NicolaiFransen/SemesterProjectPED2/Report/Pictures/SystemTest/Setup/TestSetup_v1.jpeg

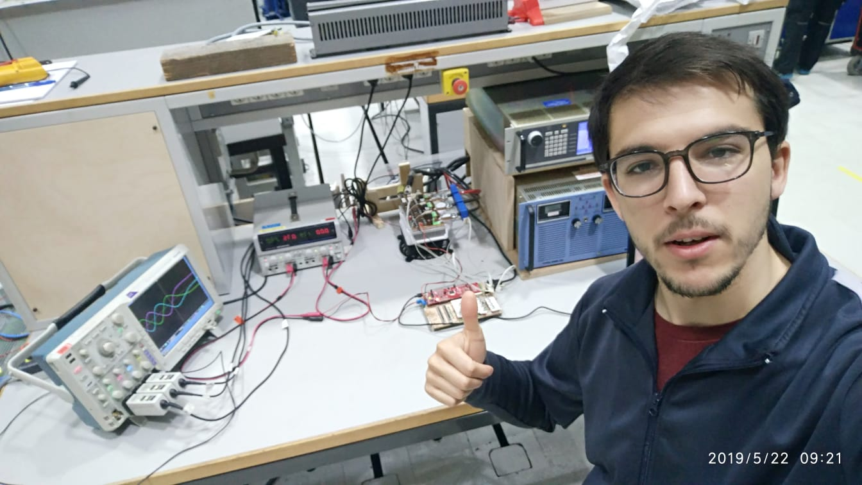
Report/Pictures/SystemTest/Setup/TestSetup_v1.jpeg
