NicolaiFransen/SemesterProjectPED2/Report/Pictures/Discussion/MOSFET damage/MOSFET_damage_currents_v2.png

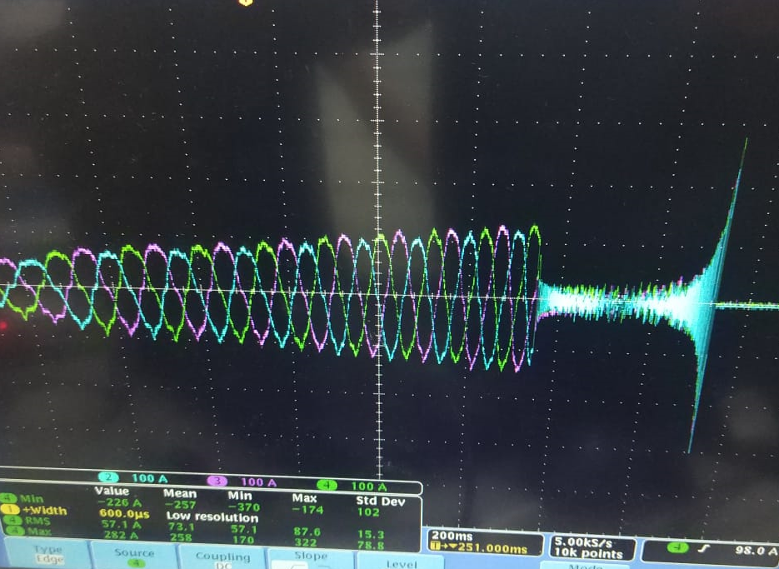
Report/Pictures/Discussion/MOSFET damage/MOSFET_damage_currents_v2.png
