NicolaiFransen/SemesterProjectPED2/Report/2019_02_09_TableOfContentsDraft.docx

Nomenclature

List of figures

List of tables

1. Introduction
2. Problem analysis
  2.1 Electric drive system (Add relevant parameters)
    2.1.1 Induction machine
    2.1.2 Inverter
    2.1.3 Batteries (Regenerative braking)
  2.2 Problem statement
  2.3 Objectives
  2.4 System requirements
3. Model of the induction machine
  3.1 Selection of reference frame
  3.2 Induction machine equations
    3.2.1 Motor equations
    3.2.2 Generator equations (for implementation of regenerative braking)
    3.2.3 Torque equation
  3.3 Validation of machine parameters
    3.3.1 Simulink model
    3.3.2 Simulation results
4. Control of the induction machine
  4.1 Control strategies
    4.1.1 Scalar control
    4.1.2 FOC
    4.1.3 …
  4.2 Selection of control strategy (advantages /disadvantages)
  4.3 Implementation of control strategy X (To include subsections later)
  4.4 Verification of controller
    4.4.1 Simulink model
    4.4.2 Simulation results
5. Software implementation (Need Nico feedback!!)
  5.1 Requirements
  5.2 DSP/microcontroller
  5.3 High level design
  5.4 Implementation
    5.4.1 Module 1
    5.4.2 Module 2
    5.4.3 …
  5.5 Validation
6. Test results
  6.1 Test results of existing inverter
    6.1.1 Test with signal generator
    6.1.2 Test with DSP
  6.2 Test results of the batteries’ capacity
  6.3 Test results of the complete system in test bench
  6.4 Integration test in go-kart platform (demo)
7. Regenerative mode (optional)
  7.1 Model of the batteries
  7.2 Current control?
  7.3 Simulation and experimental results
8. Discussion
  8.1 Verification of experimental results
  8.2 Problems and limitations
  8.3 Future work
9. Conclusion

Bibliography

Appendix
