NicolaiFransen/SemesterProjectPED2/Exam/Presentation/Questions_Faheem.pptx

## Parallel MOSFET

VB

1

VA

4

3

5

DC Link

VC

2

6

Drain

Rgate

Driver

Rgate

Source

Slide

of 59

P_(motor) =7300W
Using the motor power factor and efficiency we can calculate total apparent power
S_(motor) = (P_(mtor))/(PF_(motor) ∗ η_(motor))=10915 VA
For a balanced 3-phase system
S_(motor) = √3∗V_(line) ∗I_(line)
For a star connected load
S_(motor) = √3∗V_(line) ∗I_(phase)

Faheem

## Parallel MOSFET

By comparing multiple available MOSFETs from different manufactures of rating 60V and 80V for 300A.

Based on the obtained SPICE model simulation IPT007N06N and IPT012N08N5 are the most suitable MOSFETS. But, due to IPT012N08N5 higher drain-source voltage of 80V, it can ensure a better safety margin that occurs in turn off transition of the MOSFETs.

Slide

of 59

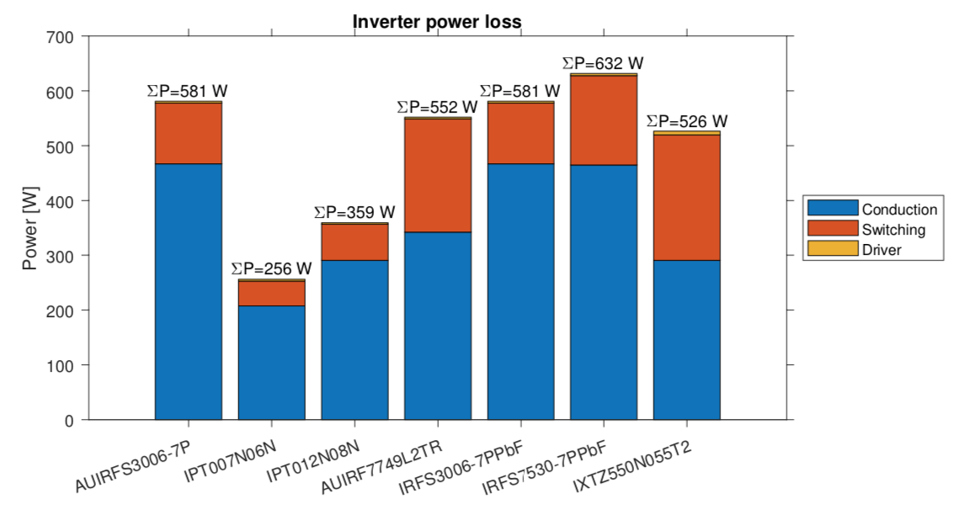
[picture p3: figure]

Faheem

## MOSFET loss calculation

Operating Condition
| Values | Unit
DC link voltage (VDC) | 36 | V
Power Rating | 7.3 | kW
RMS current (IRMS) | 263 | A
Peak current (Ipk) | 371 | A
Switching Frequency (fsw) | 20 | kHz

MOSFET Parameter (IPT012N08N5)
| Values | Unit
DS voltage (VDS) | 80 | V
RDS(on),max | 1.2 | mΩ
Drain current (ID) | 300 | A
Output Capacitance (Qoss) | 208 | nC
Gate Capacitance (QG) | 178 | nC

Slide

of 59

MOSFET loss can be modelled in parts
P_(MOSFET) =P_(con) +P_(sw) +P_(gate) =30.3W
Conduction losses
P_(con) =((I_(rms))/(n_(parallel)))^2 RDS_(on) =24.2W
Switching losses
E_(on) =(V_(DC) ∗(I_(pk))/(n_(parallel))∗t_(on) +Q_(rr) ∗V_(DC) )+(1/4Q_(rr) ∗V_(DC) )
E_(off) =V_(DC) ∗(I_(pk))/(n_(parallel))∗t_(off)
P_(sw) = (E_(on) +E_(off) )∗f_(sw) =5.9W
Gate loss
P_(Qg) = Q_g ∗(V_(dr.on) −V_(dr.off) )
P_(Rg) = P_(Qg)

Faheem
