NicolaiFransen/SemesterProjectPED2/Report/Pictures/LoadMachineGraph.pdf

0 | 50 | 100 | 150 | 200 | 250 | 300 | 350 | 400
Speed (RPM)

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
Torque (Nm)

Vexc

= 50 V

Vexc

= 100 V

Vexc

= 150 V
