NicolaiFransen/SemesterProjectPED2/Software/Design/ClassDiagram.pdf

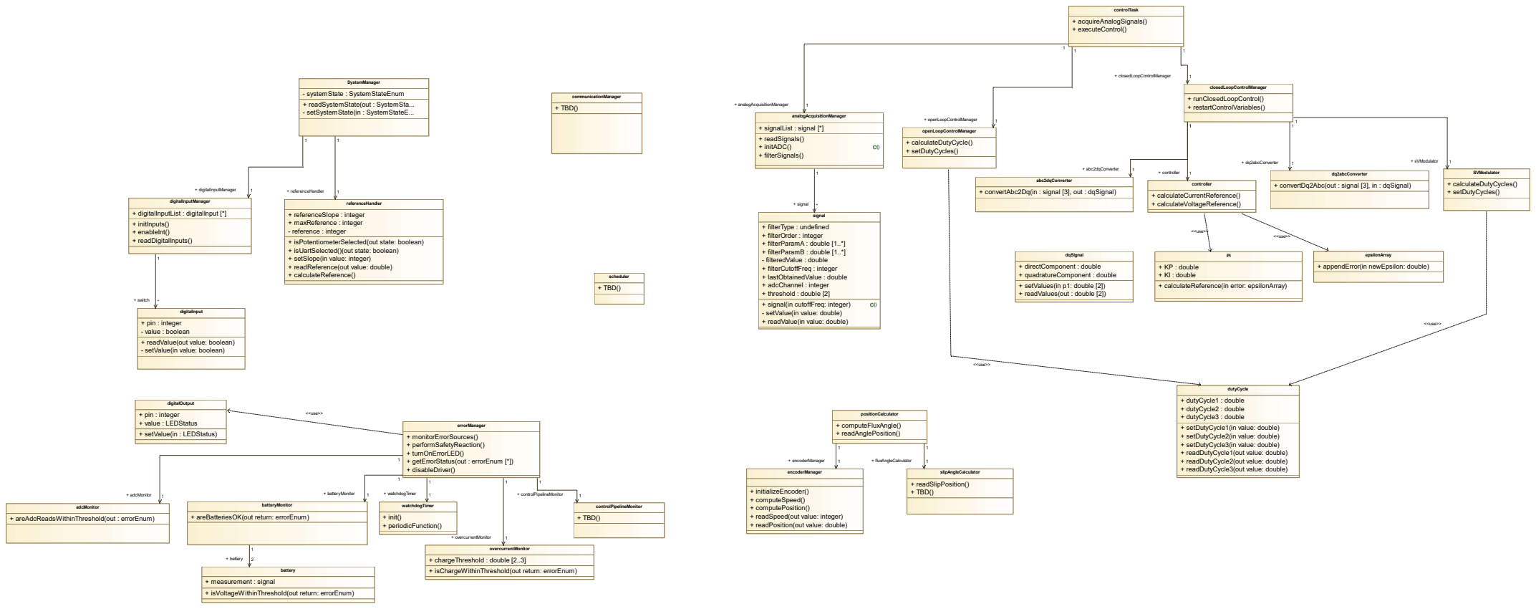
[picture p101: figure]
signal + filterType : undefined + filterOrder : integer + filterParamA : double [1..*] + filterParamB : double [1..*] - filteredValue : double + filterCutoffFreq : integer + lastObtainedValue : double + adcChannel : integer + threshold : double [2] + signal( in cutoffFreq: integer) - setValue( in value: double) + readValue( in value: double); analogAcquisitionManager + signalList : signal [*] + readSignals() + initADC() + filterSignals(); digitalInputManager + digitalInputList : digitalInput [*] + initInputs() + enableInt() + readDigitalInputs()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

+ convertAbc2Dq( in : signal [3], out : dqSignal)

+ convertDq2Abc( out : signal [3], in : dqSignal)
