NicolaiFransen/SemesterProjectPED2/Simulations/2018_Semester Project/Appendix/Thermal_design/Fets.xlsx

Note: |  | Mosfet name: | AUIRFS3006-7P | IPT007N06N | IPT012N08N | AUIRF7749L2TR | IRFS3006-7PPbF | IRFS7530-7PPbF | IXTZ550N055T2
Correct by graph and use max | mOhm | R_DS_ON (100°C) | 2.25 | 1 | 1.4 | 1.65 | 2.25 | 2.24 | 1.4
 | ns | tr | 61 | 18 | 31 | 149 | 61 | 102 | 40
 | ns | tf | 69 | 22 | 30 | 88 | 69 | 79 | 230
 | ns | trr | 48 | 174 | 212 | 42 | 48 | 50 | 100
 | nC | Qg | 300 | 287 | 223 | 275 | 300 | 354 | 595
 | nC | Qrr | 62 | 144 | 636 | 54 | 62 | 83 | 250
 | °C/W | R_thJC | 0.4 | 0.4 | 0.4 | 0.44 | 0.4 | 0.4 | 0.25
 | V | V_plateau | 3.8 | 4.2 | 4.5 | 5 | 3.8 | 5 | 4.5
 | Ohm | R_G | 2.1 | 2.7 | 2.4 | 1.5 | 2.1 | 2.2 | 1.36
 | pF | Crss_RI | 3000 | 4000 | 3000 | 3000 | 3000 | 3000 | 2200
 | pF | Crss_VDC | 700 | 220 | 90 | 600 | 700 | 600 | 1000
 |  | Price | 19.06 | 37.81 | 47.57 | 46.6 | 31.95 | 28.36 | 163.47
 |  | Supplier | Farnell | Farnell | Farnell | Farnell | Mouser | Farnell | Mouser
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
