NicolaiFransen/SemesterProjectPED2/Others/2019_02_08_Picure_aitor_kart.docx

# Electric Go-kart

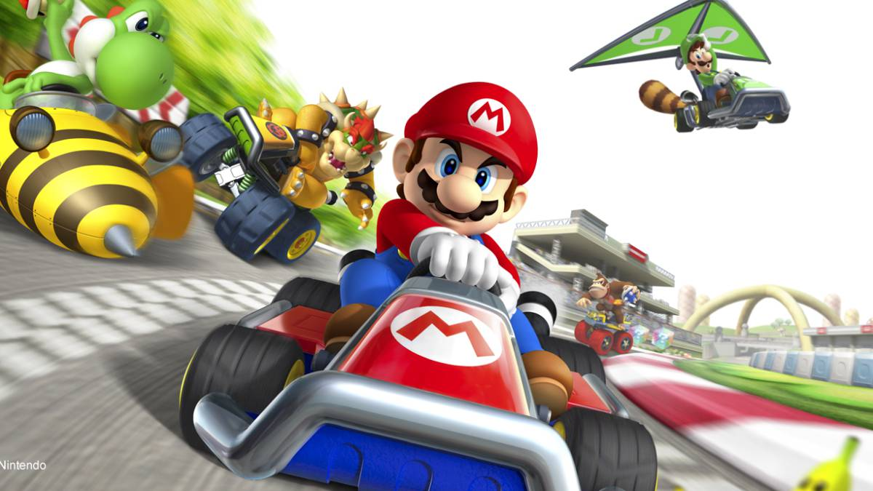
[picture p105: figure]
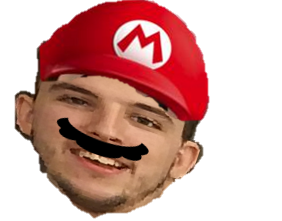
[picture p106: figure]

PED-841

Mihai Rusu

mrusu18@student.aau.dk

Estefanía Ruiz

eruiza18@student.aau.dk

Faheem Ahmad

fahmad18@student.aau.dk

Nicolai Haugaard Fransen

nfrans18@student.aau.dk

Aitor Teran

ateran18@student.aau.dk

Nicolás Murguizur

nmurgu18@student.aau.dk
