NicolaiFransen/SemesterProjectPED2/Software/Design/ADC_overview.pdf

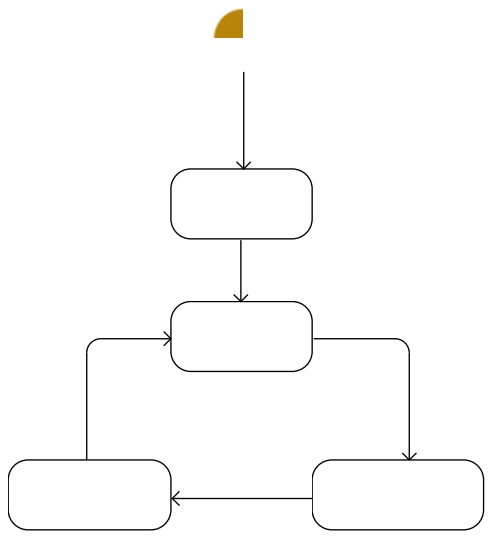
[picture p107: figure]
