NicolaiFransen/SemesterProjectPED2/DeliveryFolder/Simulink/Batteries/good figures/charge_b.jpg

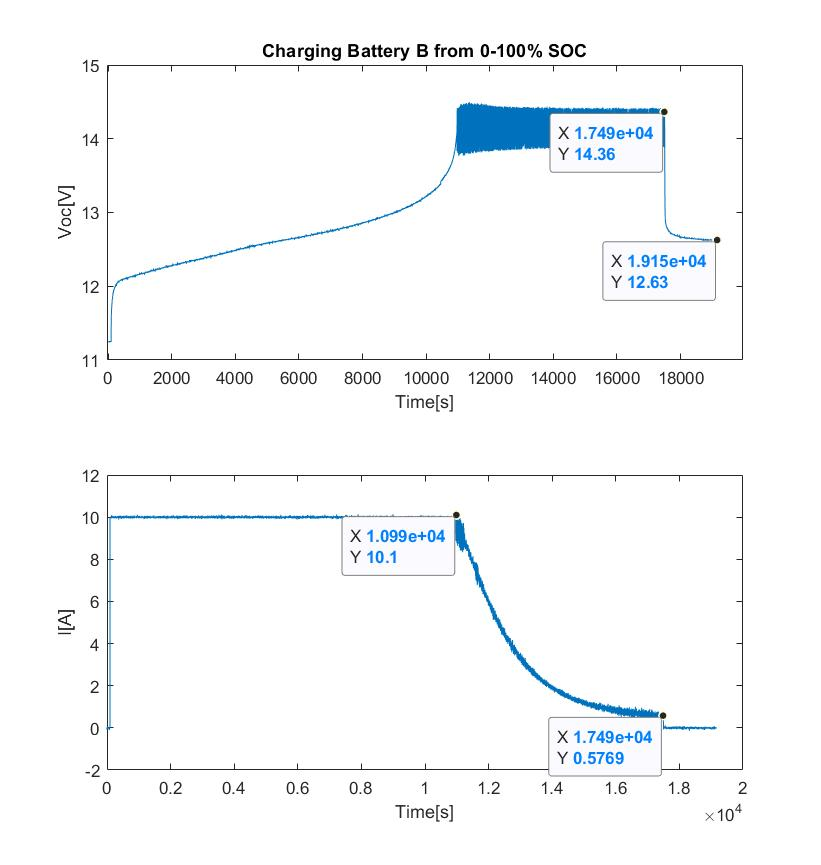
DeliveryFolder/Simulink/Batteries/good figures/charge_b.jpg
