NicolaiFransen/SemesterProjectPED2/DeliveryFolder/Simulink/Batteries/good figures/pulse_d_50.jpg

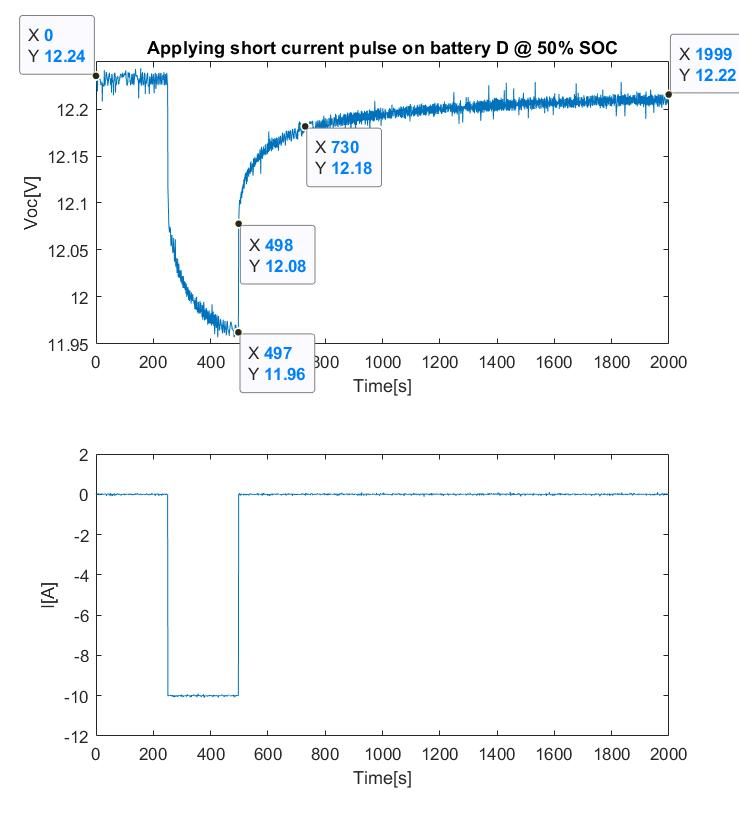
DeliveryFolder/Simulink/Batteries/good figures/pulse_d_50.jpg
