NicolaiFransen/SemesterProjectPED2/DeliveryFolder/Simulink/Batteries/good figures/voc_soc2.jpg

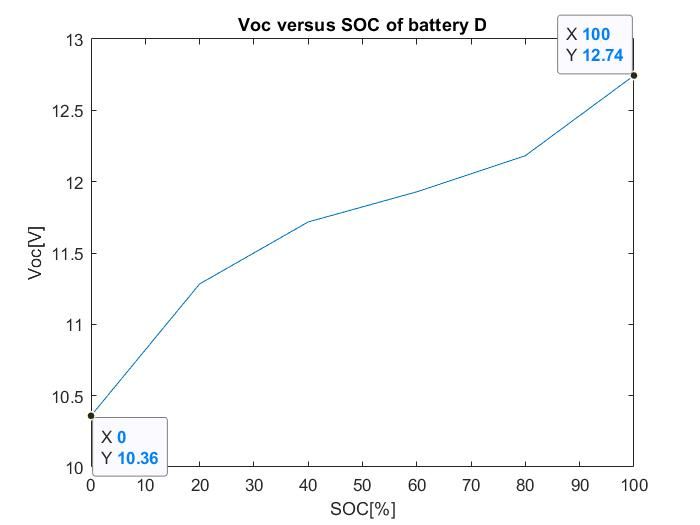
DeliveryFolder/Simulink/Batteries/good figures/voc_soc2.jpg
