NicolaiFransen/SemesterProjectPED2/Documents/Datasheets/Nameplates/Load nameplate1.jpg

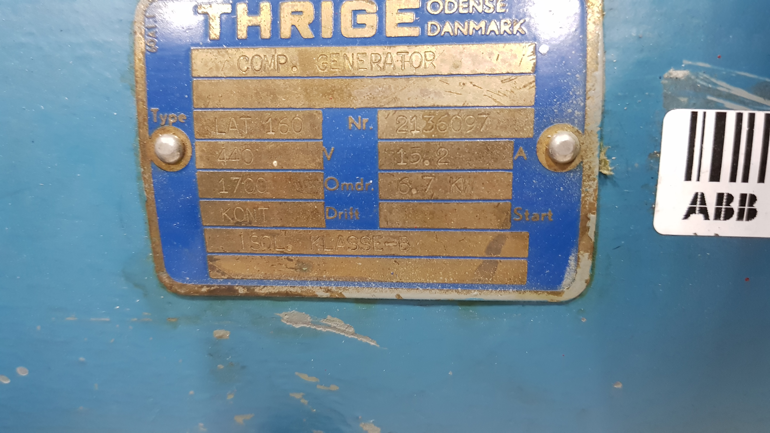
Documents/Datasheets/Nameplates/Load nameplate1.jpg
