NicolaiFransen/SemesterProjectPED2/Exam/Presentation/Pictures/2019-05-24 08.07.56.jpg

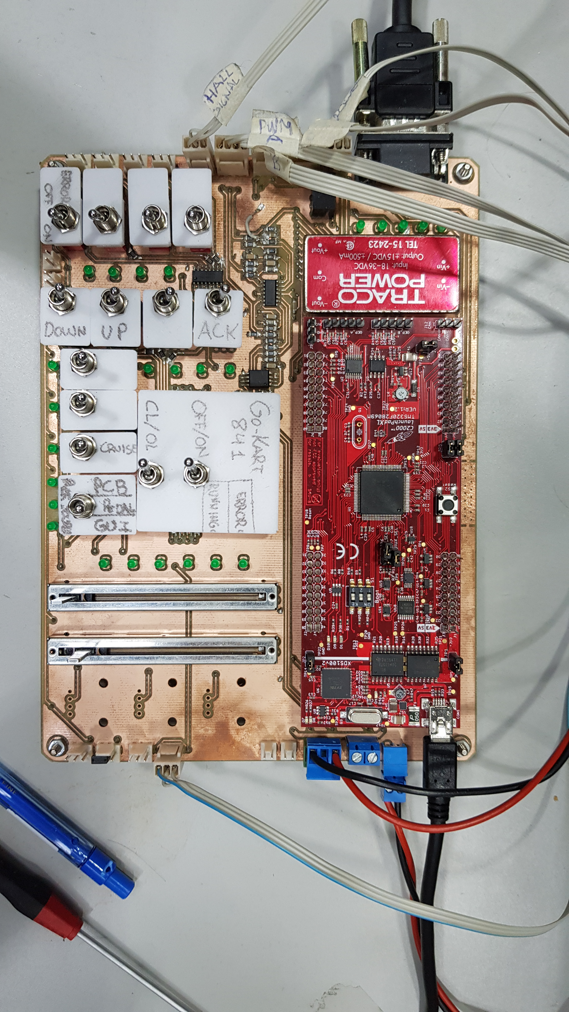
Exam/Presentation/Pictures/2019-05-24 08.07.56.jpg
