NicolaiFransen/SemesterProjectPED2/Exam/Presentation/Pictures/2019-05-24 08.09.47.jpg

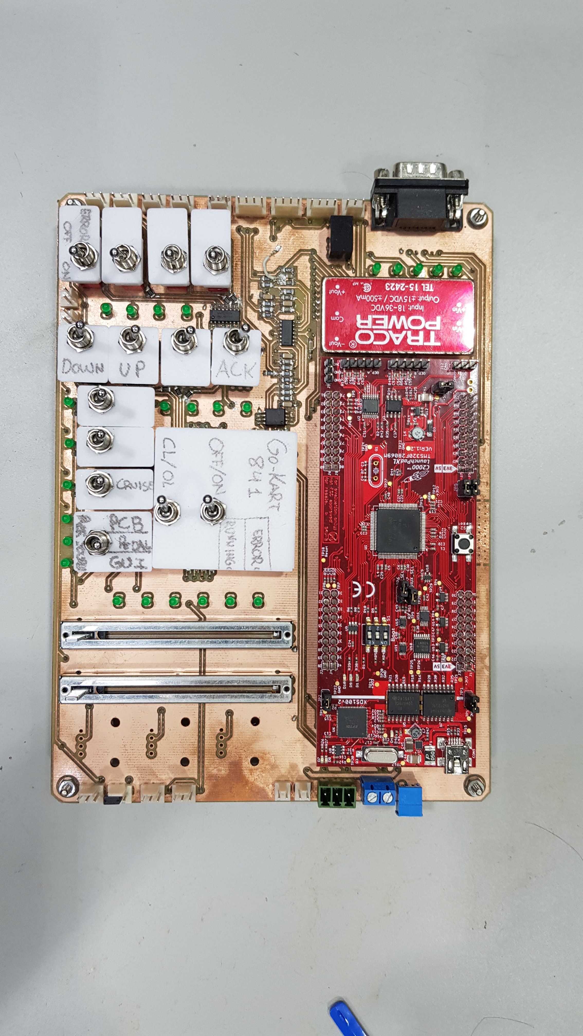
Exam/Presentation/Pictures/2019-05-24 08.09.47.jpg
