NicolaiFransen/SemesterProjectPED2/Exam/Presentation/Pictures/NameTag.jpg

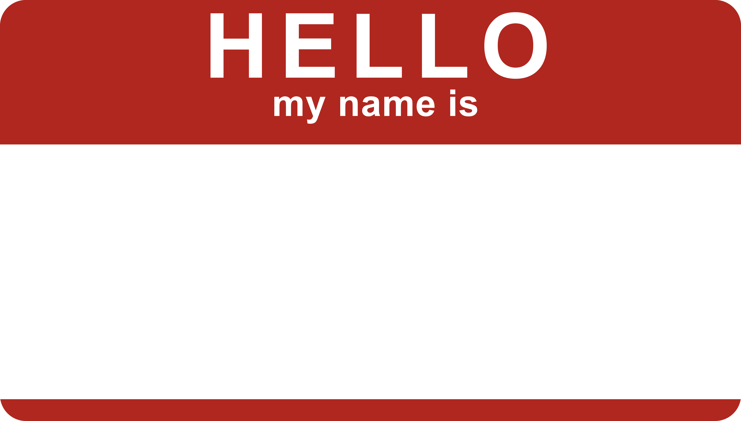
Exam/Presentation/Pictures/NameTag.jpg
