NicolaiFransen/SemesterProjectPED2/Exam/Presentation/Pictures/PowMOS_thrml.png

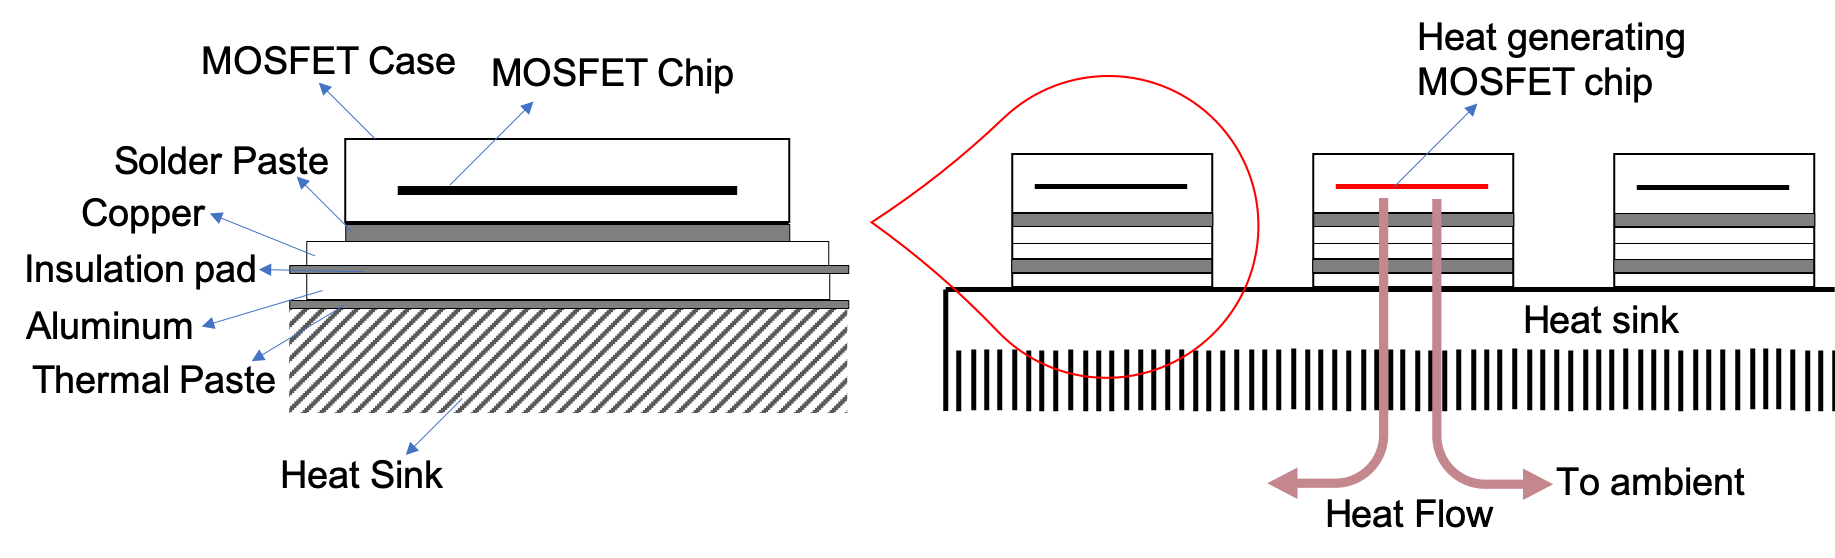
Exam/Presentation/Pictures/PowMOS_thrml.png
