NicolaiFransen/SemesterProjectPED2/Exam/Presentation/Pictures/SpeedLoadChangeTorqueSpeed.PNG

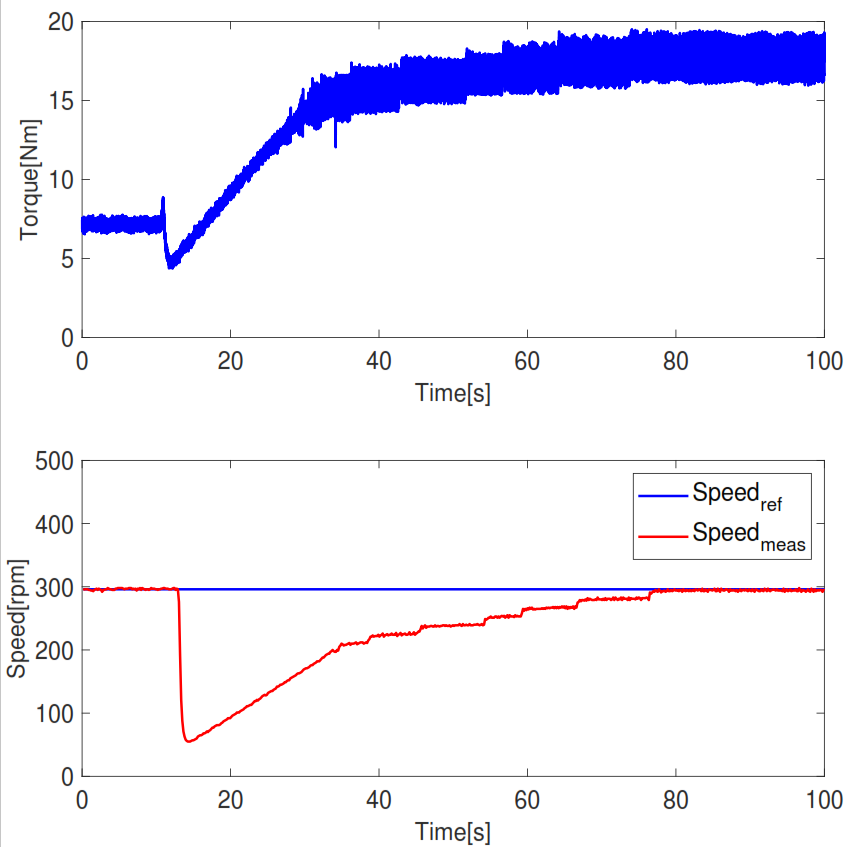
Exam/Presentation/Pictures/SpeedLoadChangeTorqueSpeed.PNG
