NicolaiFransen/SemesterProjectPED2/Exam/Presentation/Pictures/ThermalLossesCircuit.png

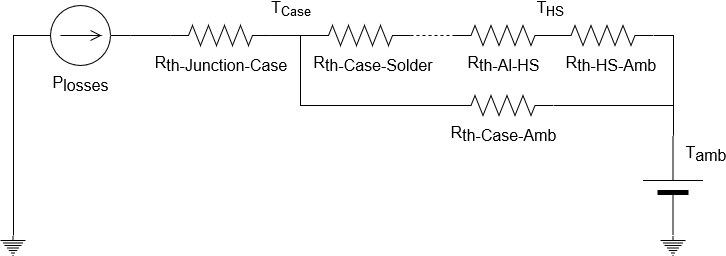
Exam/Presentation/Pictures/ThermalLossesCircuit.png
