NicolaiFransen/SemesterProjectPED2/Exam/Presentation/Pictures/TorqueLoadChangeIabc.PNG

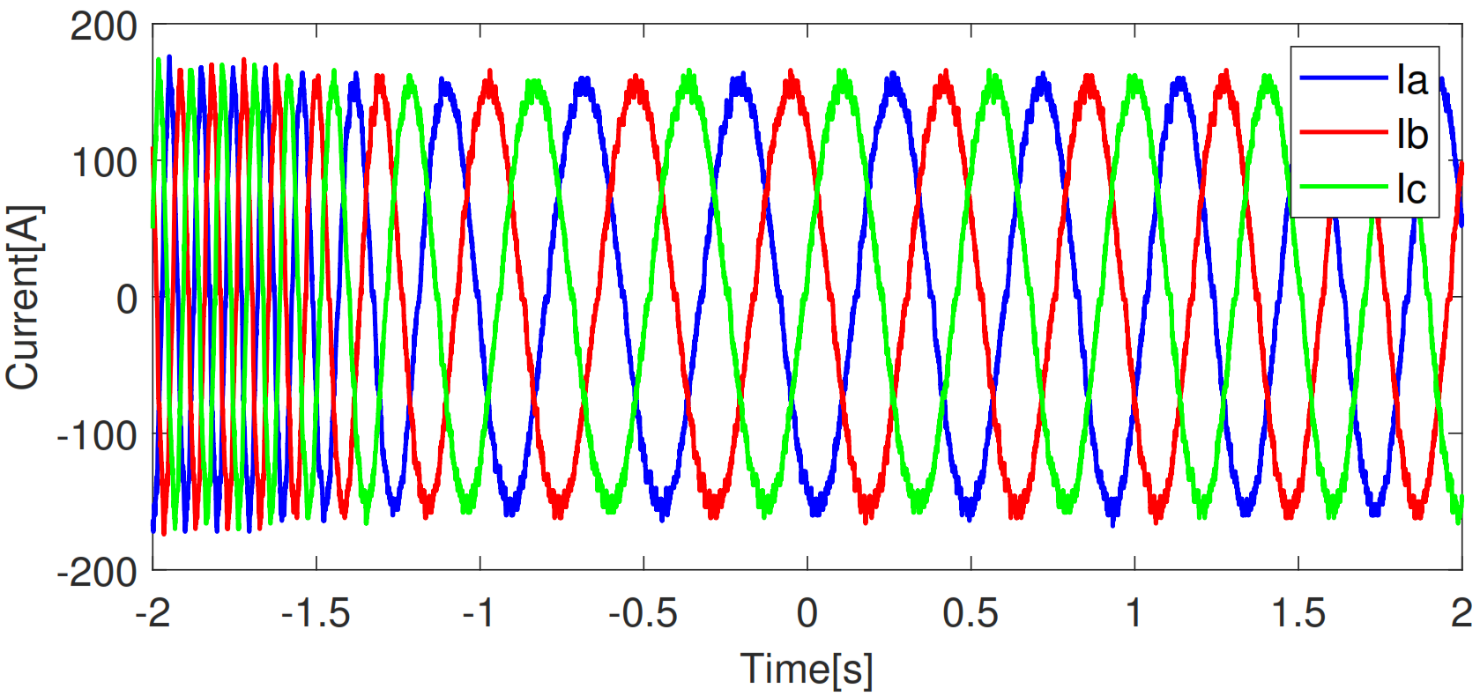
Exam/Presentation/Pictures/TorqueLoadChangeIabc.PNG
