NicolaiFransen/SemesterProjectPED2/Exam/Presentation/Pictures/TorqueStartupIabc.PNG

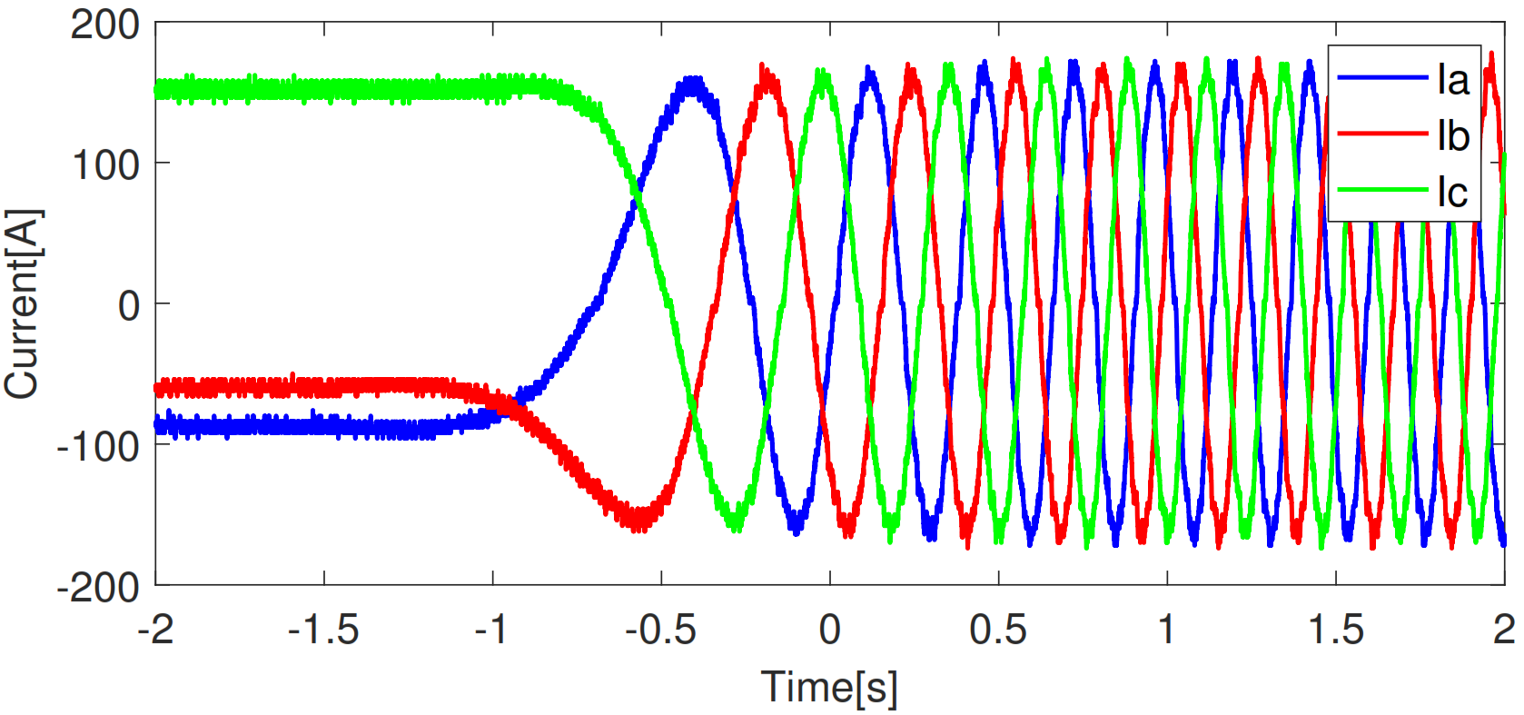
Exam/Presentation/Pictures/TorqueStartupIabc.PNG
