NicolaiFransen/SemesterProjectPED2/Exam/Presentation/Pictures/TorqueStartupIdIq.PNG

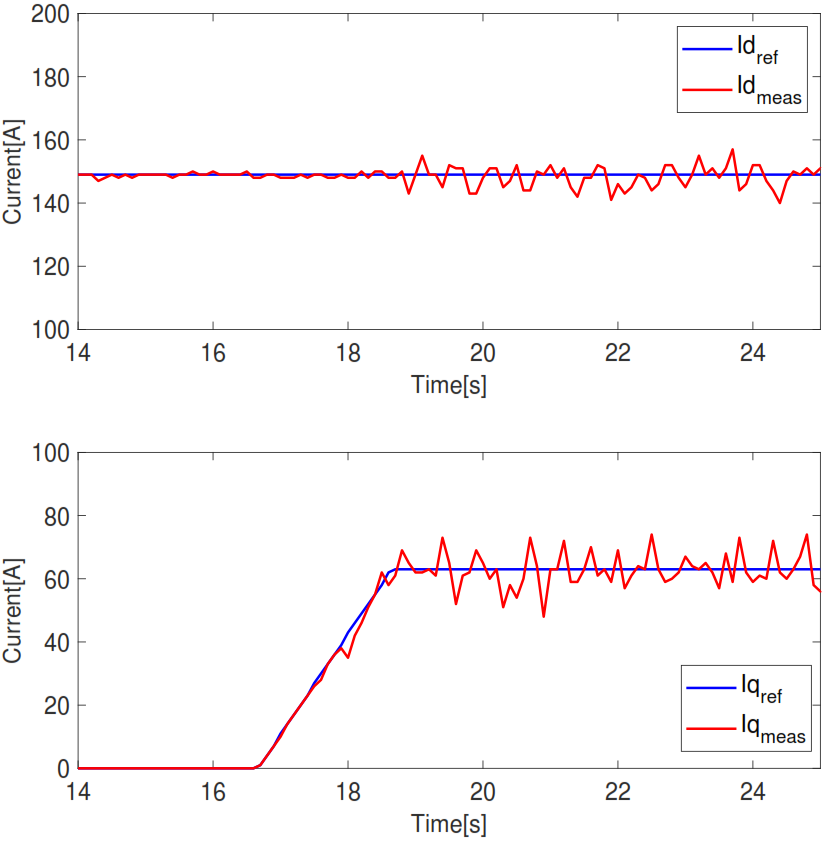
Exam/Presentation/Pictures/TorqueStartupIdIq.PNG
