NicolaiFransen/SemesterProjectPED2/Exam/Presentation/Pictures/TorqueStartupSimulationIabc.PNG

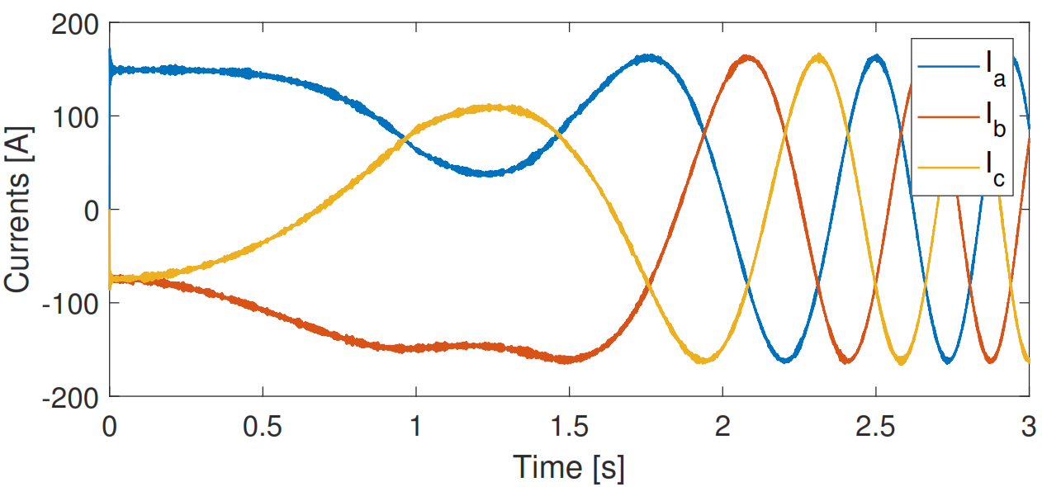
Exam/Presentation/Pictures/TorqueStartupSimulationIabc.PNG
