NicolaiFransen/SemesterProjectPED2/Exam/Presentation/Pictures/TorqueToCruiseIabc.PNG

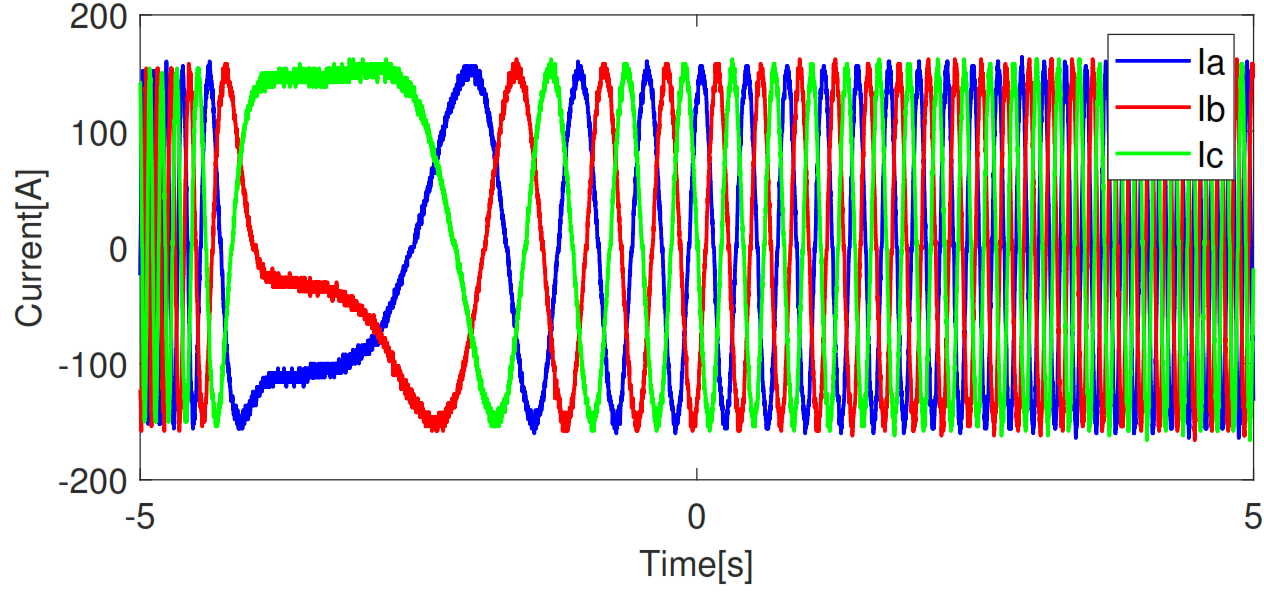
Exam/Presentation/Pictures/TorqueToCruiseIabc.PNG
