NicolaiFransen/SemesterProjectPED2/Exam/Presentation/Pictures/TorqueToCruiseSimulationPNG.PNG

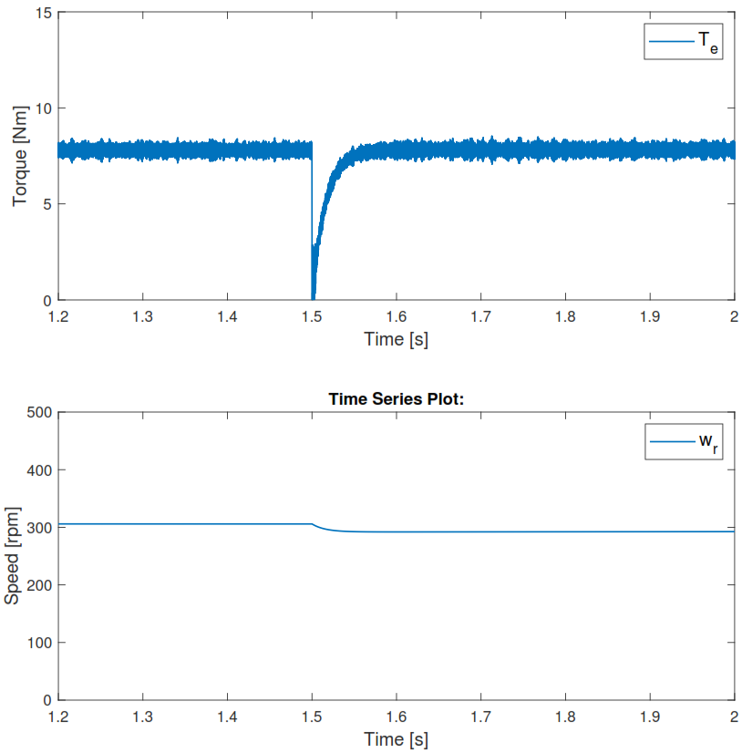
Exam/Presentation/Pictures/TorqueToCruiseSimulationPNG.PNG
