NicolaiFransen/SemesterProjectPED2/Interface board/2019_02_17 Blok diagram.jpg

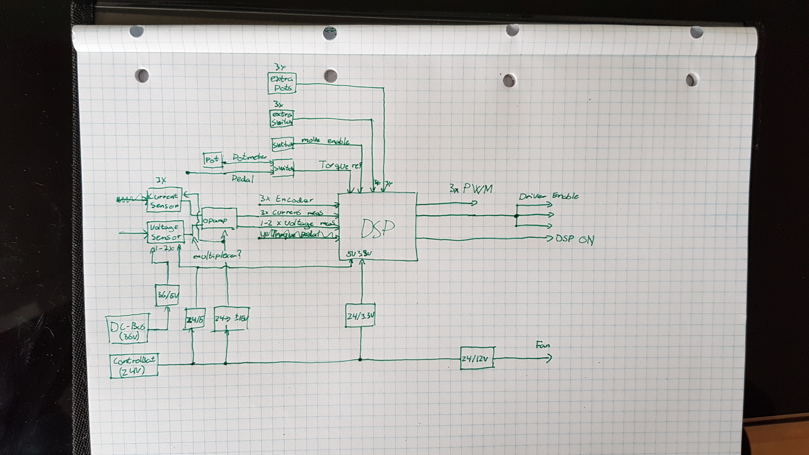
Interface board/2019_02_17 Blok diagram.jpg
