NicolaiFransen/SemesterProjectPED2/Lectures/Optimisation/Optimi exams Martin/Exam 2017/34319168_10155453299611651_4545932126414962688_n.jpg

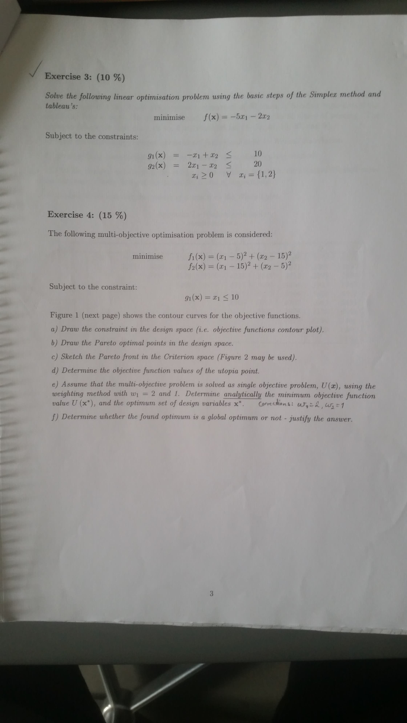
Lectures/Optimisation/Optimi exams Martin/Exam 2017/34319168_10155453299611651_4545932126414962688_n.jpg
