NicolaiFransen/SemesterProjectPED2/Lectures/Optimisation/Optimi exams Martin/Exam 2017/34472471_10155453298431651_939413526361931776_n.jpg

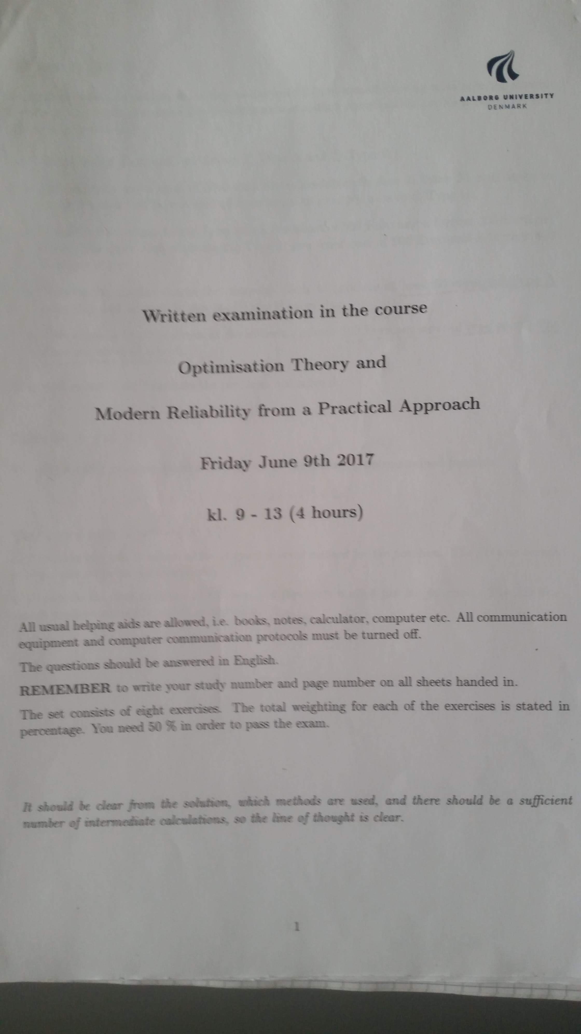
Lectures/Optimisation/Optimi exams Martin/Exam 2017/34472471_10155453298431651_939413526361931776_n.jpg
