NicolaiFransen/SemesterProjectPED2/Lectures/Optimisation/Optimi exams Martin/Lecture pictures/Pictures5/2019-03-11 14.44.27.jpg

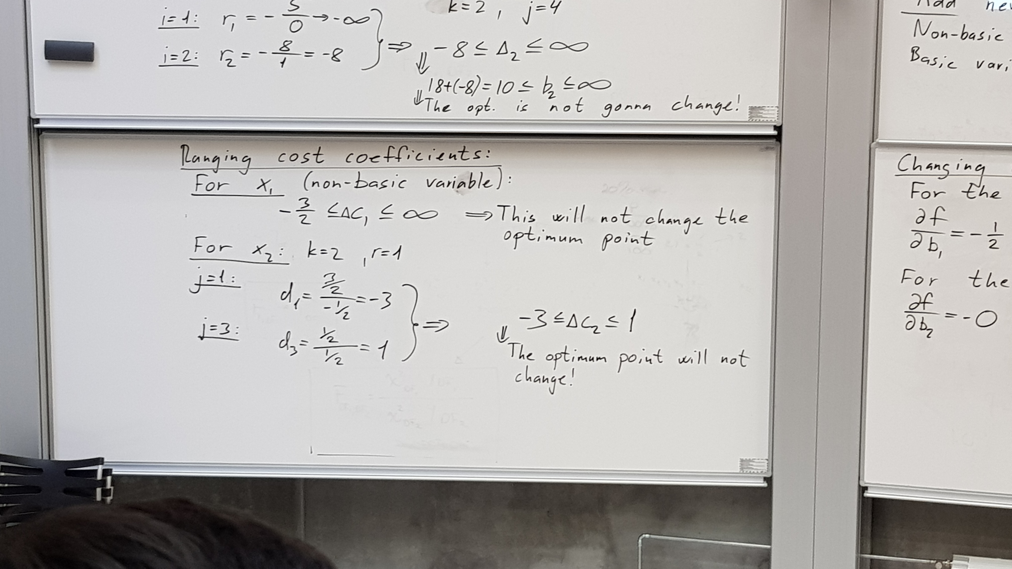
Lectures/Optimisation/Optimi exams Martin/Lecture pictures/Pictures5/2019-03-11 14.44.27.jpg
