NicolaiFransen/SemesterProjectPED2/Lectures/Optimisation/Optimi exams Martin/Lecture pictures/Pictures6/2019-03-18 12.59.12.jpg

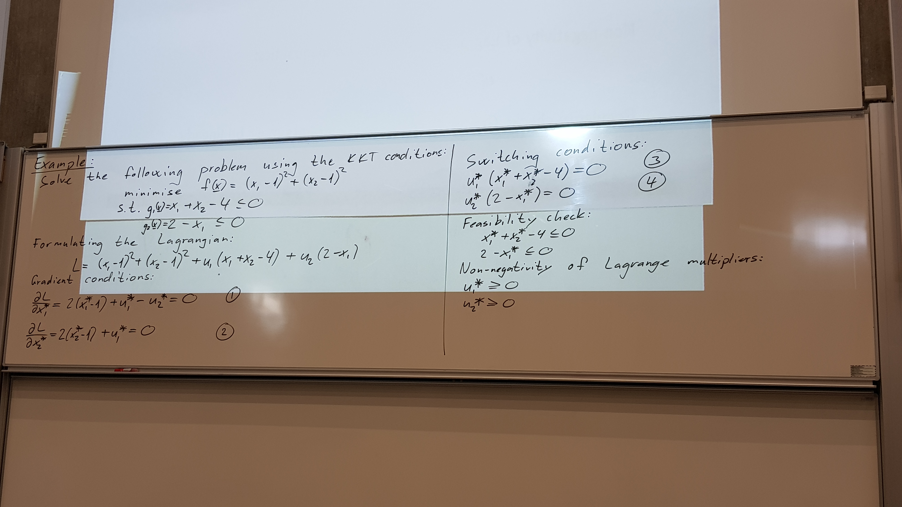
Lectures/Optimisation/Optimi exams Martin/Lecture pictures/Pictures6/2019-03-18 12.59.12.jpg
