NicolaiFransen/SemesterProjectPED2/Lectures/Optimisation/Optimi exams Martin/Lecture pictures/Pictures6/2019-03-18 14.41.18.jpg

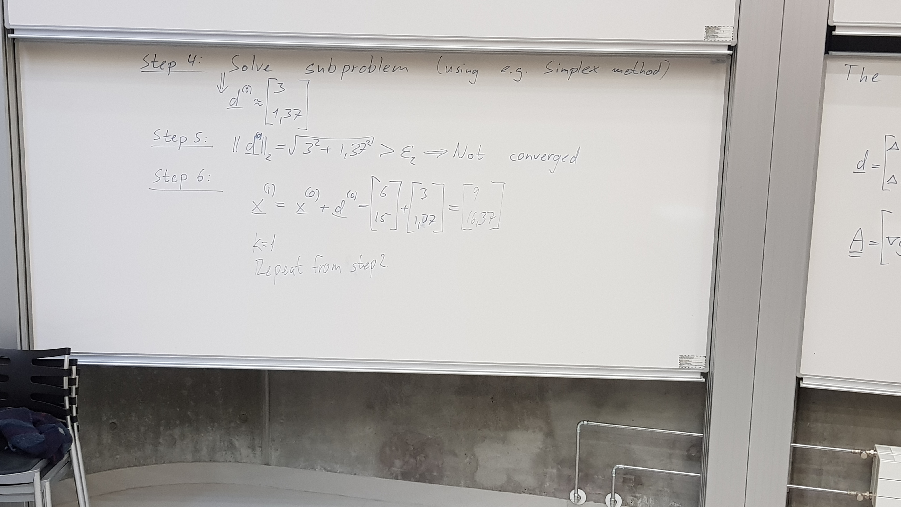
Lectures/Optimisation/Optimi exams Martin/Lecture pictures/Pictures6/2019-03-18 14.41.18.jpg
