NicolaiFransen/SemesterProjectPED2/Lectures/Optimisation/Optimi exams Martin/Lecture pictures/Pictures7/2019-03-25 13.23.08.jpg

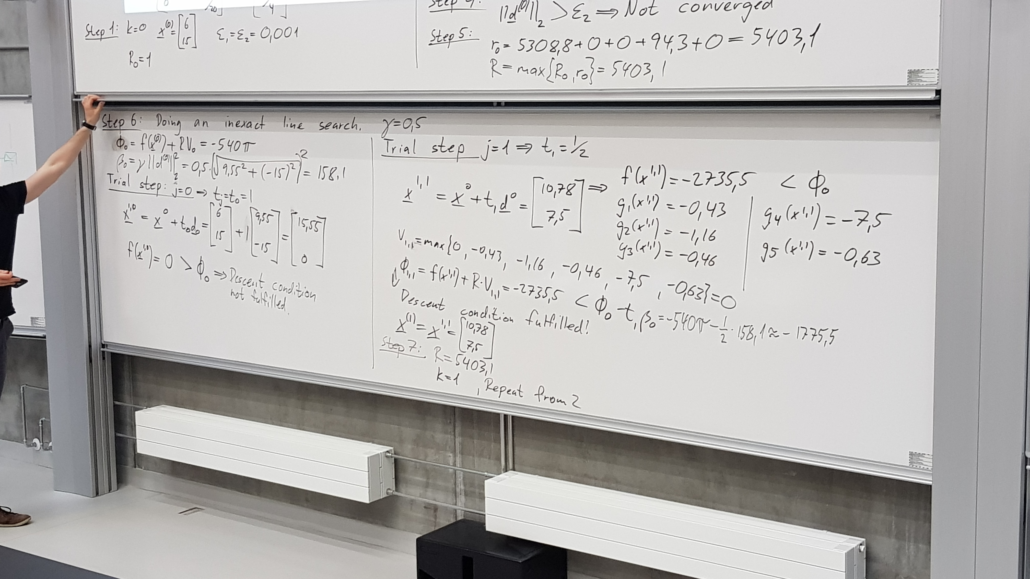
Lectures/Optimisation/Optimi exams Martin/Lecture pictures/Pictures7/2019-03-25 13.23.08.jpg
