NicolaiFransen/SemesterProjectPED2/Lectures/Optimisation/Optimization exams/Exams Marianne/61338909_369452797015577_9039132972241911808_n.jpg

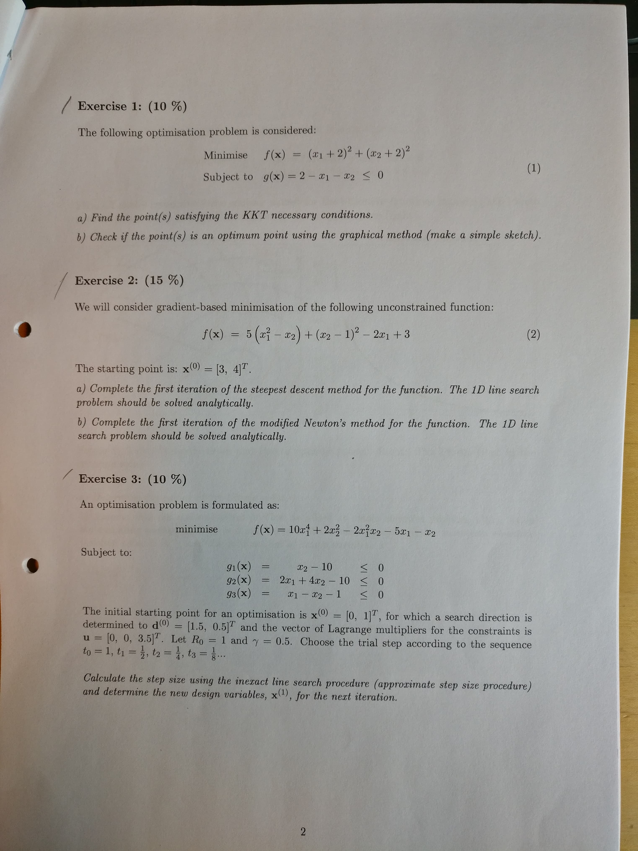
Lectures/Optimisation/Optimization exams/Exams Marianne/61338909_369452797015577_9039132972241911808_n.jpg
