NicolaiFransen/SemesterProjectPED2/Lectures/Optimisation/Optimization exams/Exams Marianne/61511914_449199935837853_9220734673531961344_n.jpg

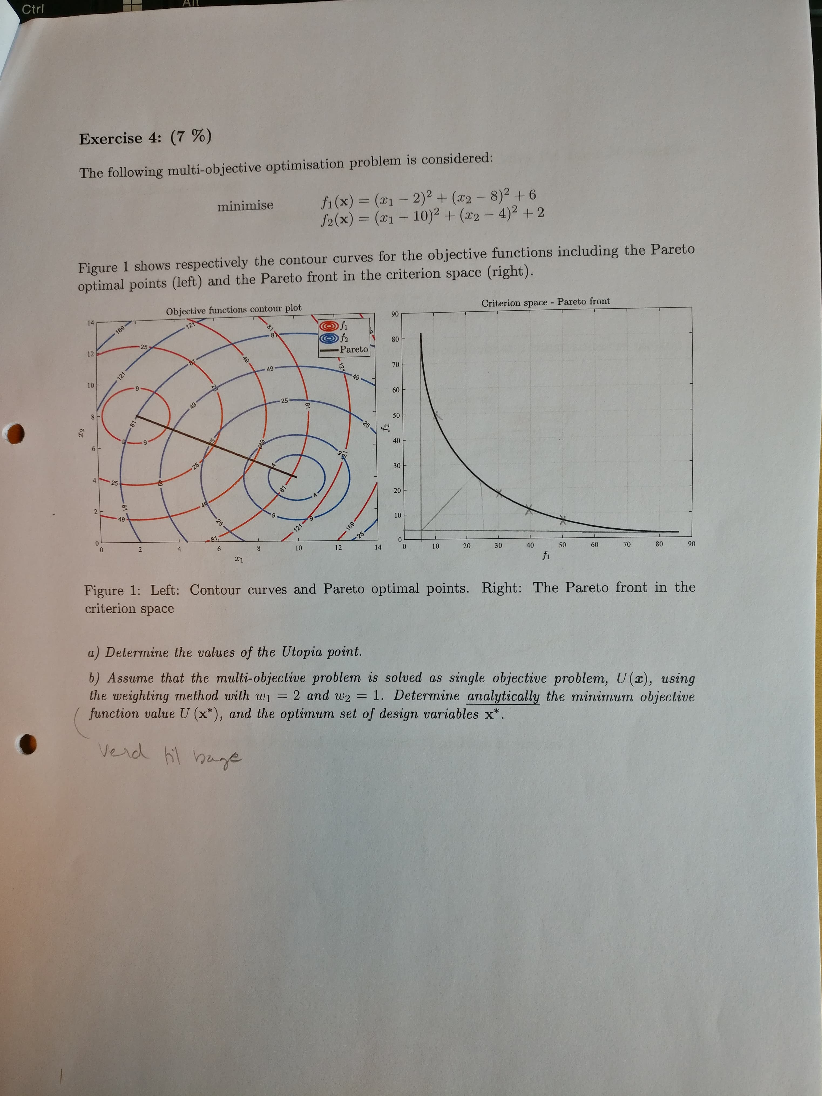
Lectures/Optimisation/Optimization exams/Exams Marianne/61511914_449199935837853_9220734673531961344_n.jpg
