NicolaiFransen/SemesterProjectPED2/Report/Pictures/CompoundMachineDiag.png

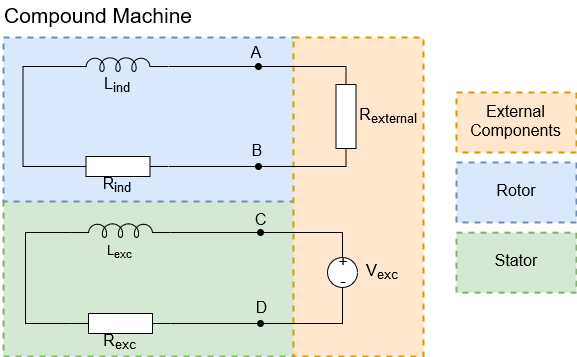
Report/Pictures/CompoundMachineDiag.png
