NicolaiFransen/SemesterProjectPED2/Report/Pictures/Discussion/DriverSpike1.png

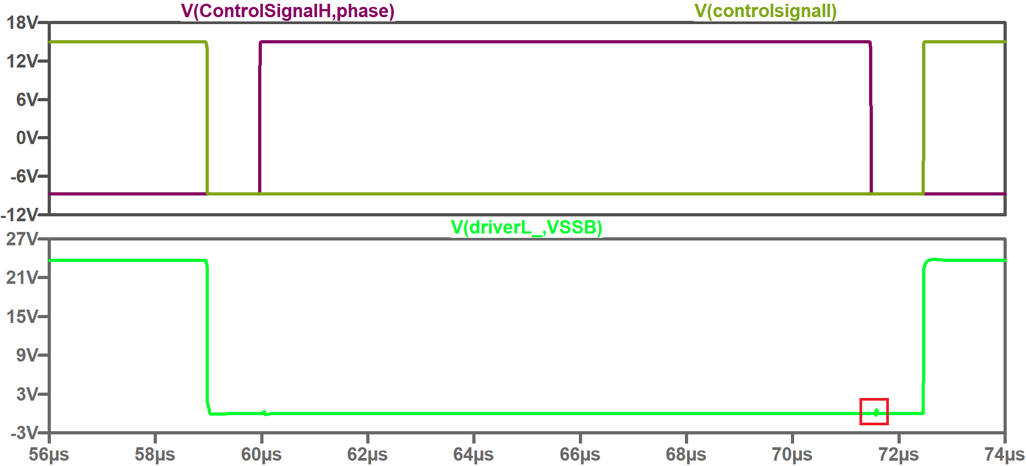
Report/Pictures/Discussion/DriverSpike1.png
