NicolaiFransen/SemesterProjectPED2/Report/Pictures/Discussion/DriverSpike2.png

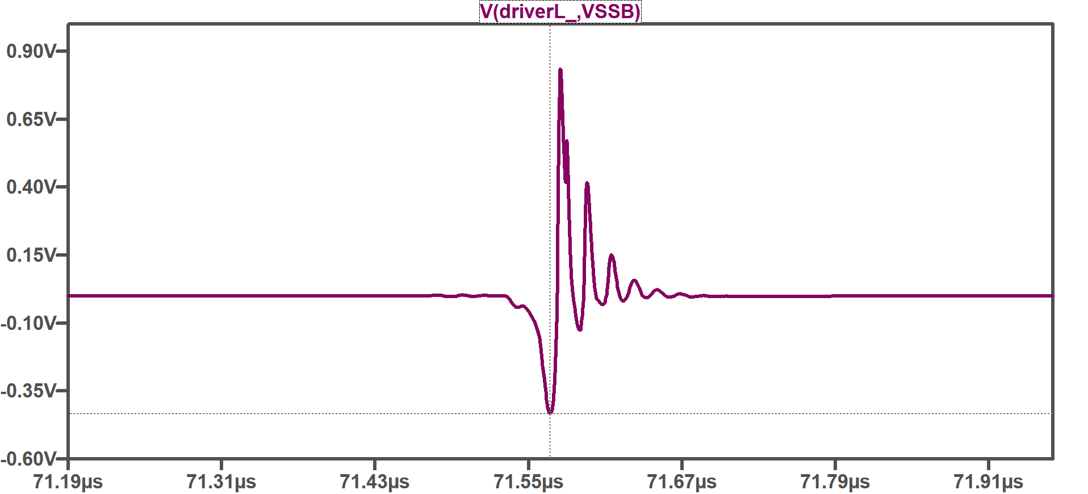
Report/Pictures/Discussion/DriverSpike2.png
