NicolaiFransen/SemesterProjectPED2/Report/Pictures/Discussion/DriverSpike3.png

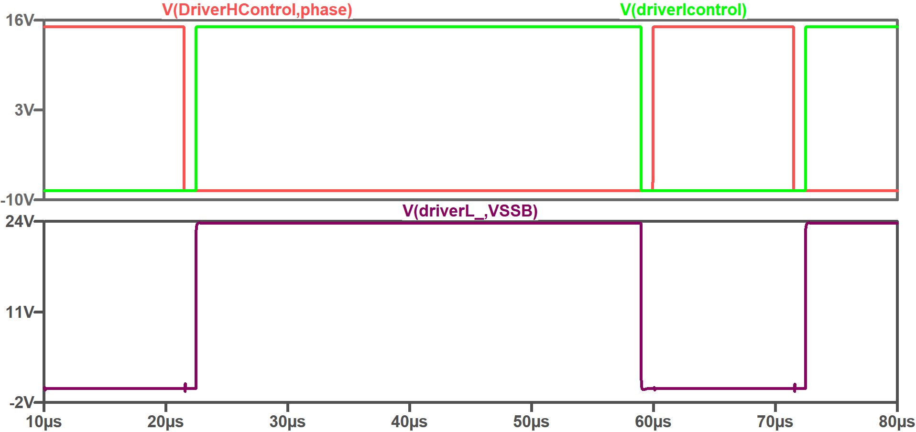
Report/Pictures/Discussion/DriverSpike3.png
