NicolaiFransen/SemesterProjectPED2/Report/Pictures/Discussion/MOSFET damage/MOSFET_damage_current.jpeg

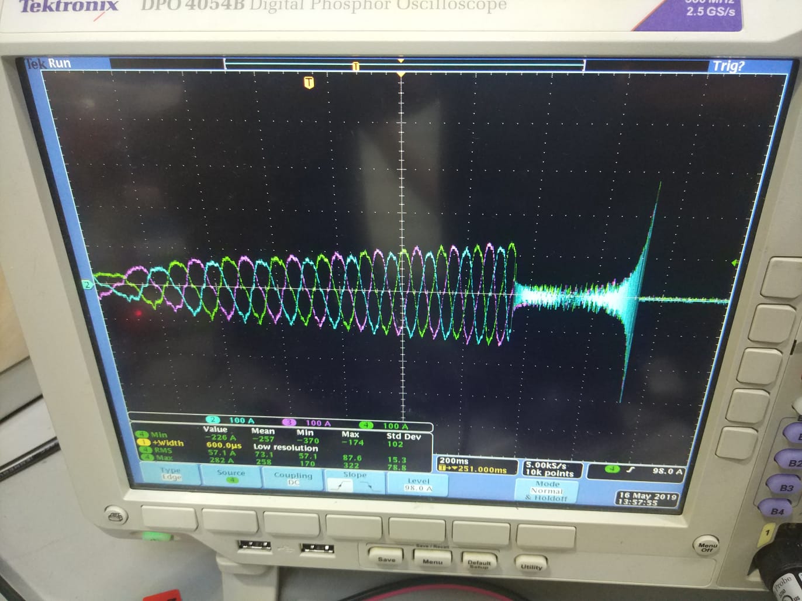
Report/Pictures/Discussion/MOSFET damage/MOSFET_damage_current.jpeg
