NicolaiFransen/SemesterProjectPED2/Report/Pictures/go_kart_forces.PNG

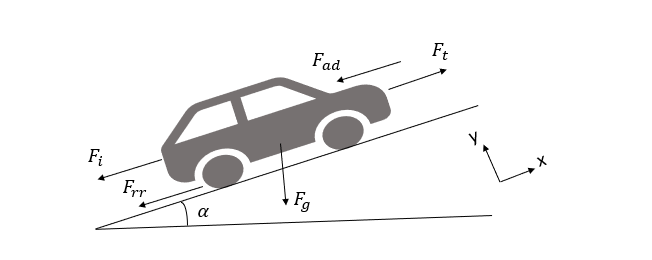
Report/Pictures/go_kart_forces.PNG
