NicolaiFransen/SemesterProjectPED2/Report/Pictures/Induction machine overleaf/abc2ab.PNG

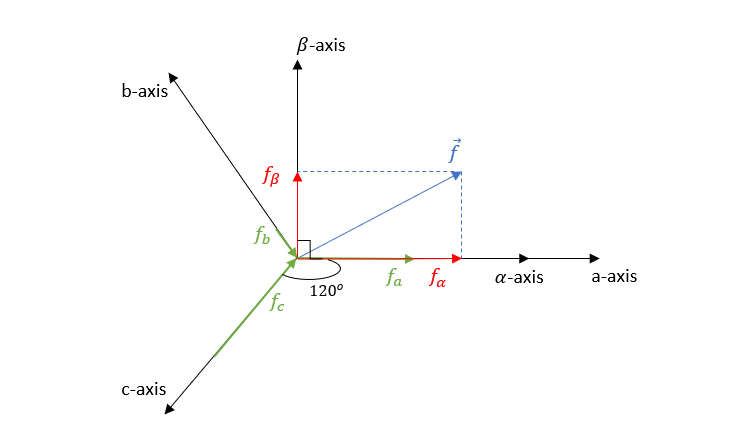
Report/Pictures/Induction machine overleaf/abc2ab.PNG
