NicolaiFransen/SemesterProjectPED2/Report/Pictures/Induction machine overleaf/cage_rotor.PNG

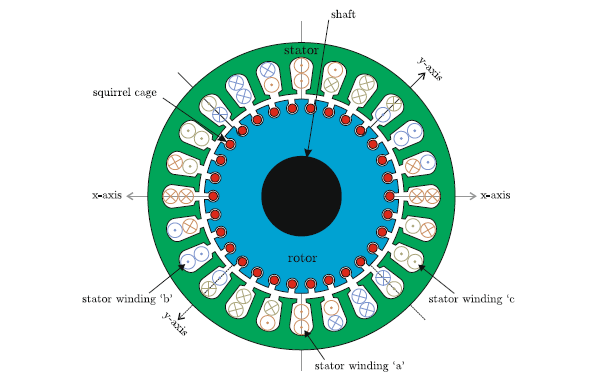
Report/Pictures/Induction machine overleaf/cage_rotor.PNG
