NicolaiFransen/SemesterProjectPED2/Report/Pictures/Induction machine overleaf/currents_IM.png

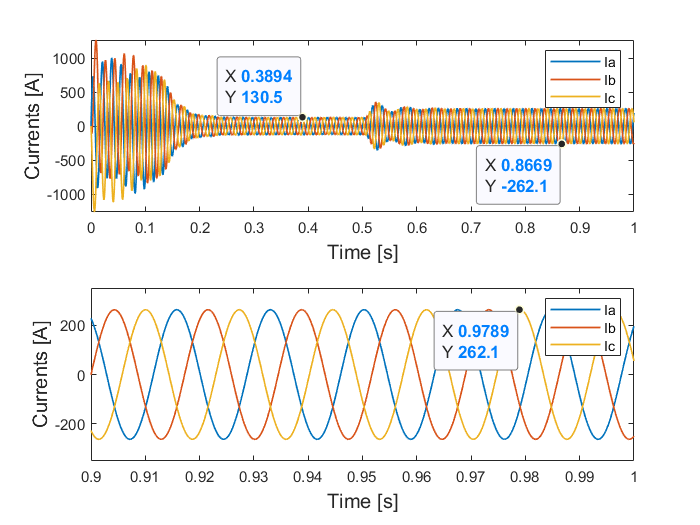
Report/Pictures/Induction machine overleaf/currents_IM.png
