NicolaiFransen/SemesterProjectPED2/Report/Pictures/Induction machine overleaf/electromagnetic_torque.PNG

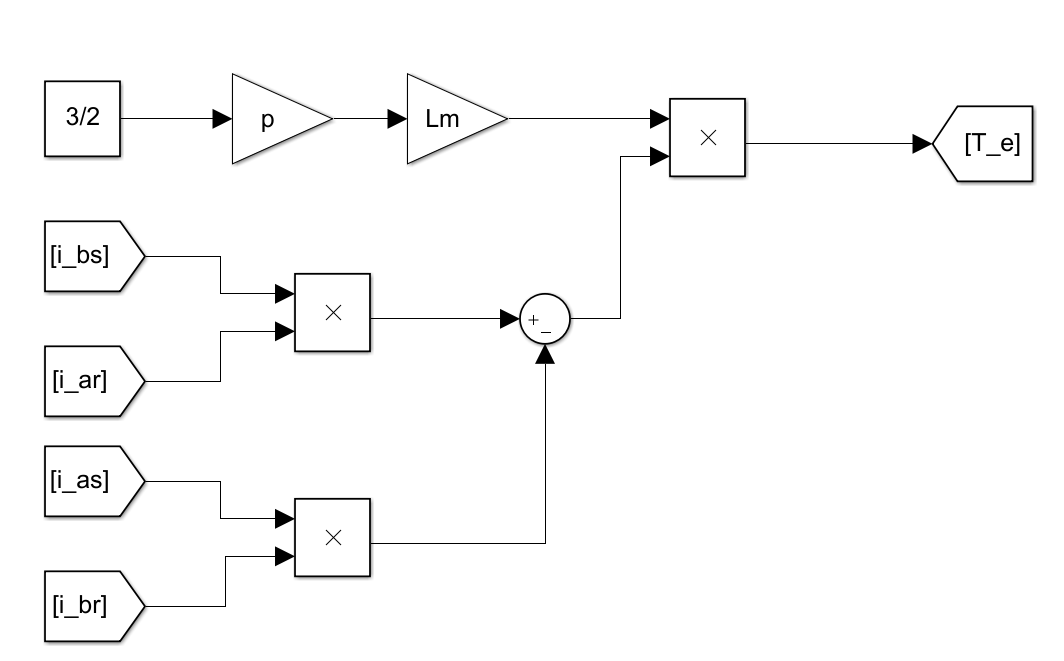
Report/Pictures/Induction machine overleaf/electromagnetic_torque.PNG
