NicolaiFransen/SemesterProjectPED2/Report/Pictures/Induction machine overleaf/mechanical_IM.PNG

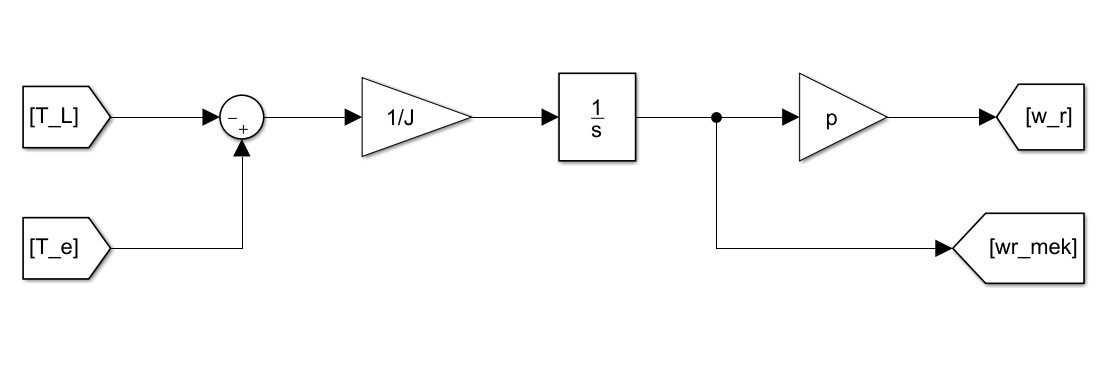
Report/Pictures/Induction machine overleaf/mechanical_IM.PNG
