NicolaiFransen/SemesterProjectPED2/Report/Pictures/Induction machine overleaf/motor_generator.PNG

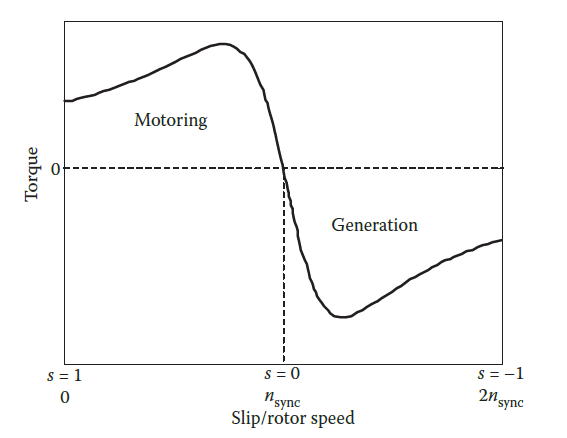
Report/Pictures/Induction machine overleaf/motor_generator.PNG
