NicolaiFransen/SemesterProjectPED2/Report/Pictures/Induction machine overleaf/power_factor_IM.png

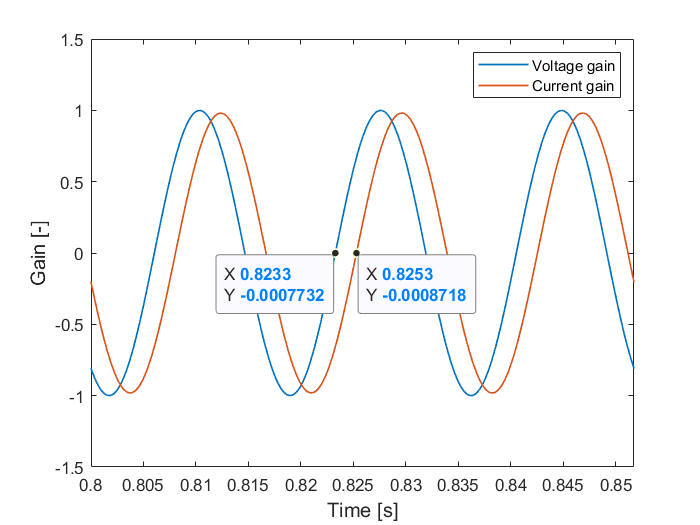
Report/Pictures/Induction machine overleaf/power_factor_IM.png
