NicolaiFransen/SemesterProjectPED2/Report/Pictures/Induction machine overleaf/rotor_V_alpha.PNG

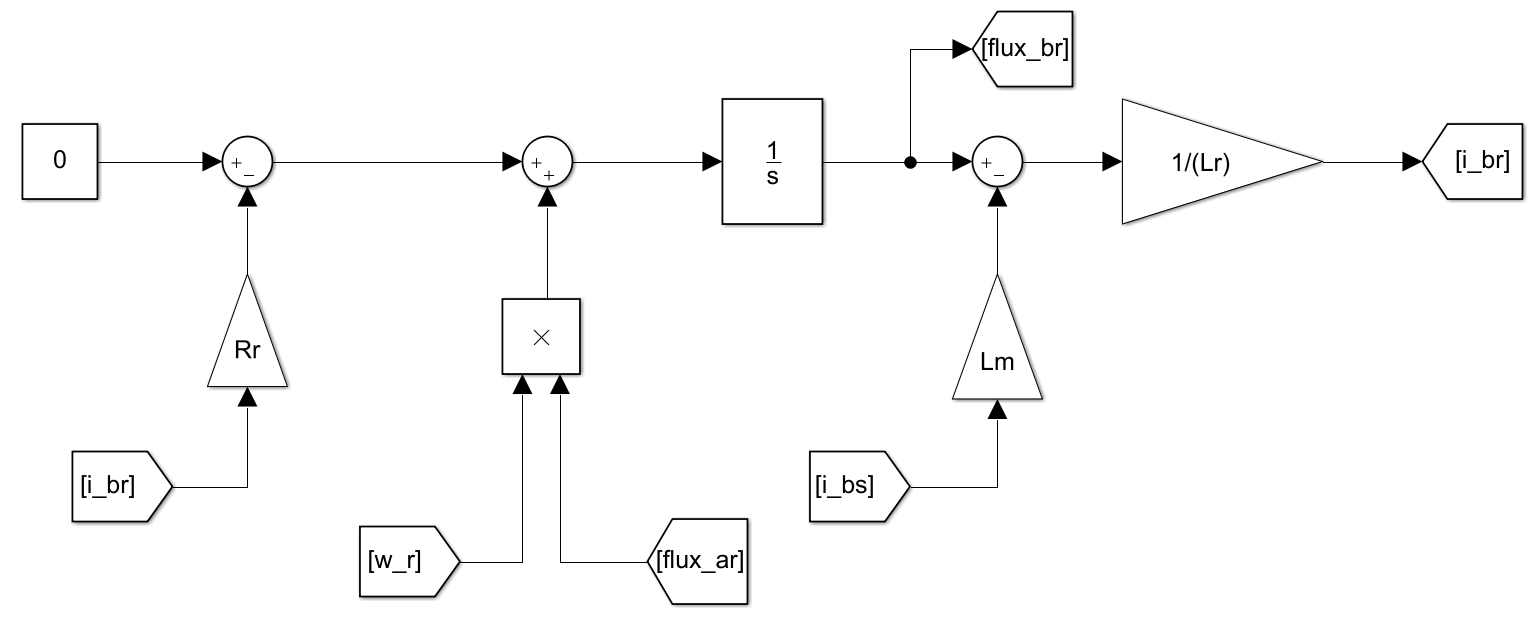
Report/Pictures/Induction machine overleaf/rotor_V_alpha.PNG
