NicolaiFransen/SemesterProjectPED2/Report/Pictures/Induction machine overleaf/slip_IM.png

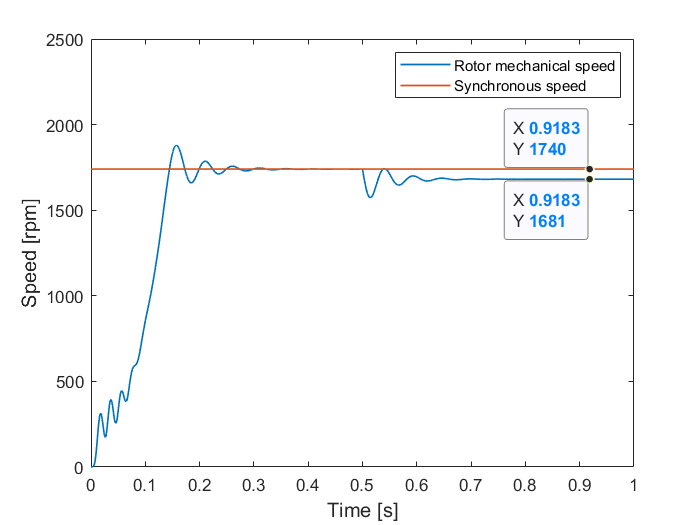
Report/Pictures/Induction machine overleaf/slip_IM.png
