NicolaiFransen/SemesterProjectPED2/Report/Pictures/Induction machine overleaf/stator_V_aloha.PNG

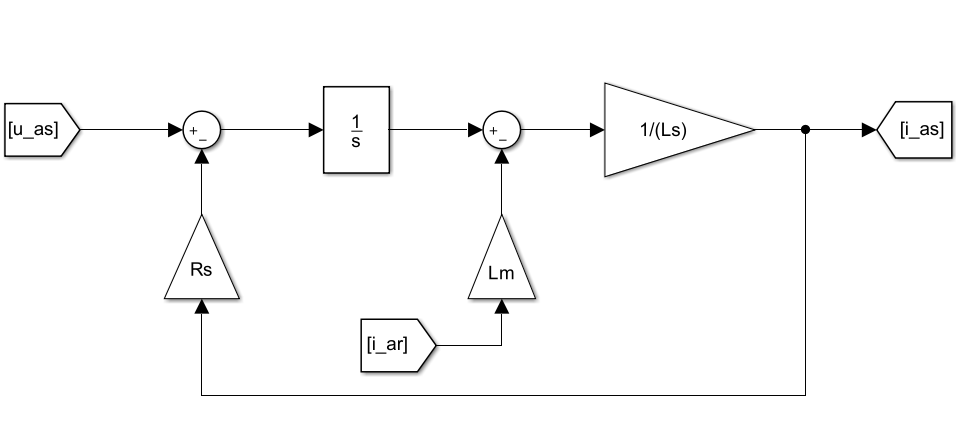
Report/Pictures/Induction machine overleaf/stator_V_aloha.PNG
