NicolaiFransen/SemesterProjectPED2/Report/Pictures/Induction machine overleaf/stator_V_beta.PNG

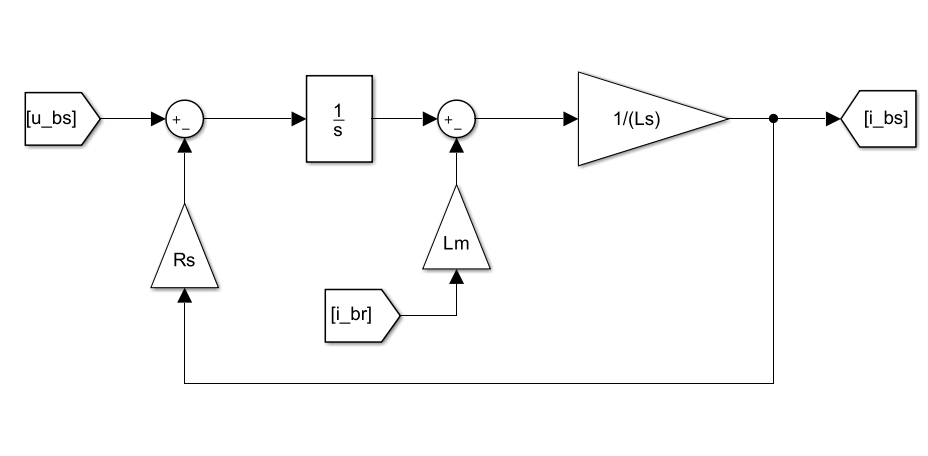
Report/Pictures/Induction machine overleaf/stator_V_beta.PNG
