NicolaiFransen/SemesterProjectPED2/Report/Pictures/Induction machine overleaf/stator_voltage_eq.PNG

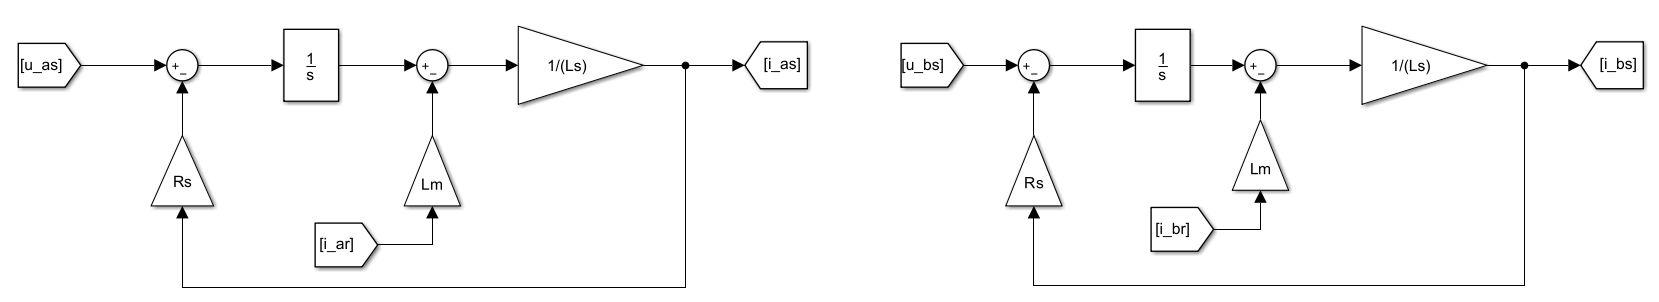
Report/Pictures/Induction machine overleaf/stator_voltage_eq.PNG
