NicolaiFransen/SemesterProjectPED2/Report/Pictures/Induction machine overleaf/torque_speed1.PNG

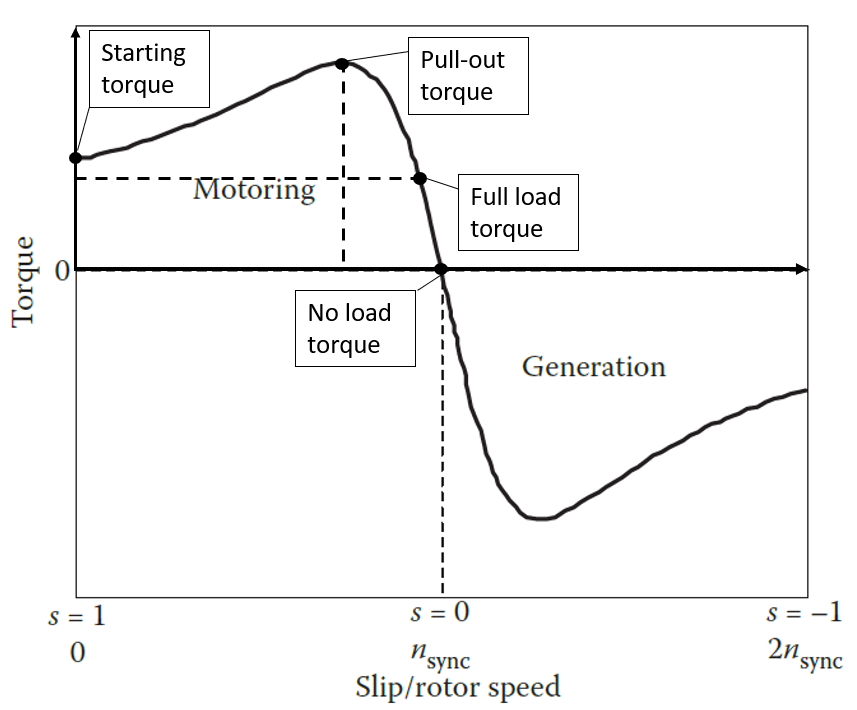
Report/Pictures/Induction machine overleaf/torque_speed1.PNG
