NicolaiFransen/SemesterProjectPED2/Report/Pictures/Induction machine overleaf/torque_speed.PNG

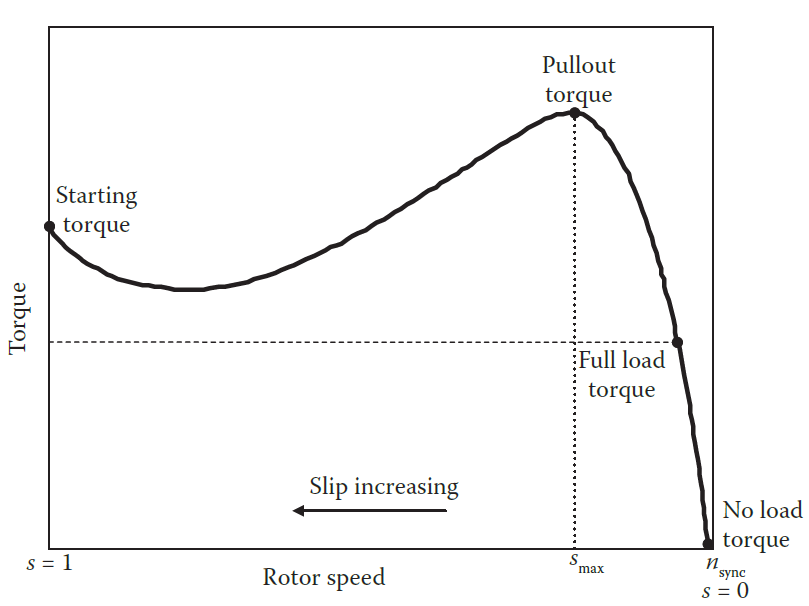
Report/Pictures/Induction machine overleaf/torque_speed.PNG
