NicolaiFransen/SemesterProjectPED2/Report/Pictures/Induction machine overleaf/torques_IM.png

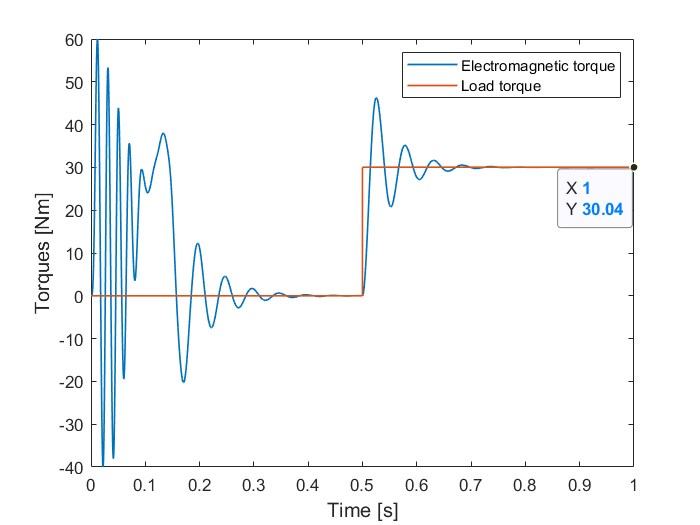
Report/Pictures/Induction machine overleaf/torques_IM.png
