NicolaiFransen/SemesterProjectPED2/Report/Pictures/InterfacePCB/InterfacePCB.jpg

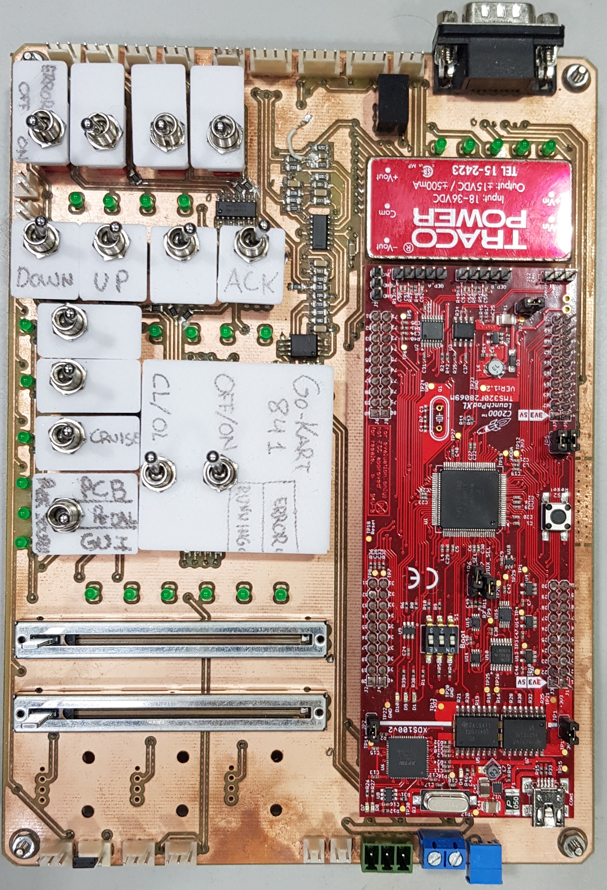
Report/Pictures/InterfacePCB/InterfacePCB.jpg
