NicolaiFransen/SemesterProjectPED2/Report/Pictures/LoadMachineGraph.PNG

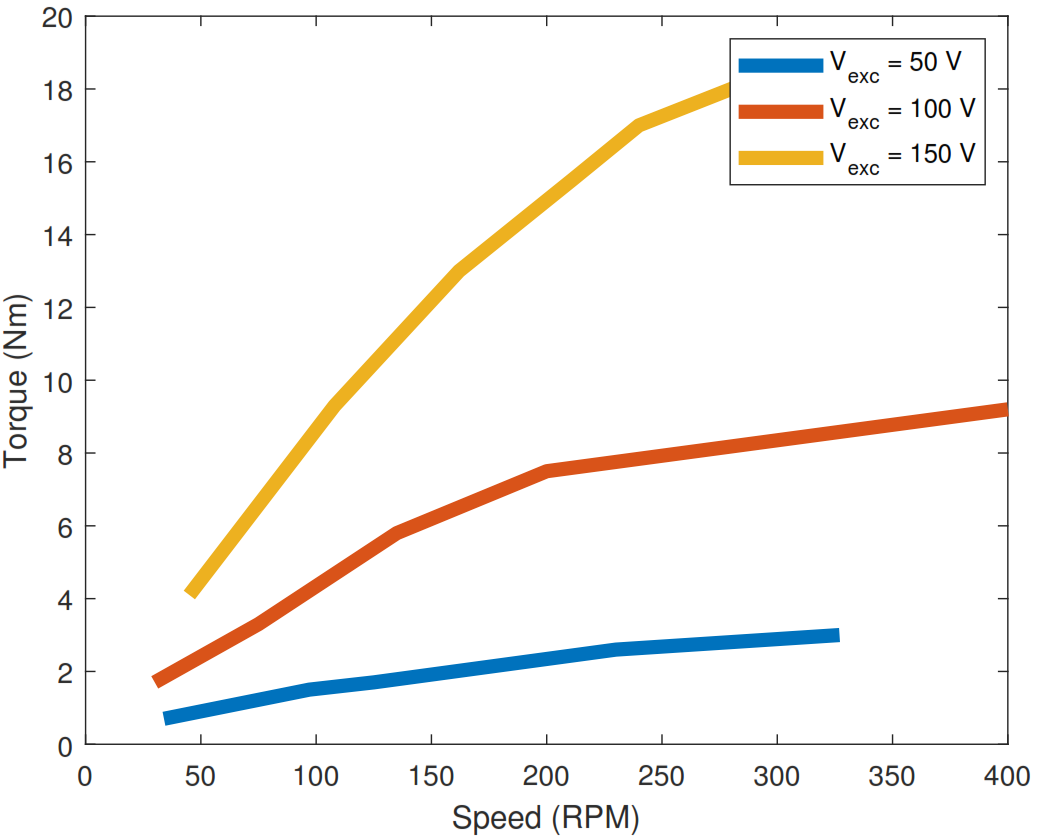
Report/Pictures/LoadMachineGraph.PNG
