NicolaiFransen/SemesterProjectPED2/Report/Pictures/ModelMachine/Simulations/Slip.png

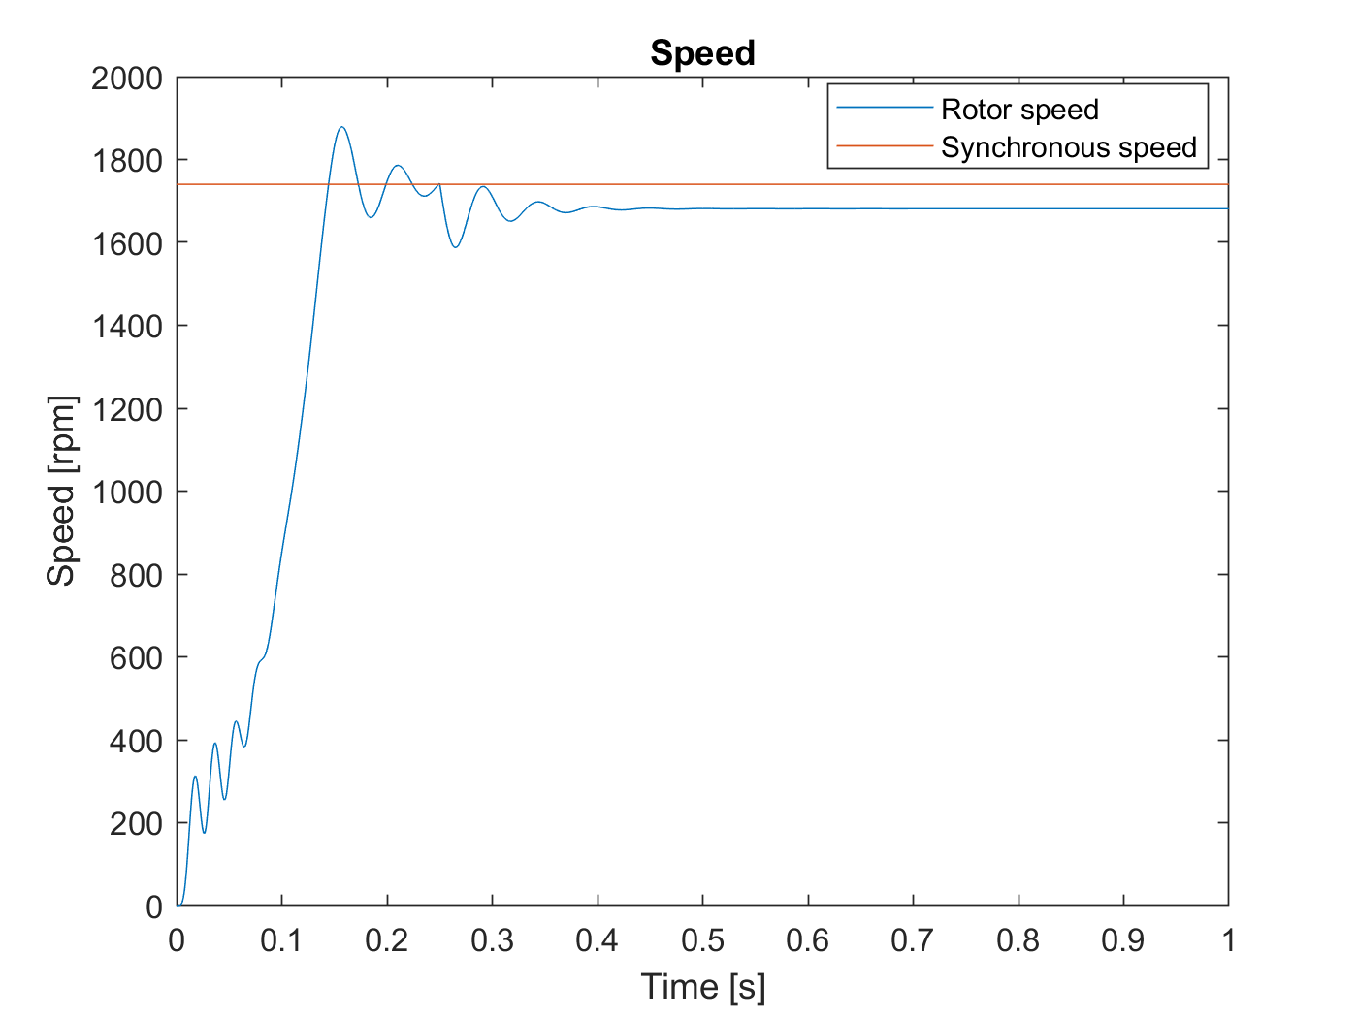
Report/Pictures/ModelMachine/Simulations/Slip.png
