NicolaiFransen/SemesterProjectPED2/Report/Pictures/ProjectManagment/Gantt_v1.PNG

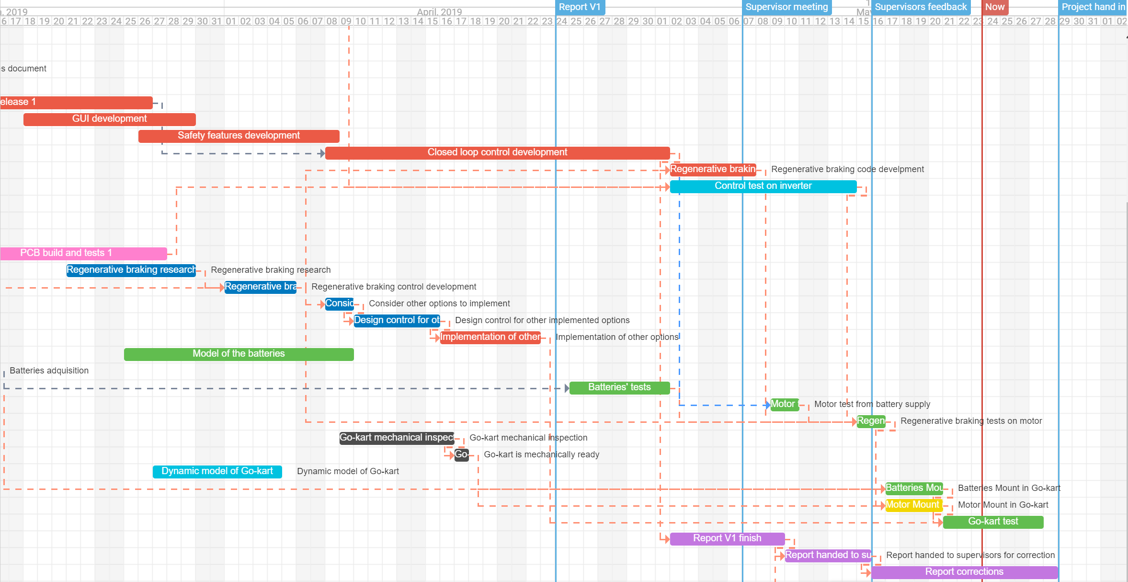
Report/Pictures/ProjectManagment/Gantt_v1.PNG
