NicolaiFransen/SemesterProjectPED2/Report/Pictures/ProjectManagment/Gantt_v2.PNG

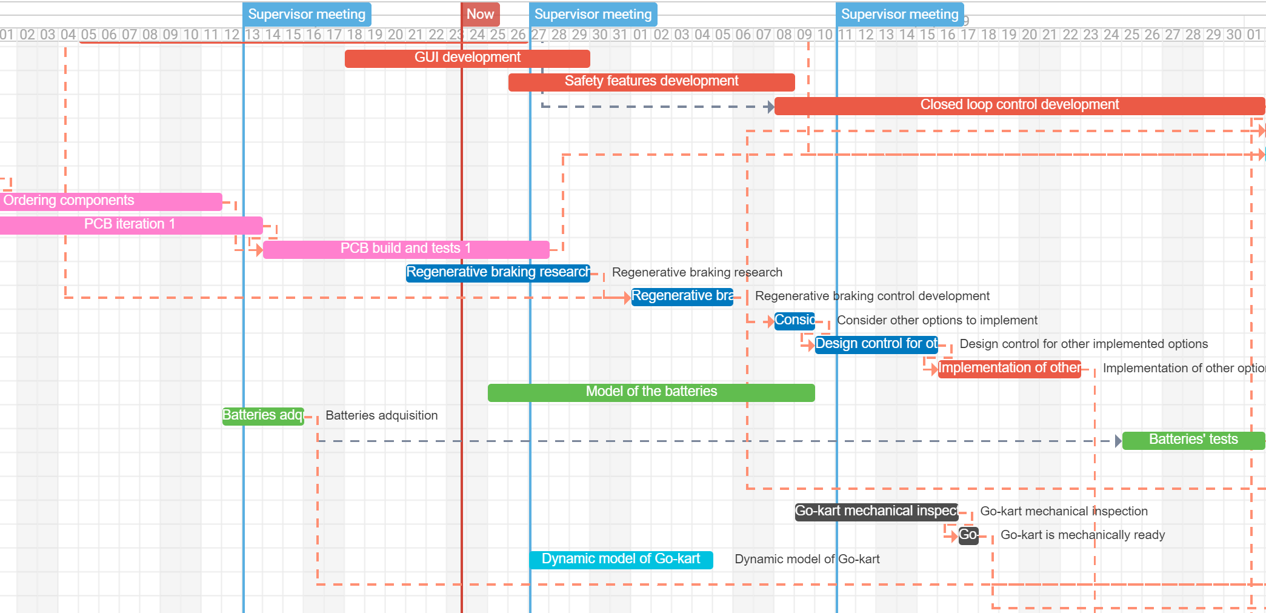
Report/Pictures/ProjectManagment/Gantt_v2.PNG
