NicolaiFransen/SemesterProjectPED2/Report/Pictures/PythonGraphPlotCrop.png

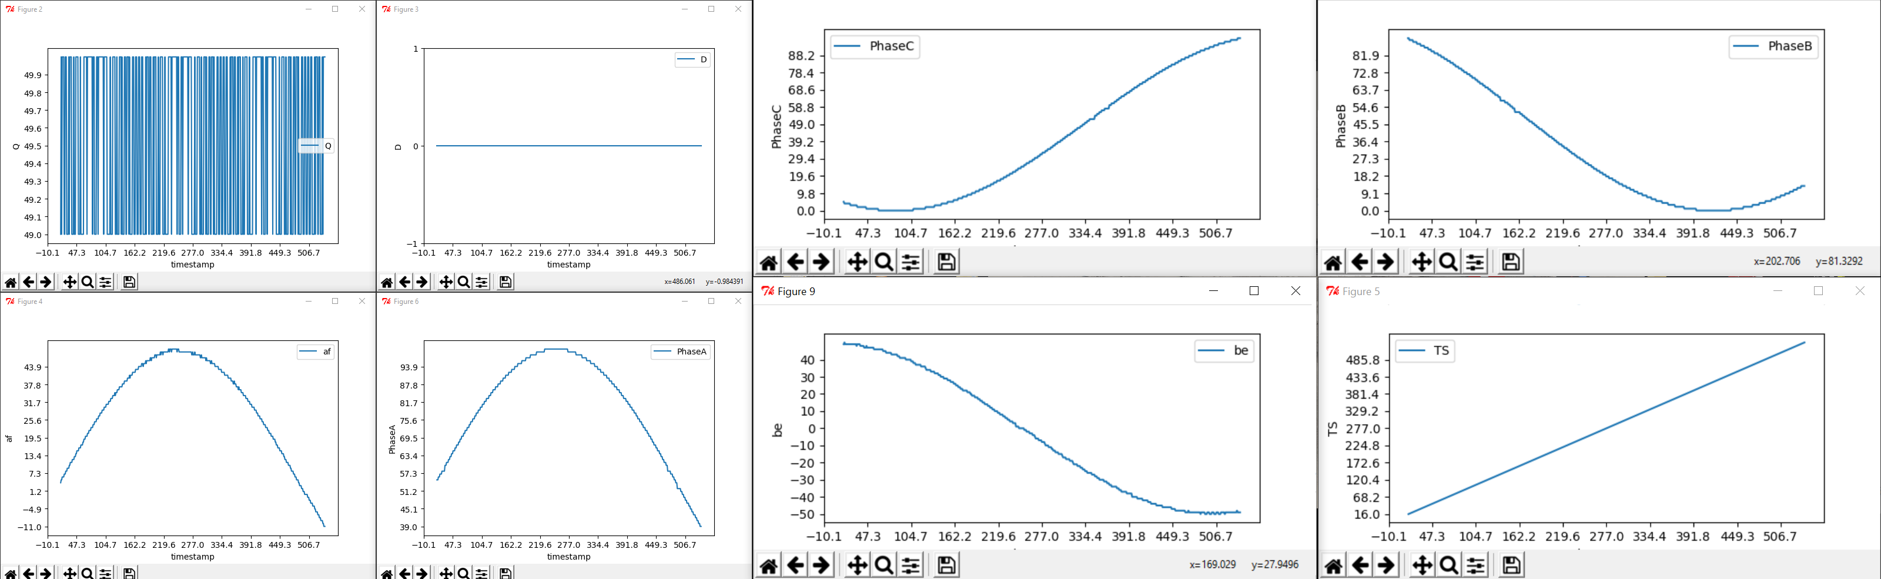
Report/Pictures/PythonGraphPlotCrop.png
