NicolaiFransen/SemesterProjectPED2/Report/Pictures/rotor_V_alpha.PNG

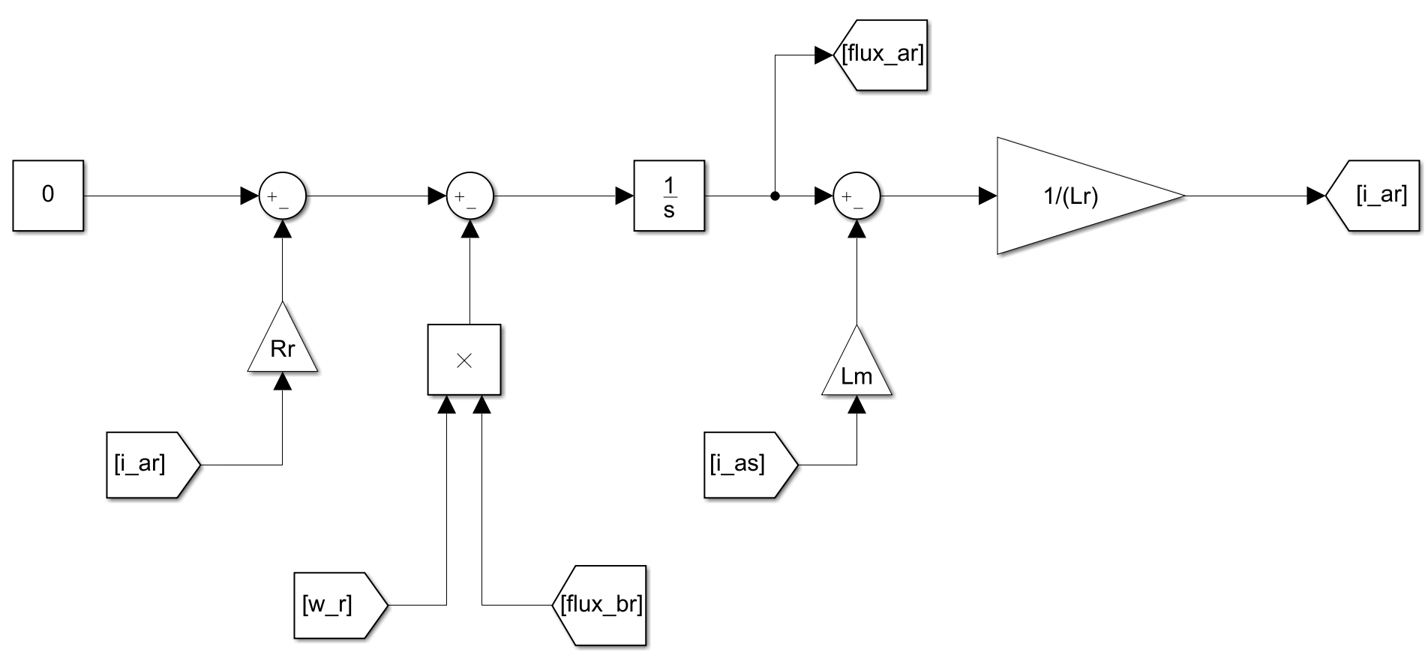
Report/Pictures/rotor_V_alpha.PNG
