NicolaiFransen/SemesterProjectPED2/Simulations/2018_Semester Project/Appendix/KiCad/Inverter/Ny mappe/End_ISO.png

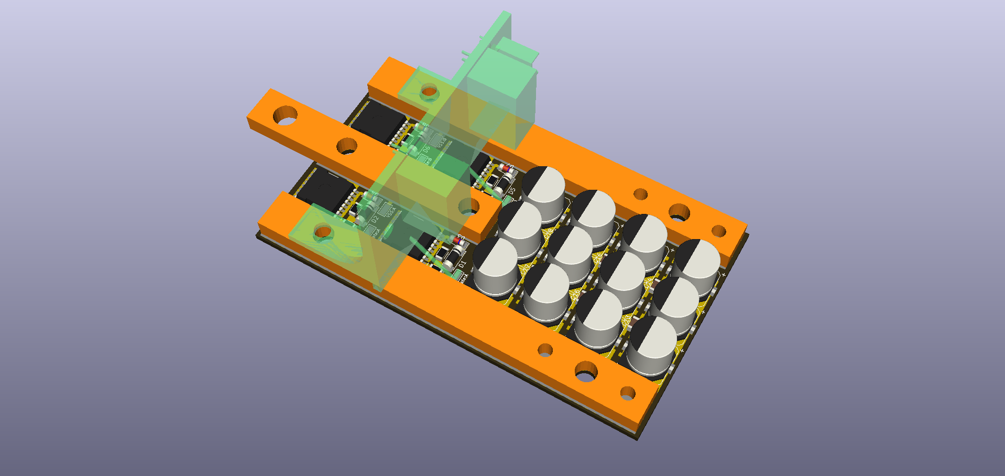
Simulations/2018_Semester Project/Appendix/KiCad/Inverter/Ny mappe/End_ISO.png
