NicolaiFransen/SemesterProjectPED2/Simulations/2018_Semester Project/Appendix/KiCad/Inverter/Ny mappe/Final/11.png

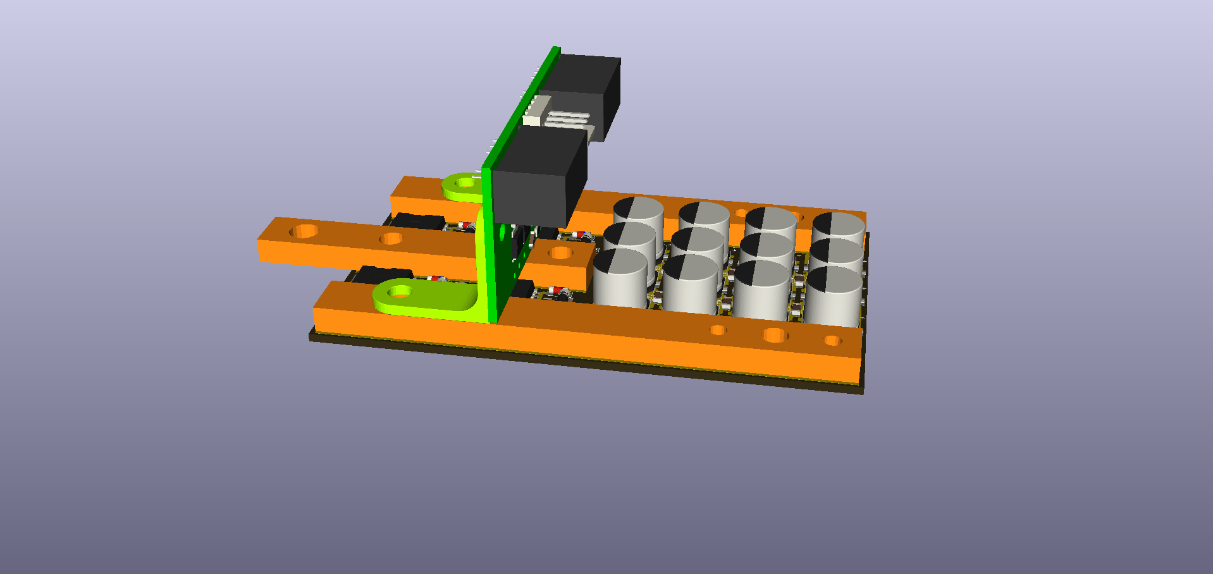
Simulations/2018_Semester Project/Appendix/KiCad/Inverter/Ny mappe/Final/11.png
