NicolaiFransen/SemesterProjectPED2/Simulations/2019_03_15_Im_model/4_out PI 2-10 No load.tif

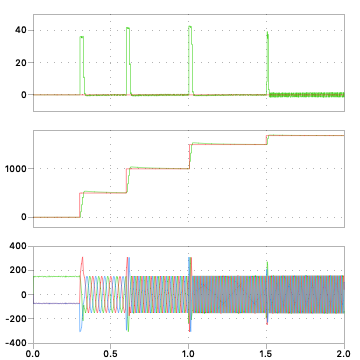
Simulations/2019_03_15_Im_model/4_out PI 2-10 No load.tif
