NicolaiFransen/SemesterProjectPED2/Simulations/2019_03_15_Im_model/5_in PI 2-10 full load.tif

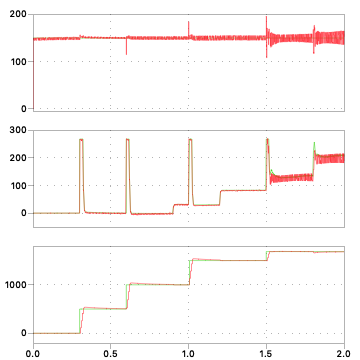
Simulations/2019_03_15_Im_model/5_in PI 2-10 full load.tif
