NicolaiFransen/SemesterProjectPED2/Simulations/2019_03_15_Im_model/9_out-Current PI SatB Return.tif

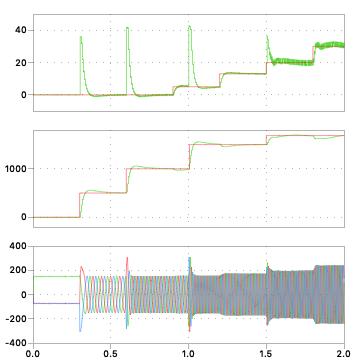
Simulations/2019_03_15_Im_model/9_out-Current PI SatB Return.tif
