NicolaiFransen/SemesterProjectPED2/Simulations/2019_03_19_Im_model_Discrete/3_out-Trapez-fs_Iabc-ZOH-Ts.tif

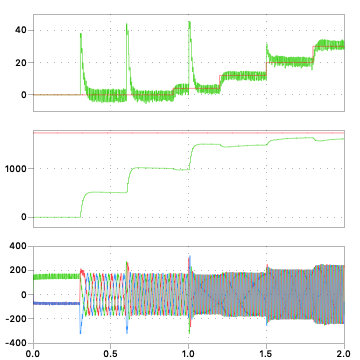
Simulations/2019_03_19_Im_model_Discrete/3_out-Trapez-fs_Iabc-ZOH-Ts.tif
