NicolaiFransen/SemesterProjectPED2/Simulations/2019_03_28_fDscrt_Tor-Spd Cntrl/1-out_Discrete_WO Delay.tif

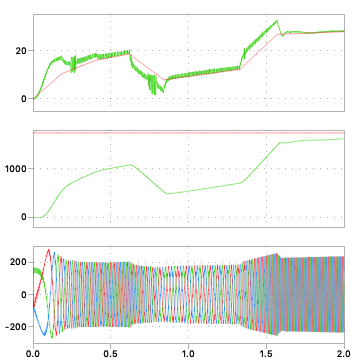
Simulations/2019_03_28_fDscrt_Tor-Spd Cntrl/1-out_Discrete_WO Delay.tif
