NicolaiFransen/SemesterProjectPED2/Simulations/2019_03_28_fDscrt_Tor-Spd Cntrl/3-in_W PWM Delay.tif

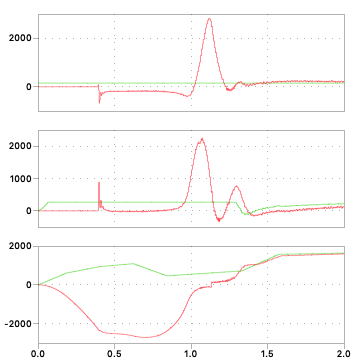
Simulations/2019_03_28_fDscrt_Tor-Spd Cntrl/3-in_W PWM Delay.tif
