NicolaiFransen/SemesterProjectPED2/Simulations/2019_03_28_fDscrt_Tor-Spd Cntrl/5-out_Var_anti on Iq loop.tif

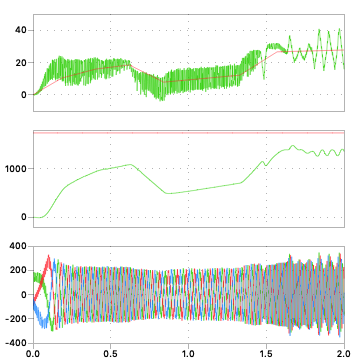
Simulations/2019_03_28_fDscrt_Tor-Spd Cntrl/5-out_Var_anti on Iq loop.tif
