NicolaiFransen/SemesterProjectPED2/Simulations/2019_03_29_mechanicalmodel/in_Tor→spd→Tor_cntrl.tif

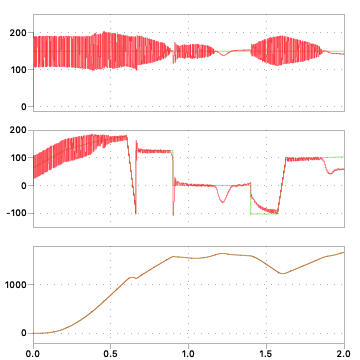
Simulations/2019_03_29_mechanicalmodel/in_Tor→spd→Tor_cntrl.tif
