NicolaiFransen/SemesterProjectPED2/Simulations/2019_05_11 FOC/FOC_overleaf/Bode_speedcontroller.png

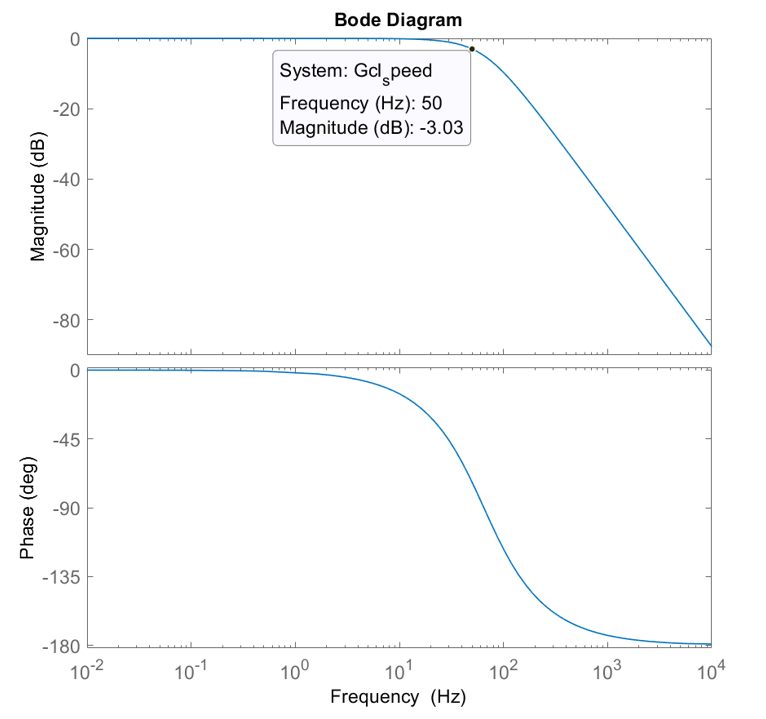
Simulations/2019_05_11 FOC/FOC_overleaf/Bode_speedcontroller.png
