NicolaiFransen/SemesterProjectPED2/Simulations/2019_05_11 FOC/FOC_overleaf/PI_current_control1.png

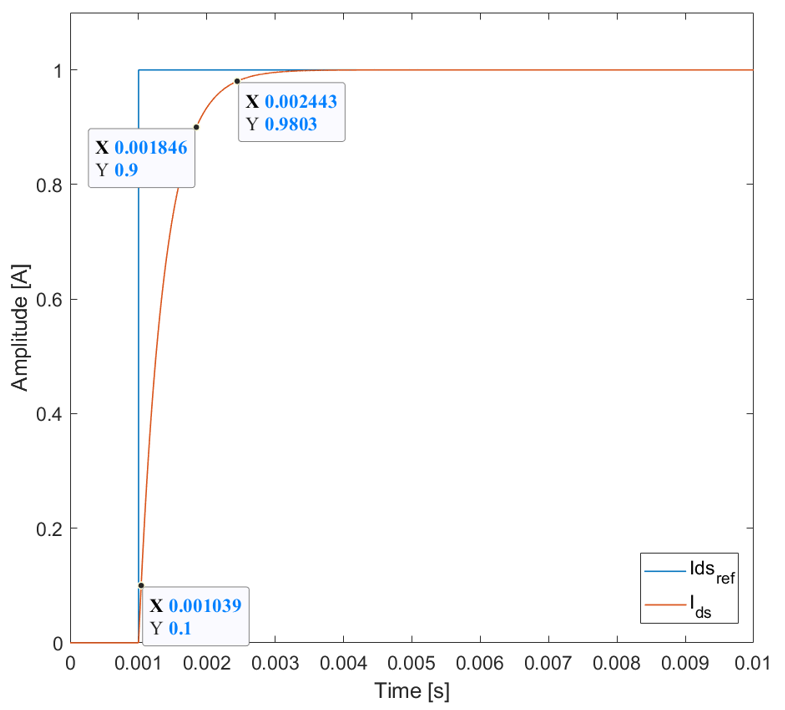
Simulations/2019_05_11 FOC/FOC_overleaf/PI_current_control1.png
