NicolaiFransen/SemesterProjectPED2/Simulations/2019_05_11 FOC/FOC_overleaf/Rotor_flux_orientation.PNG

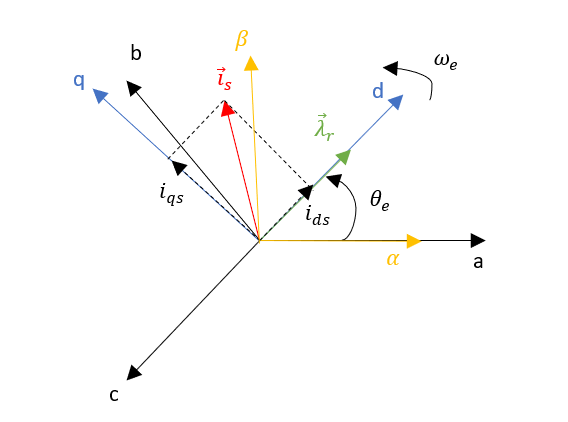
Simulations/2019_05_11 FOC/FOC_overleaf/Rotor_flux_orientation.PNG
