NicolaiFransen/SemesterProjectPED2/Simulations/2019_05_11 FOC/modulation_overleaf/state_time_ON.PNG

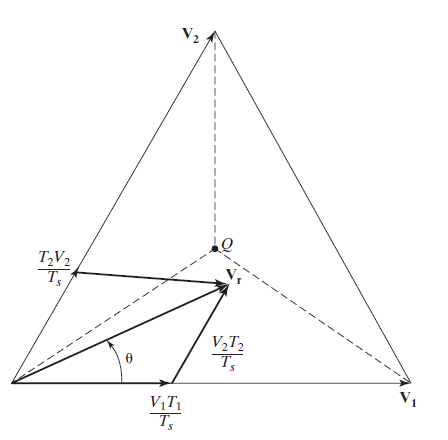
Simulations/2019_05_11 FOC/modulation_overleaf/state_time_ON.PNG
