NicolaiFransen/SemesterProjectPED2/Simulations/2019_05_11 FOC/modulation_overleaf/switching_seq_SVM_final.PNG

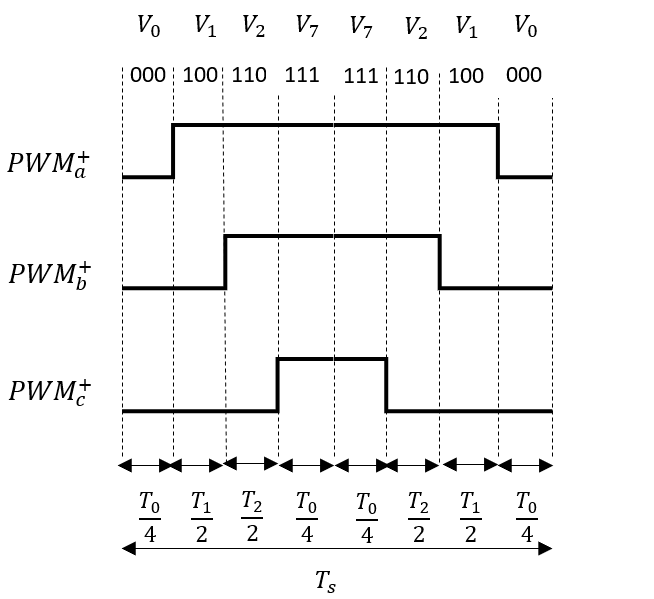
Simulations/2019_05_11 FOC/modulation_overleaf/switching_seq_SVM_final.PNG
