NicolaiFransen/SemesterProjectPED2/Simulations/Regenerative Braking/SpeedC_zoom.png

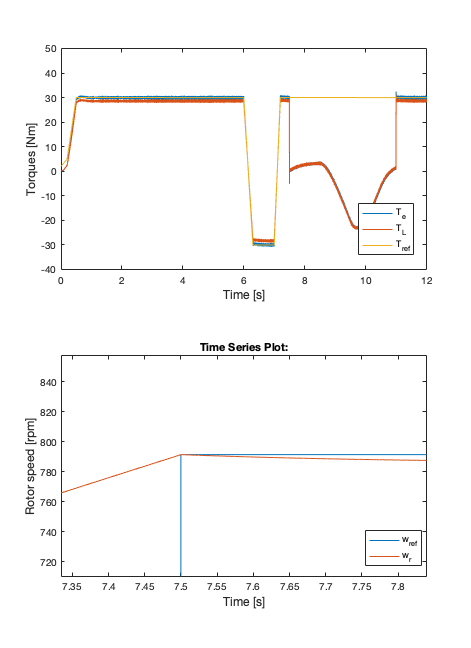
Simulations/Regenerative Braking/SpeedC_zoom.png
