NicolaiFransen/SemesterProjectPED2/Software/Design/System Manager SWC/State Machine1 State Machine diagram.png

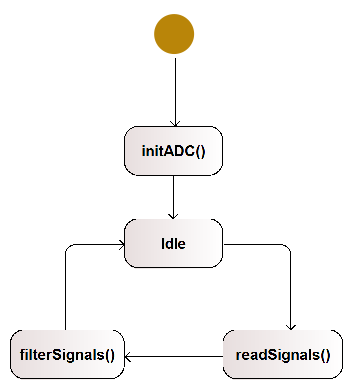
Software/Design/System Manager SWC/State Machine1 State Machine diagram.png
