NicolaiFransen/SemesterProjectPED2/Tests/120219_PreparatION for No load (Picture)/Gate Driver Schematics.png

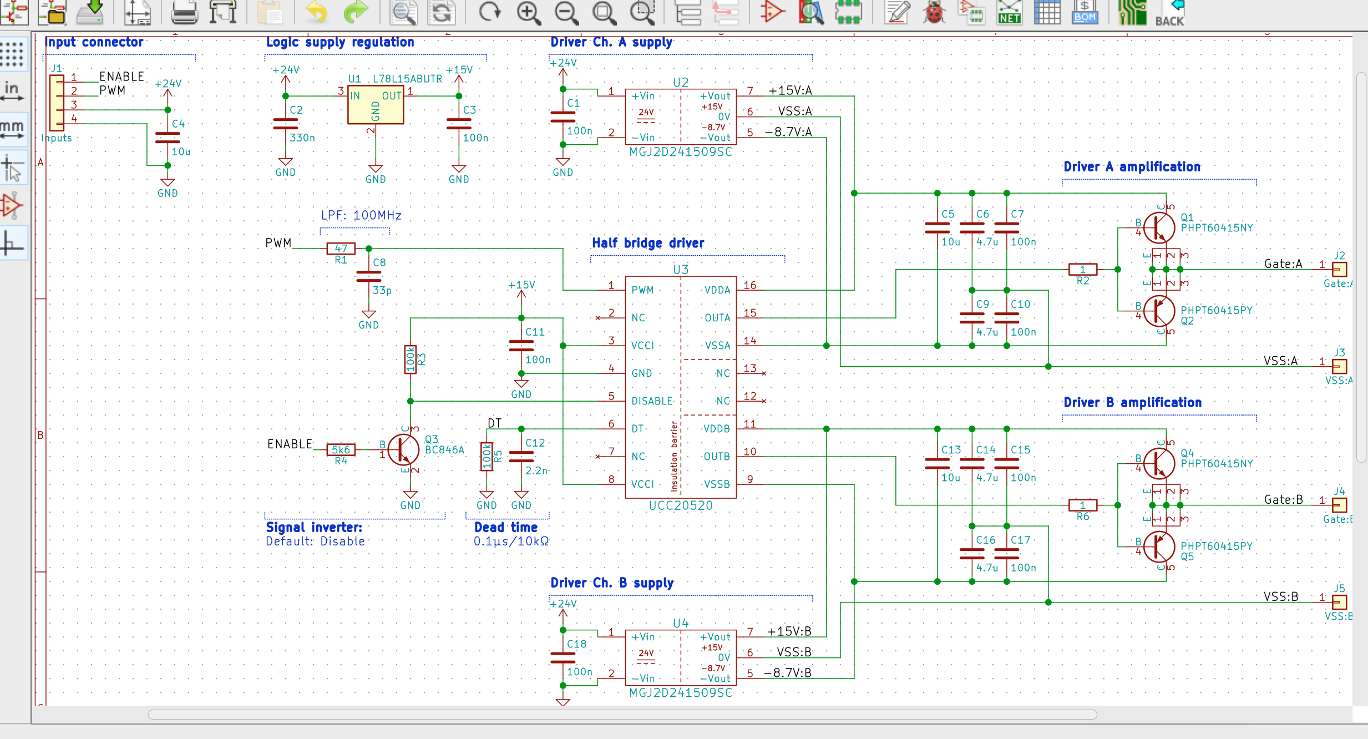
Tests/120219_PreparatION for No load (Picture)/Gate Driver Schematics.png
