NicolaiFransen/SemesterProjectPED2/Simulations/2018_Semester Project/Appendix/Datasheets/Controllers/DockingStation_ HSEC_120or180pin/R4_1/controlCARDDockingStationR4_1_BOM.xlsx

controlCARD Docking Station Bill of Materials
R4.1 | 2012-07-24
ITEM | REF-DES | QTY | VALUE | MANF PART NUMBER | DIGIKEY PART NUMBER | MOUSER PART NUMBER | DESCRIPTION | RoHS | REACH | ALTERNATE
1 | C1 | 1 | 10u |  |  |  | CAP CER 6V3 10% X5R 0805 | Specified by CM | Specified by CM
2 | C2 C4 | 2 | 100n |  |  |  | CAP CER 6V3 10% X5R 0805 | Specified by CM | Specified by CM
3 | C3 | 1 | 4u7 |  |  |  | CAP CER 6V3 10% X5R 0805 | Specified by CM | Specified by CM
4 | C5-6 | 2 | 470n |  |  |  | CAP CER 6V3 10% X5R 0805 | Specified by CM | Specified by CM
5 | D1 | 1 | GREEN |  |  |  | LED GREEN 0805 SMD, Diffused, 567nm | Specified by CM | Specified by CM
6 | J1 | 1 |  | PJ-002BH | CP-002BH-ND |  | CONN PWR JACK 2.5X5.5MM HIGH CUR | Yes | Yes; Oct-2010
7 | J2 | 1 |  |  |  |  | Header, Male, 7x2-pin, 100mil spacing, remove pin 6 | Specified by CM | Specified by CM
8 | J3 | 1 | HSEC8 180pin | HSEC8-130-01-L-DV-A & HSEC8-160-01-L-DV-A-BL |  |  | 180 pin (120 + 60) HSEC8 socket, samtec | Yes | Yes; Dec-2011
9 | J4 | 1 |  |  |  |  | Header, Male, 1x17-pin, 100mil spacing | Specified by CM | Specified by CM
10 | J5 | 1 |  |  |  |  | Header, Male, 1x15-pin, 100mil spacing | Specified by CM | Specified by CM
11 | J6-7 | 2 |  |  |  |  | Header, Male, 1x32-pin, 100mil spacing | Specified by CM | Specified by CM
12 | J8 | 1 |  |  |  |  | Header, Male, 1x27-pin, 100mil spacing | Specified by CM | Specified by CM
13 | J9 | 1 |  |  |  |  | Header, Male, 1x26-pin, 100mil spacing | Specified by CM | Specified by CM
14 | J10-11 J14-15 J18 J20 J22 J24 | 8 |  |  |  |  | Header, Male, 1x4-pin, 100mil spacing | Specified by CM | Specified by CM
15 | J12-13 J16 J19 J21 J23 J25 | 7 |  |  |  |  | Header, Male, 1x2-pin, 100mil spacing | Specified by CM | Specified by CM
16 | J17 | 1 |  | UX60-MB-5ST | H2959CT-ND |  | CONN RECEPT MINI USB2.0 5POS | Yes | Yes; Sep-2011
17 | R1 | 1 | 470R |  |  |  | RES 1/8W 5% 0805 SMD | Specified by CM | Specified by CM
18 | S1 | 1 |  | 200AWMSP1T1A1M2QE | 200AWMSP1T1A1M2QE-ND |  | Toggle Switches SPDT ON-ON PC MOUNT | Yes | Yes; Oct-2011 | Mouser: 108-2AS1T1203-EVX
19 | U1 | 1 |  | TPS79533DCQ | 296-13810-1-ND |  | IC LDO REG 3.3V 500MA SOT223-6 | Yes | Yes; Jul-2011
