NicolaiFransen/SemesterProjectPED2/Simulations/2018_Semester Project/Appendix/Datasheets/Controllers/TMDSCNCD28075/R1_1/F2807x_120controlCARD_R1_1_BOM_05Aug2014.xlsx

F2807x controlCARD Bill of Materials
R1.1 | V1 - 8/05/2014
ITEM | REF-DES | QTY | VALUE | PART NUMBER | DIGIKEY PART NUMBER | DESCRIPTION
1 | A:C1 A:C6-12 A:C14 A:C16 A:C20-28 C1-3 C9-14 C38-39 C42-43 C47 C49-68 C70 C74-78 C86-95 C101 | 70 | 100n |  |  | CAP CER 16V 10% X7R 0402
2 | A:C4 | 1 | 10n |  |  | CAP CER 16V 10% X7R 0402
3 | C4-5 | 2 | 1n |  |  | CAP CER 16V 10% X7R 0402
4 | C44-46 | 3 | 1u |  |  | CAP CER 16V 10% X7R 0402
5 | C6 C71 | 2 | DNP |  |  | CAP CER 16V 10% X7R 0402
6 | C7-8 | 2 | 15p |  |  | CAP CER 50V NP0 0402
7 | A:C18-19 | 2 | 27p |  |  | CAP CER 50V NP0 0402
8 | C72 | 1 | 33p |  |  | CAP CER 50V NP0 0402
9 | A:C2 C80-81 C83 | 4 | 10u |  |  | CAP CER 6.3V 20% X5R 0603
10 | C40-41 C85 C97 | 4 | 2u2 |  |  | CAP CER 10V 20% X5R 0603
11 | A:C5 A:C13 A:C15 | 3 | 4u7 |  |  | CAP CER 6.3V 10% X5R 0603
12 | C18-37 | 20 | DNP |  |  | CAP CER 16V 10% X7R 0603
13 | C79 C82 C100 | 3 | 10u |  |  | CAP CER 10V 20% X5R 0805
14 | C48 C69 C73 | 3 | 22u |  |  | CAP CER 6.3V 20% X5R 0805
15 | C15-17 C84 C96 | 5 | 2u2 |  |  | CAP CER 10V 20% X5R 0805
16 | C98 | 1 | DNP |  |  | CAP TANT 20% 1206
17 | J1 | 1 | HEADER_HSEC8-120_EDGE |  |  | 120 pin HSEC8 fingers; samtec
18 | A:D3-4 | 2 | BLUE |  |  | LED BLUE 0805 SMD, Clear, 470nm
19 | A:D2 LD1 | 2 | GREEN |  |  | LED GREEN 0805 SMD, Diffused, 567nm
20 | LD2-3 | 2 | RED |  |  | LED RED 0805 SMD, Diffused, 647nm
21 | R58 | 1 | 200K |  |  | RES 1/16W 0.1% 0402 SMD
22 | R57 | 1 | 205K |  |  | RES 1/16W 1% 0402 SMD
23 | R50 | 1 | 22K |  |  | RES 1/16W 1% 0402 SMD
24 | R53 | 1 | 2K |  |  | RES 1/16W 1% 0402 SMD
25 | R51 | 1 | 340K |  |  | RES 1/16W 1% 0402 SMD
26 | R1-2 | 2 | 4K7 |  |  | RES 1/16W 1% 0402 SMD
27 | R55 | 1 | 75K |  |  | RES 1/16W 0.1% 0402 SMD
28 | A:R7 A:R10 R13 R48-49 R61-62 | 7 | 0 |  |  | RES 1/16W 5% 0402 SMD
29 | R64 R71 | 2 | 100K |  |  | RES 1/16W 5% 0402 SMD
30 | A:R6 A:R8 A:R15 A:R17 R54 R63 R65-66 | 8 | 10K |  |  | RES 1/16W 5% 0402 SMD
31 | R70 | 1 | 150K |  |  | RES 1/16W 5% 0402 SMD
32 | A:R5 A:R9 A:R11-12 | 4 | 1K |  |  | RES 1/16W 5% 0402 SMD
33 | A:R16 R8 R21-22 | 4 | 2K2 |  |  | RES 1/16W 5% 0402 SMD
34 | R3-7 R11 | 6 | 39 |  |  | RES 1/16W 5% 0402 SMD
35 | R19 | 1 | 510K |  |  | RES 1/16W 5% 0402 SMD
36 | R15-16 | 2 | 56K |  |  | RES 1/16W 5% 0402 SMD
37 | A:R1 R9-10 R52 | 4 | 680 |  |  | RES 1/16W 5% 0402 SMD
38 | A:R13-14 R12 R23 | 4 | DNP |  |  | RES 1/16W 5% 0402 SMD
39 | R18 | 1 | 120K |  |  | RES 1/10W 1% 0603 SMD
40 | R20 | 1 | 560K |  |  | RES 1/10W 1% 0603 SMD
41 | R14 | 1 | 649K |  |  | RES 1/10W 1% 0603 SMD
42 | R17 | 1 | 750K |  |  | RES 1/10W 1% 0603 SMD
43 | R24-46 R59-60 | 25 | 0 |  |  | RES 1/10W 5% 0603 SMD
44 | R67-69 | 3 | 100K |  |  | RES 1/10W 5% 0603 SMD
45 | R56 | 1 | DNP |  |  | RES 1/10W 5% 0603 SMD
46 | R47 | 1 | 0 |  |  | RES 1/8W 5% 0805 SMD
47 | A:TP1-2 TP1-7 | 9 |  |  |  | Via, 20 ID, 40 OD (mil)
48 | A:C31 | 1 | 10n | 1812SC103KAT1A | 478-4735-1-ND | CAP CER 1.5KV 10% X7R 1812
49 | J2 | 1 |  | 1981584-1 | A97799CT-ND | USB micro AB Female USB2.0
50 | A:SW1 SW1 | 2 | 218-2LPST | 218-2LPST | CT2182LPST-ND | 2xSPST DIP switch SMT, half-pitch
51 | X1 | 1 | 20MHz, 20ppm | 7B-20.000MEEQ-T | 887-1303-1-ND | 20MHz Crystal, 20ppm
52 | A:U5 | 1 |  | 93LC56C-I/SN | 93LC56C-I/SN-ND | IC EEPROM 2KBIT 3MHZ 8SOIC
53 | L5-6 | 2 | 60Ohm | BKP2125HS600-T | 587-1932-1-ND | FERRITE 3A 60OHM@100MHz 0805 SMD
54 | L3-4 | 2 | 220Ohm | BLM21PG221SN1D | 490-1054-1-ND | FERRITE 2A 220OHM@100MHz 0805 SMD
55 | SW2-3 | 2 | CAS-D20TA | CAS-D20TA | CASD20JCT-ND | Switch SPDT, 2 position
56 | A:X1 | 1 | 12 MHz | ECS-120-20-30B-TR | XC1118CT-ND | CRYSTAL 12.000 MHZ 20PF SMD
57 | A:U4 | 1 |  | FT2232HL | 768-1024-1-ND | IC USB HS DUAL UART/FIFO 64-QFN
58 | A:L1-2 | 2 |  | HZ0805E601R-10 | 240-2399-1-ND | FERRITE 500MA 600 OHM 0805 SMD
59 | A:U6-8 A:U10 | 4 |  | ISO7220CD | 296-21953-1-ND | IC DGTL ISOLATOR 25MBPS 2CH 8SOIC
60 | A:D1 D1-2 | 3 |  | MBRM110ET1G | MBRM110ET1GOSCT-ND | DIODE SCHOTTKY 10V 1A POWERMITE
61 | U16 | 1 | NTA7002NT1G | NTA7002NT1G | NTA7002NT1GOSCT-ND | N-channel MOSFET 30V 0.154A
62 | U6-10 | 5 | NUP4201MR6T1G | NUP4201MR6T1G | NUP4201MR6T1GOSCT-ND | TVS 4-ch Diode Array, 5V breakdown
63 | U12 | 1 |  | OPA4376AIPW | 296-22565-1-ND | IC OPAMP GP R-R 5.5MHZ QUAD 14TSSOP
64 | U14 | 1 |  | REF3030AIDBZR | 296-26323-1-ND | IC, Voltage Reference, 3.0V, 0.2%, 14uVpp noise
65 | U13 | 1 |  | REF3033AIDBZR | 296-26324-1-ND | IC, Voltage Reference, 3.3V, 0.2%, 14uVpp noise
66 | A:U9 | 1 | 3-State Buffer | SN74ALVC244PWR | 296-5136-1-ND | 3-State Buffer, 2 elements x 4 bits
67 | U2 | 1 | SN74LVC2G07DBVR | SN74LVC2G07DBVR | 296-13494-1-ND | Buffer Line Driver, non-inverting, 32mA
68 | A:C3 | 1 | 47u | TCTP0J476M8R | 511-1682-1-ND | CAP TANT 20% 0805 6.3V
69 | C99 | 1 | 68u | TLJA686M010R1500 | 478-4925-1-ND | CAP TANT 10V 20% 1206
70 | U1 | 1 |  | TMS320F28075PTPT |  | C2000 MCU F28075 177pin PTP
71 | A:U2 | 1 |  | TPD2E001DRLR | 296-21883-1-ND | IC ESD-PROT ARRAY 2CH SOT-5
72 | D3 | 1 | TPD4S012DRYR | TPD4S012DRYR | 296-24244-1-ND | 4-channel USB ESD Diode for USB-HS/USB OTG; 6SON
73 | U15 | 1 | TPS2051BDBVR | TPS2051BDBVR | 296-21265-1-ND | High-Side Power Distribution Switch
74 | U11 | 1 | TPS27082LDDCR | TPS27082LDDCR | 296-35595-1-ND | High-side load switch
75 | U3 | 1 |  | TPS3895ADRY | 296-29806-1-ND | IC SVS Adjustable SON-6/DRY; PushPull; ActiveLow
76 | U4 | 1 |  | TPS3897ADRY | 296-29810-1-ND | IC SVS Adjustable SON-6/DRY; OpenCollector
77 | U17 | 1 |  | TPS62420DRC | 296-25650-1-ND | IC Dual Step Down Converter, 2.25MHz, 600mA/1A
78 | A:U1 | 1 |  | TPS73033DBV | 296-17580-1-ND | IC LDO REG HI-PSRR 3.3V SOT23-5
79 | A:J1 | 1 |  | UX60-MB-5ST | H2959CT-ND | CONN RECEPT MINI USB2.0 5POS
80 | L1 | 1 | 2u2 | VLF3010AT-2R2M1R0 | 445-3215-1-ND | Inductor Power 2.2uH 1.0A SMD 20%
81 | L2 | 1 | 3u3 | VLF3010AT-3R3MR87 | 445-3216-1-ND | Inductor Power 3.3uH 0.87A SMD 20%
