NicolaiFransen/SemesterProjectPED2/Simulations/2018_Semester Project/Appendix/Datasheets/Mosfet_IGBT/Transistor.ods

Type | Component name | Manufacturer | VDS | Id | On-resistance/voltage | Rise time | Fall time | Input capacitance | Output Capacitance | Total Max. Gate Charge | Housing | Price | Datasheet | Comment
MOSFET/SMD | AUIRF7749L2TR | Infineon | 60V | 243 A/Tc = 100' | 1.5 mΩ | 149 ns | 88ns | 10655 pF | 1627 pF | 275 nC | DirectFET® | 4,59 € | https://www.mouser.com/ds/2/196/auirf7749l2-1225782.pdf
Mosfet/SMD | IRFS3006-7PPbF | Infineo | 60V | 207 A/Tc = 100' | 2.1mΩ | 61ns | 69ns | 8860 pF | 1007 pF | 300 nC | TO-252-3 | 3,00 € | https://www.mouser.com/ds/2/196/irfs3006-7ppbf-1228497.pdf
Mosfet/SMD | IRFS7530-7PPbF | Infineon | 60V | 239 A/Tc = 100' | 1.4mΩ | 102ns | 79ns | 12960 pF | 1270 pF | 354 nC | TO-263-7 | 3,60 € | https://www.mouser.com/ds/2/196/irfs7530-7ppbf-1228415.pdf
Mosfet/SMD | IXTZ550N055T2 | IXYS | 55V | 400 A/Tc= 100 | 1mΩ | 40ns | 230ns | 40 nF | 4970 pF | 594 nC | DE-475-6 | 21,95 € | https://www.mouser.com/ds/2/205/DS100243(IXTZ550N055T2)-1110227.pdf
GIGAMosfet/SMD | IXFZ520N075T2 | IXYS | 75V | 300A/Tc= 100 | 1.6 mΩ | 36ns | 35ns | 41 nF | 4150 pF | 545 nC | DE-475-6 | 25,95 € | https://www.mouser.com/ds/2/205/DS100250A(IXFZ520N075T2)-1110166.pdf
Mosfet/SMD | AUIRFS3006-7P | Infineon | 60V | 175A/Tc = 100 | 2.1mΩ | 61ns | 69ns | 8850 pF | 1007 pF | 300 nC | TO-252-3 | 3,99 € | https://www.infineon.com/dgdl/auirfs3006-7p.pdf?fileId=5546d462533600a4015355b6571e14b0
Mosfet | IRFP4368PbF | Infineon | 75V | 250 A | 1.85mΩ | 220 ns | 260 ns | 19230 pF | 1670 pF | 570 nC | Through Hole | 5,22 € | https://www.mouser.com/ds/2/196/irfp4368pbf-1227384.pdf
 |  | https://www.mouser.com/ds/2/196/auirf7749l2-1225782.pdf
