NicolaiFransen/SemesterProjectPED2/Driver/PCB/Gate_drive.csv

Ref | Qnty | Value
C2, | 1 | 330n
C8, | 1 | 33p
C1, C3, C7, C10, C11, C15, C17, C18 | 8 | 100n
C12, | 1 | 2.2n
C4, C5, C13 | 3 | 10u
C6, C9, C14, C16 | 4 | 4.7u
J1, | 1 | Inputs
J2, | 1 | Gate:A
J3, | 1 | VSS:A
J4, | 1 | Gate:B
J5, | 1 | VSS:B
Q3, | 1 | BC846A
Q4, Q1, | 2 | PHPT60415NY
Q5, Q2, | 2 | PHPT60415PY
R1, | 1 | 47
R4, | 1 | 5k6
R3, R5, | 2 | 100k
R2, R6, | 2 | 1
U1, | 1 | L78L15ABUTR
U2, U4, | 2 | MGJ2D241509SC
U3, | 1 | UCC20520
