NicolaiFransen/SemesterProjectPED2/Interface board/ComponentArrangment.PNG

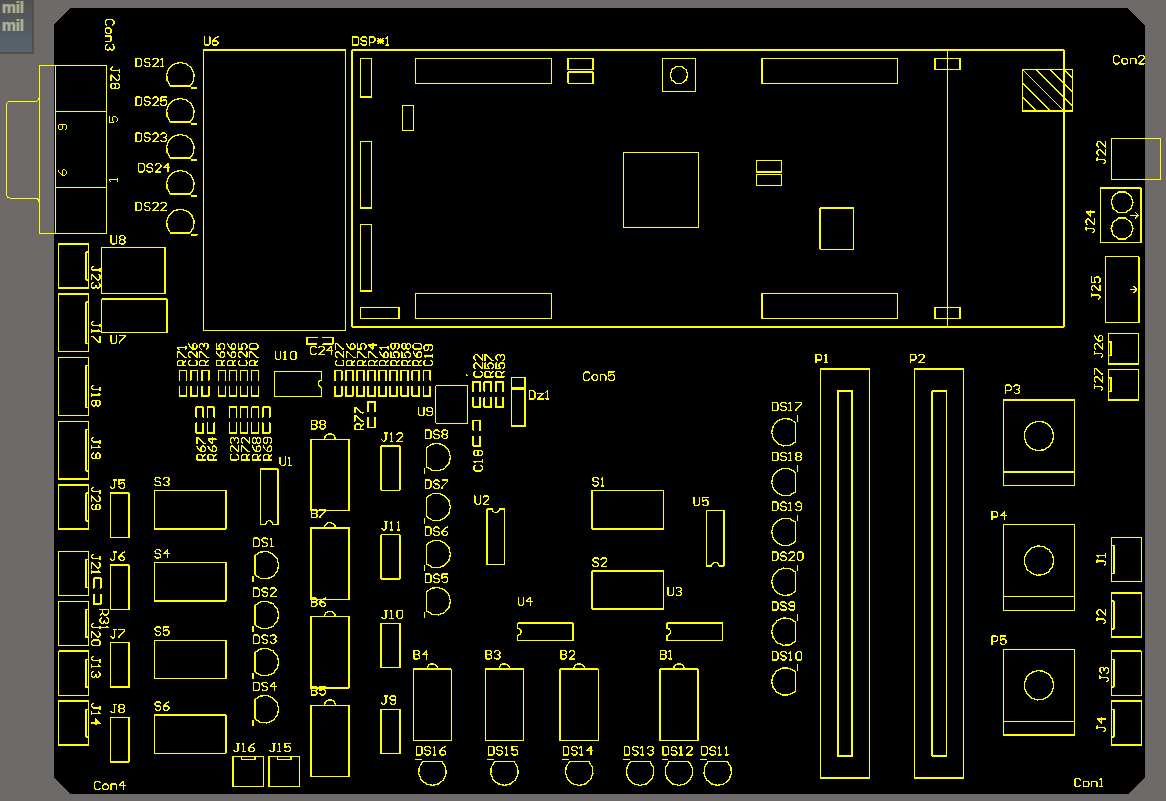
Interface board/ComponentArrangment.PNG
