NicolaiFransen/SemesterProjectPED2/Interface board/Lab components/Capacitors.jpg

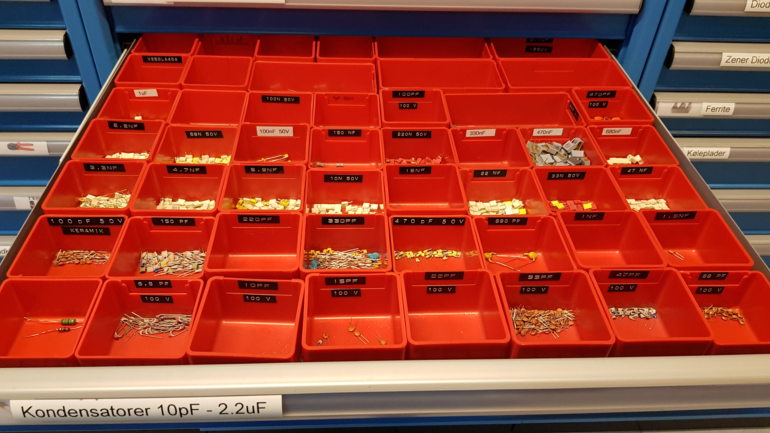
Interface board/Lab components/Capacitors.jpg
