NicolaiFransen/SemesterProjectPED2/Interface board/Lab components/Encoder connections/2019-02-27 14.58.31.jpg

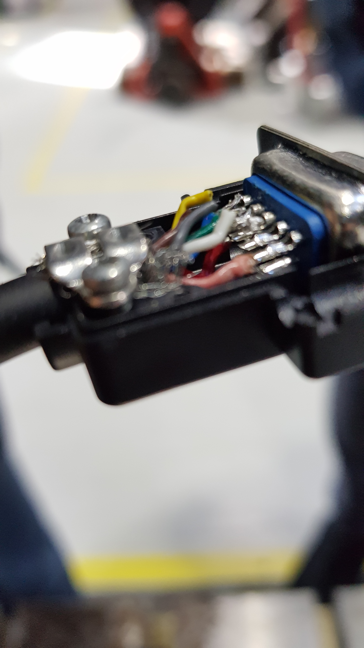
Interface board/Lab components/Encoder connections/2019-02-27 14.58.31.jpg
