NicolaiFransen/SemesterProjectPED2/Interface board/Lab components/Encoder connections/2019-02-27 14.59.47.jpg

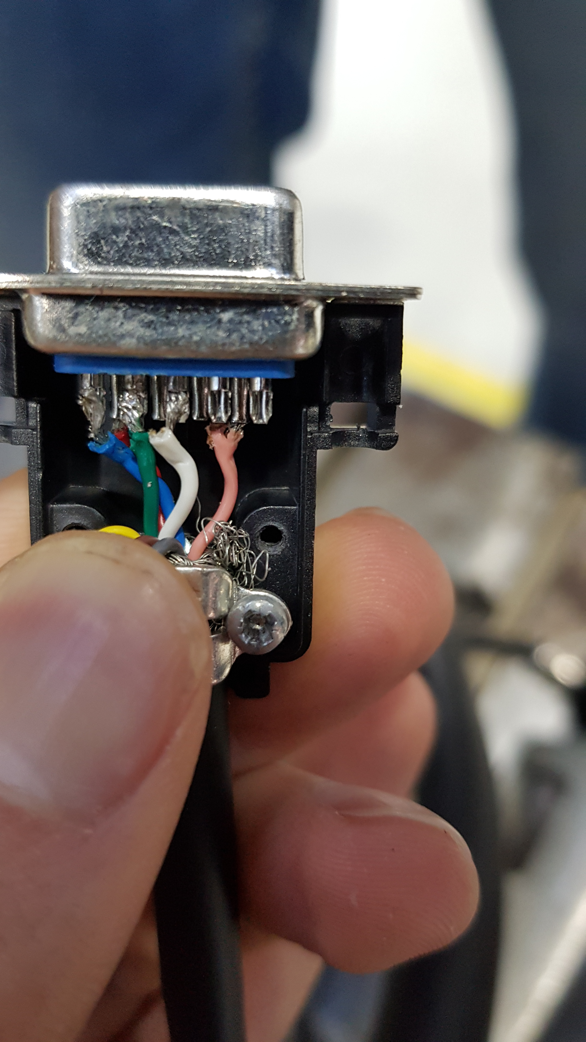
Interface board/Lab components/Encoder connections/2019-02-27 14.59.47.jpg
