NicolaiFransen/SemesterProjectPED2/Interface board/Lab components/Encoder connections/2019-02-27 15.01.39.jpg

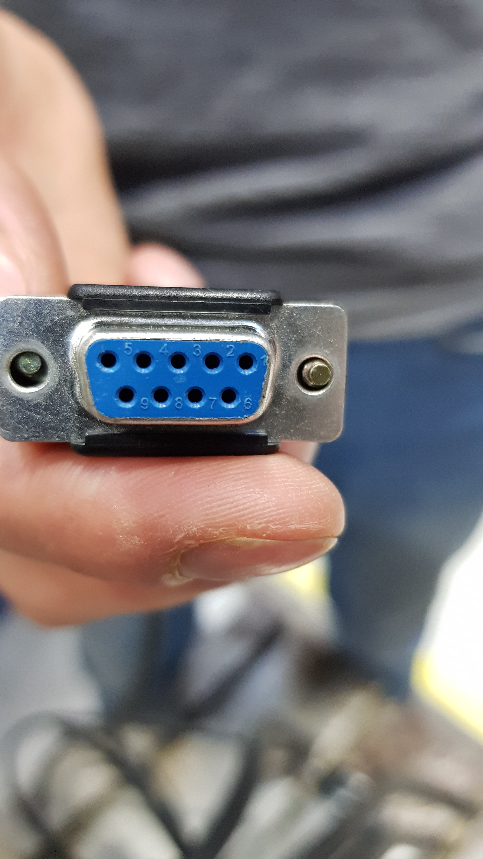
Interface board/Lab components/Encoder connections/2019-02-27 15.01.39.jpg
