NicolaiFransen/SemesterProjectPED2/Interface board/Lab components/Encoder connections/Encoder connections.jpg

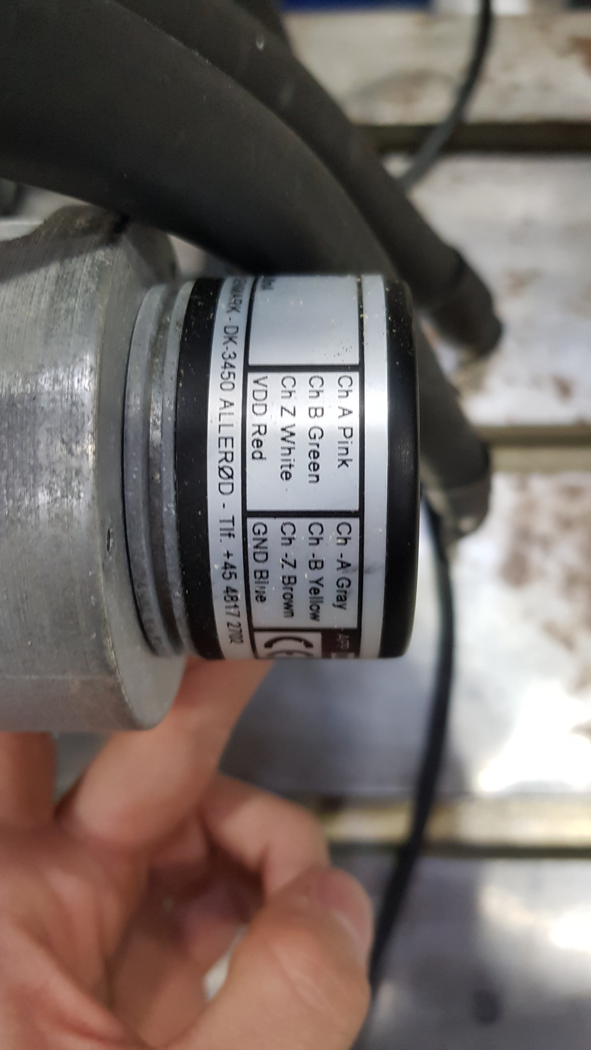
Interface board/Lab components/Encoder connections/Encoder connections.jpg
