NicolaiFransen/SemesterProjectPED2/Interface board/Lab components/Encoder connections/Encoder data.jpg

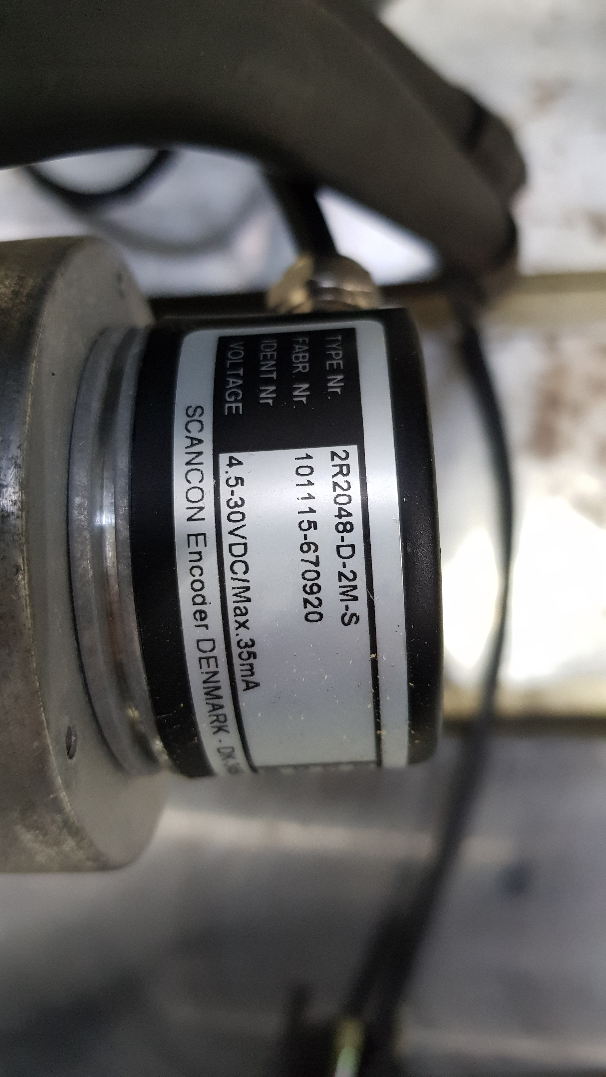
Interface board/Lab components/Encoder connections/Encoder data.jpg
