NicolaiFransen/SemesterProjectPED2/Interface board/Lab components/Resistors.jpg

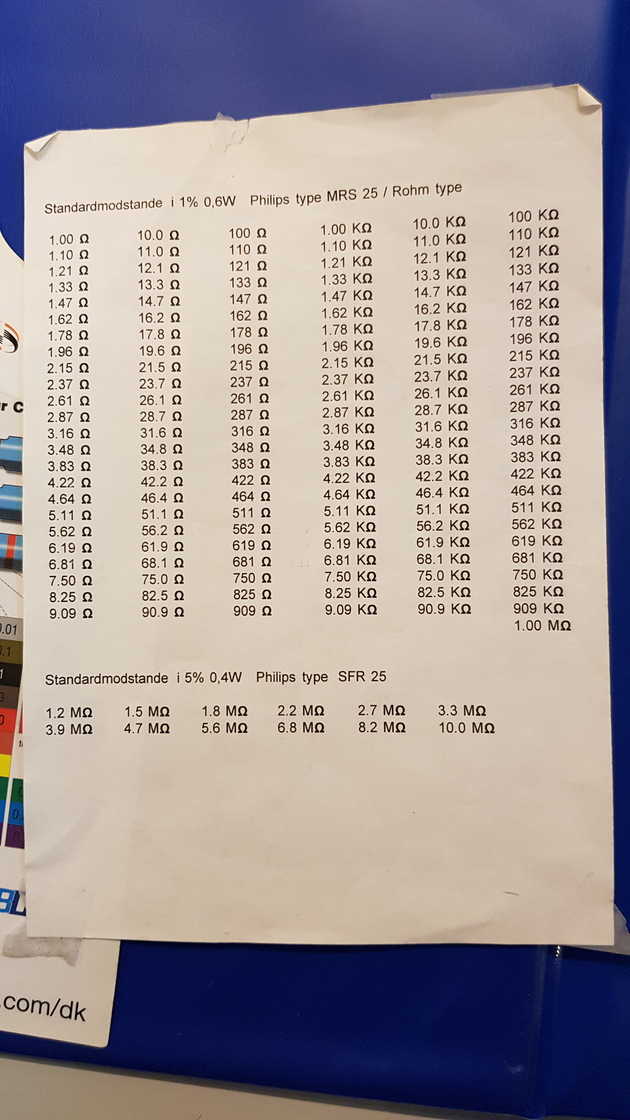
Interface board/Lab components/Resistors.jpg
