NicolaiFransen/SemesterProjectPED2/Driver/PCB/Gate_drive.FCStd

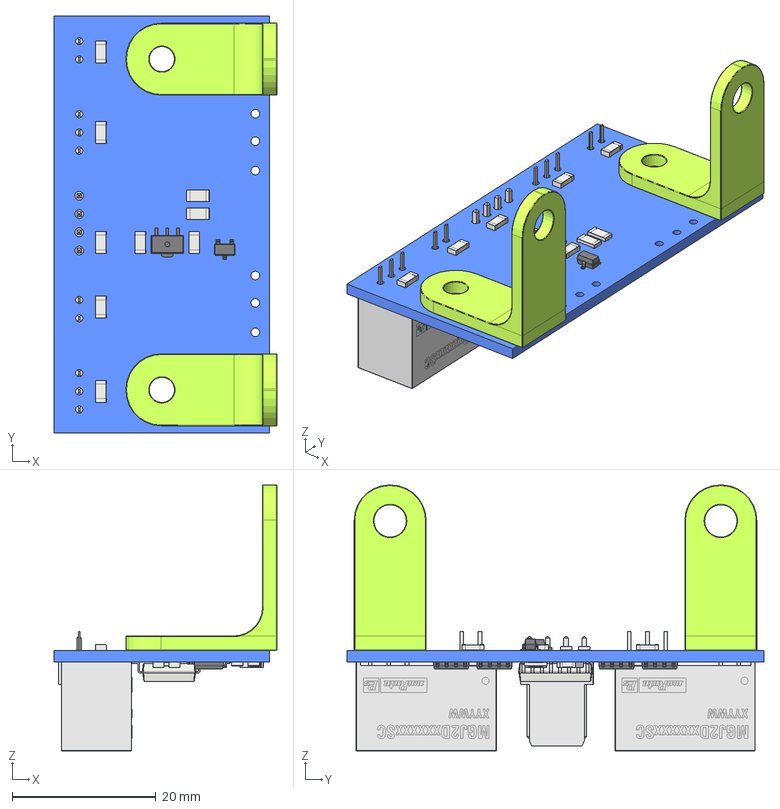
[picture p205: CAD file, 2019-02-12]
Driver/PCB/Gate_drive.FCStd
31.0 x 58.0 x 37.0 mm
Pcb
R_1206_
R_1206_001
SOT_23_
C_1206_001
C_1206_002
C_1206_003
C_1206_004
C_1206_005
C_1206_012
C_1206_017
SOT_89_3_
Molex_KK-6410-04_04x2.54mm_Straight_
C_1206_
C_1206_006
C_1206_007
C_1206_008
C_1206_009
C_1206_010
C_1206_011
C_1206_013
C_1206_014
C_1206_015
C_1206_016
SOT_669_LFPAK_
SOT_669_LFPAK_001
SOT_669_LFPAK_002
SOT_669_LFPAK_003
R_1206_002
R_1206_003
R_1206_004
R_1206_005
SOIC-16W_7.5x10.3mm_Pitch1.27mm_
mps_dcdc_mgj2d_sc_a_
mps_dcdc_mgj2d_sc_a_001
