NicolaiFransen/SemesterProjectPED2/Inverter/2019_03_23_Inverter3DCase/ButtonLeft4.stl

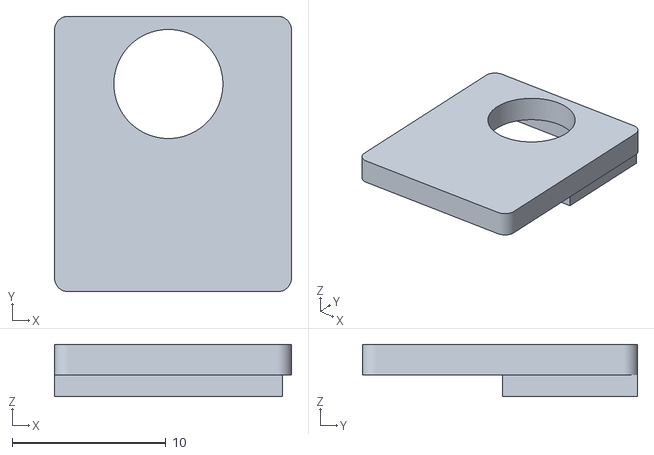
[picture p206: CAD file, 2019-04-25]
Inverter/2019_03_23_Inverter3DCase/ButtonLeft4.stl
15.4 x 17.9 x 3.40
