NicolaiFransen/SemesterProjectPED2/Simulations/2018_Semester Project/Appendix/Datasheets/Heatsink/Heatsink_mouting.FCStd

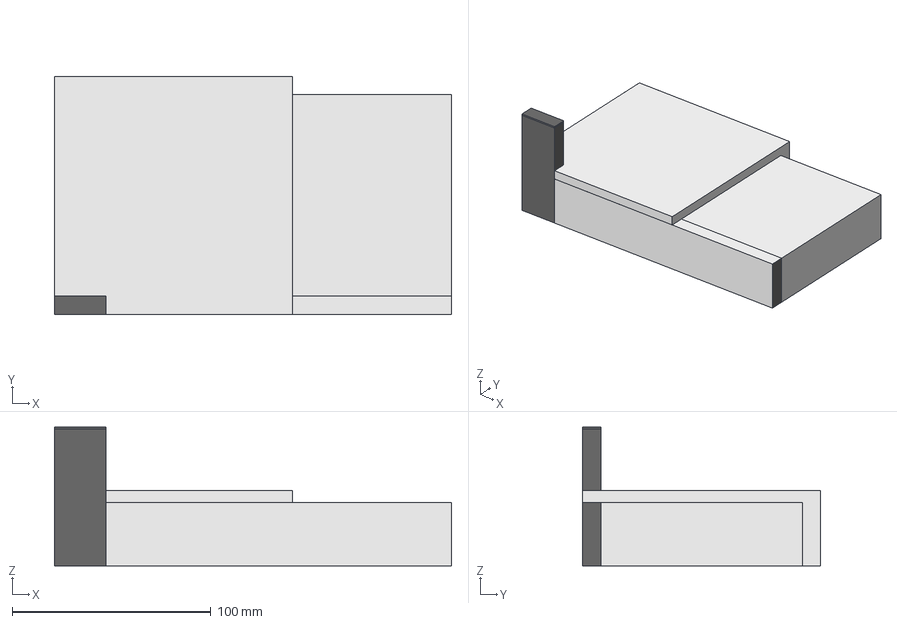
[picture p207: CAD file, 2019-02-12]
Simulations/2018_Semester Project/Appendix/Datasheets/Heatsink/Heatsink_mouting.FCStd
200.0 x 120.0 x 70.0 mm
