NicolaiFransen/SemesterProjectPED2/Simulations/2018_Semester Project/Appendix/KiCad/Inverter/Inverter.FCStd

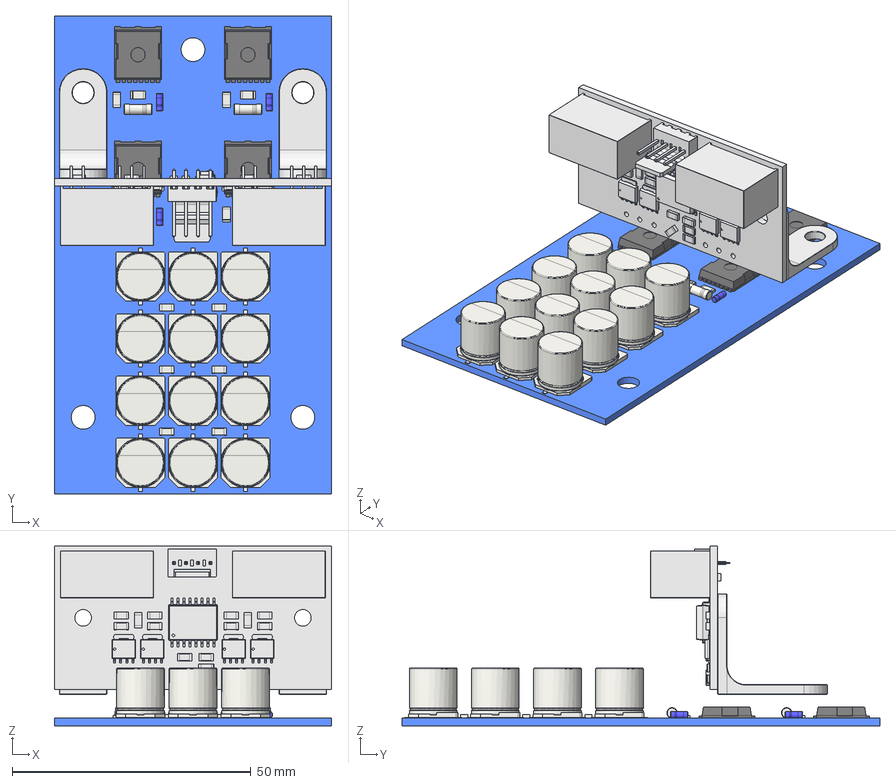
[picture p209: CAD file, 2019-02-12]
Simulations/2018_Semester Project/Appendix/KiCad/Inverter/Inverter.FCStd
58.0 x 100.0 x 37.6 mm
Pcb
CP_Elec_10x10.5_
CP_Elec_10x10.5_001
CP_Elec_10x10.5_002
CP_Elec_10x10.5_003
CP_Elec_10x10.5_004
CP_Elec_10x10.5_005
CP_Elec_10x10.5_006
CP_Elec_10x10.5_007
CP_Elec_10x10.5_008
CP_Elec_10x10.5_009
CP_Elec_10x10.5_010
CP_Elec_10x10.5_011
D_MELF_Standard_
D_MELF_Standard_001
D_MiniMELF_Standard_
D_MiniMELF_Standard_001
D_MELF_Standard_002
D_MELF_Standard_003
D_MiniMELF_Standard_002
D_MiniMELF_Standard_003
R_1206_
R_1206_001
R_1206_002
R_1206_003
R_1206_004
R_1206_005
R_1206_006
R_1206_007
C_1206_
C_1206_001
C_1206_002
C_1206_003
C_1206_004
C_1206_005
Infineon_PG_HSOF_8_1_
Infineon_PG_HSOF_8_1_001
Infineon_PG_HSOF_8_1_002
Infineon_PG_HSOF_8_1_003
Gate_drive_cp_
