NicolaiFransen/SemesterProjectPED2/Inverter/2019_03_23_Inverter3DCase/SwitchRight1.stl

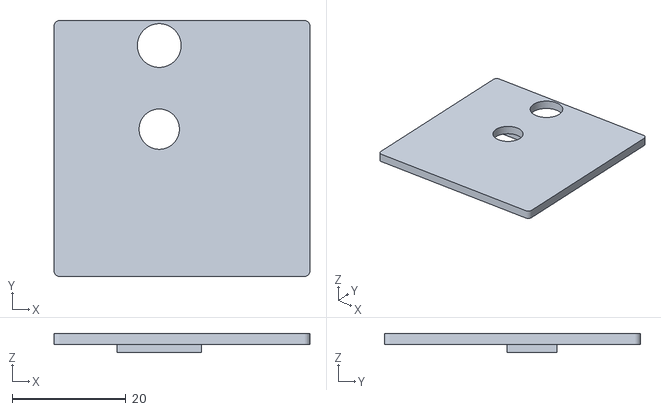
[picture p210: CAD file, 2019-04-25]
Inverter/2019_03_23_Inverter3DCase/SwitchRight1.stl
45.0 x 45.0 x 3.40
