NicolaiFransen/SemesterProjectPED2/Simulations/2018_Semester Project/Appendix/KiCad/current_meas/current_meas.FCStd

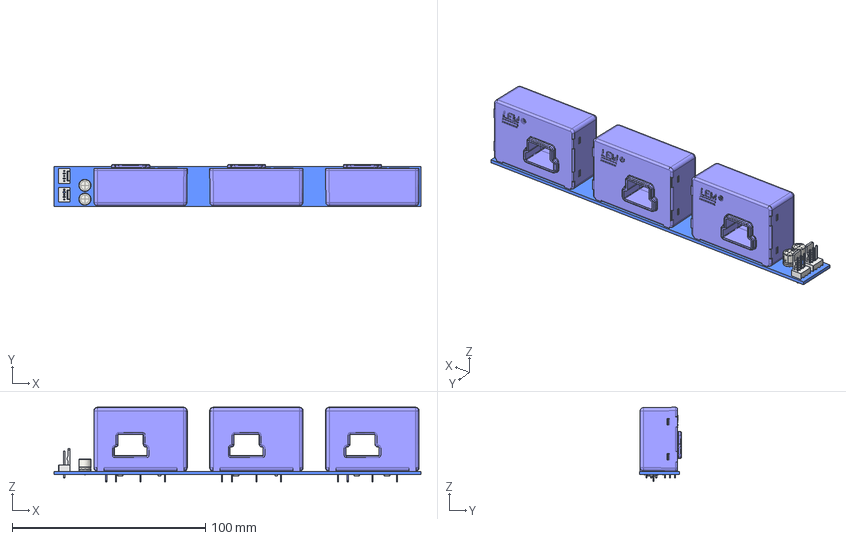
[picture p211: CAD file, 2019-02-12]
Simulations/2018_Semester Project/Appendix/KiCad/current_meas/current_meas.FCStd
190.0 x 21.7 x 38.6 mm
Pcb
CP_Radial_D63mm_P250mm_
Molex_KK-6410-03_03x2.54mm_Straight_
Molex_KK-6410-03_03x2.54mm_Straight_001
CP_Radial_D63mm_P250mm_001
boitier.1
boitier.002
boitier.003
C_1206_
C_1206_001
C_1206_002
C_1206_003
C_1206_004
C_1206_005
