NicolaiFransen/SemesterProjectPED2/Inverter/2019_03_23_Inverter3DCase/ButtonRight1.stl

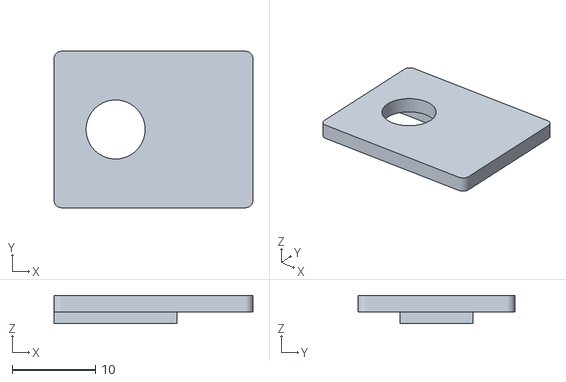
[picture p212: CAD file, 2019-04-25]
Inverter/2019_03_23_Inverter3DCase/ButtonRight1.stl
23.9 x 18.8 x 3.40
