NicolaiFransen/SemesterProjectPED2/Inverter/2019_03_23_Inverter3DCase/ButtonMiddle3.stl

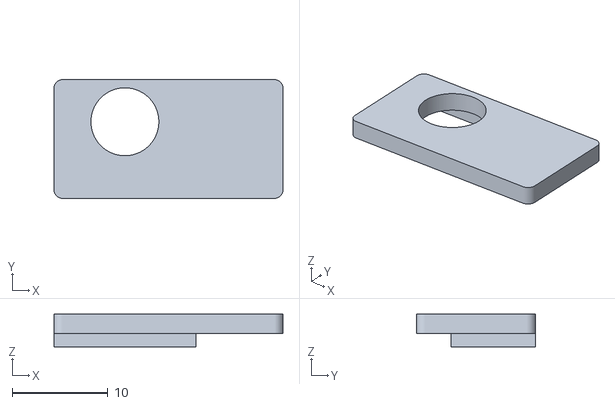
[picture p213: CAD file, 2019-04-25]
Inverter/2019_03_23_Inverter3DCase/ButtonMiddle3.stl
23.9 x 12.4 x 3.40
