NicolaiFransen/SemesterProjectPED2/Inverter/2019_03_23_Inverter3DCase/InverterCaseTop1.stl

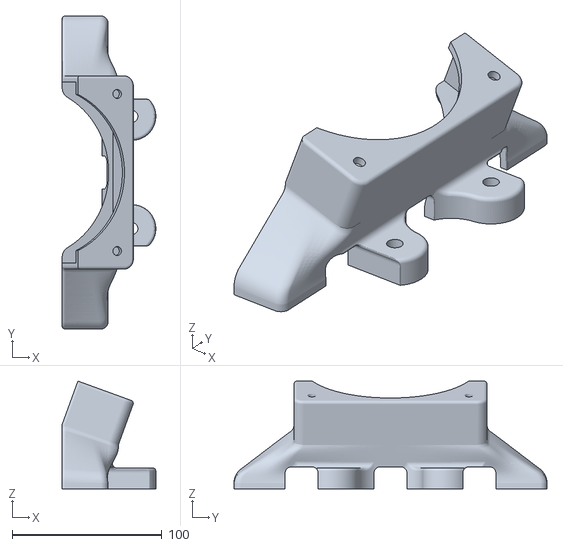
[picture p214: CAD file, 2019-03-29]
Inverter/2019_03_23_Inverter3DCase/InverterCaseTop1.stl
62.6 x 209.2 x 72.1
