NicolaiFransen/SemesterProjectPED2/Simulations/2018_Semester Project/Appendix/KiCad/Inverter/Gerber/OLD/Inverter-Edge.Cuts.dxf

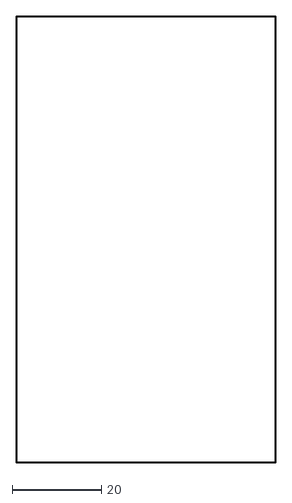
[picture p215: CAD file, 2019-02-12, an earlier design]
Simulations/2018_Semester Project/Appendix/KiCad/Inverter/Gerber/OLD/Inverter-Edge.Cuts.dxf
58.2 x 100.2
