NicolaiFransen/SemesterProjectPED2/Simulations/2018_Semester Project/Appendix/KiCad/Inverter/Gerber/OLD/Inverter-F.Cu.dxf

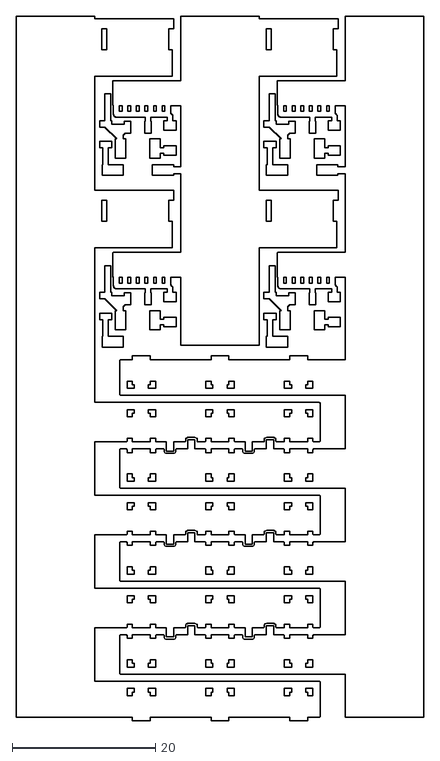
[picture p216: CAD file, 2019-02-12, an earlier design]
Simulations/2018_Semester Project/Appendix/KiCad/Inverter/Gerber/OLD/Inverter-F.Cu.dxf
57.0 x 98.5
