NicolaiFransen/SemesterProjectPED2/Simulations/2018_Semester Project/Appendix/KiCad/Inverter/Gerber/OLD/Inverter-F.Fab.dxf

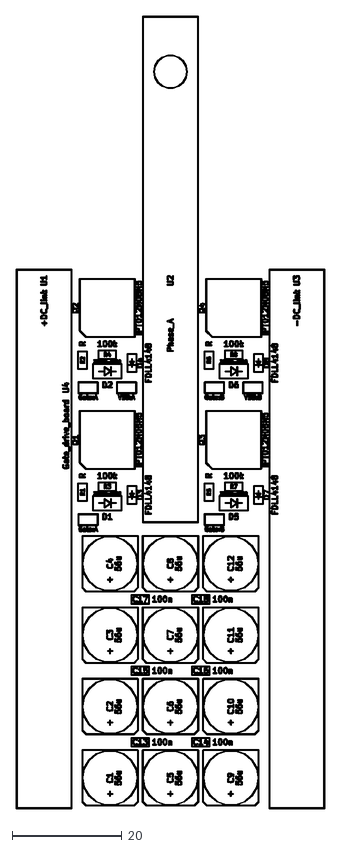
[picture p217: CAD file, 2019-02-12, an earlier design]
Simulations/2018_Semester Project/Appendix/KiCad/Inverter/Gerber/OLD/Inverter-F.Fab.dxf
56.2 x 144.2
