NicolaiFransen/SemesterProjectPED2/Simulations/2018_Semester Project/Appendix/KiCad/Inverter/Gerber/OLD/Inverter-drl_map.dxf

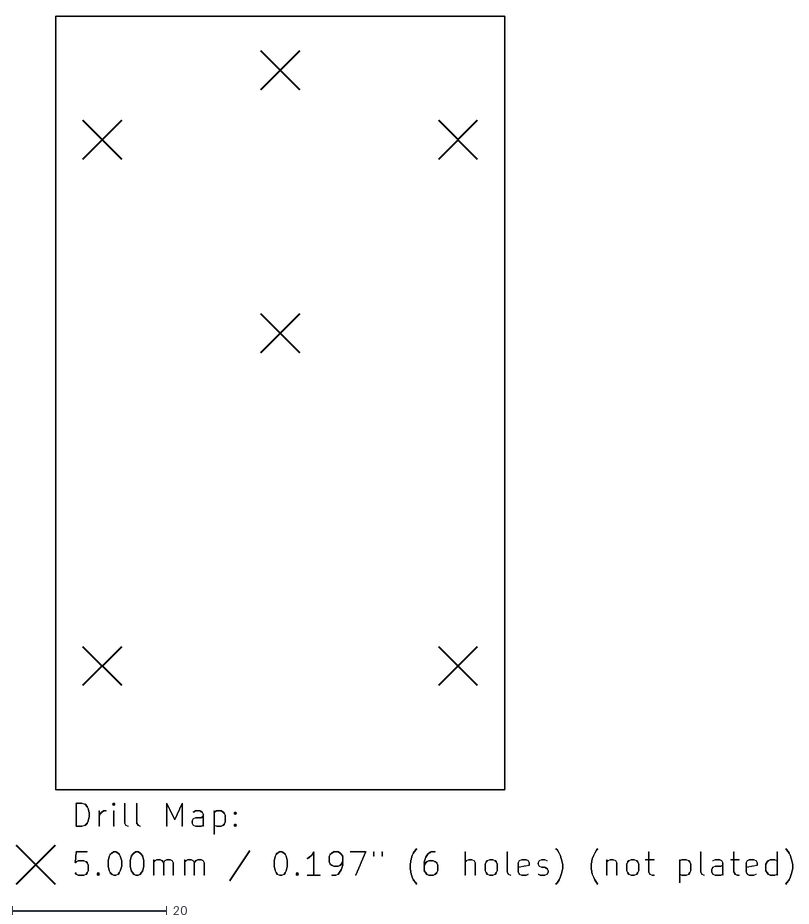
[picture p218: CAD file, 2019-02-12, an earlier design]
Simulations/2018_Semester Project/Appendix/KiCad/Inverter/Gerber/OLD/Inverter-drl_map.dxf
100.3 x 112.2
