NicolaiFransen/SemesterProjectPED2/(list of files, cad)

Other CAD files:
Inverter/2019_03_23_Inverter3DCase/SwitchLeft4.stl
Simulations/2018_Semester Project/Appendix/KiCad/Inverter/Gerber/OLD/Inverter-F.Paste.dxf
