NicolaiFransen/SemesterProjectPED2/Tests/Labsetup.pptx

## Go-kart motor

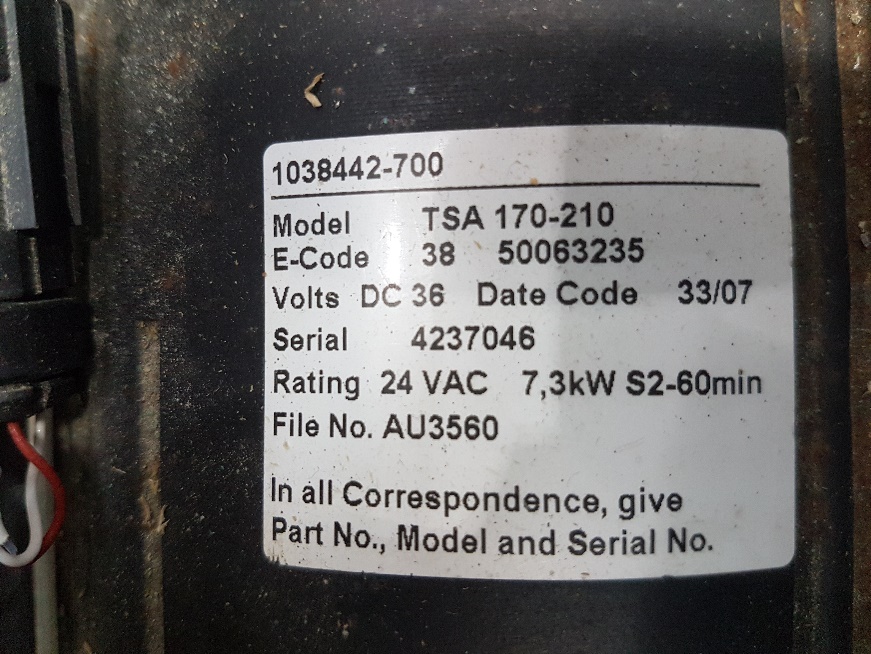
[picture p219: figure]
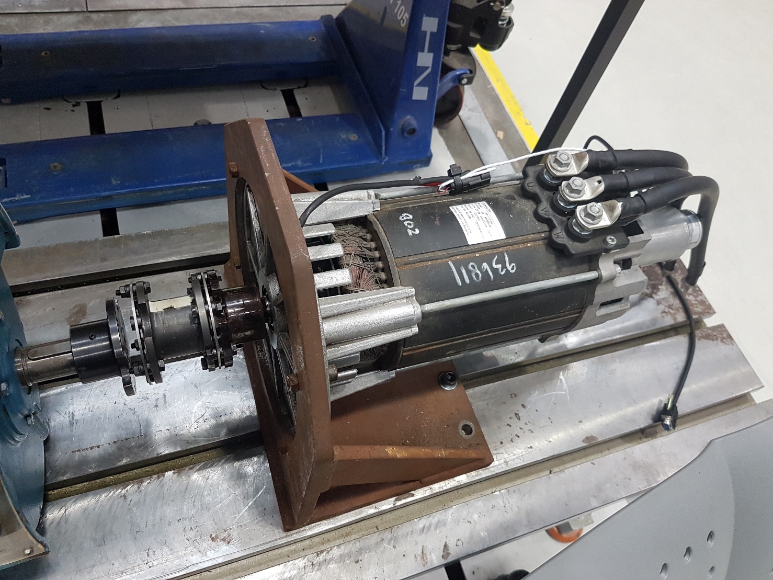
[picture p220: figure]
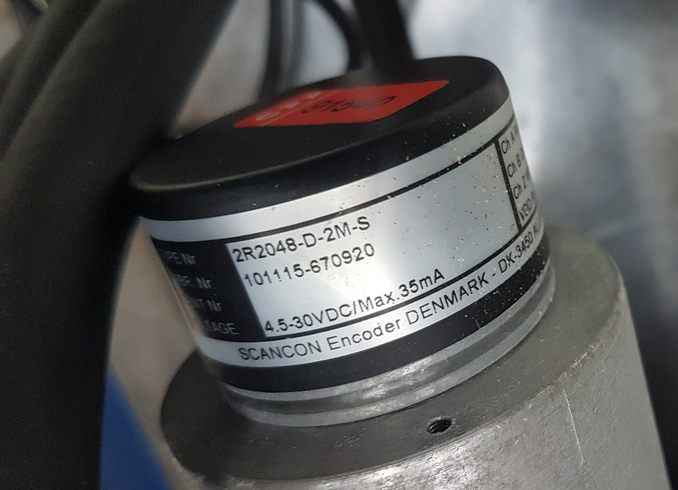
[picture p221: figure]

Encoder

## Load machine

- Thrige Odense LAT 160, compound - generator

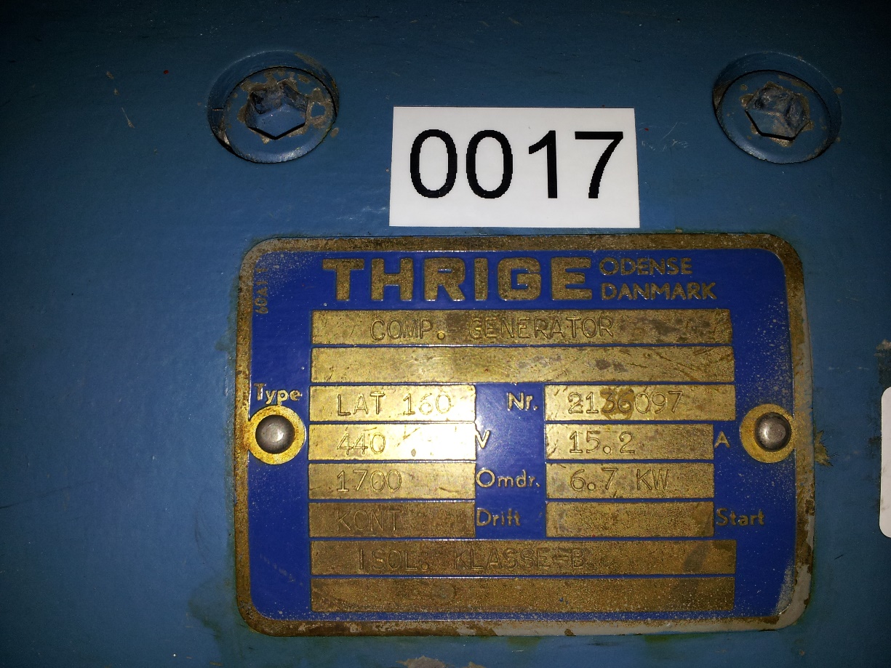
[picture p222: figure]
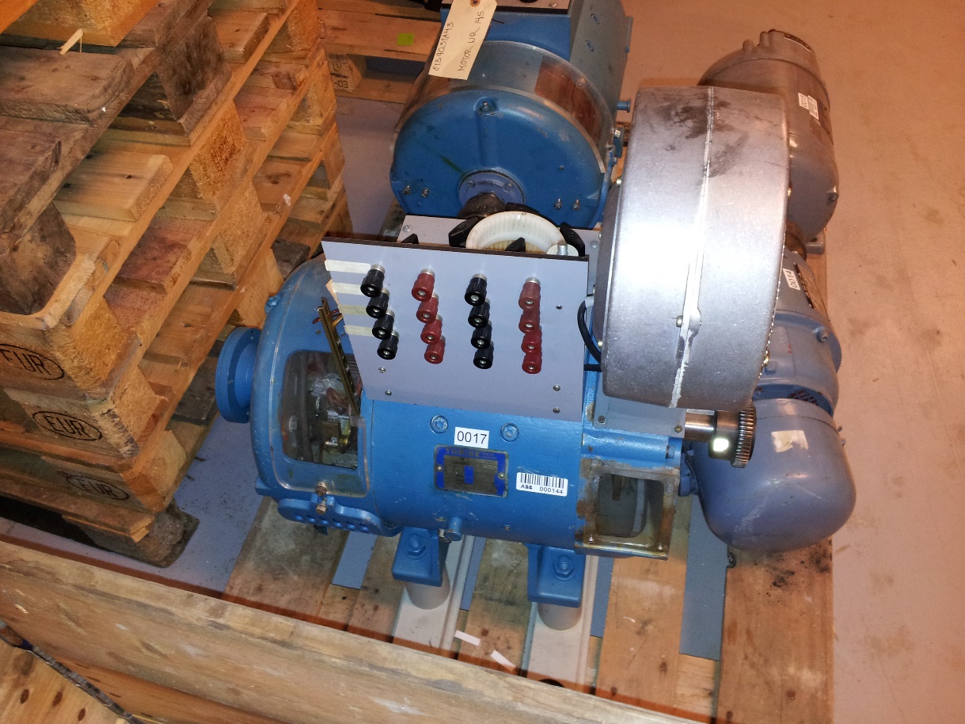
[picture p223: figure]

## Power supply

- Lambda EMI, ESS Power, 50 V-300 A

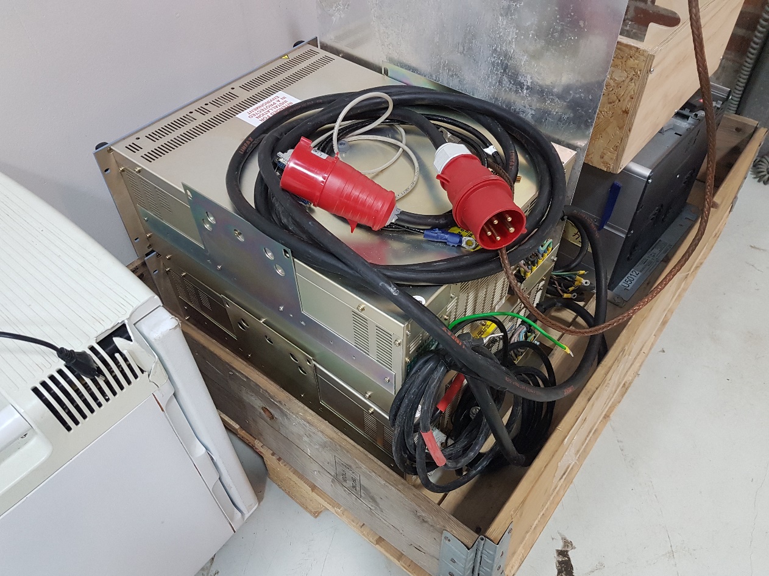
[picture p224: figure]
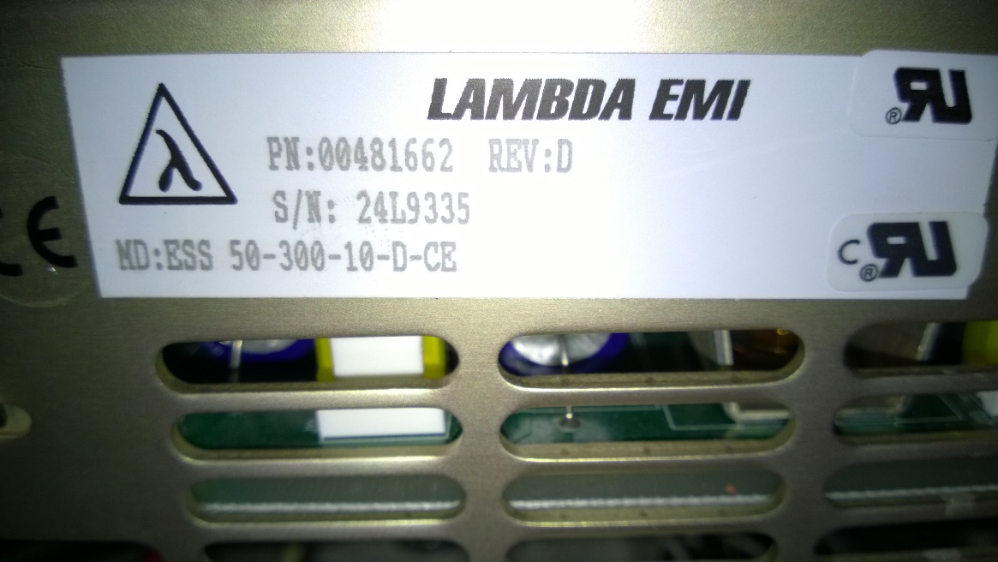
[picture p225: figure]

## Batteries

- Four 12 V – 55 Ah lead-acid

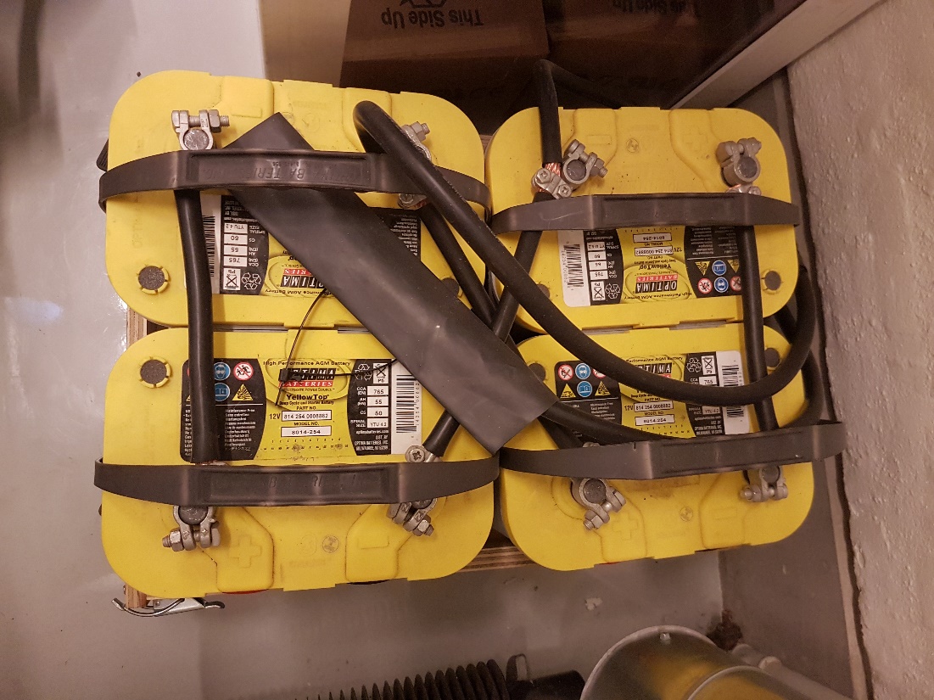
[picture p226: figure]

## Fans

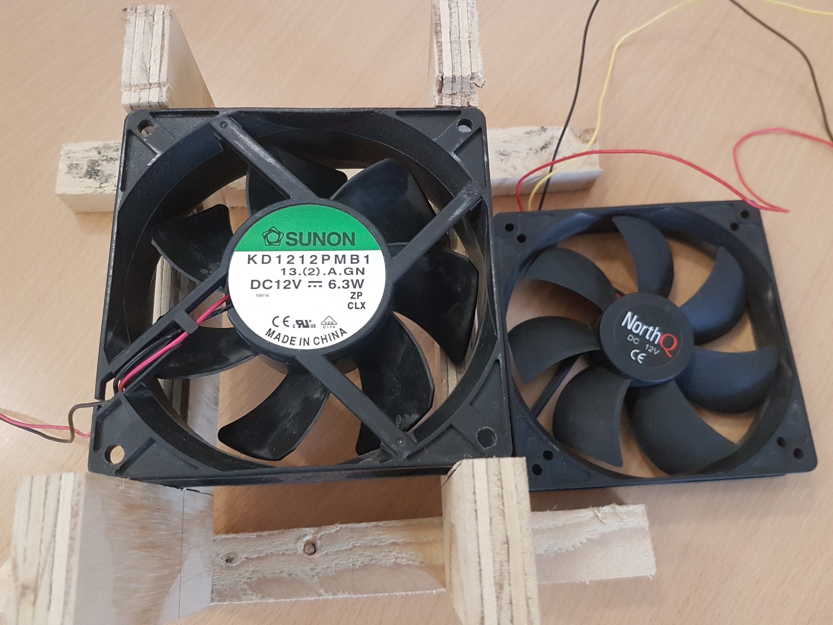
[picture p227: figure]
