NicolaiFransen/SemesterProjectPED2/Lectures/Electrical Drive Systems/Lecture 3 - Workshop PMSM/dSPACELab_instruction.pdf

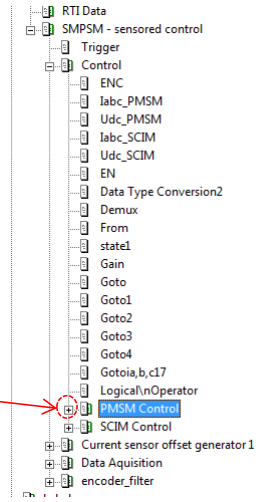
[picture p228: figure]
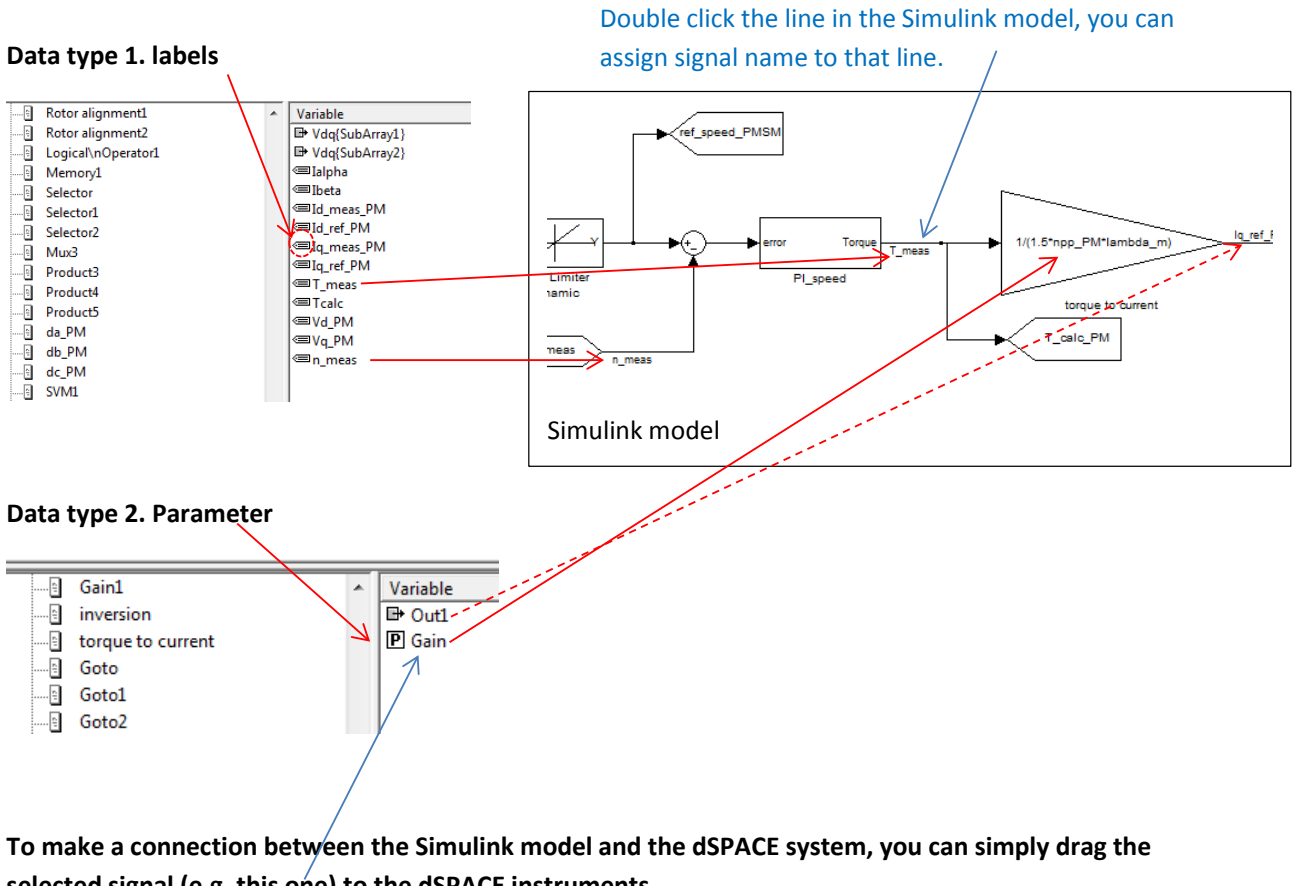
[picture p229: figure]
Data type 1. labels; Data type 2. Parameter; Simulink model; assign signal name to that line.

1

In the dSPACE interface, how to look for the signals you assigned in the Simulink model

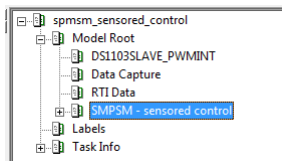
[picture p230: figure]

To make a connection between the Simulink model and the dSPACE system, you can simply drag the selected signal (e.g. this one) to the dSPACE instruments.

This symbol indicates it is a subsystem

Double click the line in the Simulink model, you can

2

Important notes

- It is very important to set the speed reference to be zero before clicking the start bottom!
- Load torque range : 0-14.6 Nm
- Speed range: -1400 – 1400 rpm.
- In Matlab, press ‘Ctrl + B’ you can build the Simulink model, to be used by dSPACE. Before doing this, be sure that you are in the same file folder which contains other dSPACE files.
- You may reload the complied new Simulink model in dSPACE here (‘reload variable description’, which refers to the SDF file – the same file name as the Simulink model but with .sdf as file extension).
You may right lick the ‘SDF’ file to check its properties – make sure the date and time information for this file is the correct one.

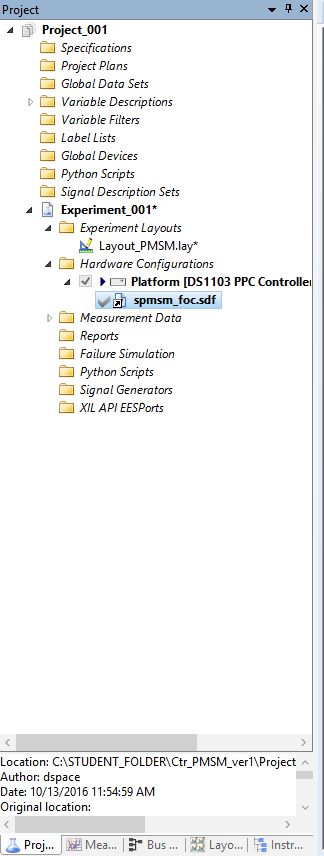
[picture p231: figure]
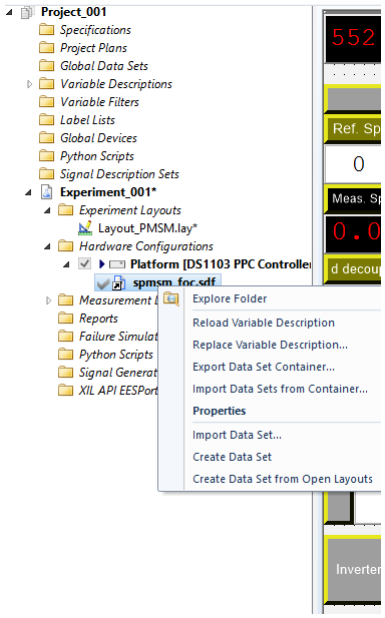
[picture p232: figure]
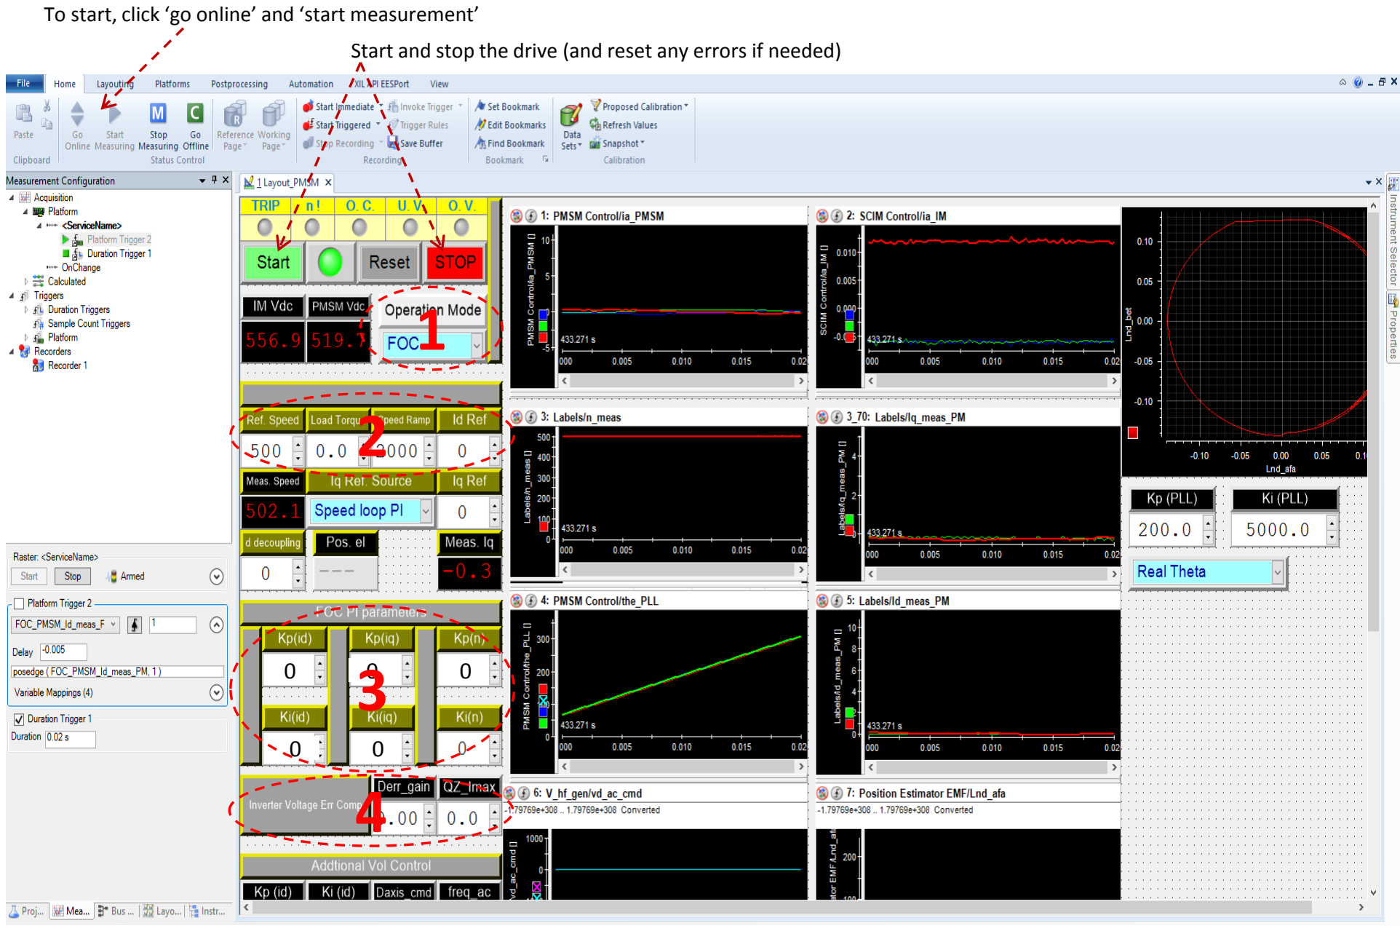
[picture p233: page 3]

To start, click ‘go online’ and ‘start measurement’ Start and stop the drive (and reset any errors if needed)

1
2
0 | 0 | 0
0 | 0

3

4

Select ‘Align Rotor’ or ‘FOC’ operation modes. You need to align the rotor and reset the encoder position the first time you load the model or after ‘reset’ any errors occurred.

1

2

Here you set the reference speed, load torque for normal FOC operation. For tuning the PI parameters of the d-axis current loop, you can toggle the id reference between 0 and e.g. 5 (A)

3

Here you set PI parameters for the id current loop, iq current loop and the speed loop (from left to right)

4

Here you can enable / disable inverter voltage error compensation (enable: Derr_gain = 1; disable: Derr_gain = 0). You can also set the minimum current value in ‘QZ_Imax’, below which the inverter voltage error compensation will be disabled.

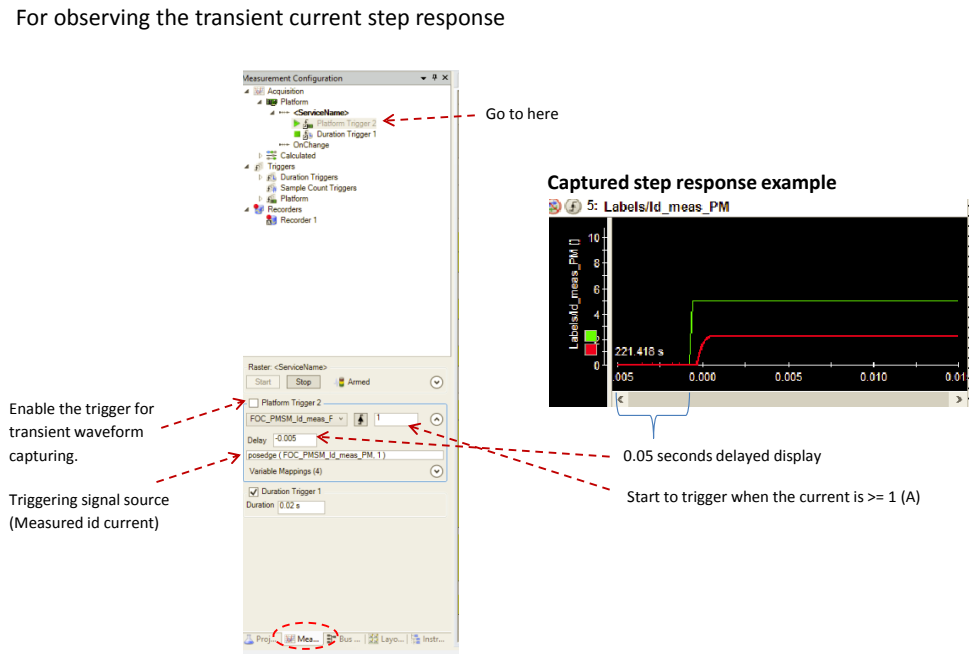
[picture p234: page 5]

For observing the transient current step response

Go to here

Captured step response example

Enable the trigger for
transient waveform
capturing.

0.05 seconds delayed display

Triggering signal source
(Measured id current)

Start to trigger when the current is >= 1 (A)

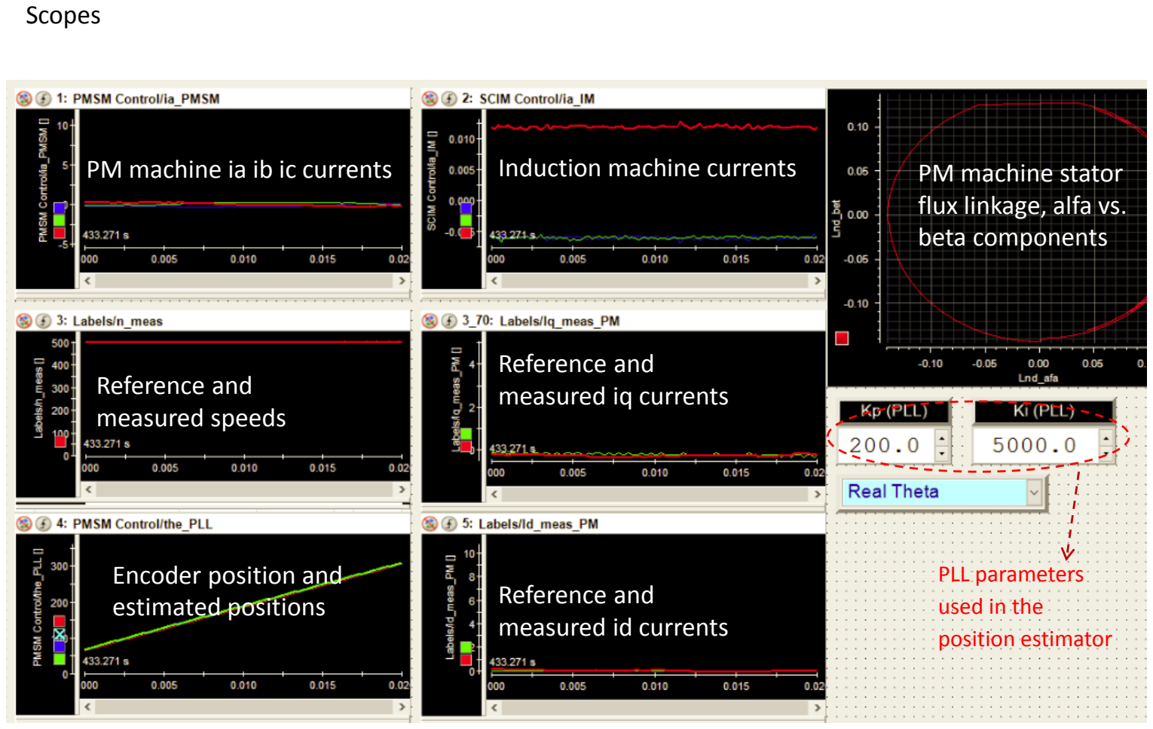
[picture p235: page 6]

PM machine ia ib ic currents | Induction machine currents | PM machine stator flux linkage, alfa vs. beta components

Reference and
measured speeds

Reference and
measured iq currents

Reference and
measured id currents

Encoder position and
estimated positions

PLL parameters
used in the
position estimator

Scopes
