NicolaiFransen/SemesterProjectPED2/Tests/20190524_Cruise_and_Torque_Tests/TorqueRefStep/ReferenceTorqueStep.txt

IQm,IDm,IDr,IQr;
31,149,149,31;40,146,149,31;32,149,149,31;31,133,149,31;28,150,149,31;40,146,149,31;29,148,149,31;31,149,149,31;28,151,149,31;40,149,149,31;30,148,149,31;29,153,149,31;29,149,149,31;29,149,149,31;29,152,149,31;30,148,149,31;40,150,149,31;31,150,149,31;36,147,149,31;31,149,149,31;29,146,149,31;39,153,149,31;37,147,149,31;30,149,149,31;31,149,149,31;35,156,149,31;37,149,149,31;31,147,149,31;21,155,149,31;32,149,149,31;34,148,149,31;30,149,149,31;30,146,149,31;36,150,149,31;27,149,149,31;28,148,149,31;31,149,149,31;35,143,149,31;30,150,149,31;39,146,149,31;35,150,149,31;29,150,149,31;26,136,149,31;33,150,149,31;29,149,149,31;37,150,149,31;32,149,149,31;33,148,149,31;30,147,149,31;29,164,149,31;33,152,149,31;33,148,149,31;30,149,149,31;31,149,149,31;35,162,149,31;30,151,149,31;28,145,149,31;24,147,149,31;34,149,149,31;31,148,149,31;36,148,149,31;30,148,149,31;39,144,149,31;31,149,149,31;33,147,149,31;29,149,149,31;29,145,149,31;19,151,149,31;31,148,149,31;27,150,149,31;30,150,149,31;25,141,149,31;32,151,149,31;29,148,149,31;33,150,149,31;30,149,149,31;30,149,149,31;29,151,149,31;31,144,149,31;31,151,149,31;31,148,149,31;33,148,149,31;31,148,149,31;27,166,149,31;34,160,149,31;35,149,149,34;34,149,149,38;41,149,149,41;44,153,149,44;49,148,149,47;47,147,149,50;60,147,149,54;64,142,149,57;66,145,149,60;62,150,149,63;68,150,149,66;62,147,149,69;70,147,149,73;83,145,149,76;78,149,149,79;83,148,149,82;85,148,149,85;95,148,149,89;93,149,149,92;92,144,149,95;99,145,149,95;94,152,149,95;92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
