NicolaiFransen/SemesterProjectPED2/Tests/20190524_Cruise_and_Torque_Tests/_UART/Torque/ReferenceTorqueStep.txt

qr 31
qm 31
dm 149
dr 149
qr 31
qm 40
dm 146
dr 149
qr 31
qm 32
dm 149
dr 149
qr 31
qm 31
dm 133
dr 149
qr 31
qm 28
dm 150
dr 149
qr 31
qm 40
dm 146
dr 149
qr 31
qm 29
dm 148
dr 149
qr 31
qm 31
dm 149
dr 149
qr 31
qm 28
dm 151
dr 149
qr 31
qm 40
dm 149
dr 149
qr 31
qm 30
dm 148
dr 149
qr 31
qm 29
dm 153
dr 149
qr 31
qm 29
dm 149
dr 149
qr 31
qm 29
dm 149
dr 149
qr 31
qm 29
dm 152
dr 149
qr 31
qm 30
dm 148
dr 149
qr 31
qm 40
dm 150
dr 149
qr 31
qm 31
dm 150
dr 149
qr 31
qm 36
dm 147
dr 149
qr 31
qm 31
dm 149
dr 149
qr 31
qm 29
dm 146
dr 149
qr 31
qm 39
dm 153
dr 149
qr 31
qm 37
dm 147
dr 149
qr 31
qm 30
dm 149
dr 149
qr 31
qm 31
dm 149
dr 149
qr 31
qm 35
dm 156
dr 149
qr 31
qm 37
dm 149
dr 149
qr 31
qm 31
dm 147
dr 149
qr 31
qm 21
dm 155
dr 149
qr 31
qm 32
dm 149
dr 149
qr 31
qm 34
dm 148
dr 149
qr 31
qm 30
dm 149
dr 149
qr 31
qm 30
dm 146
dr 149
qr 31
qm 36
dm 150
dr 149
qr 31
qm 27
dm 149
dr 149
qr 31
qm 28
dm 148
dr 149
qr 31
qm 31
dm 149
dr 149
qr 31
qm 35
dm 143
dr 149
qr 31
qm 30
dm 150
dr 149
qr 31
qm 39
dm 146
dr 149
qr 31
qm 35
dm 150
dr 149
qr 31
qm 29
dm 150
dr 149
qr 31
qm 26
dm 136
dr 149
qr 31
qm 33
dm 150
dr 149
qr 31
qm 29
dm 149
dr 149
qr 31
qm 37
dm 150
dr 149
qr 31
qm 32
dm 149
dr 149
qr 31
qm 33
dm 148
dr 149
qr 31
qm 30
dm 147
dr 149
qr 31
qm 29
dm 164
dr 149
qr 31
qm 33
dm 152
dr 149
qr 31
qm 33
dm 148
dr 149
qr 31
qm 30
dm 149
dr 149
qr 31
qm 31
dm 149
dr 149
qr 31
qm 35
dm 162
dr 149
qr 31
qm 30
dm 151
dr 149
qr 31
qm 28
dm 145
dr 149
qr 31
qm 24
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
qr 31
qm 31
dm 149
dr 149
qr 31
qm 37
dm 147
dr 149
qr 31
qm 31
dm 149
dr 149
qr 31
qm 34
dm 142
dr 149
qr 31
qm 33
dm 150
dr 149
qr 31
qm 38
dm 147
dr 149
qr 31
qm 30
dm 147
dr 149
qr 31
qm 24
dm 147
dr 149
qr 31
qm 32
dm 147
dr 149
qr 31
qm 30
dm 150
dr 149
qr 31
qm 33
dm 148
dr 149
qr 31
qm
