NicolaiFransen/SemesterProjectPED2/Tests/20190524_Cruise_and_Torque_Tests/CruiseLoadStep/cruise_control_load_step_v1.csv

#,Torque(N·m),Speed(1/min),Power(kW),
0,7.43,299,0.233 | 1,7.26,300,0.228 | 2,6.85,299,0.214 | 3,7.56,299,0.237 | 4,6.96,299,0.218 | 5,7.03,299,0.220 | 6,7.53,299,0.236 | 7,6.70,299,0.210 | 8,7.25,299,0.227 | 9,7.17,299,0.224 | 10,7.07,299,0.221 | 11,7.11,299,0.223 | 12,7.21,299,0.225 | 13,7.28,298,0.227 | 14,7.21,299,0.225 | 15,7.07,298,0.221 | 16,7.30,299,0.228 | 17,7.04,299,0.220 | 18,6.77,298,0.211 | 19,7.41,298,0.231 | 20,6.78,298,0.212 | 21,7.00,298,0.218 | 22,7.25,298,0.226 | 23,6.87,298,0.214 | 24,7.17,298,0.223 | 25,7.01,298,0.219 | 26,7.11,298,0.222 | 27,7.06,298,0.220 | 28,6.66,298,0.207 | 29,7.16,298,0.223 | 30,6.75,298,0.210 | 31,6.57,298,0.205 | 32,7.41,298,0.231 | 33,6.65,298,0.208 | 34,7.16,298,0.223 | 35,7.34,299,0.230 | 36,6.95,298,0.217 | 37,7.34,299,0.229 | 38,7.08,299,0.221 | 39,7.16,298,0.224 | 40,7.14,299,0.223 | 41,6.80,298,0.213 | 42,7.36,298,0.230 | 43,6.97,298,0.218 | 44,6.95,298,0.217 | 45,7.64,298,0.239 | 46,6.81,298,0.212 | 47,7.30,298,0.228 | 48,7.18,298,0.224 | 49,7.00,297,0.218 | 50,7.17,298,0.224 | 51,7.14,298,0.222 | 52,7.34,297,0.228 | 53,7.18,298,0.224 | 54,7.12,297,0.222 | 55,7.34,297,0.228 | 56,7.05,298,0.220 | 57,6.85,297,0.213 | 58,7.34,298,0.229 | 59,6.78,298,0.211
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
