NicolaiFransen/SemesterProjectPED2/Tests/20190524_Cruise_and_Torque_Tests/TorqueLoadStep/tek0007.csv

TIME | CH2 | CH3 | CH4;
-2.0000e+00 | -168 | 110 | 50;-1.9996e+00 | -164 | 106 | 62;-1.9992e+00 | -164 | 98 | 62;-1.9988e+00 | -168 | 98 | 70;-1.9984e+00 | -172 | 94 | 70;-1.9980e+00 | -172 | 90 | 74;-1.9976e+00 | -168 | 86 | 78;-1.9972e+00 | -164 | 82 | 78;-1.9968e+00 | -164 | 78 | 82;-1.9964e+00 | -160 | 74 | 82;-1.9960e+00 | -160 | 70 | 86;-1.9956e+00 | -152 | 66 | 86;-1.9952e+00 | -152 | 66 | 86;-1.9948e+00 | -156 | 62 | 90;-1.9944e+00 | -156 | 58 | 94;-1.9940e+00 | -156 | 58 | 94;-1.9936e+00 | -156 | 54 | 98;-1.9932e+00 | -152 | 50 | 102;-1.9928e+00 | -160 | 46 | 106;-1.9924e+00 | -152 | 42
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
