NicolaiFransen/SemesterProjectPED2/Tests/20190524_Cruise_and_Torque_Tests/TorqueLoadStep/Torque_load_step.csv

#,Torque(N·m),Speed(1/min),Power(kW),
0,3.19,178,0.059 | 1,4.71,179,0.088 | 2,4.52,178,0.084 | 3,4.30,178,0.080 | 4,4.88,178,0.091 | 5,4.51,178,0.084 | 6,4.60,178,0.086 | 7,5.06,178,0.094 | 8,4.71,178,0.088 | 9,4.42,178,0.082 | 10,5.03,178,0.094 | 11,4.42,178,0.082 | 12,5.00,178,0.093 | 13,5.08,178,0.095 | 14,4.25,178,0.079 | 15,4.96,178,0.092 | 16,4.45,178,0.083 | 17,4.72,178,0.088 | 18,5.02,178,0.093 | 19,4.50,178,0.084 | 20,4.56,178,0.085 | 21,4.74,177,0.088 | 22,4.47,178,0.083 | 23,4.96,177,0.092 | 24,4.84,178,0.090 | 25,4.29,178,0.080 | 26,4.90,178,0.091 | 27,4.45,178,0.083 | 28,4.78,178,0.089 | 29,5.05,178,0.094 | 30,4.45,178,0.083 | 31,4.74,178,0.088 | 32,4.62,178,0.086 | 33,4.61,178,0.086 | 34,4.93,178,0.092 | 35,4.65,178,0.086 | 36,4.26,178,0.079 | 37,4.69,178,0.087 | 38,4.30,178,0.080 | 39,4.72,178,0.088 | 40,4.90,178,0.091 | 41,4.18,178,0.078 | 42,4.78,178,0.089 | 43,4.43,178,0.082 | 44,4.67,178,0.087 | 45,5.17,178,0.096 | 46,4.65,178,0.087 | 47,4.64,178,0.087 | 48,4.88,178,0.091 | 49,4.52,178,0.084 | 50,4.99,178,0.093 | 51,5.02,178,0.094 | 52,4.17,178,0.078 | 53,5.04,178,0.094 | 54,4.29,178,0.080 | 55,4.81,178,0.090 | 56,5.16,178,0.096 | 57,4.42,178,0.083 | 58,4.79,178,0.090 | 59,4.73,178,0.088
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
