NicolaiFransen/SemesterProjectPED2/Tests/20190524_Cruise_and_Torque_Tests/TorqueRefStep/tek0003.csv

TIME | CH2 | CH3 | CH4;
-1.000e+00 | 160 | -70 | -86;-9.998e-01 | 160 | -70 | -86;-9.996e-01 | 160 | -66 | -86;-9.994e-01 | 160 | -66 | -86;-9.992e-01 | 156 | -66 | -90;-9.990e-01 | 160 | -66 | -90;-9.988e-01 | 160 | -66 | -86;-9.986e-01 | 160 | -62 | -86;-9.984e-01 | 160 | -62 | -90;-9.982e-01 | 156 | -66 | -90;-9.980e-01 | 156 | -62 | -86;-9.978e-01 | 152 | -66 | -90;-9.976e-01 | 160 | -62 | -90;-9.974e-01 | 156 | -62 | -90;-9.972e-01 | 156 | -62 | -90;-9.970e-01 | 152 | -62 | -86;-9.968e-01 | 156 | -66 | -90;-9.966e-01 | 156 | -66 | -86;-9.964e-01 | 152 | -58 | -90;-9.962e-01 | 156 | -58
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
