NicolaiFransen/SemesterProjectPED2/Tests/20190524_Cruise_and_Torque_Tests/TorqueRefStep/Torque_ref_step.csv

#,Torque(N·m),Speed(1/min),Power(kW),
0,5.26,55,0.030 | 1,5.19,55,0.030 | 2,5.07,55,0.029 | 3,5.06,55,0.029 | 4,5.07,56,0.029 | 5,5.09,56,0.030 | 6,5.18,56,0.030 | 7,5.10,56,0.030 | 8,4.60,56,0.027 | 9,4.61,56,0.027 | 10,4.65,55,0.027 | 11,4.77,55,0.027 | 12,5.21,55,0.030 | 13,5.18,55,0.030 | 14,5.14,55,0.029 | 15,5.14,55,0.030 | 16,5.17,55,0.030 | 17,5.20,55,0.030 | 18,5.17,55,0.030 | 19,5.21,55,0.030 | 20,5.18,55,0.030 | 21,5.23,55,0.030 | 22,5.25,55,0.030 | 23,5.25,55,0.030 | 24,4.87,56,0.028 | 25,4.72,56,0.027 | 26,4.80,56,0.028 | 27,4.74,55,0.027 | 28,5.14,55,0.030 | 29,5.24,55,0.030 | 30,5.13,55,0.030 | 31,5.19,55,0.030 | 32,5.19,55,0.030 | 33,5.18,55,0.030 | 34,5.19,55,0.030 | 35,5.19,55,0.030 | 36,5.13,56,0.030 | 37,5.15,56,0.030 | 38,5.12,56,0.030 | 39,5.15,56,0.030 | 40,4.78,56,0.028 | 41,4.55,56,0.027 | 42,4.72,56,0.027 | 43,4.65,55,0.027 | 44,5.04,55,0.029 | 45,5.23,55,0.030 | 46,5.06,55,0.029 | 47,5.17,55,0.030 | 48,5.24,55,0.030 | 49,5.32,55,0.031 | 50,5.31,55,0.031 | 51,5.21,56,0.030 | 52,5.17,56,0.030 | 53,5.11,56,0.030 | 54,5.07,56,0.030 | 55,5.10,56,0.030 | 56,4.69,56,0.028 | 57,4.45,56,0.026 | 58,4.59,56,0.027 | 59,4.60,55,0.027
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
