NicolaiFransen/SemesterProjectPED2/Documents/Workplace/batteries setup.png

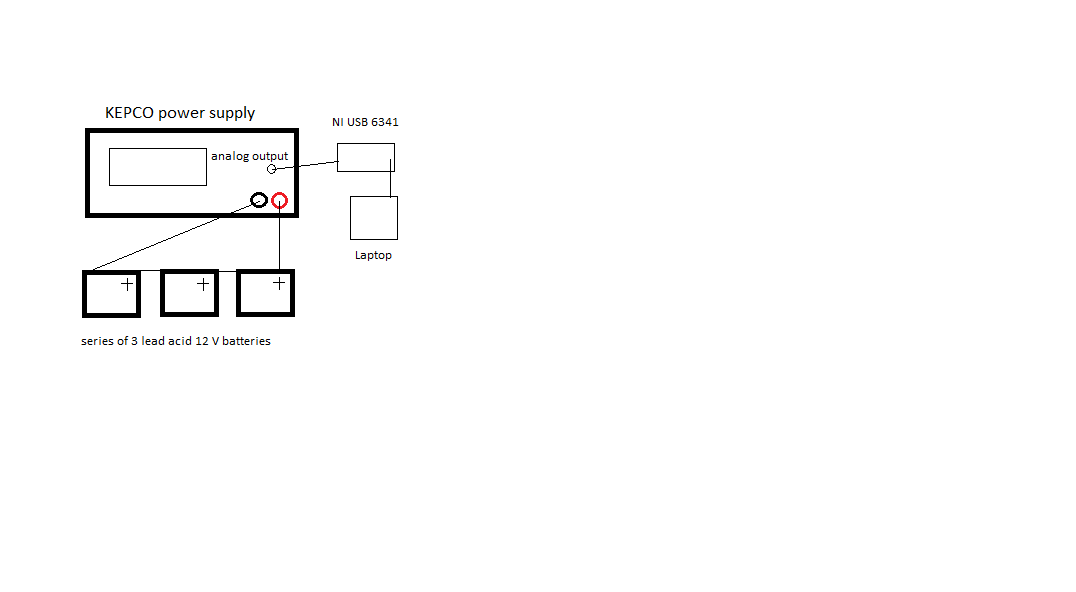
Documents/Workplace/batteries setup.png
