NicolaiFransen/SemesterProjectPED2/Documents/Workplace/schematic of setup.png

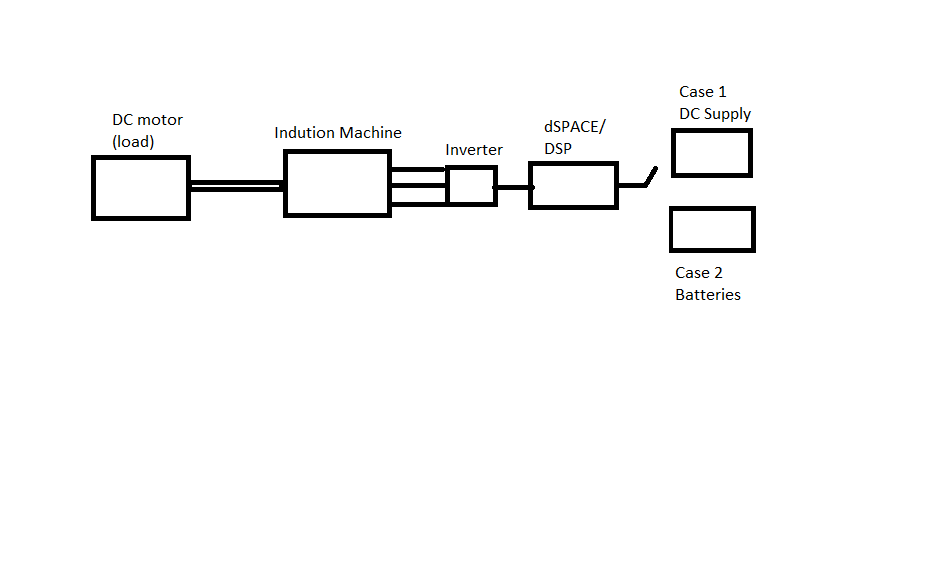
Documents/Workplace/schematic of setup.png
