NicolaiFransen/SemesterProjectPED2/Exam/Presentation/Pictures/TorqueLoadStepTorqueSpeed.PNG

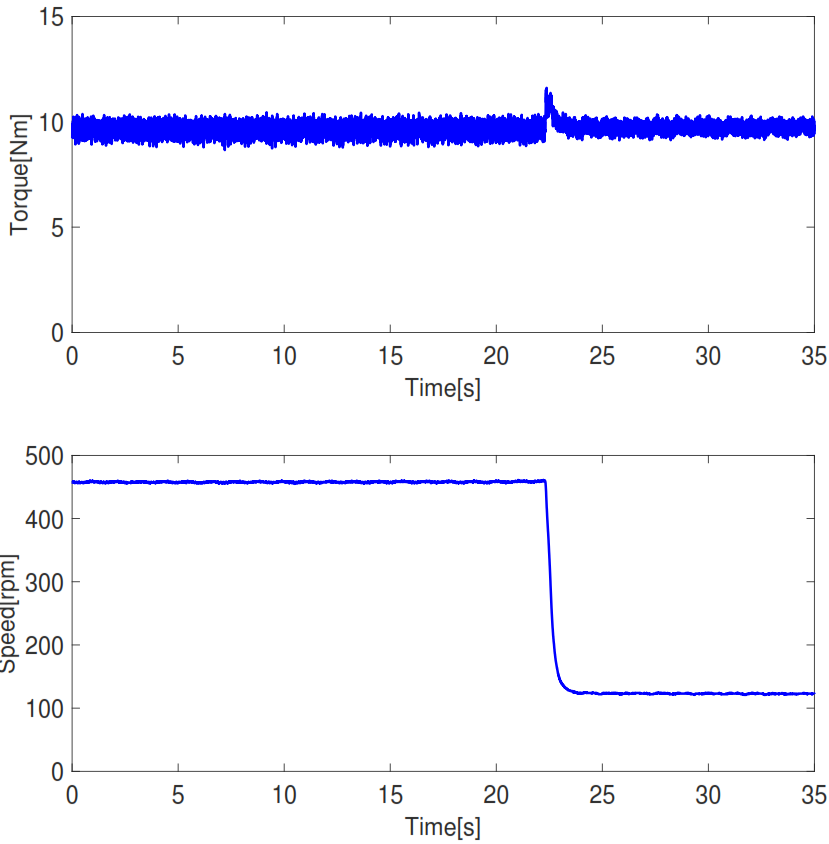
Exam/Presentation/Pictures/TorqueLoadStepTorqueSpeed.PNG
