NicolaiFransen/SemesterProjectPED2/Simulations/2019_03_28_fDscrt_Tor-Spd Cntrl/8-out_PWM delay on_Var anti Spd_Max Step.tif

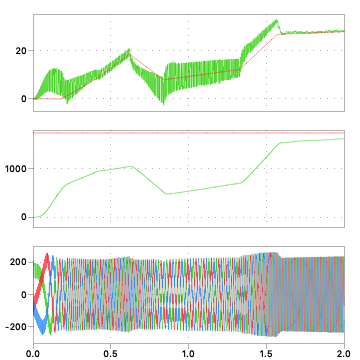
Simulations/2019_03_28_fDscrt_Tor-Spd Cntrl/8-out_PWM delay on_Var anti Spd_Max Step.tif
