NicolaiFransen/SemesterProjectPED2/Simulations/2019_05_11 FOC/simulation results/torque control/step Trated 2s/T_I_Trated.png

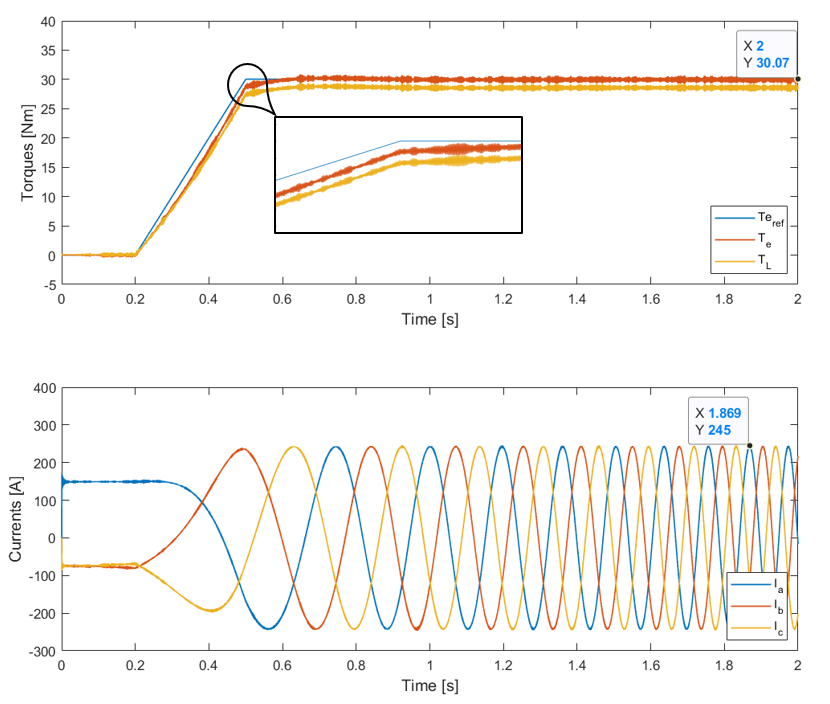
Simulations/2019_05_11 FOC/simulation results/torque control/step Trated 2s/T_I_Trated.png
