NicolaiFransen/SemesterProjectPED2/Tests/20190524_Cruise_and_Torque_Tests/_Torque_sensor/Torque_ref_step.bmp

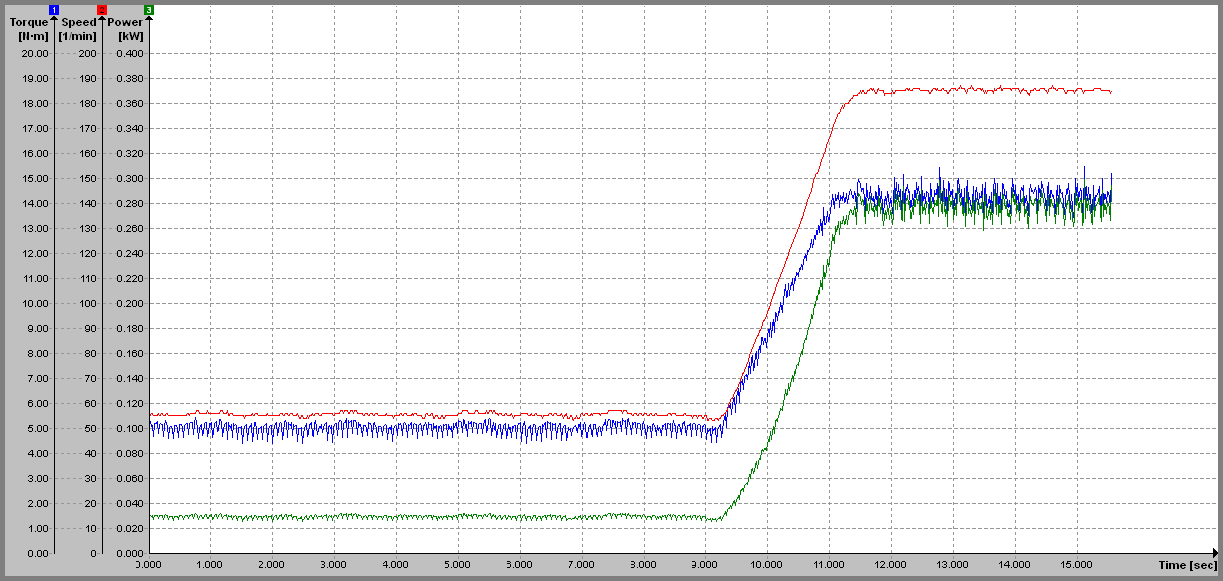
Tests/20190524_Cruise_and_Torque_Tests/_Torque_sensor/Torque_ref_step.bmp
