NicolaiFransen/SemesterProjectPED2/Tests/20190524_Cruise_and_Torque_Tests/CruiseLoadStep/cruise_control_load_change.bmp

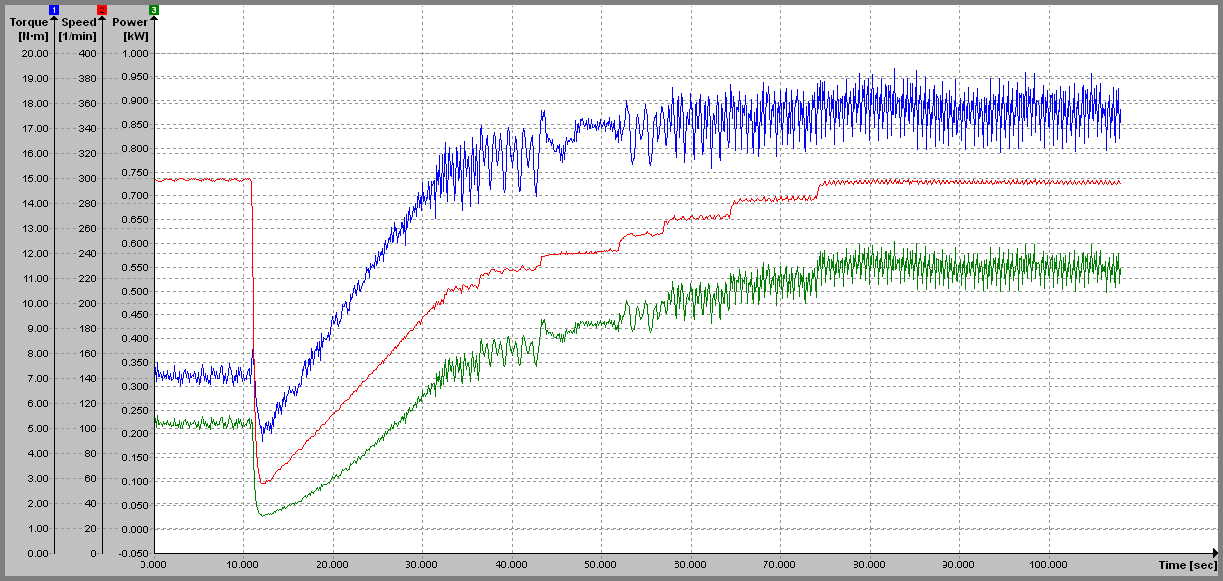
Tests/20190524_Cruise_and_Torque_Tests/CruiseLoadStep/cruise_control_load_change.bmp
