NicolaiFransen/SemesterProjectPED2/Tests/20190524_Cruise_and_Torque_Tests/TorqueLoadStep/tek0007.png

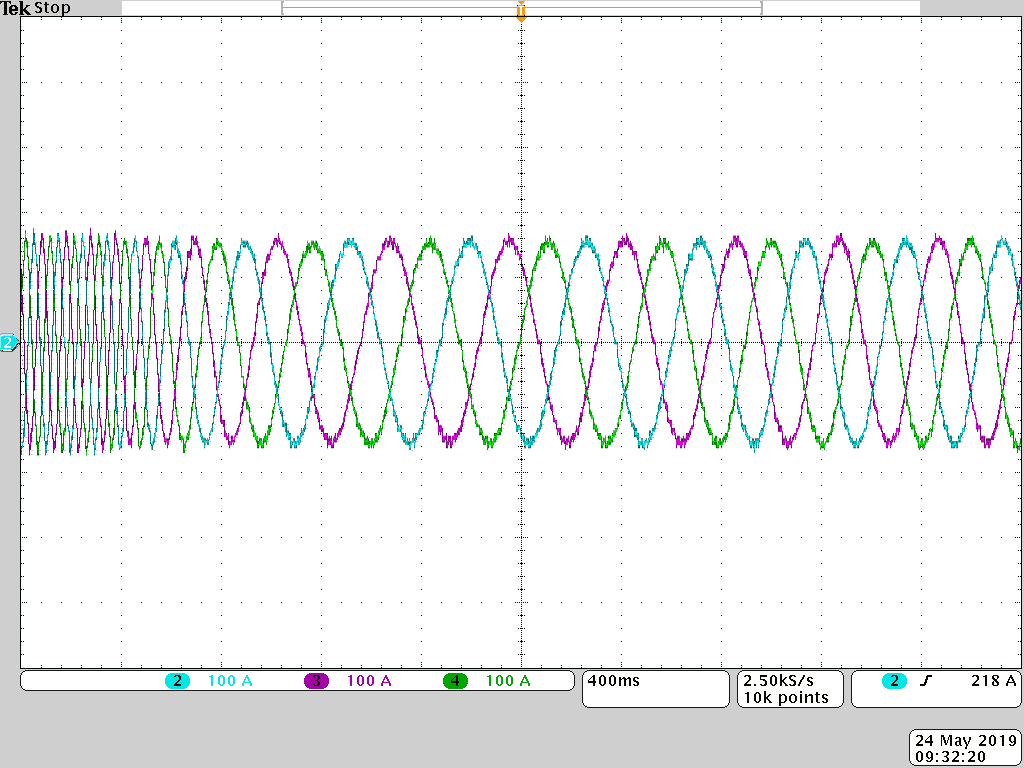
Tests/20190524_Cruise_and_Torque_Tests/TorqueLoadStep/tek0007.png
