NicolaiFransen/SemesterProjectPED2/Tests/130319_150A Inverter test/Information.rtf

Switching frequency 10kHz
Emissivity : 0.95
Distance setting : 0.25m

First set:
Tek00000, also Tek0000.csv - Vds 6V, Imean = 100A. Leg A, Temp 30deg
tek0001. Vds 10.2V vdc applied, surge 8.5V, I mean 150A, leg A, Temp 32.6

Second set
tek0002 Leg B, 6.4V surge, Vdc 6.4, Mean - 102A, temp 30.5deg
tek0003, leg B Vdc 8.4V, 8.4V surge, Imean 150A, temp 32.0deg

tek0004, Leg C, Imean 107A Vdc = 8.4V surge 6.4V temp 31deg
tek0005, Leg C, Vdc 10.4V surge 10.4V Imean 153A, temp 31.8deg
