NicolaiFransen/SemesterProjectPED2/Tests/140219_No Load Tests results/140219_No Load test.pptx

DRAIN SOURCE VOLTAGE Under No Current

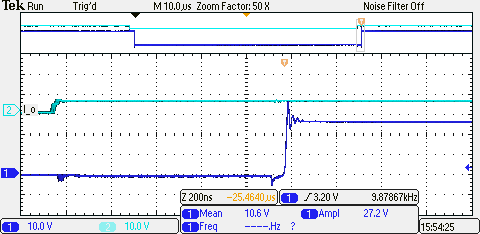
[picture p251: figure]

Driver Input Signal

Vds

## Slide 2

GATE – SOURCE VOLTAGE of High Side and Low Side MOSFET

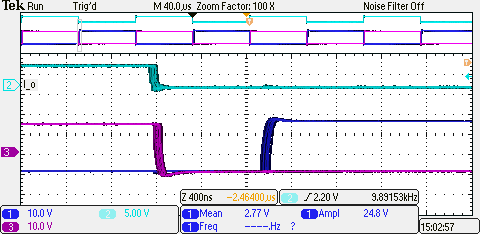
[picture p252: figure]

Vgs High Side

DeadTime

Vgs Low Side

1μs
