NicolaiFransen/SemesterProjectPED2/Tests/20190524_Cruise_and_Torque_Tests/TorqueStartup/TorqueStartup_IdIq.pdf

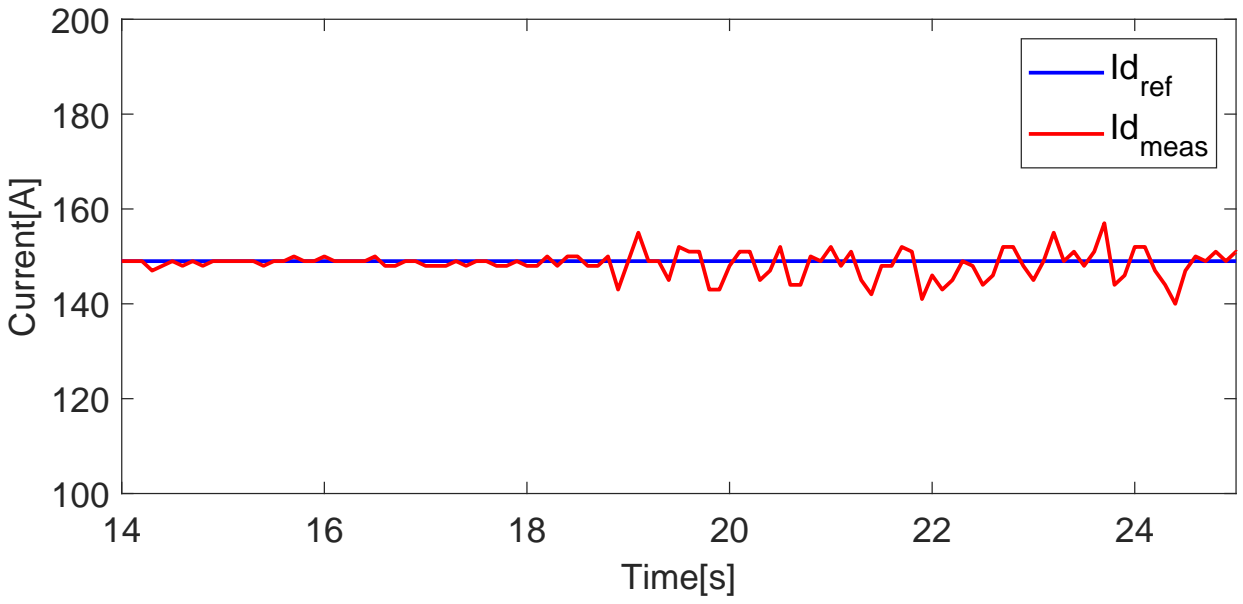
[picture p253: figure]
Time[s]; Current[A]; Idref Id; meas
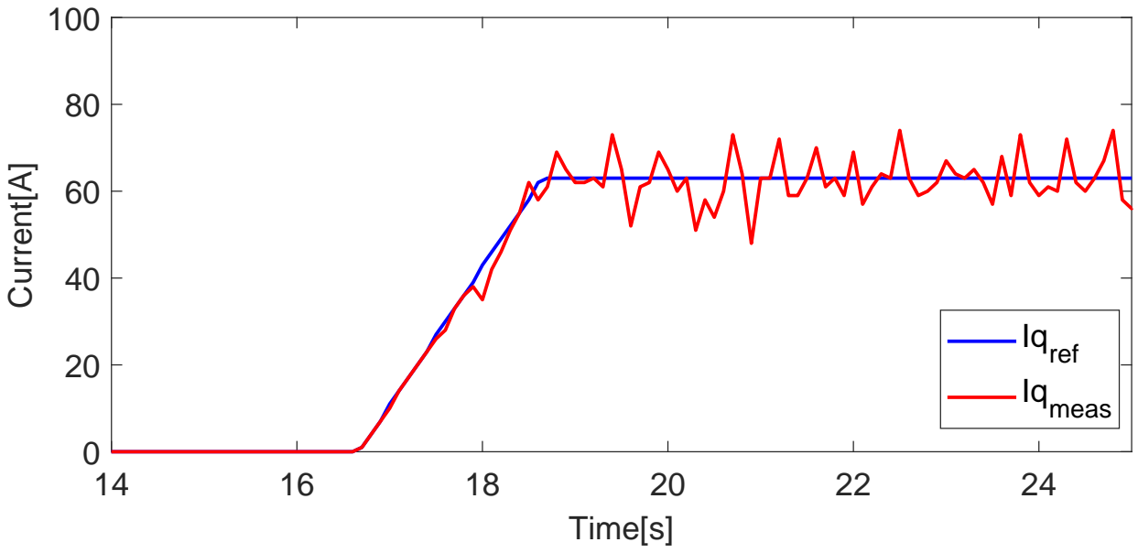
[picture p254: figure]
Time[s]; Current[A]; Iqref; Iqmeas
