NicolaiFransen/SemesterProjectPED2/Tests/160419_FunctionalTest/Current_Scope_DSP.xlsx

 | There's a constant offset
phase C
 | dsp | scope | voltsdsp | delta
 | 20.9 | 11.4 | 1.54 | 9.5
 | 12.77 | 3.5 | 1.577 | 9.27
 | 25.75 | 17.8 | 1.518 | 7.95
 | 30.36 | 22.1 | 1.497 | 8.26
 | 38.49 | 30.1 | 1.46 | 8.39
 |  |  |  | 0
 |  |  |  | 0
 |  |  |  | 0
 |  |  |  | 0
 |  |  |  | 0
 |  |  |  | 0
 |  |  |  | 0
phase B | A | A | voltsdsp
 | dsp | scope | voltsdsp | delta
 | 13.87 | 4.7 | 1.572 | 9.17
 | 18.93 | 9.63 | 1.549 | 9.3
phase A | A | A | voltsdsp
 | dsp | scope | voltsdsp | delta
 | 13.44 | 4.62 | 1.574 | 8.82
 | 26.41 | 17.5 | 1.515 | 8.91
