NicolaiFransen/SemesterProjectPED2/Interface board/PCB soldering and test/BoM and test procedure.xlsx

BoM |  |  |  |  | Procedure for testing the PCB
POWER SUPPLIES
 | Name | Number | Comments
Power supplies |  |  |  |  | TRACO U6 | DONE | PASS/FAIL | Comments
24V/+-15V | TRACO U6 | 1 | Current sensor and OPAM |  | 1. Solder R48,R49 | x
5V/5V | VS U7 | 1 | Voltage sensor input |  | 2. Solder C9 | x
24V/5V | DSP U8 | 1 | DSP supply |  | 3. Solder DS21, DS25 | x
 |  |  |  |  | 4. Solder J22 | x
 |  |  |  |  | 5. Solder U6 | x |  | TRACO inputs were reversed so we cutted the trace and connected it correctly.
Resistors |  |  |  |  | 6. Apply 24V from external power supply in pins 1 and 2 (+Vin/-Vin) -> J22 connector | x
1,3K Ω | R48,R49 | 2 | TRACO U6 |  | 7. Check the LED lights DS21 and DS25 | x
300 Ω | R46,R47 | 2 | VS U7 |  | 8. Measure with the multimeter the output voltage in pins 3 and 4 (+Vout/Com) for +15V | x |  | Vin=23.95V Vout=13.62V
130 Ω | R45 | 1 | DSP U8 |  | 9. Measure with the multimeter the output voltage in pins 5 and 4 (Com/-Vout) for -15V | x |  | Vout = -13.62
 |  |  |  |  |  |  | PASS
 |  |  |  |  | DSP U8
LEDs |  |  |  |  | 1. Solder R46 | x
Green | DS21-DS25 | 5 |  |  | 2. Solder C12-C17 | x
 |  |  |  |  | 3. Solder DS23 | x
Capacitors |  |  |  |  | 4. Solder J22 | X
100nF | C9 | 1 | TRACO U6 |  | 5. Solder U8 | x
100nF | C10,C11 | 2 | VS U7 |  | 6. Apply 24V from external power supply in pins 1 and 2 (+Vin/GND) | x
100nF | C12-C17 | 6 | DSP U8 |  | 7. Check the LED light DS23 | x
 |  |  |  |  | 8. Measure with the multimeter the output voltage in pins 3 and 2(+Vout/GND) for 5V | x
Connectors |  |  |  | legs |  |  | PASS
J22 | 24V | 1 | U6 and U8 | 2 | VS U7
J25 | 36V | 1 | DC link | 3 | 1. Solder R47 | x
J23 | (+-)15V | 1 | Current sensor | 3 | 2. Solder C10, C11 | x |  |  |  | º11111111111111111111111111111111111111111111111111111111111111111111111111111111111111111111111111111111111111111111111111111111111111111111111111111111111111111111111
J24 | 5V | 1 | DSP | 2 | 3. Solder DS24 | x
J26,J27 | 24V | 2 | Fan | 2 | 4. Solder U7 | x
 |  |  |  |  | 5. Check the LED DS24 |  |  | R47 no connected anywhere
 |  |  |  |  | 6. Measure input voltage in pins 2 and 1 (+Vin/-Vin) for 5V (*The input is the output of U8 so apply 24V) | x
 |  |  |  |  | 7. Measure with the multimeter the output voltage in pins 4 and 3 (+Vout/-Vout) for +5V | x
SWITCHES, BUTTONS AND DEBUGGING LEDS
 | Name | Number | Comments
BJTs
Switches | U1 | 1 |  |  | DEBUGGING
Buttons | U2 | 1 |  |  | 1. Solder resistors R33-R44 | x
Debugging | U3-U5 | 3 | 1/0 are sent from the DSP to debug the code |  | 2. Solder DS9-DS20 | x
 |  |  |  |  | 3. Solder U3-U5 | x
 |  |  |  |  | 4. Apply 3.3V to the base of the BJTs (G1-G4) | x
Resistors |  |  |  |  | 5. Check LED light | x
300 Ω | R11-R14 | 4 | LEDs switches |  | 6. When connecting the DSP send a digital output (1) to U3.1-U3.4 (repeat for U4 and U5)
100 Ω | R19-R22 | 4 | switches |  |  |  | PASS
300 Ω | R15-R18 | 4 | LEDs buttons
100 Ω | R23-R26 | 4 | buttons |  | Switches and buttons
10 kΩ | R27-R30 | 4 | debouncing resistors buttons |  | 1. Solder resistors R11-R26 | x
300 Ω | R33-R44 | 12 | debugging |  | 2. Solder C5-C8 | x
100 Ω | R31-R32 | 2 | Extras for connectors |  | 3. Solder DS1-DS8 | x
 |  |  |  |  | 4. Solder U1-U2 | x
LEDs |  |  |  |  | 5. Solder J5-J16 | x
Green | DS1-DS4 | 4 | switches |  | 6. Solder S3-S6 and B5-B8 | x
Green | DS5-DS8 | 4 | buttons |  | 7. Apply 3.3V to the base of the BJTs (G1-G4) | x |  | U1 ISNT WORKING
Green | DS9-DS20 | 12 | debugging |  | 5. Check LED light | x
 |  |  |  |  | 6. Check with multimeter switches and buttons | x
Capacitors
100nF | C5-C8 | 4 | debouncing capacitors buttons
Connectors |  |  |  | legs
J5-J8 | Switches and LEDs | 4 | jumper to select between switches and LEDs | 3
J13-J14 | Switches and LEDs | 2 | in case we want to have switches outside the PCB | 3
J9-J12 | Buttons and LEDs | 4 | jumper to select between buttons and LEDs | 3
J15-J16 | Buttons and LEDs | 2 | in case we want to connect a buttons outside | 3
J17-J19 | PWM | 3 | To inverter (Enable, 24V, GND and PWM) | 4
J20-J21 | Extra | 2 | Available as inputs and outputs | 3
Switches and buttons
S3-S6 | switches | 4
B5-B8 | buttons | 4
SWITCHES AND BUTTONS 2
 | Name | Number | Comments
Resistors |  |  |  |  | Test
100 Ω | R1-R5 and R10 | 6 |  |  | 1. Solder R1-R10 | x
10 kΩ | R6-R9 | 4 | debouncing resistors buttons |  | 2. Solder C1-C4 | x
 |  |  |  |  | 3. Solder J1-J4 | x
Capacitors |  |  |  |  | 4. Test continuity with the multimeter in S1-S2 and B1-B4 | x
100nF | C1-C4 | 4 | debouncing capacitors buttons |  | 5. Measure with the multimeter P1-P5 | x |  | Sliders P1 and P2--> 13,2-87,6K 14,5-91,6K
 |  |  |  |  | 6. Solder S1-S2, B1-B4 and P1-P5 | x
Connectors |  |  |  | legs |  |  |  | Missing P3-P5
J1-J4 |  |  | J1-J2 for termometers and J3-J4 for 3.3V | 3
Switches and buttons
S1 | switch | 1 | Move Enable
S2 | switch | 1 | Close loop/ Open loop
B1 | button | 1 | Torque reference
B2 | button | 1 | Regenerative braking
B3 | button | 1 | Cruise control
B4 | button | 1 | Wheel anti-slip
Potentiometers
P1-P2 | sliders | 2
P3-P5 | rotatory | 3
SENSORS
 | Name | Number | Comments
Resistors |  |  |  |  | *Matlab .m for the exact values expected --> "Interface_board_calculations"
1 kΩ (1.1kΩ) | R75, R50-R52, R63 | 5 |  |  | Voltage sensor
10 kΩ | R58-R59, R64-R65, R68-R69, R74-R75 | 8 |  |  | 1. Drill the holes in the PCB | x | 10V | 0,47V
21,5 kΩ (22 kΩ) | R53 | 1 |  |  | 2. Solder the zener | x | 15V | 0,709V
16,2 kΩ (16kΩ) | R60-R61 | 2 |  |  | 3. Solder R53, R57-R61 | x | 20V | 0,948 V
1,78 kΩ (1,8kΩ) | R54-R56 | 3 |  |  | 4. Solder C18,C19 and C22 | x | 25V | 1,174V
8,2 kΩ | R62 | 1 |  |  | 5. Solder U9 | x | 30V | 1,373V | 23ºC
9,09 Ω (9,1 Ω) | R67, R72, R77 | 3 |  |  | 6. Solder J25 | x | 36V | 1,58V | 30ºC
2,61 kΩ (2,7 kΩ) | R66, R70, R76 | 3 |  |  | 7. Apply 24V to J22 (for 5V VDD1,VDD2) and after apply 10V gradually up to 45V to J25 | x | 40V | 1,696 V | 31.3
61,9 kΩ (62kΩ) | R71 | 1 |  |  | 8. Check the temperature with the thermal camera | x | 44V | 1,79V | 33
12,1 kΩ (12kΩ) | R73 | 1 |  |  | 9. Measure the differential output (pin 7 and 6) but be careful! Do it in the resistors instead of the pins | x
 |  |  |  |  | 10. Check results with Matlab file | x |  | The pads for the pins were too short, consider having a longer one
Capacitors |  |  |  |  |  |  | PASS
100nF | C18-C19, C21, C23-C25, C27 | 7
10nF | C22, C26 | 2 |  |  | Operational amplifier
1uF | C20 | 1 |  |  | 1. Solder C24 | x
 |  |  |  |  | 2. Solder U10 | x
Zener diode |  |  |  |  | 3. Apply 24V to J22 and after apply 36V to J25 | x |  | The Opam wasn't reference so we grounded the TRACO U7
2,7 V | VZ1 |  | *DRILL THE HOLES THE FIRST THING!!! |  | 4. Measure output voltage pin 1 (AD_36) | x
 |  |  |  |  | 5. Check results with Matlab file | x
Connectors |  |  |  | legs |  |  | PASS
J28 | D connector 9 | 1 | Encoder | 11
J29 |  | 1 | Current measurement | 3 | 24V measurement
 |  |  |  |  | 1. Solder R62,R63 | x
ICs |  |  |  |  | 2. Apply 24V to J22 | x
Voltage sensor | U9 | 1 |  |  | 3. Measure voltage after voltage divider AD_24 | x |  | 2,84V
Operational amplifier | U10 | 1 | For current sensor |  | 4. Check results with Matlab file | x
 |  |  |  |  |  |  | PASS
 |  |  |  |  | Bias voltage for Opamp
 |  |  |  |  | 1. Solder R71,R73 | x
 |  |  |  |  | 2. Solder C26 | x
 |  |  |  |  | 3. Measure output after voltage divider OA_bias | x |  | 0,8V
 |  |  |  |  | 4. Check results with Matlab file | x
 |  |  |  |  |  |  | PASS
 |  |  |  |  | Current measurement and filters
 |  |  |  |  | 1. Solder resistors and capacitors | x
 |  |  |  |  | 2. Solder J29 | x
 |  |  |  |  | 3. Test it later when we connect the inverter
 |  |  |  |  | Encoder
 |  |  |  |  | 1. Solder R50-R52 and R54-R56 | x
 |  |  |  |  | 2. Solder C20-C21 | x
 |  |  |  |  | 3. Solder J28 | x
 |  |  |  |  | 4. Apply a square wave from signal generator with amplitude 5V in pin 2,3 or 9 with respect to pin 1 | x
 |  |  |  |  | 5. Measure EncA_sig, EncB_sig, EncC_sig and it should be a square wave witn amplitude around 3.3V | x
 |  |  |  |  |  |  | PASS
