NicolaiFransen/SemesterProjectPED2/Tests/2019_05_22_FOC_Tests/TorqueLoadChange/TreatedData45Vto90V/NumberTorqueSpeedPower.csv

# | Torque(N·m) | Speed(1/min) | Power(kW);
0 | 0.57 | 98 | 0.006;1 | 1.74 | 99 | 0.018;2 | 1.51 | 98 | 0.016;3 | 1.40 | 98 | 0.014;4 | 1.83 | 98 | 0.019;5 | 1.41 | 98 | 0.014;6 | 1.57 | 98 | 0.016;7 | 1.67 | 98 | 0.017;8 | 1.50 | 98 | 0.015;9 | 1.25 | 99 | 0.013;10 | 1.05 | 99 | 0.011;11 | 1.49 | 98 | 0.015;12 | 1.30 | 98 | 0.013;13 | 1.63 | 98 | 0.017;14 | 2.01 | 98 | 0.021;15 | 1.55 | 98 | 0.016;16 | 1.82 | 98 | 0.019;17 | 1.80 | 99 | 0.019;18 | 1.65 | 99 | 0.017;19 | 1.39 | 99
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
