NicolaiFransen/SemesterProjectPED2/Tests/2019_05_22_FOC_Tests/TorqueRefChange/TreatedData/NumberTorqueSpeedPowerUnknownFile.csv

# | Torque(N·m) | Speed(1/min) | Power(kW);
0 | 0.02 | 0 | 0.000;1 | 0.02 | 0 | 0.000;2 | 0.02 | 0 | 0.000;3 | 0.02 | 0 | 0.000;4 | 0.03 | 0 | 0.000;5 | 0.03 | 0 | 0.000;6 | 0.03 | 0 | 0.000;7 | 0.03 | 0 | 0.000;8 | 0.03 | 0 | 0.000;9 | 0.03 | 0 | 0.000;10 | 0.04 | 0 | 0.000;11 | 0.03 | 0 | 0.000;12 | 0.03 | 0 | 0.000;13 | 0.04 | 0 | 0.000;14 | 0.03 | 0 | 0.000;15 | 0.04 | 0 | 0.000;16 | 0.04 | 0 | 0.000;17 | 0.04 | 0 | 0.000;18 | 0.04 | 0 | 0.000;19 | 0.03 | 0
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
