NicolaiFransen/SemesterProjectPED2/Tests/2019_05_22_FOC_Tests/TorqueStartup/TreatedData/StartupNumberTorqueSpeedPower.csv

# | Torque(N·m) | Speed(1/min) | Power(kW);
0 | 0.06 | 0 | 0.000;1 | 0.06 | 0 | 0.000;2 | 0.06 | 0 | 0.000;3 | 0.07 | 0 | 0.000;4 | 0.07 | 0 | 0.000;5 | 0.08 | 0 | 0.000;6 | 0.08 | 0 | 0.000;7 | 0.08 | 0 | 0.000;8 | 0.08 | 0 | 0.000;9 | 0.07 | 0 | 0.000;10 | 0.07 | 0 | 0.000;11 | 0.07 | 0 | 0.000;12 | 0.06 | 0 | 0.000;13 | 0.07 | 0 | 0.000;14 | 0.06 | 0 | 0.000;15 | 0.06 | 0 | 0.000;16 | 0.07 | 0 | 0.000;17 | 0.06 | 0 | 0.000;18 | 0.06 | 0 | 0.000;19 | 0.06 | 0
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
