NicolaiFransen/SemesterProjectPED2/Tests/2019_05_22_FOC_Tests/TorqueSteadyState/TreatedData/NumberTorqueSpeedPower.csv

# | Torque(N·m) | Speed(1/min) | Power(kW);
0 | 0.00 | 0 | 0.000;1 | 0.00 | 0 | 0.000;2 | 0.00 | 0 | 0.000;3 | -0.01 | 0 | 0.000;4 | -0.01 | 0 | 0.000;5 | -0.01 | 0 | 0.000;6 | -0.01 | 0 | 0.000;7 | -0.01 | 0 | 0.000;8 | -0.01 | 0 | 0.000;9 | -0.01 | 0 | 0.000;10 | -0.01 | 0 | 0.000;11 | -0.01 | 0 | 0.000;12 | 0.00 | 0 | 0.000;13 | 0.00 | 0 | 0.000;14 | 0.00 | 0 | 0.000;15 | 0.00 | 0 | 0.000;16 | 0.00 | 0 | 0.000;17 | -0.01 | 0 | 0.000;18 | -0.01 | 0 | 0.000;19 | -0.01 | 0
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
