NicolaiFransen/SemesterProjectPED2/Simulations/2018_Semester Project/Appendix/Datasheets/Battery/Charge_Discharge_test.xlsx

 |  | Battery A | Battery B | Battery C | Battery D
Initial charge | V_end | 14.7 | 14.7 | 14.7 | 14.7 | V
 | I_hrs | 25594 | 31222 | 34567 | 38487 | mAh
Discharge | V_end | 9 | 9 | 9 | 9 | V
 | I_hrs | 38647 | 41440 | 32135 | 32736 | mAh
Charge | V_end | 14.7 | 14.7 | 14.7 | 14.7 | V
 | I_hrs | 37705 | 39844 | 30997 |  | mAh
