NicolaiFransen/SemesterProjectPED2/Tests/200219_Load Test inverter/Test schematic.pdf

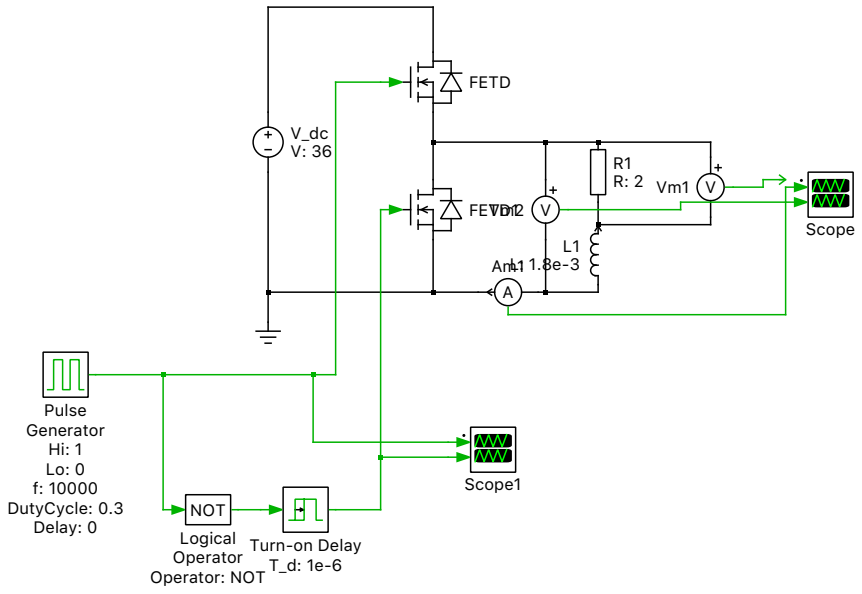
[picture p255: figure]
FETD; FETD1; Pulse Generator Hi: 1 Lo: 0 f: 10000 DutyCycle: 0.3 Delay: 0; NOT Logical Operator Operator: NOT; Turn-on Delay T_d: 1e-6; Scope; Scope1
