NicolaiFransen/SemesterProjectPED2/Tests/200219_Load Test inverter/Leg C/36V_50_duty_zoomed.pdf

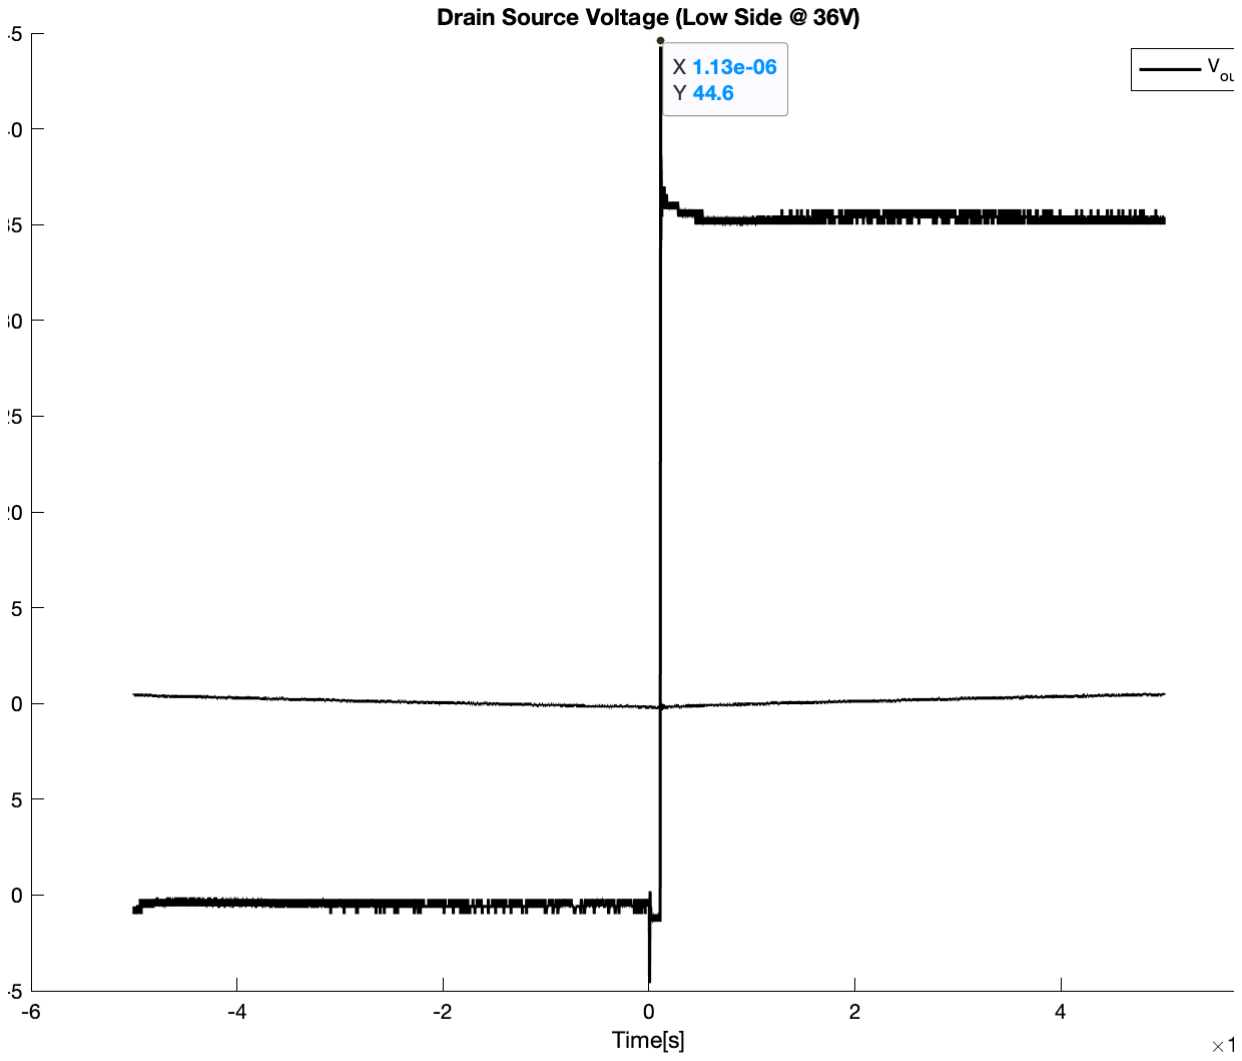
[picture p256: page 1]
