NicolaiFransen/SemesterProjectPED2/Tests/20190524_Cruise_and_Torque_Tests/CruiseSpeedChange/speed_change_PCB_v3.csv

#,Torque(N·m),Speed(1/min),Power(kW),
0,4.42,243,0.113 | 1,5.66,243,0.144 | 2,5.29,243,0.135 | 3,5.89,243,0.150 | 4,5.96,243,0.152 | 5,5.97,243,0.152 | 6,6.08,243,0.155 | 7,6.08,243,0.155 | 8,6.16,243,0.157 | 9,6.18,244,0.157 | 10,6.17,244,0.157 | 11,6.22,244,0.159 | 12,6.15,244,0.157 | 13,6.15,244,0.157 | 14,6.21,244,0.159 | 15,6.08,244,0.155 | 16,6.14,244,0.157 | 17,6.17,244,0.157 | 18,6.09,243,0.155 | 19,6.24,243,0.159 | 20,6.16,243,0.157 | 21,6.21,243,0.158 | 22,6.21,243,0.158 | 23,6.21,244,0.158 | 24,6.16,244,0.157 | 25,6.09,244,0.156 | 26,6.02,244,0.154 | 27,6.00,244,0.153 | 28,6.00,244,0.153 | 29,5.97,244,0.152 | 30,6.09,243,0.155 | 31,6.01,243,0.153 | 32,6.14,243,0.156 | 33,6.08,243,0.154 | 34,6.07,243,0.154 | 35,6.09,243,0.155 | 36,5.99,243,0.152 | 37,5.96,243,0.152 | 38,6.09,243,0.155 | 39,5.92,244,0.151 | 40,6.05,244,0.154 | 41,5.96,243,0.152 | 42,5.95,243,0.152 | 43,6.00,243,0.153 | 44,6.04,243,0.154 | 45,5.97,243,0.152 | 46,6.15,243,0.157 | 47,5.97,244,0.152 | 48,6.07,244,0.155 | 49,5.88,244,0.150 | 50,5.99,244,0.153 | 51,5.88,244,0.150 | 52,5.97,244,0.153 | 53,5.90,244,0.151 | 54,6.08,244,0.155 | 55,6.15,244,0.157 | 56,6.17,244,0.158 | 57,6.12,244,0.156 | 58,6.24,244,0.159 | 59,6.17,244,0.158
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
