NicolaiFransen/SemesterProjectPED2/Tests/20190524_Cruise_and_Torque_Tests/TorqueStartup/StartupTest.csv

#,Torque(N·m),Speed(1/min),Power(kW),
0,0.08,0,0.000 | 1,0.09,0,0.000 | 2,0.09,0,0.000 | 3,0.09,0,0.000 | 4,0.09,0,0.000 | 5,0.09,0,0.000 | 6,0.09,0,0.000 | 7,0.09,0,0.000 | 8,0.09,0,0.000 | 9,0.10,0,0.000 | 10,0.10,0,0.000 | 11,0.10,0,0.000 | 12,0.09,0,0.000 | 13,0.09,0,0.000 | 14,0.09,0,0.000 | 15,0.09,0,0.000 | 16,0.09,0,0.000 | 17,0.09,0,0.000 | 18,0.09,0,0.000 | 19,0.09,0,0.000 | 20,0.09,0,0.000 | 21,0.09,0,0.000 | 22,0.09,0,0.000 | 23,0.09,0,0.000 | 24,0.10,0,0.000 | 25,0.10,0,0.000 | 26,0.10,0,0.000 | 27,0.09,0,0.000 | 28,0.10,0,0.000 | 29,0.09,0,0.000 | 30,0.10,0,0.000 | 31,0.10,0,0.000 | 32,0.09,0,0.000 | 33,0.09,0,0.000 | 34,0.09,0,0.000 | 35,0.09,0,0.000 | 36,0.09,0,0.000 | 37,0.09,0,0.000 | 38,0.09,0,0.000 | 39,0.09,0,0.000 | 40,0.10,0,0.000 | 41,0.10,0,0.000 | 42,0.09,0,0.000 | 43,0.09,0,0.000 | 44,0.09,0,0.000 | 45,0.09,0,0.000 | 46,0.09,0,0.000 | 47,0.10,0,0.000 | 48,0.09,0,0.000 | 49,0.09,0,0.000 | 50,0.10,0,0.000 | 51,0.09,0,0.000 | 52,0.10,0,0.000 | 53,0.10,0,0.000 | 54,0.10,0,0.000 | 55,0.10,0,0.000 | 56,0.10,0,0.000 | 57,0.09,0,0.000 | 58,0.09,0,0.000 | 59,0.09,0,0.000
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
