NicolaiFransen/SemesterProjectPED2/Tests/20190524_Cruise_and_Torque_Tests/TorqueStartup/tek0001.csv

TIME | CH2 | CH3 | CH4;
-2.0000e+00 | -88 | -58 | 154;-1.9996e+00 | -88 | -62 | 154;-1.9992e+00 | -88 | -62 | 150;-1.9988e+00 | -88 | -62 | 150;-1.9984e+00 | -84 | -62 | 150;-1.9980e+00 | -88 | -58 | 150;-1.9976e+00 | -88 | -62 | 150;-1.9972e+00 | -88 | -58 | 154;-1.9968e+00 | -88 | -62 | 150;-1.9964e+00 | -84 | -58 | 150;-1.9960e+00 | -84 | -58 | 154;-1.9956e+00 | -88 | -58 | 150;-1.9952e+00 | -84 | -58 | 146;-1.9948e+00 | -88 | -58 | 150;-1.9944e+00 | -80 | -58 | 150;-1.9940e+00 | -84 | -58 | 150;-1.9936e+00 | -88 | -58 | 146;-1.9932e+00 | -88 | -62 | 154;-1.9928e+00 | -88 | -58 | 150;-1.9924e+00 | -92 | -58
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
