NicolaiFransen/SemesterProjectPED2/Tests/20190524_Cruise_and_Torque_Tests/TorqueSteadyState/tek0002.csv

 TIME,CH2,CH3,CH4;
 -2.0000e-01,172,-86,-78;-1.9996e-01,180,-90,-90;-1.9992e-01,172,-86,-82;-1.9988e-01,176,-90,-82;-1.9984e-01,176,-86,-86;-1.9980e-01,176,-90,-82;-1.9976e-01,180,-86,-98;-1.9972e-01,176,-86,-82;-1.9968e-01,180,-86,-90;-1.9964e-01,180,-86,-82;-1.9960e-01,168,-86,-78;-1.9956e-01,180,-86,-94;-1.9952e-01,172,-90,-86;-1.9948e-01,176,-78,-90;-1.9944e-01,176,-90,-86;-1.9940e-01,172,-82,-78;-1.9936e-01,176,-82,-94;-1.9932e-01,176,-86,-86;-1.9928e-01,176,-82,-94;-1.9924e-01,180,-86,-90;-1.9920e-01,172,-78,-82;-1.9916e-01,180,-82,-94;-1.9912e-01,172,-86,-86;-1.9908e-01,180,-82,-90;-1.9904e-01,176,-82,-90;-1.9900e-01,172,-82,-82;-1.9896e-01,180,-82,-90;-1.9892e-01,172,-78,-90;-1.9888e-01,176,-78,-90;-1.9884e-01,180,-78,-90;-1.9880e-01,172,-78,-82;-1.9876e-01,180,-82,-90;-1.9872e-01,172,-78,-90;-1.9868e-01,180,-78,-90;-1.9864e-01,176,-78,-86;-1.9860e-01,176,-86,-82;-1.9856e-01,180,-78,-98;-1.9852e-01,172,-82,-86;-1.9848e-01,180,-78,-98;-1.9844e-01,176,-78,-90;-1.9840e-01,168,-78,-86;-1.9836e-01,180,-78,-90;-1.9832e-01,176,-78,-82;-1.9828e-01,176,-74,-98;-1.9824e-01,176,-78,-94;-1.9820e-01,168,-82,-90;-1.9816e-01,176,-82,-94;-1.9812e-01,172,-78,-90;-1.9808e-01,180,-78,-102;-1.9804e-01,176,-78,-90;-1.9800e-01,168,-74,-86;-1.9796e-01,180,-78,-98;-1.9792e-01,172,-74,-90;-1.9788e-01,180,-74,-98;-1.9784e-01,176,-78,-94;-1.9780e-01,168,-78,-86;-1.9776e-01,176,-78,-98;-1.9772e-01,172,-78,-90;-1.9768e-01,184,-74,-102;-1.9764e-01,176,-74,-94;-1.9760e-01,168,-78,-90;-1.9756e-01,180,-70,-102;-1.975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
