NicolaiFransen/SemesterProjectPED2/Tests/20190524_Cruise_and_Torque_Tests/TorqueToCruise/cruiseControl_v2.csv

#,Torque(N·m),Speed(1/min),Power(kW),
0,6.58,311,0.214 | 1,6.54,311,0.213 | 2,7.44,311,0.243 | 3,6.94,312,0.226 | 4,7.37,312,0.241 | 5,7.55,312,0.247 | 6,7.08,312,0.231 | 7,7.41,313,0.242 | 8,7.42,313,0.243 | 9,7.27,313,0.238 | 10,7.30,313,0.239 | 11,7.34,313,0.240 | 12,7.22,313,0.236 | 13,7.26,313,0.238 | 14,7.36,313,0.241 | 15,7.53,312,0.246 | 16,7.39,312,0.241 | 17,7.51,312,0.246 | 18,7.62,312,0.249 | 19,7.48,313,0.245 | 20,7.44,313,0.244 | 21,7.64,313,0.250 | 22,7.30,313,0.239 | 23,7.29,312,0.238 | 24,7.61,312,0.249 | 25,7.40,312,0.242 | 26,7.21,312,0.235 | 27,7.76,313,0.254 | 28,7.15,313,0.234 | 29,7.06,313,0.231 | 30,7.66,313,0.251 | 31,6.98,313,0.228 | 32,7.11,312,0.233 | 33,7.68,313,0.251 | 34,7.03,312,0.230 | 35,7.37,312,0.241 | 36,7.66,312,0.250 | 37,7.12,311,0.232 | 38,7.43,311,0.242 | 39,7.57,312,0.247 | 40,7.14,311,0.233 | 41,7.48,312,0.244 | 42,7.34,312,0.240 | 43,7.18,312,0.234 | 44,7.50,312,0.245 | 45,7.26,312,0.237 | 46,7.53,312,0.246 | 47,7.29,313,0.239 | 48,7.13,313,0.233 | 49,7.43,313,0.243 | 50,7.13,313,0.233 | 51,7.18,313,0.235 | 52,7.67,313,0.251 | 53,7.19,313,0.235 | 54,7.44,313,0.243 | 55,7.73,313,0.253 | 56,7.36,313,0.241 | 57,7.39,313,0.242 | 58,7.69,313,0.252 | 59,7.20,313,0.236
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
