NicolaiFransen/SemesterProjectPED2/Tests/20190524_Cruise_and_Torque_Tests/TorqueToCruise/tek0005.csv

TIME | CH2 | CH3 | CH4;
-5.0000e+00 | -24 | -122 | 142;-4.9990e+00 | -8 | -122 | 142;-4.9980e+00 | -4 | -126 | 134;-4.9970e+00 | 4 | -130 | 130;-4.9960e+00 | 8 | -130 | 126;-4.9950e+00 | 12 | -130 | 118;-4.9940e+00 | 24 | -138 | 110;-4.9930e+00 | 44 | -142 | 98;-4.9920e+00 | 68 | -150 | 90;-4.9910e+00 | 72 | -154 | 82;-4.9900e+00 | 80 | -154 | 74;-4.9890e+00 | 92 | -158 | 62;-4.9880e+00 | 104 | -150 | 50;-4.9870e+00 | 104 | -150 | 38;-4.9860e+00 | 116 | -146 | 34;-4.9850e+00 | 124 | -142 | 26;-4.9840e+00 | 132 | -142 | 10;-4.9830e+00 | 132 | -134 | 2;-4.9820e+00 | 132 | -134 | 2;-4.9810e+00 | 132 | -130
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
