NicolaiFransen/SemesterProjectPED2/Tests/140219_No Load Tests results/LegA/T0000ALL_test1.CSV

Model | DPO2014
Firmware Version | 1.29
Point Format | Y
Horizontal Units | S
Horizontal Scale | 4e-05
Sample Interval | 4e-09
Filter Frequency | 1e+08
Record Length | 100000
Gating | 0.0% to 100.0% |  | 0.0% to 100.0%
Probe Attenuation | 10 |  | 10
Vertical Units | V |  | V
Vertical Offset | 0 |  | 0
Vertical Scale | 10 |  | 5
Label |  |  | I_o
TIME | CH1 | CH1 Peak Detect | CH2 | CH2 Peak Detect
-2.02464e-04 | 15 | 15 | -0.0999998 | -0.0999998
-2.02460e-04 | 15.4 | 15.4 | -0.0999998 | -0.0999998
-2.02456e-04 | 15.4 | 15.4 | -0.0999998 | -0.0999998
-2.02452e-04 | 15.4 | 15.4 | -0.0999998 | -0.0999998
-2.02448e-04 | 15.4 | 15 | -0.0999998 | -0.0999998
-2.02444e-04 | 15 | 15.4 | -0.0999998 | 0.1
-2.02440e-04 | 15 | 15 | -0.3 | -0.3
-2.02436e-04 | 15.4 | 15.4 | -0.0999998 | -0.0999998
-2.02432e-04 | 15 | 15 | -0.3 | -0.3
-2.02428e-04 | 15.4 | 15.4 | -0.0999998 | -0.0999998
-2.02424e-04 | 15.4 | 15 | -0.3 | -0.3
-2.02420e-04 | 15 | 15.4 | -0.0999998 | -0.0999998
-2.02416e-04 | 15 | 15 | -0.0999998 | -0.0999998
-2.02412e-04 | 15 | 15.4 | 0.1 | 0.1
-2.02408e-04 | 15 | 15 | -0.0999998 | -0.0999998
-2.02404e-04 | 15.4 | 15.4 | -0.0999998 | 0.1
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
