NicolaiFransen/SemesterProjectPED2/Tests/140219_No Load Tests results/LegA/T0000CH3_test2.CSV

Model | DPO2014
Firmware Version | 1.29
Point Format | Y
Horizontal Units | S
Horizontal Scale | 4e-05
Sample Interval | 4e-09
Filter Frequency | 1e+08
Record Length | 100000
Gating | 0.0% to 100.0%
Probe Attenuation | 10
Vertical Units | V
Vertical Offset | 0
Vertical Scale | 10
Label
TIME | CH3 | CH3 Peak Detect
-2.02464e-04 | -8.4 | -8.4
-2.02460e-04 | -8.4 | -8.4
-2.02456e-04 | -8.4 | -8.4
-2.02452e-04 | -8.4 | -8.4
-2.02448e-04 | -8.4 | -8.4
-2.02444e-04 | -8.4 | -8.4
-2.02440e-04 | -8.4 | -8.8
-2.02436e-04 | -8.4 | -8.4
-2.02432e-04 | -8.4 | -8.8
-2.02428e-04 | -8.4 | -8.4
-2.02424e-04 | -8.4 | -8.4
-2.02420e-04 | -8.4 | -8.4
-2.02416e-04 | -8.4 | -8.4
-2.02412e-04 | -8.4 | -8.4
-2.02408e-04 | -8.4 | -8.4
-2.02404e-04 | -8.4 | -8.4
-2.02400e-04 | -8.4 | -8.8
-2.02396e-04 | -8.4 | -8.4
-2.02392e-04 | -8.4 | -8.4
-2.02388e-04 | -8.4 | -8.4
-2.02384e-04 | -8.4 | -8.4
-2.02380e-04 | -8.4 | -8.4
-2.02376e-04 | -8.4 | -8.4
-2.02372e-04 | -8.4 | -8.4
-2.02368e-04 | -8.4 | -8.4
-2.02364e-04 | -8.4 | -8
-2.02360e-04 | -8.4 | -8.4
-2.02356e-04 | -8.4 | -8.4
-2.02352e-04 | -8.4 | -8.4
-2.02348e-04 | -8.4 | -8.4
-2.02344e-04 | -8.4 | -8.4
-2.02340e-04 | -8.4 | -8.4
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
