NicolaiFransen/SemesterProjectPED2/Tests/140219_No Load Tests results/LegB/T0000CH1_Vds.CSV

Model | DPO2014
Firmware Version | 1.29
Point Format | Y
Horizontal Units | S
Horizontal Scale | 1e-05
Sample Interval | 1e-09
Filter Frequency | 1e+08
Record Length | 100000
Gating | 0.0% to 100.0%
Probe Attenuation | 10
Vertical Units | V
Vertical Offset | 0
Vertical Scale | 10
Label
TIME | CH1
-7.54640e-05 | 26
-7.54630e-05 | 26
-7.54620e-05 | 26
-7.54610e-05 | 26
-7.54600e-05 | 26
-7.54590e-05 | 26
-7.54580e-05 | 26
-7.54570e-05 | 25.6
-7.54560e-05 | 26
-7.54550e-05 | 25.6
-7.54540e-05 | 26
-7.54530e-05 | 25.6
-7.54520e-05 | 26
-7.54510e-05 | 25.6
-7.54500e-05 | 25.6
-7.54490e-05 | 25.6
-7.54480e-05 | 26
-7.54470e-05 | 26
-7.54460e-05 | 26
-7.54450e-05 | 26
-7.54440e-05 | 26
-7.54430e-05 | 26
-7.54420e-05 | 26
-7.54410e-05 | 25.6
-7.54400e-05 | 26
-7.54390e-05 | 26
-7.54380e-05 | 26
-7.54370e-05 | 26
-7.54360e-05 | 26
-7.54350e-05 | 25.6
-7.54340e-05 | 25.6
-7.54330e-05 | 26
-7.54320e-05 | 25.6
-7.54310e-05 | 26
-7.54300e-05 | 25.6
-7.54290e-05 | 26
-7.54280e-05 | 26
-7.54270e-05 | 26
-7.54260e-05 | 26
-7.54250e-05 | 26
-7.54240e-05 | 26
-7.54230e-05 | 26
-7.54220e-05 | 26
-7.54210e-05 | 25.6
-7.54200e-05 | 26
-7.54190e-05 | 25.6
-7.54180e-05 | 26
-7.54170e-05 | 26
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
