NicolaiFransen/SemesterProjectPED2/Tests/200219_Load Test inverter/Leg A/26V_duty 30.CSV

Model | DPO2014
Firmware Version | 1.29
Point Format | Y
Horizontal Units | S
Horizontal Scale | 1e-05
Sample Interval | 1e-09
Filter Frequency | 1e+08
Record Length | 100000
Gating | 0.0% to 100.0% | 0.0% to 100.0% | 0.0% to 100.0%
Probe Attenuation | 10 | 10 | 10
Vertical Units | V | V | A
Vertical Offset | 0 | 0 | 0
Vertical Scale | 5 | 10 | 2
Label |  | I_o
TIME | CH1 | CH2 | CH3
-5.00000e-05 | -0.1 | -0.4 | 4.52
-4.99990e-05 | -0.1 | -0.4 | 4.44
-4.99980e-05 | -0.1 | -0.4 | 4.52
-4.99970e-05 | -0.3 | -0.4 | 4.44
-4.99960e-05 | -0.3 | -0.4 | 4.44
-4.99950e-05 | -0.3 | -0.4 | 4.44
-4.99940e-05 | -0.3 | -0.4 | 4.52
-4.99930e-05 | -0.3 | -0.4 | 4.44
-4.99920e-05 | -0.3 | -0.4 | 4.52
-4.99910e-05 | -0.3 | -0.4 | 4.44
-4.99900e-05 | -0.1 | -0.4 | 4.52
-4.99890e-05 | -0.1 | -0.4 | 4.44
-4.99880e-05 | -0.1 | -0.4 | 4.52
-4.99870e-05 | -0.3 | -0.4 | 4.44
-4.99860e-05 | -0.1 | -0.4 | 4.52
-4.99850e-05 | -0.3 | -0.4 | 4.44
-4.99840e-05 | -0.3 | -0.4 | 4.52
-4.99830e-05 | -0.3 | -0.4 | 4.52
-4.99820e-05 | -0.1 | -0.4 | 4.52
-4.99810e-05 | -0.3 | -0.4 | 4.44
-4.99800e-05 | -0.3 | -0.4 | 4.52
-4.99790e-05 | -0.3 | -0.4 | 4.52
-4.99780e-05 | -0.3 | -0.4 | 4.52
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
