NicolaiFransen/SemesterProjectPED2/Tests/2019_05_22_FOC_Tests/TorqueLoadChange/TreatedData45Vto90V/TIMECH2CH3CH4.csv

TIME | CH2 | CH3 | CH4;
-1.000e+00 | -52 | -90 | 150;-9.998e-01 | -52 | -90 | 146;-9.996e-01 | -52 | -86 | 150;-9.994e-01 | -52 | -94 | 146;-9.992e-01 | -44 | -94 | 154;-9.990e-01 | -48 | -98 | 150;-9.988e-01 | -48 | -98 | 154;-9.986e-01 | -44 | -110 | 158;-9.984e-01 | -44 | -102 | 154;-9.982e-01 | -48 | -102 | 150;-9.980e-01 | -44 | -106 | 154;-9.978e-01 | -48 | -102 | 154;-9.976e-01 | -36 | -106 | 154;-9.974e-01 | -36 | -110 | 154;-9.972e-01 | -40 | -114 | 154;-9.970e-01 | -44 | -110 | 154;-9.968e-01 | -36 | -114 | 154;-9.966e-01 | -40 | -106 | 154;-9.964e-01 | -36 | -114 | 154;-9.962e-01 | -36 | -110
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
