NicolaiFransen/SemesterProjectPED2/Tests/2019_05_22_FOC_Tests/TorqueRefChange/TreatedData/TIMECH2CH3CH4.csv

TIME | CH2 | CH3 | CH4;
-1.000e+00 | 76 | 70 | -146;-9.998e-01 | 76 | 66 | -142;-9.996e-01 | 72 | 66 | -150;-9.994e-01 | 76 | 70 | -150;-9.992e-01 | 76 | 70 | -150;-9.990e-01 | 76 | 74 | -150;-9.988e-01 | 80 | 70 | -146;-9.986e-01 | 80 | 70 | -150;-9.984e-01 | 76 | 70 | -150;-9.982e-01 | 76 | 70 | -150;-9.980e-01 | 76 | 66 | -146;-9.978e-01 | 80 | 74 | -146;-9.976e-01 | 76 | 74 | -146;-9.974e-01 | 76 | 70 | -150;-9.972e-01 | 72 | 74 | -146;-9.970e-01 | 76 | 70 | -146;-9.968e-01 | 76 | 70 | -150;-9.966e-01 | 76 | 66 | -146;-9.964e-01 | 76 | 70 | -150;-9.962e-01 | 76 | 70
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
