NicolaiFransen/SemesterProjectPED2/Tests/2019_05_22_FOC_Tests/TorqueStartup/TreatedData/StartupTimeCh2Ch3Ch4.csv

TIME | CH2 | CH3 | CH4;
-5.0000e+00 | 36 | 110 | -146;-4.9990e+00 | 40 | 110 | -146;-4.9980e+00 | 40 | 106 | -154;-4.9970e+00 | 32 | 114 | -146;-4.9960e+00 | 36 | 110 | -146;-4.9950e+00 | 36 | 106 | -146;-4.9940e+00 | 36 | 106 | -146;-4.9930e+00 | 40 | 110 | -146;-4.9920e+00 | 36 | 106 | -150;-4.9910e+00 | 32 | 106 | -146;-4.9900e+00 | 36 | 106 | -142;-4.9890e+00 | 40 | 110 | -142;-4.9880e+00 | 36 | 106 | -146;-4.9870e+00 | 40 | 110 | -150;-4.9860e+00 | 36 | 110 | -154;-4.9850e+00 | 36 | 110 | -146;-4.9840e+00 | 36 | 110 | -142;-4.9830e+00 | 40 | 110 | -146;-4.9820e+00 | 36 | 110 | -146;-4.9810e+00 | 36 | 110
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
