NicolaiFransen/SemesterProjectPED2/Tests/2019_05_22_FOC_Tests/TorqueSteadyState/TreatedData/TimeCh2Ch3Ch4.csv

TIME | CH2 | CH3 | CH4;
-1.000e-01 | -40 | 154 | -106;-9.998e-02 | -44 | 150 | -102;-9.996e-02 | -36 | 150 | -106;-9.994e-02 | -36 | 150 | -106;-9.992e-02 | -36 | 142 | -106;-9.990e-02 | -44 | 150 | -106;-9.988e-02 | -40 | 154 | -106;-9.986e-02 | -40 | 154 | -106;-9.984e-02 | -36 | 150 | -106;-9.982e-02 | -36 | 150 | -106;-9.980e-02 | -40 | 154 | -110;-9.978e-02 | -44 | 154 | -106;-9.976e-02 | -40 | 150 | -106;-9.974e-02 | -40 | 146 | -110;-9.972e-02 | -36 | 146 | -106;-9.970e-02 | -44 | 150 | -102;-9.968e-02 | -48 | 150 | -106;-9.966e-02 | -44 | 150 | -102;-9.964e-02 | -36 | 146 | -102;-9.962e-02 | -36 | 146
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
