NicolaiFransen/SemesterProjectPED2/Tests/2019_05_22_FOC_Tests/TorqueStartup/Scope/tek0001.csv

Model | DPO4054B
Firmware Version | 2.90
Waveform Type | ANALOG
Point Format | Y
Horizontal Units | s
Horizontal Scale | 0.4
Horizontal Delay | 0
Sample Interval | 0.0004
Record Length | 10000
Gating | 0.0% to 100.0%
Probe Attenuation | 50
Vertical Units | A
Vertical Offset | 0
Vertical Scale | 100
Vertical Position | 0
Label
TIME | CH2 | CH3 | CH4
-2.0000e+00 | 144 | -98 | -42
-1.9996e+00 | 144 | -98 | -42
-1.9992e+00 | 148 | -102 | -42
-1.9988e+00 | 148 | -102 | -42
-1.9984e+00 | 148 | -98 | -50
-1.9980e+00 | 144 | -98 | -42
-1.9976e+00 | 144 | -102 | -42
-1.9972e+00 | 148 | -98 | -38
-1.9968e+00 | 148 | -98 | -38
-1.9964e+00 | 148 | -94 | -42
-1.9960e+00 | 148 | -102 | -42
-1.9956e+00 | 144 | -106 | -42
-1.9952e+00 | 144 | -94 | -42
-1.9948e+00 | 144 | -98 | -42
-1.9944e+00 | 144 | -98 | -46
-1.9940e+00 | 148 | -94 | -42
-1.9936e+00 | 148 | -102 | -46
-1.9932e+00 | 152 | -98 | -46
-1.9928e+00 | 148 | -102 | -46
-1.9924e+00 | 152 | -102 | -46
-1.9920e+00 | 148 | -102 | -42
-1.9916e+00 | 152 | -102 | -42
-1.9912e+00 | 152 | -102 | -46
-1.9908e+00 | 148 | -102 | -46
-1.9904e+00 | 152 | -102 | -46
-1.9900e+00 | 152 | -102 | -50
-1.9896e+00 | 148 | -106 | -50
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
