NicolaiFransen/SemesterProjectPED2/Tests/130319_150A Inverter test/tek0000.csv

Model | DPO4054B
Firmware Version | 2.90
Waveform Type | ANALOG
Point Format | Y
Horizontal Units | s
Horizontal Scale | 4e-05
Horizontal Delay | 0
Sample Interval | 4e-08
Record Length | 10000
Gating | 0.0% to 100.0%
Probe Attenuation | 500
Vertical Units | V
Vertical Offset | 0
Vertical Scale | 5
Vertical Position | 1.46
Label | Vds_low
TIME | CH1 | CH2 | CH3
-2.0000e-04 | 5.5 | 4.4 | 99
-1.9996e-04 | 5.5 | 4.4 | 100
-1.9992e-04 | 5.3 | 4.4 | 100
-1.9988e-04 | 5.7 | 4.4 | 101
-1.9984e-04 | 5.5 | 4.4 | 100
-1.9980e-04 | 5.5 | 4.4 | 100
-1.9976e-04 | 5.5 | 4.4 | 100
-1.9972e-04 | 5.7 | 4.4 | 101
-1.9968e-04 | 5.7 | 4.4 | 100
-1.9964e-04 | 5.9 | 4.4 | 100
-1.9960e-04 | 6.1 | 4.6 | 100
-1.9956e-04 | 5.7 | 4.4 | 99
-1.9952e-04 | 5.1 | 4.4 | 99
-1.9948e-04 | 5.9 | 4.4 | 100
-1.9944e-04 | 5.5 | 4.6 | 100
-1.9940e-04 | 5.5 | 4.6 | 100
-1.9936e-04 | 5.5 | 4.2 | 100
-1.9932e-04 | 5.7 | 4.4 | 100
-1.9928e-04 | 5.3 | 4.2 | 100
-1.9924e-04 | 5.5 | 4.4 | 101
-1.9920e-04 | 5.5 | 4.2 | 101
-1.9916e-04 | 5.7 | 4.4 | 100
-1.9912e-04 | 5.5 | 4.4 | 100
-1.9908e-04 | 5.9 | 4.4 | 100
-1.9904e-04 | 5.5 | 4.4 | 100
-1.9900e-04 | 5.3 | 4.2 | 100
-1.9896e-04 | 5.5 | 4.4 | 100
-1.9892e-04 | 5.5 | 4.4 | 99
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
