NicolaiFransen/SemesterProjectPED2/DeliveryFolder/Simulink/Batteries/good figures/validation.jpg

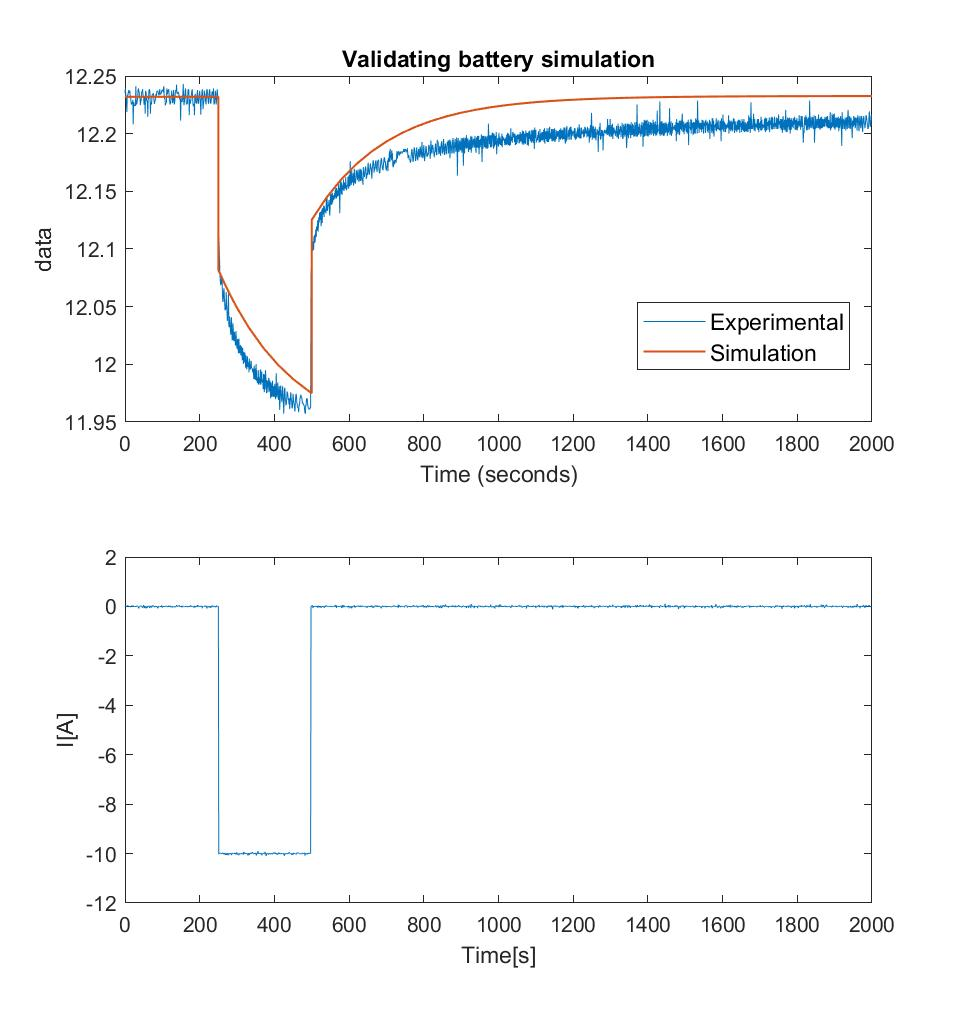
DeliveryFolder/Simulink/Batteries/good figures/validation.jpg
