NicolaiFransen/SemesterProjectPED2/Inverter/2019_03_23_Inverter3DCase/Measurements.jpeg

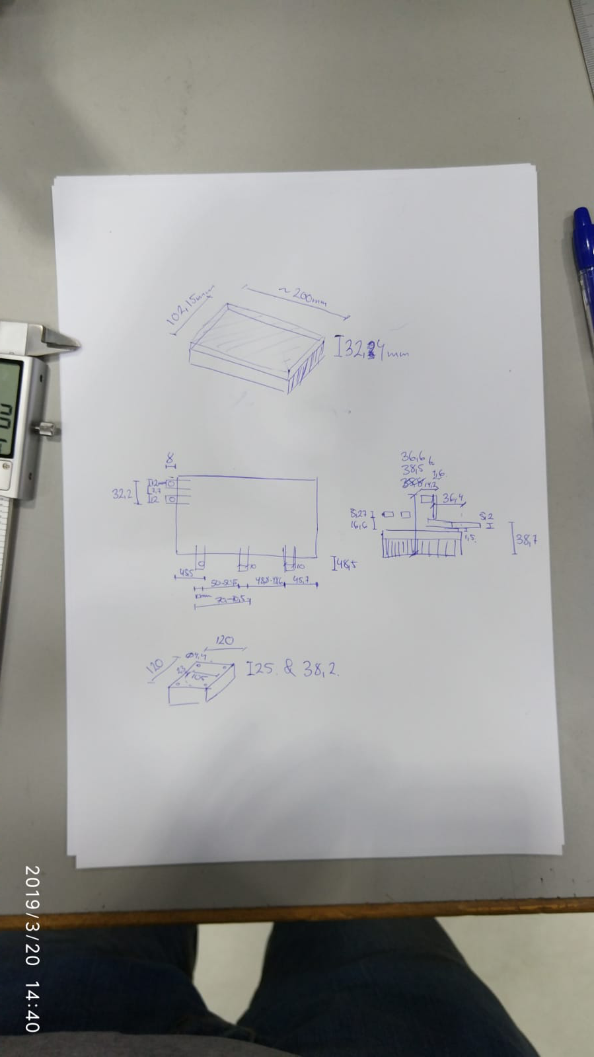
Inverter/2019_03_23_Inverter3DCase/Measurements.jpeg
