NicolaiFransen/SemesterProjectPED2/Report/Pictures/ModelMachine/Simulations/PF_validation.png

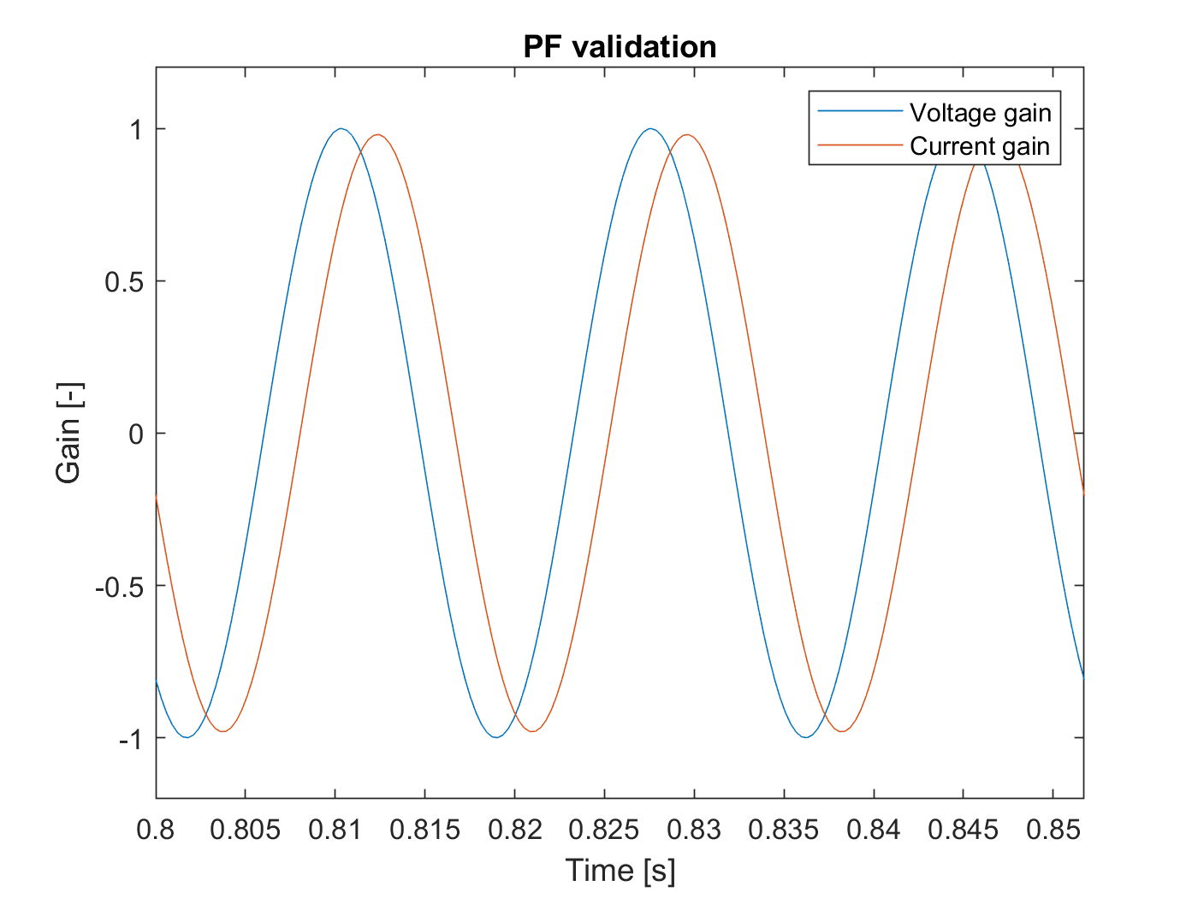
Report/Pictures/ModelMachine/Simulations/PF_validation.png
