NicolaiFransen/SemesterProjectPED2/Report/Pictures/SystemTest/Setup/TestSetup_v2.jpeg

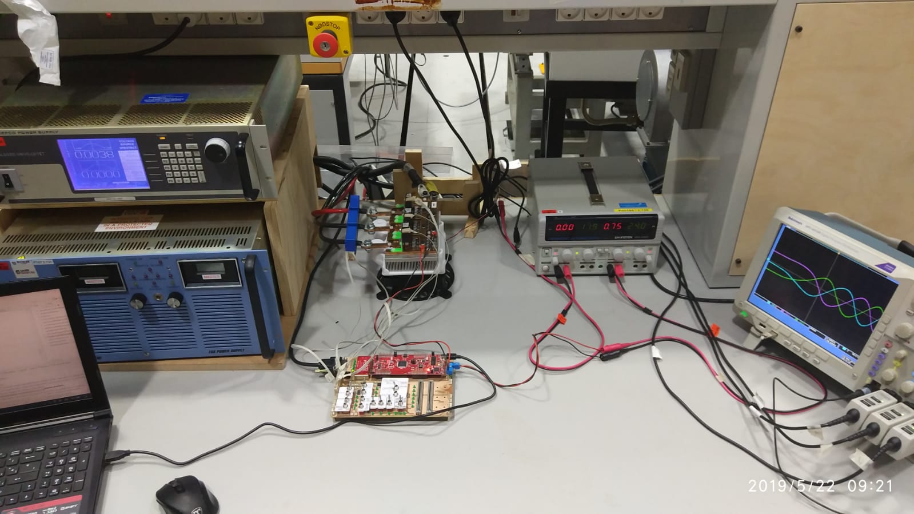
Report/Pictures/SystemTest/Setup/TestSetup_v2.jpeg
