NicolaiFransen/SemesterProjectPED2/Report/Pictures/SystemTest/Setup/TestSetup_v3.jpeg

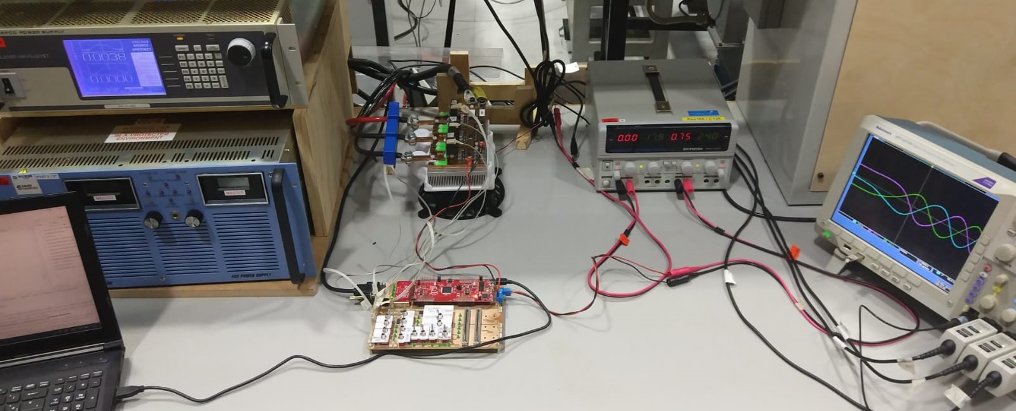
Report/Pictures/SystemTest/Setup/TestSetup_v3.jpeg
