NicolaiFransen/SemesterProjectPED2/Simulations/2019_02_14_Im_model/Results v2/n_1600 Tload 20_overmodulation.PNG

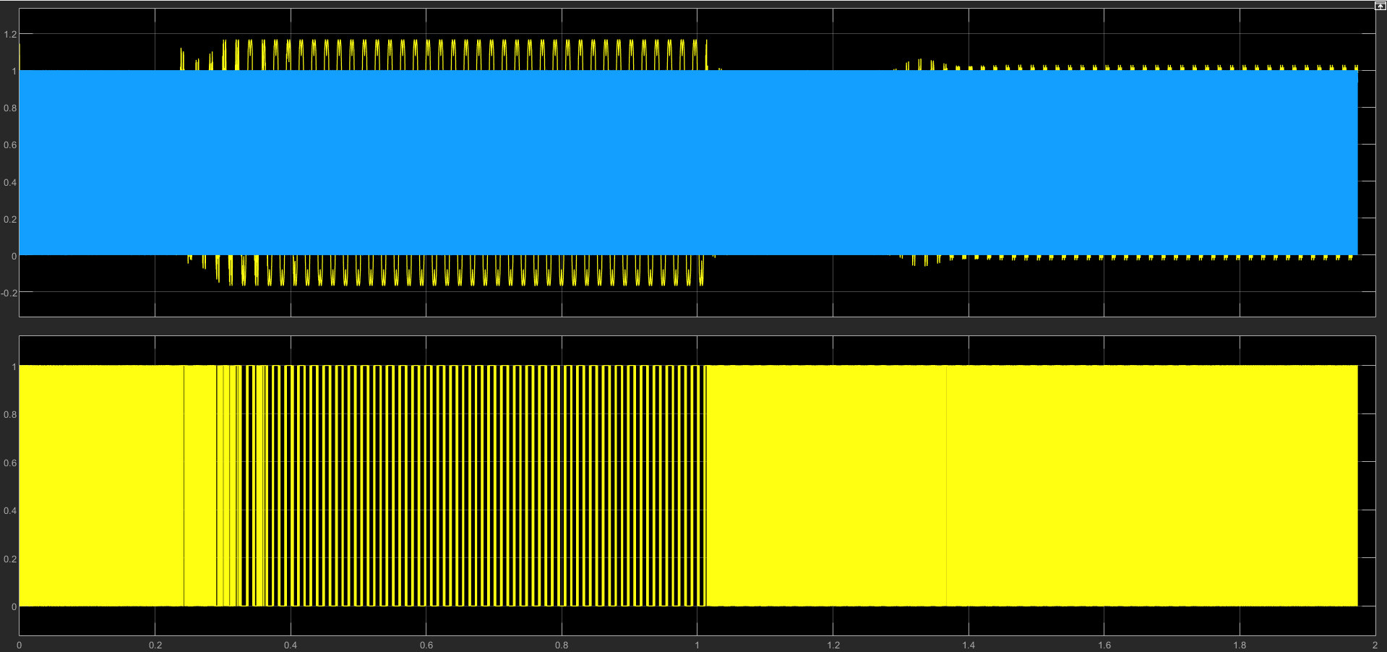
Simulations/2019_02_14_Im_model/Results v2/n_1600 Tload 20_overmodulation.PNG
