NicolaiFransen/SemesterProjectPED2/Simulations/2019_02_14_Im_model/Results v2/n_sync and varying load torque.PNG

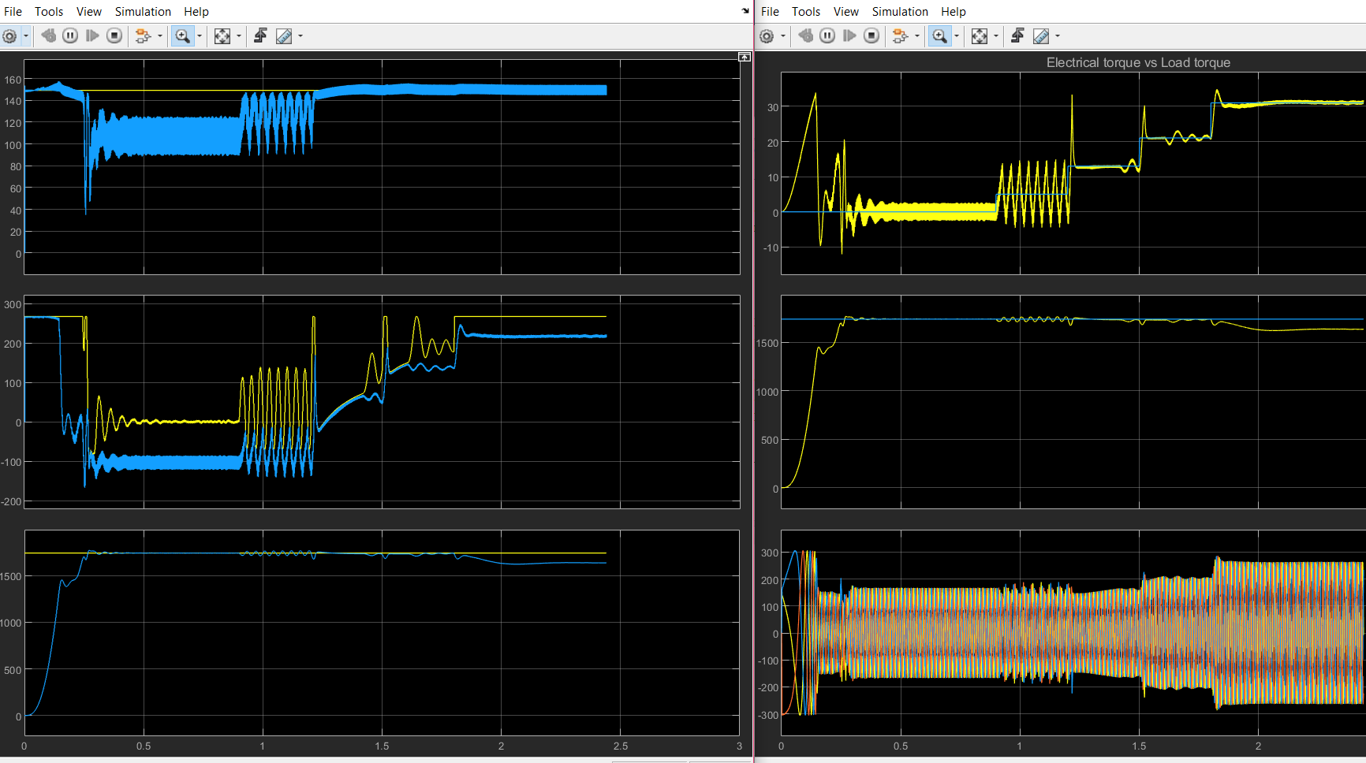
Simulations/2019_02_14_Im_model/Results v2/n_sync and varying load torque.PNG
