NicolaiFransen/SemesterProjectPED2/Simulations/2019_02_14_Im_model/Results v2/scope1.PNG

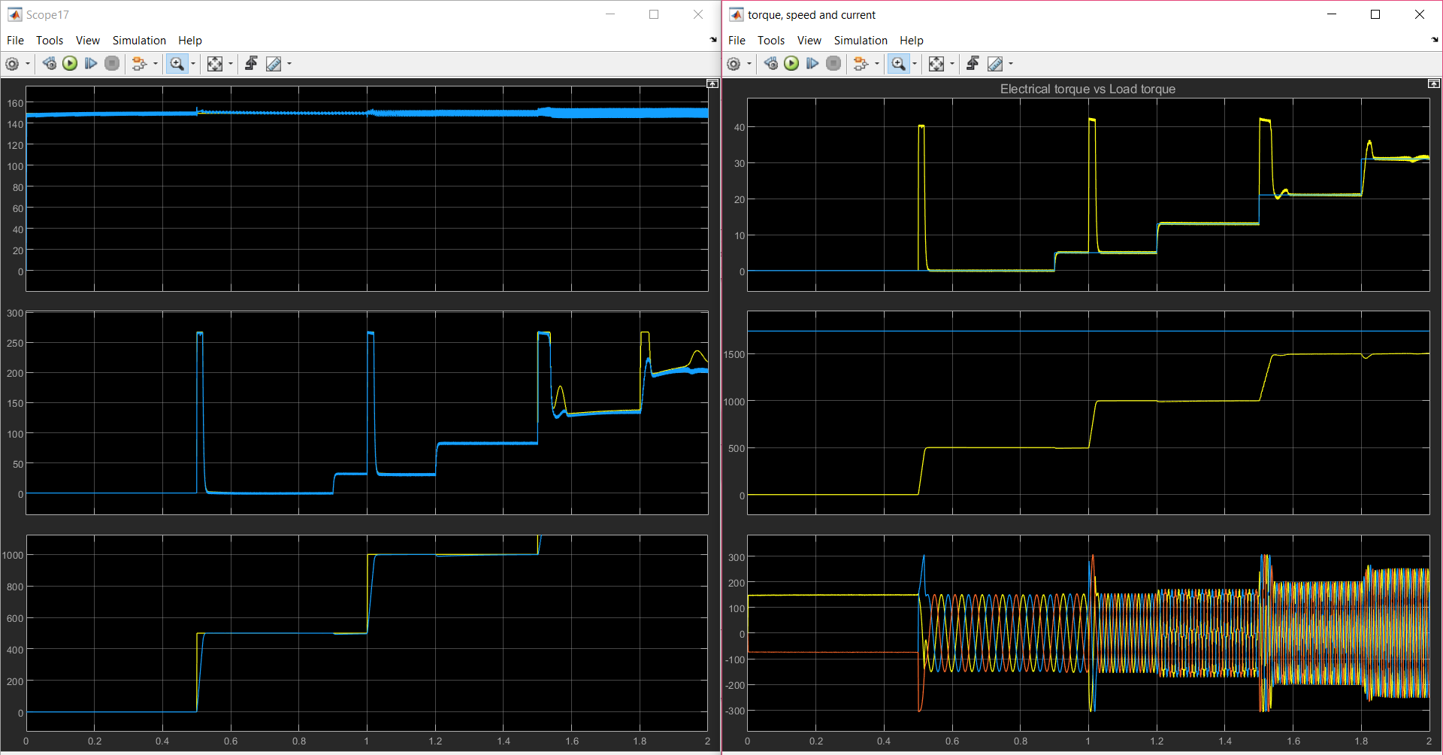
Simulations/2019_02_14_Im_model/Results v2/scope1.PNG
