NicolaiFransen/SemesterProjectPED2/Simulations/2019_02_14_Im_model/Results v2/speed-torque characteristic curve.jpg

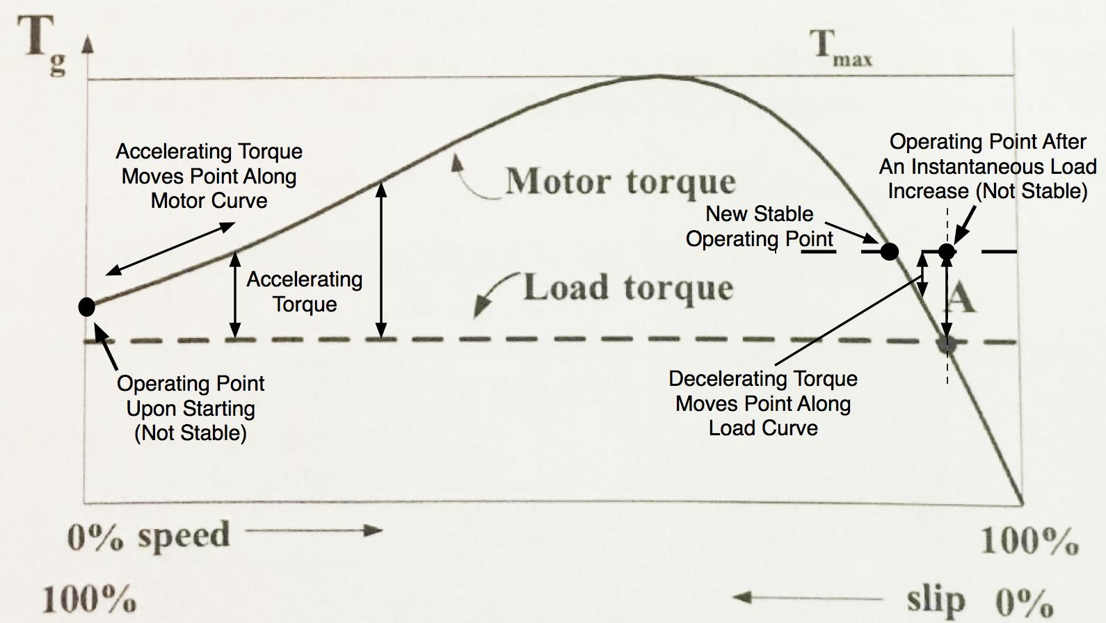
Simulations/2019_02_14_Im_model/Results v2/speed-torque characteristic curve.jpg
