NicolaiFransen/SemesterProjectPED2/Simulations/2019_02_14_Im_model/Results v2/T_rated and varying speed.PNG

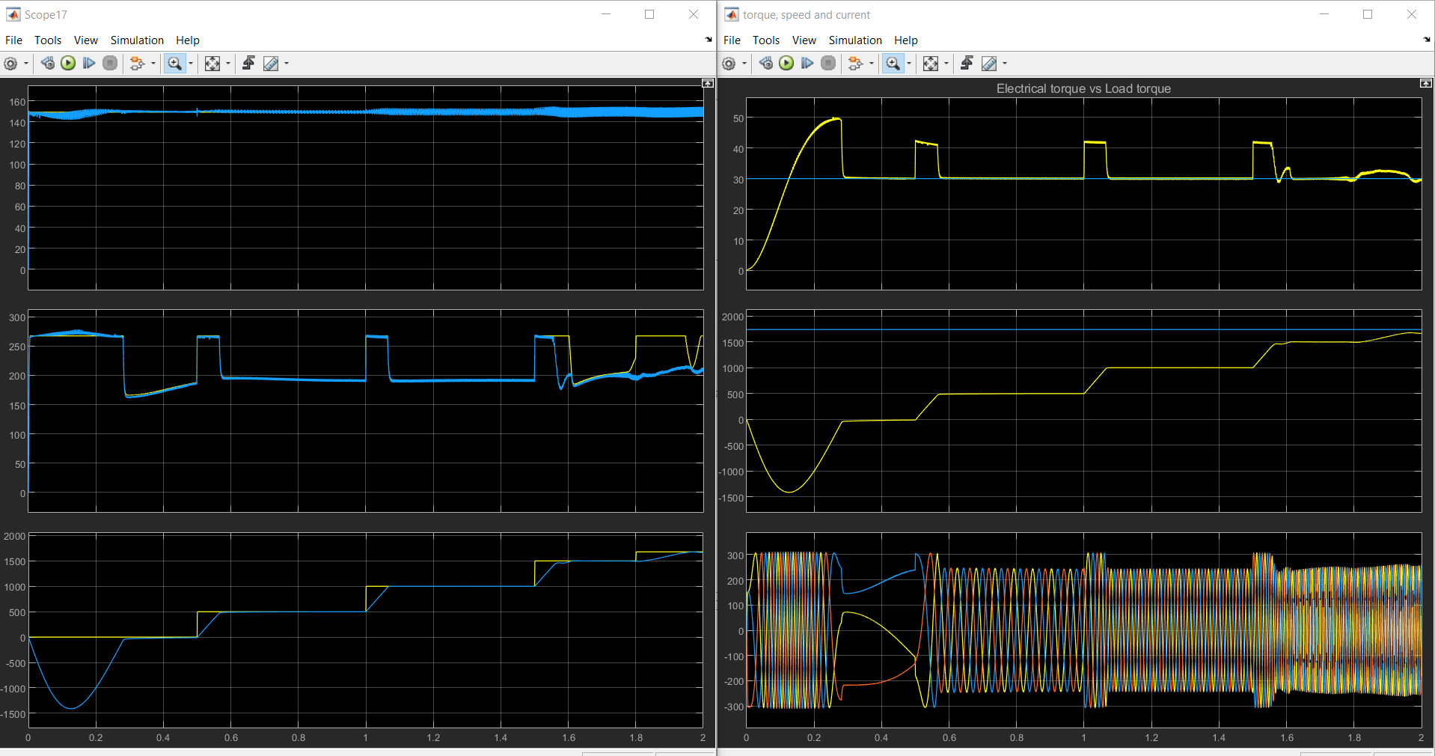
Simulations/2019_02_14_Im_model/Results v2/T_rated and varying speed.PNG
