NicolaiFransen/SemesterProjectPED2/Simulations/2019_05_11 FOC/simulation results/cruise control/speed up to 300rpm and back to 0 10s/T_w_I_n300.png

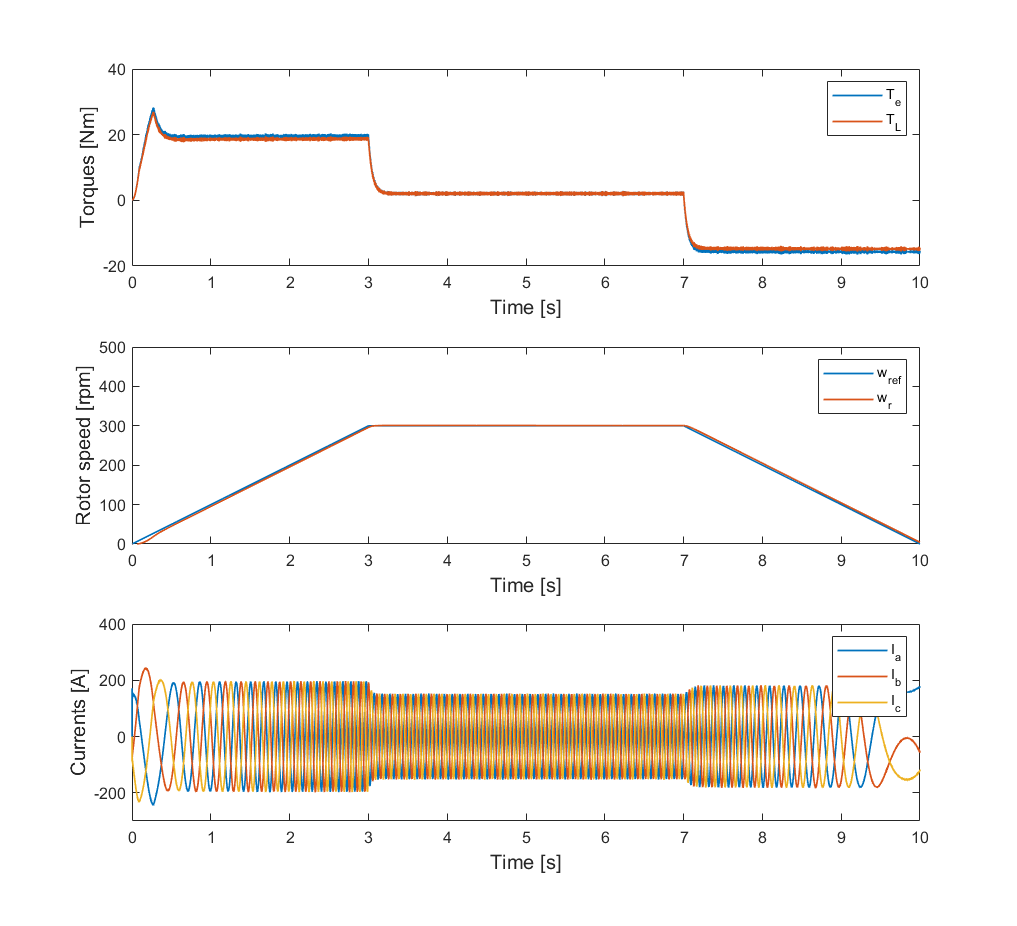
Simulations/2019_05_11 FOC/simulation results/cruise control/speed up to 300rpm and back to 0 10s/T_w_I_n300.png
