NicolaiFransen/SemesterProjectPED2/Simulations/2019_05_11 FOC/simulation results/cruise control/speed varying 0-1500rpm 15s/id_iq_nvarying.png

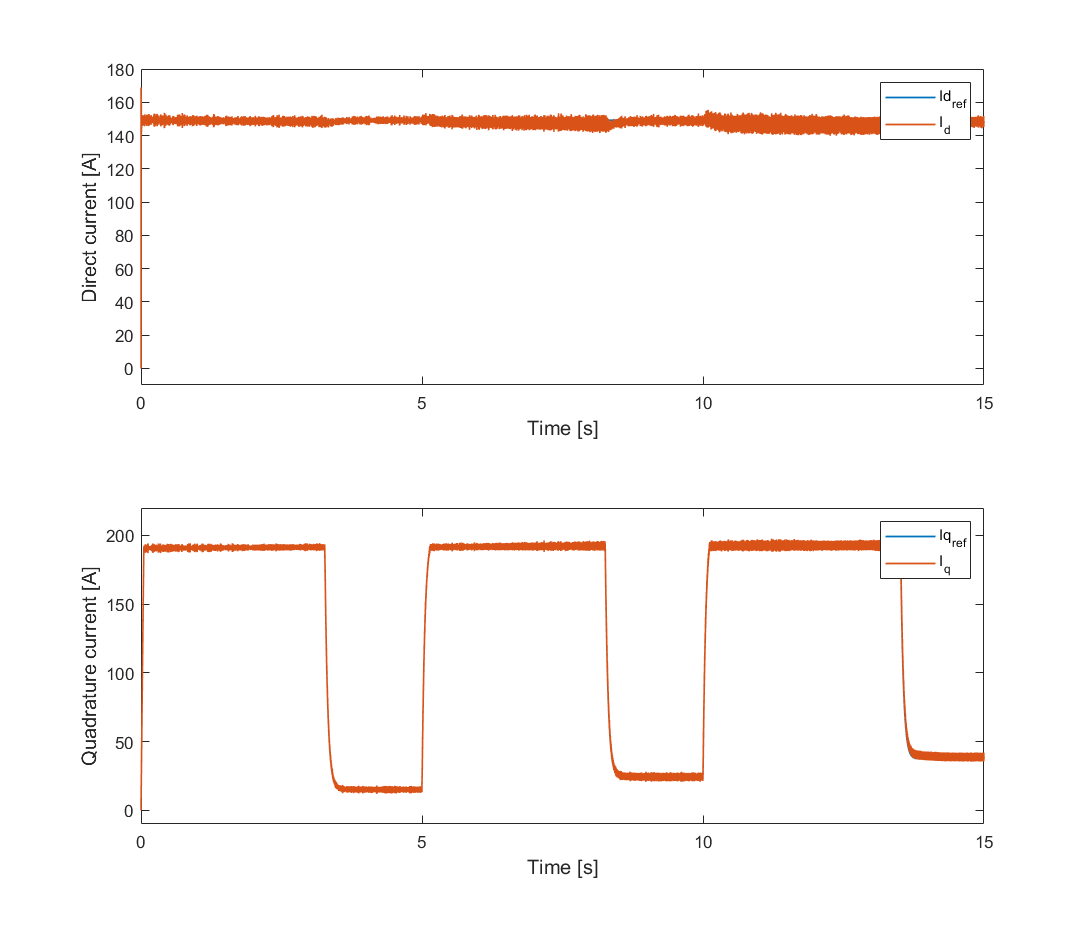
Simulations/2019_05_11 FOC/simulation results/cruise control/speed varying 0-1500rpm 15s/id_iq_nvarying.png
