NicolaiFransen/SemesterProjectPED2/Simulations/2019_05_11 FOC/simulation results/cruise control/untitled.png

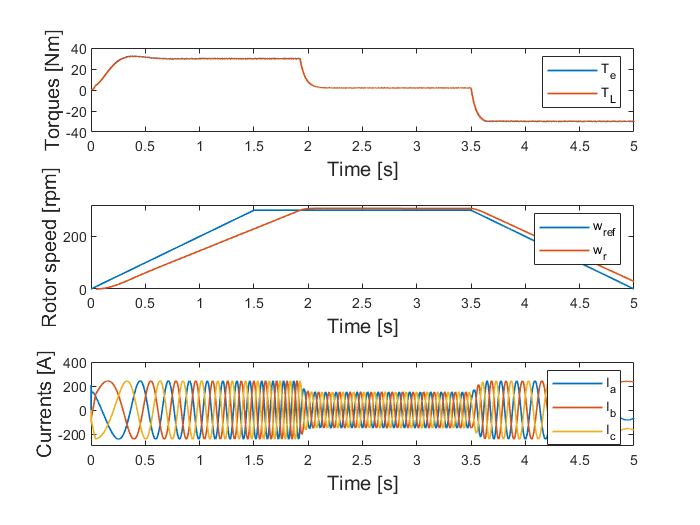
Simulations/2019_05_11 FOC/simulation results/cruise control/untitled.png
