NicolaiFransen/SemesterProjectPED2/Simulations/2019_05_11 FOC/simulation results/torque control/5s simulation/Matlab/torques_Trated_Matlab.png

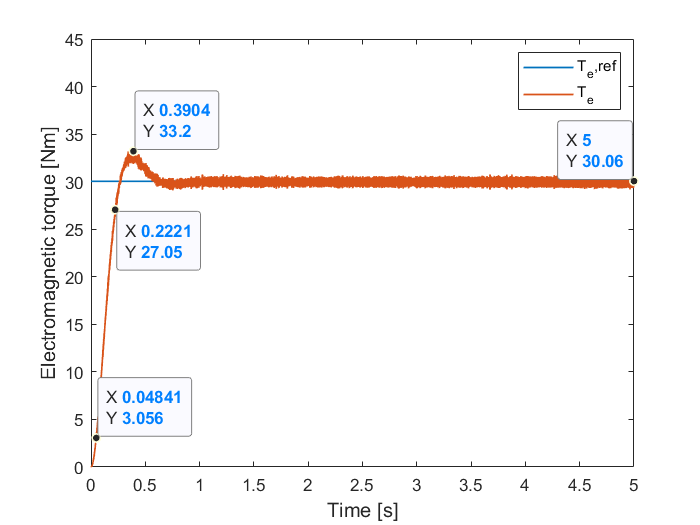
Simulations/2019_05_11 FOC/simulation results/torque control/5s simulation/Matlab/torques_Trated_Matlab.png
