NicolaiFransen/SemesterProjectPED2/Simulations/2019_05_11 FOC/simulation results/torque control/10s simulation/Id_Trated10s.png

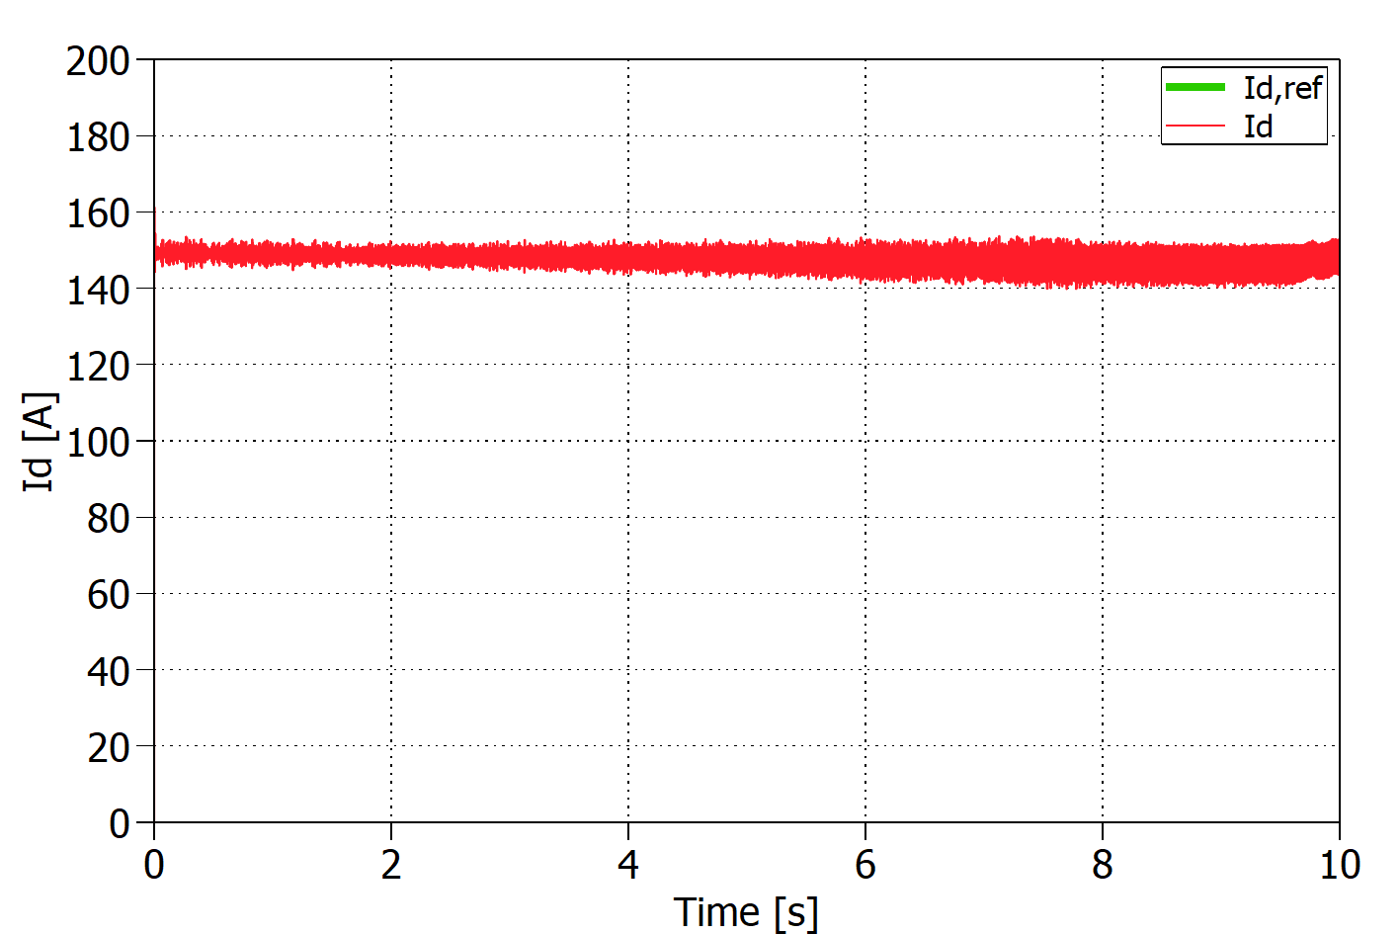
Simulations/2019_05_11 FOC/simulation results/torque control/10s simulation/Id_Trated10s.png
