NicolaiFransen/SemesterProjectPED2/Simulations/2019_05_11 FOC/simulation results/torque control/varying torque negative/Matlab/Id_Tvarying_neg_Matlab_.png

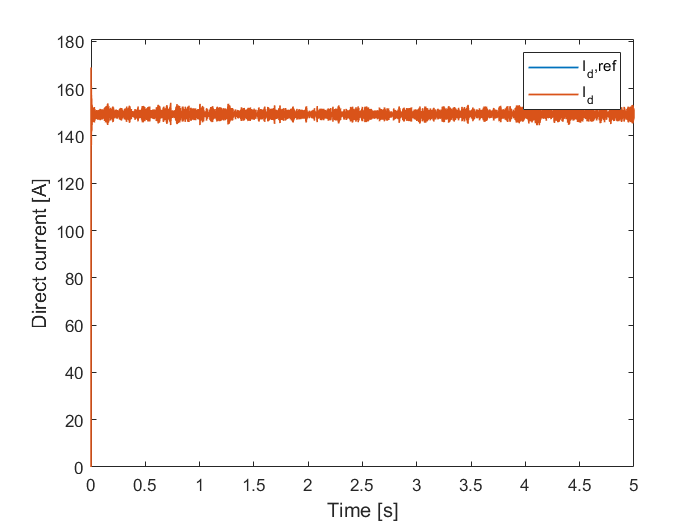
Simulations/2019_05_11 FOC/simulation results/torque control/varying torque negative/Matlab/Id_Tvarying_neg_Matlab_.png
