NicolaiFransen/SemesterProjectPED2/Simulations/2019_05_11 FOC/simulation results/torque control/varying torque negative/Matlab/T_w_I_Tvarying_neg_Matlab.png

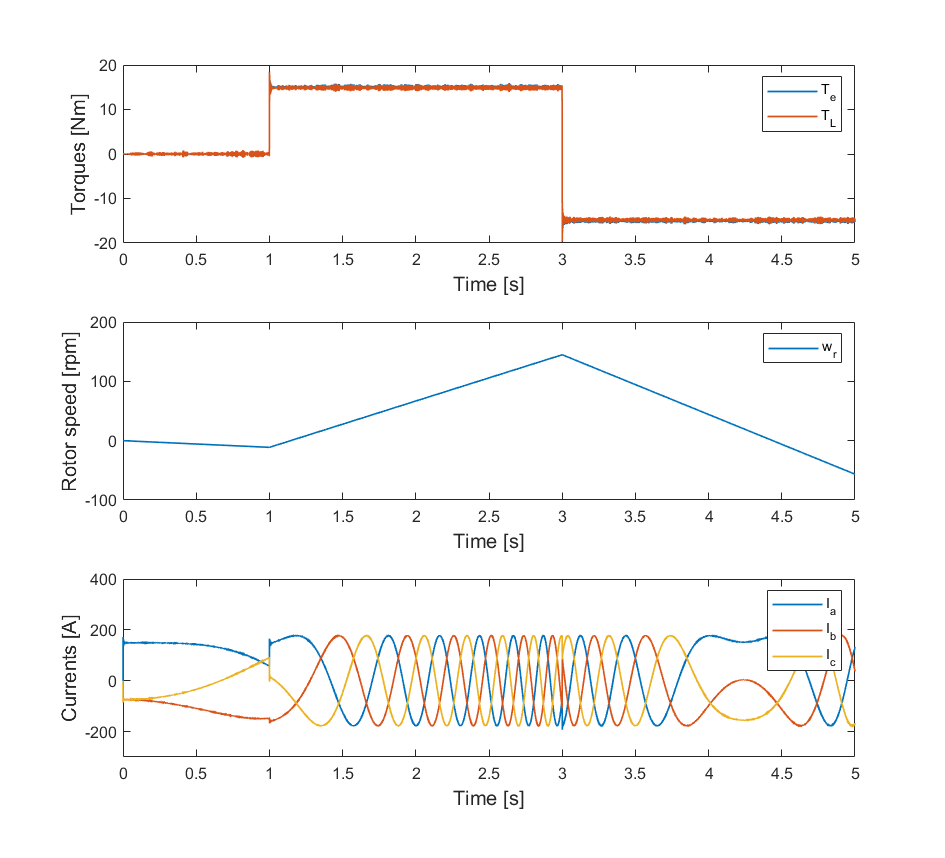
Simulations/2019_05_11 FOC/simulation results/torque control/varying torque negative/Matlab/T_w_I_Tvarying_neg_Matlab.png
