NicolaiFransen/SemesterProjectPED2/Simulations/2019_05_11 FOC/simulation results/torque control/varying torque/Matlab/Iq_Tvarying_Matlab.png

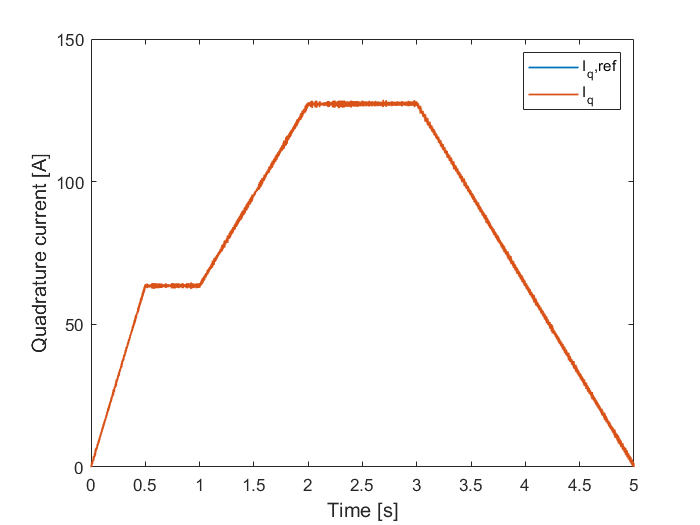
Simulations/2019_05_11 FOC/simulation results/torque control/varying torque/Matlab/Iq_Tvarying_Matlab.png
