NicolaiFransen/SemesterProjectPED2/Simulations/2019_05_11 FOC/simulation results/torque control/varying torque/Matlab/T_w_T_Tvarying_Matlab.png

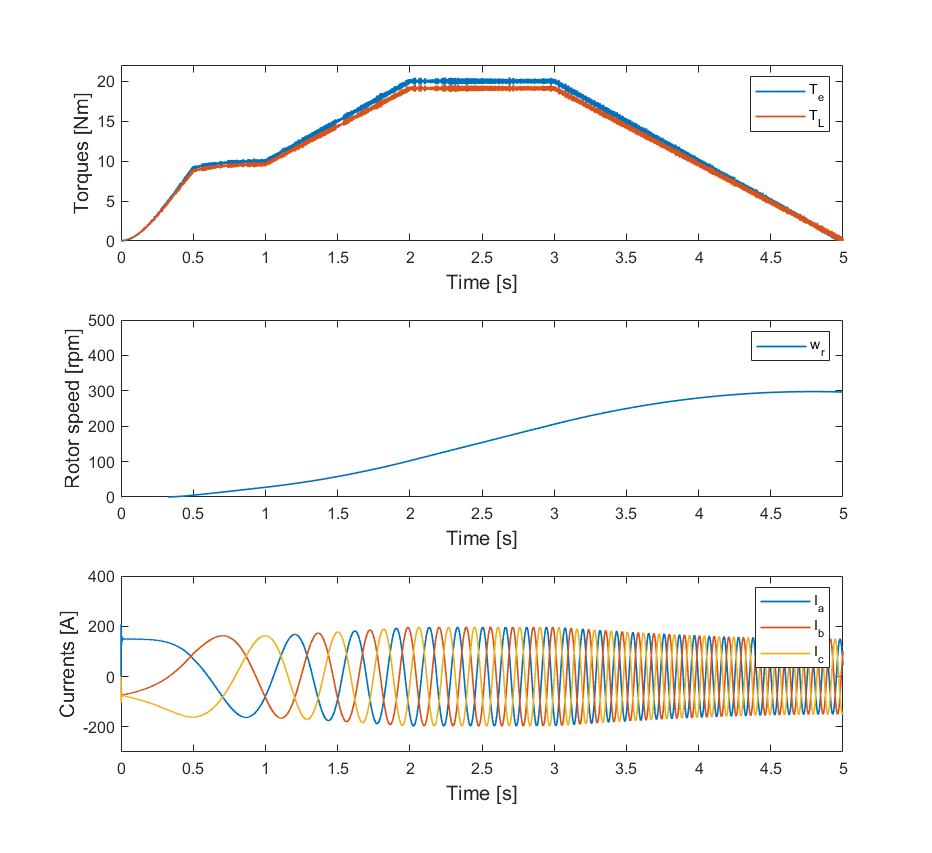
Simulations/2019_05_11 FOC/simulation results/torque control/varying torque/Matlab/T_w_T_Tvarying_Matlab.png
