NicolaiFransen/SemesterProjectPED2/Simulations/Regenerative Braking/Test_current.png

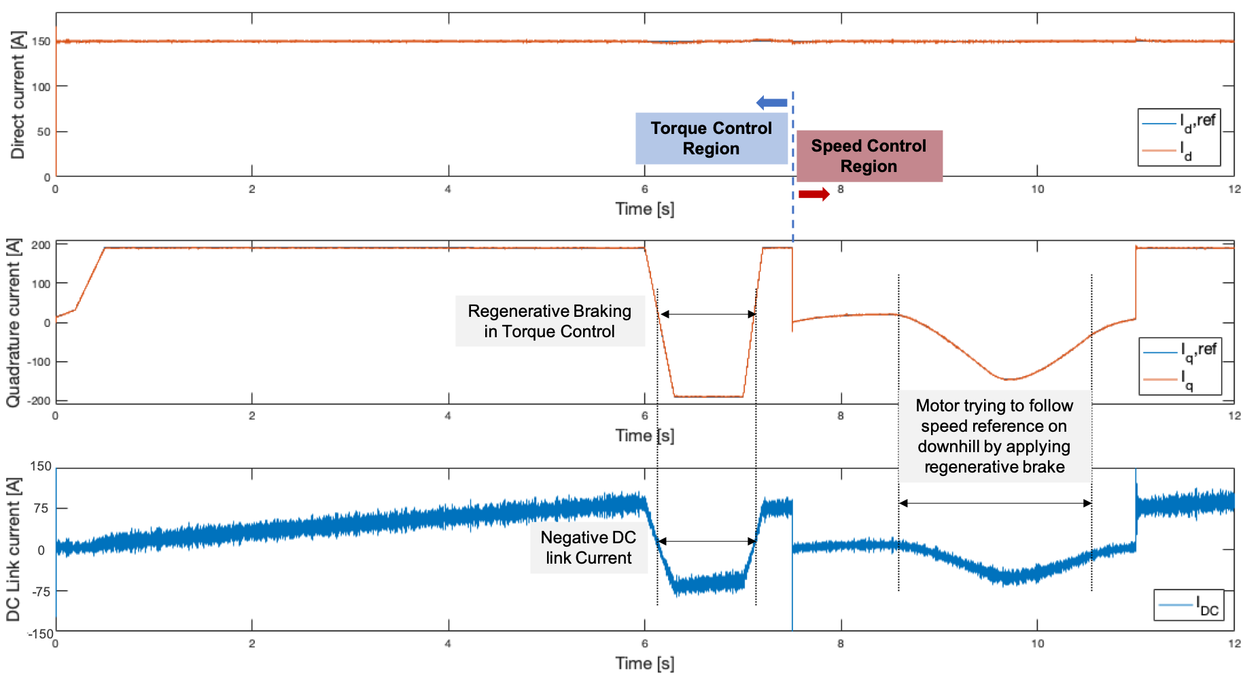
Simulations/Regenerative Braking/Test_current.png
