NicolaiFransen/SemesterProjectPED2/Simulations/Regenerative Braking/Test_torque.png

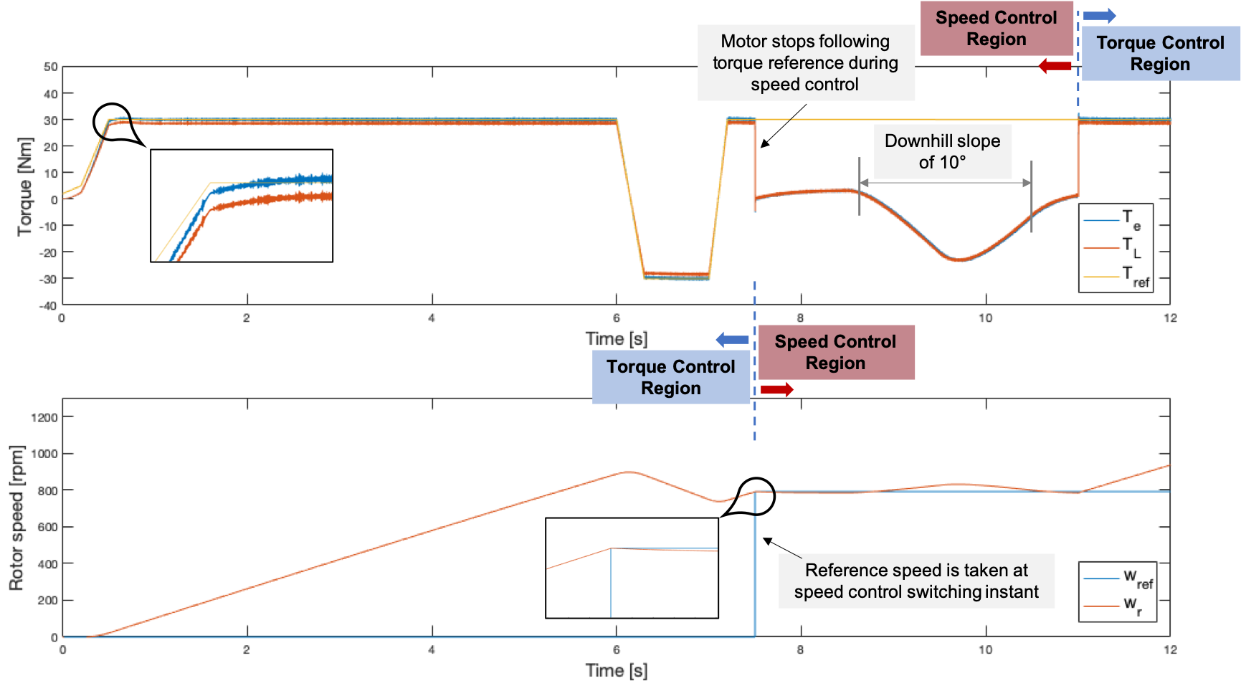
Simulations/Regenerative Braking/Test_torque.png
