NicolaiFransen/SemesterProjectPED2/Simulations/Regenerative Braking/Testbench_abc.png

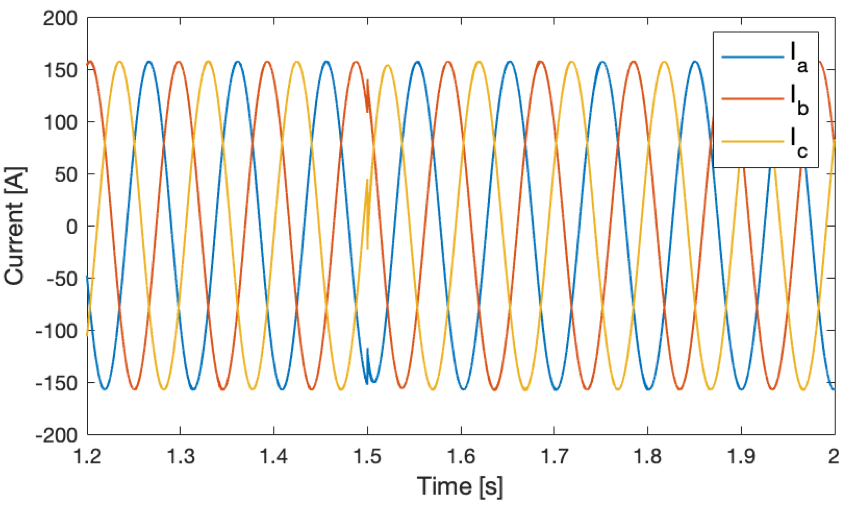
Simulations/Regenerative Braking/Testbench_abc.png
