NicolaiFransen/SemesterProjectPED2/Simulations/Regenerative Braking/Testbench_Current.png

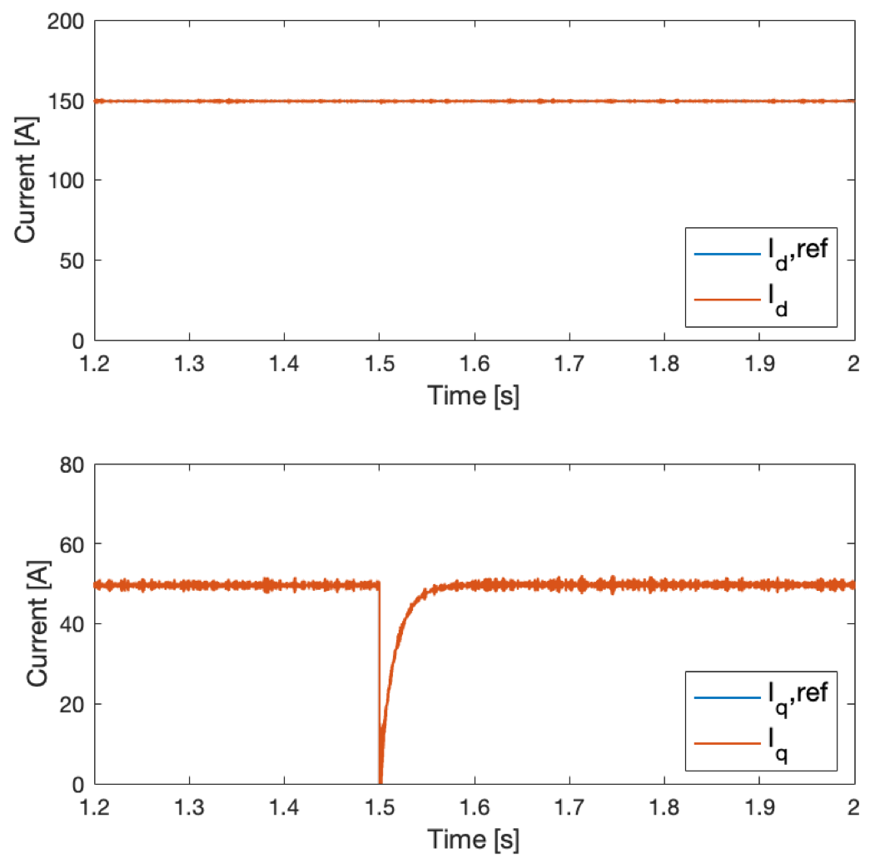
Simulations/Regenerative Braking/Testbench_Current.png
