NicolaiFransen/SemesterProjectPED2/Simulations/Regenerative Braking/TestBench_Torque.png

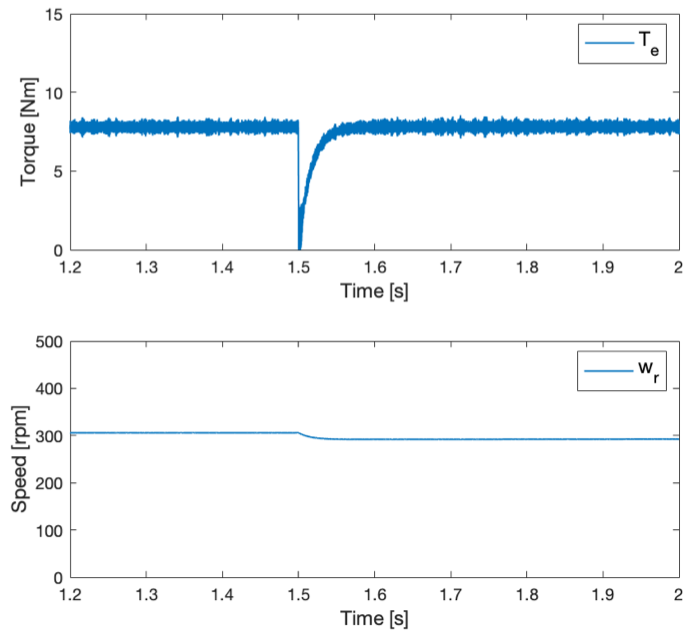
Simulations/Regenerative Braking/TestBench_Torque.png
