NicolaiFransen/SemesterProjectPED2/Software/Testing/UART logs/Testing_13_may/startupTestIdMeasOneEverytwo.png

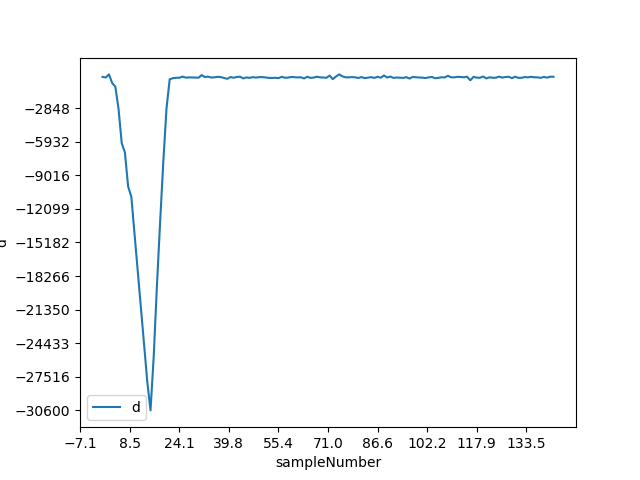
Software/Testing/UART logs/Testing_13_may/startupTestIdMeasOneEverytwo.png
