NicolaiFransen/SemesterProjectPED2/Software/Testing/UART logs/Testing_13_may/startupTestIqMeasOneEverytwo.png

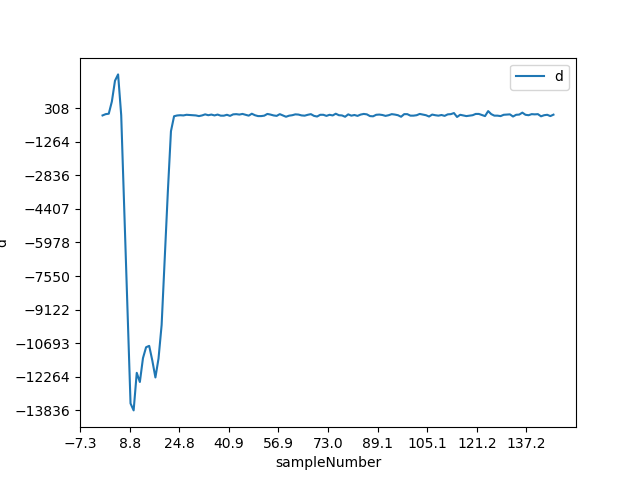
Software/Testing/UART logs/Testing_13_may/startupTestIqMeasOneEverytwo.png
