NicolaiFransen/SemesterProjectPED2/Software/Testing/UART logs/Testing_13_may/startupTesVdRefOneEverytwo2.png

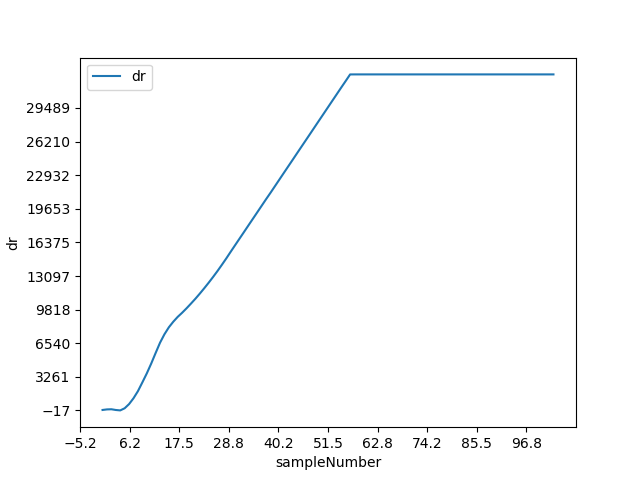
Software/Testing/UART logs/Testing_13_may/startupTesVdRefOneEverytwo2.png
