NicolaiFransen/SemesterProjectPED2/Software/Testing/UART logs/Testing_13_may/startupTesVdRefOneEverytwo.png

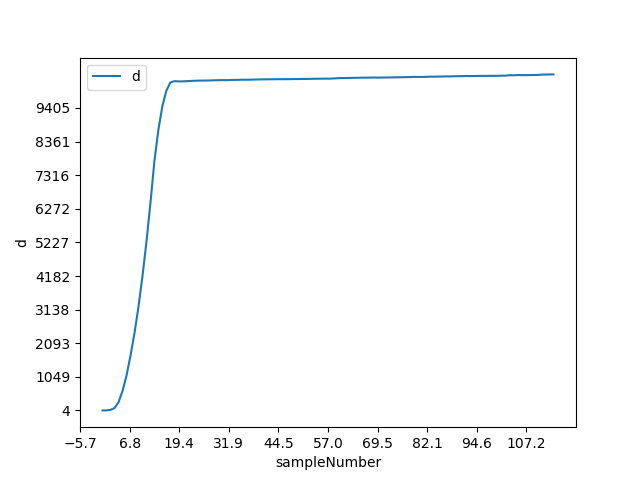
Software/Testing/UART logs/Testing_13_may/startupTesVdRefOneEverytwo.png
