NicolaiFransen/SemesterProjectPED2/Tests/2019_05_22_FOC_Tests/TorqueRefChange/tek0003.png

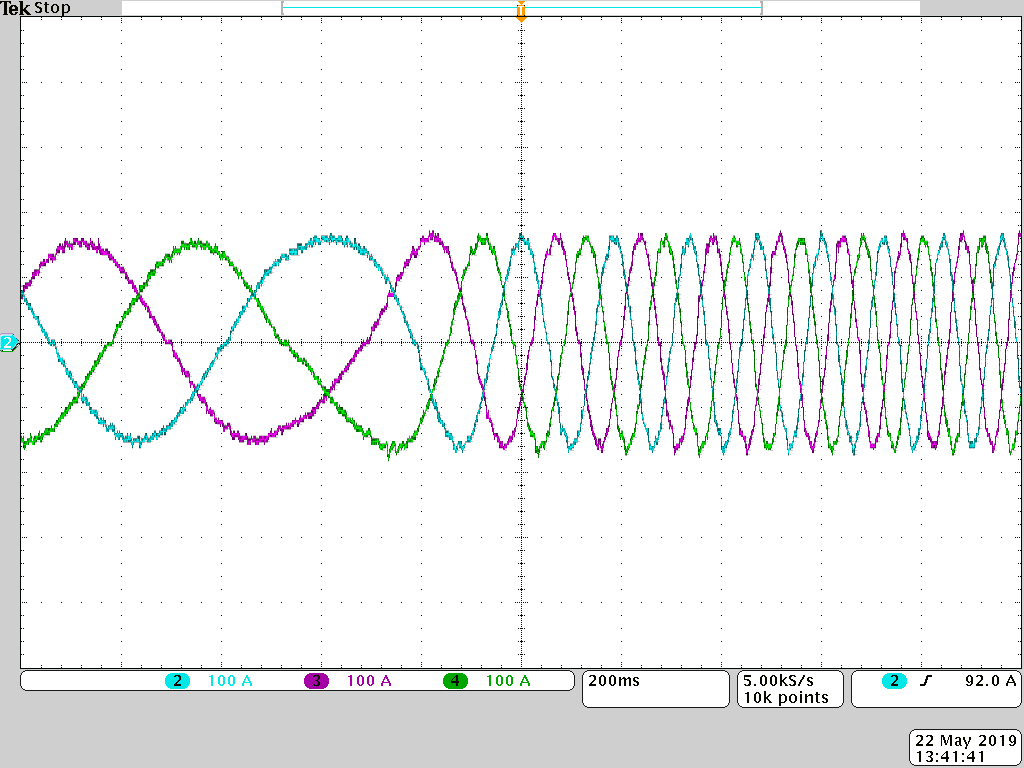
Tests/2019_05_22_FOC_Tests/TorqueRefChange/tek0003.png
