NicolaiFransen/SemesterProjectPED2/Tests/2019_05_22_FOC_Tests/TorqueSteadyState/tek0000.png

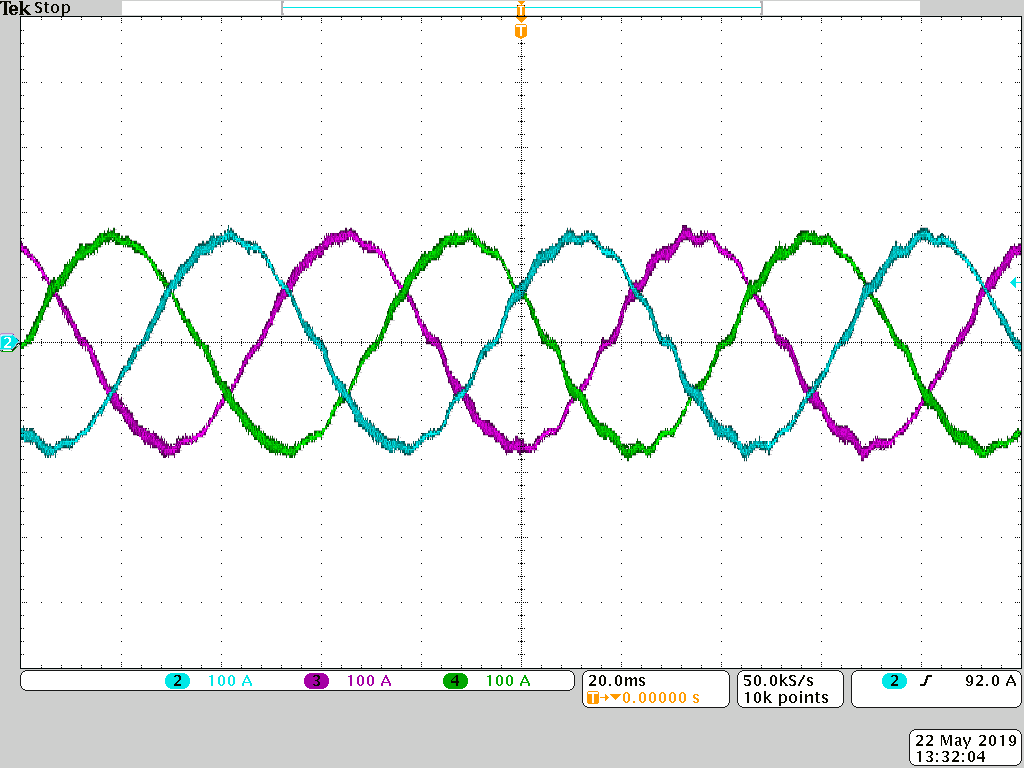
Tests/2019_05_22_FOC_Tests/TorqueSteadyState/tek0000.png
