NicolaiFransen/SemesterProjectPED2/Tests/040419_Thermocouple Test/FLIR0176.jpg

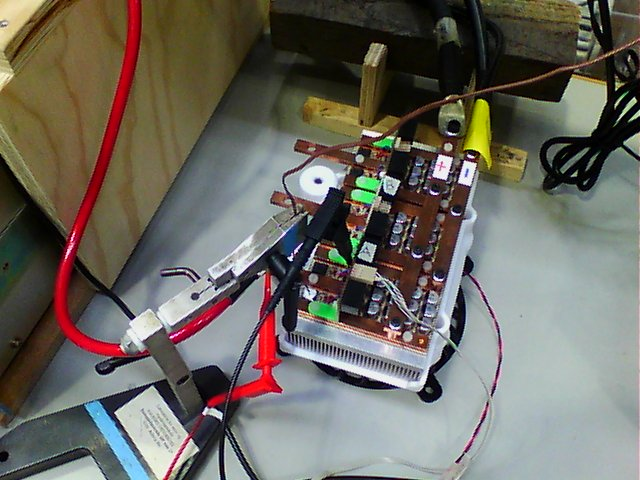
Tests/040419_Thermocouple Test/FLIR0176.jpg
