NicolaiFransen/SemesterProjectPED2/Tests/040419_Thermocouple Test/FLIR0178.jpg

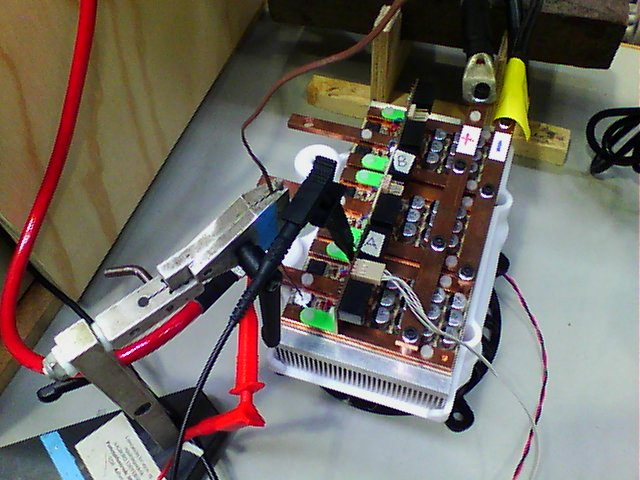
Tests/040419_Thermocouple Test/FLIR0178.jpg
