NicolaiFransen/SemesterProjectPED2/Tests/040419_Thermocouple Test/FLIR0181.jpg

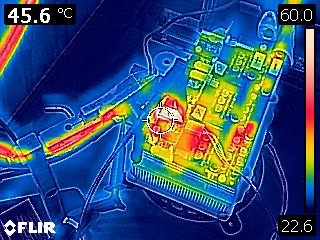
Tests/040419_Thermocouple Test/FLIR0181.jpg
