NicolaiFransen/SemesterProjectPED2/Tests/040419_Thermocouple Test/FLIR0182.jpg

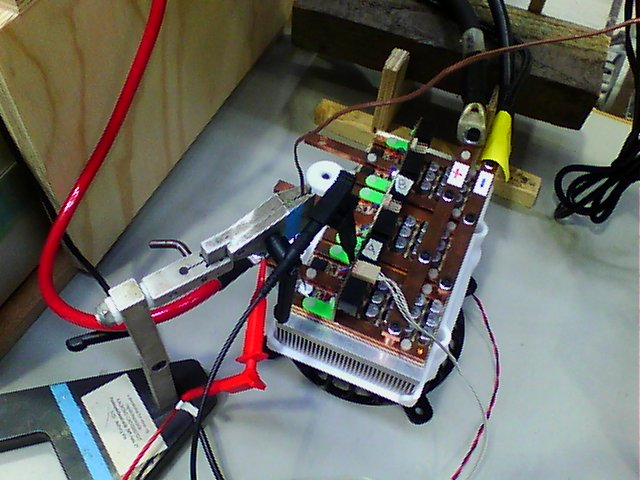
Tests/040419_Thermocouple Test/FLIR0182.jpg
