NicolaiFransen/SemesterProjectPED2/Tests/040419_Thermocouple Test/FLIR0185.jpg

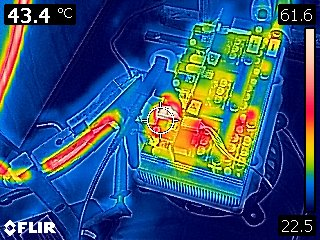
Tests/040419_Thermocouple Test/FLIR0185.jpg
