NicolaiFransen/SemesterProjectPED2/Tests/040419_Thermocouple Test/FLIR0186.jpg

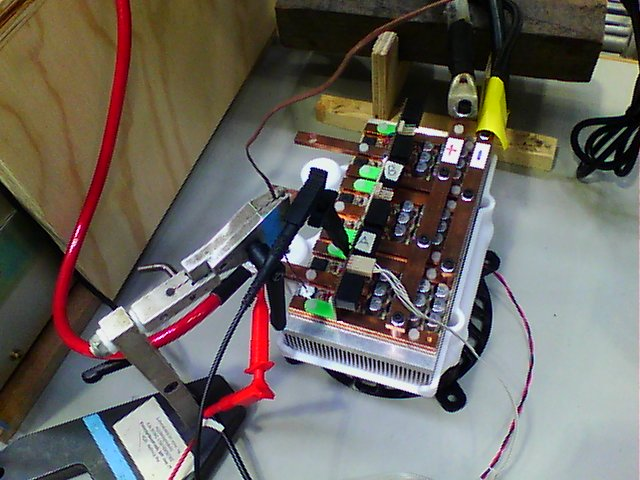
Tests/040419_Thermocouple Test/FLIR0186.jpg
