NicolaiFransen/SemesterProjectPED2/Tests/120219_PreparatION for No load (Picture)/Drain Source under no-load.png

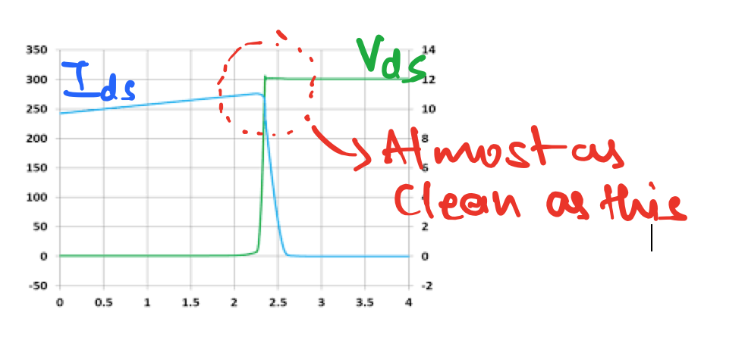
Tests/120219_PreparatION for No load (Picture)/Drain Source under no-load.png
