NicolaiFransen/SemesterProjectPED2/Tests/120219_PreparatION for No load (Picture)/Miller Effect expected on Vgs.png

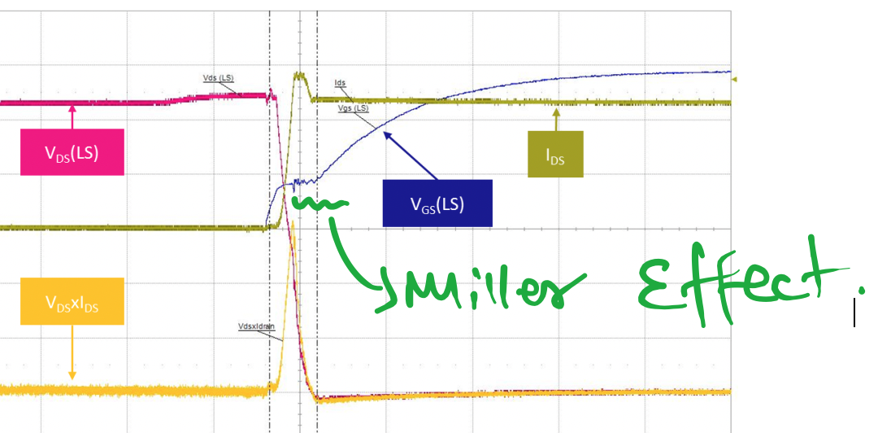
Tests/120219_PreparatION for No load (Picture)/Miller Effect expected on Vgs.png
