NicolaiFransen/SemesterProjectPED2/Tests/130319_150A Inverter test/Pictures/509aa57f-3c78-4758-8406-ace8dbe65133 2.JPG

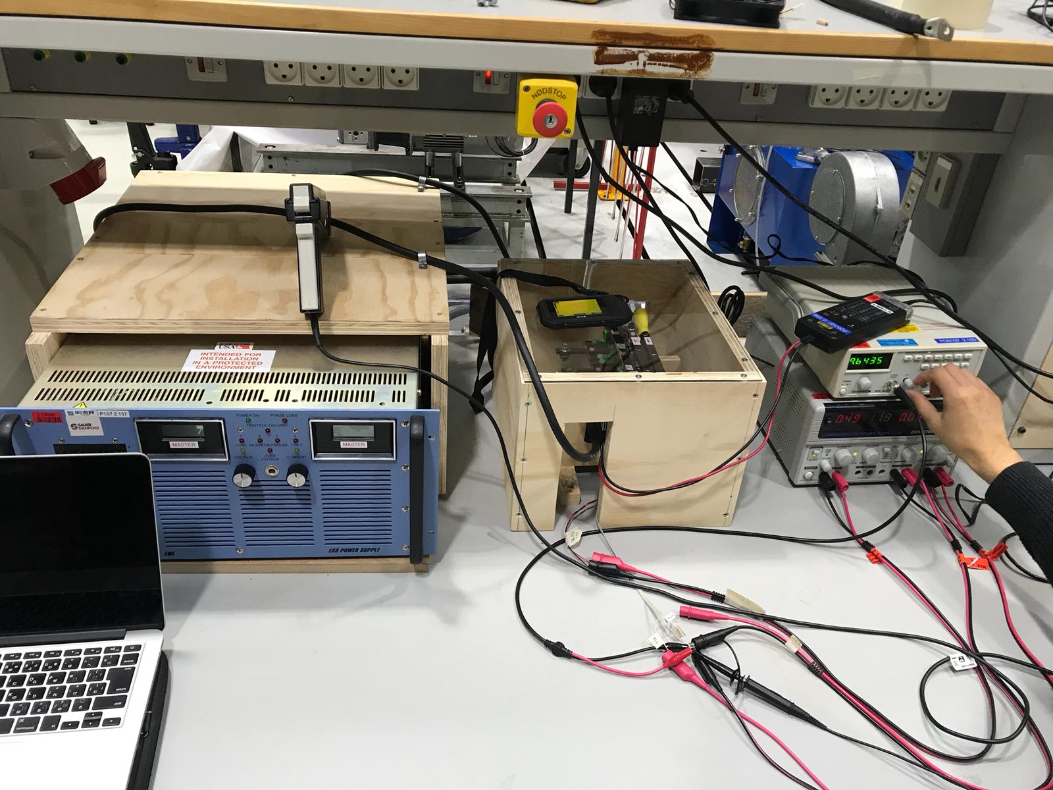
Tests/130319_150A Inverter test/Pictures/509aa57f-3c78-4758-8406-ace8dbe65133 2.JPG
