NicolaiFransen/SemesterProjectPED2/Tests/130319_150A Inverter test/Pictures/47345e77-374b-4dc0-9069-c29379c46f39 2.JPG

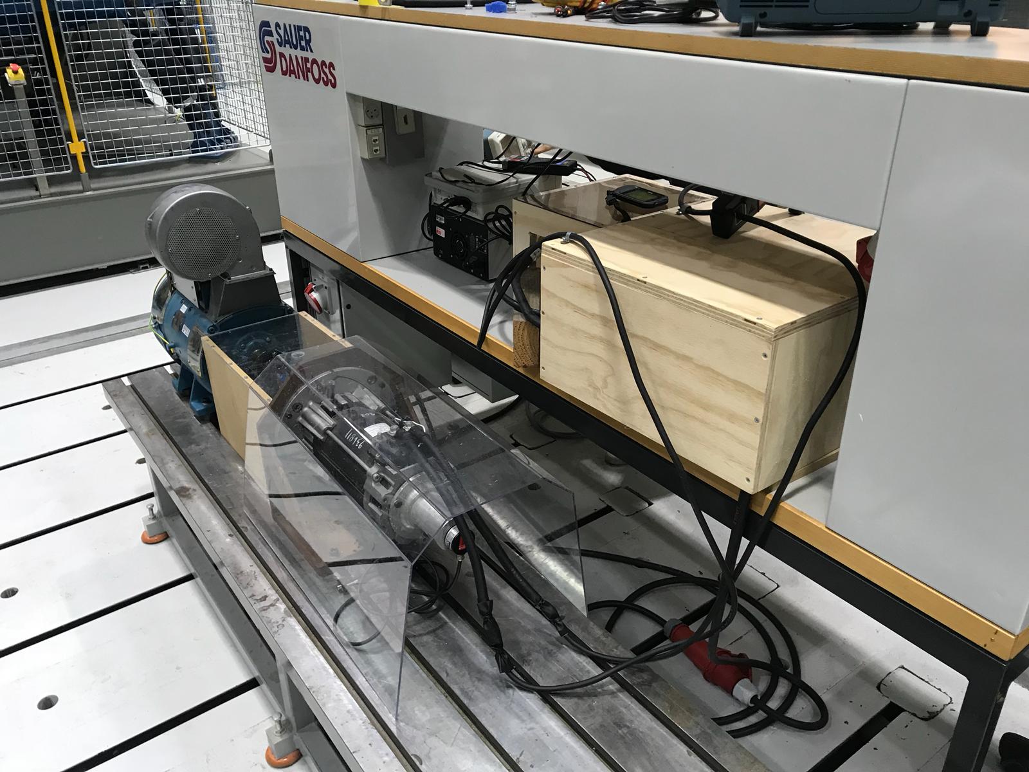
Tests/130319_150A Inverter test/Pictures/47345e77-374b-4dc0-9069-c29379c46f39 2.JPG
