NicolaiFransen/SemesterProjectPED2/Tests/130319_150A Inverter test/Thermal Camera/FLIR0119.jpg

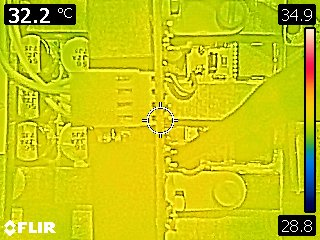
Tests/130319_150A Inverter test/Thermal Camera/FLIR0119.jpg
