NicolaiFransen/SemesterProjectPED2/Tests/130319_150A Inverter test/Thermal Camera/FLIR0120.jpg

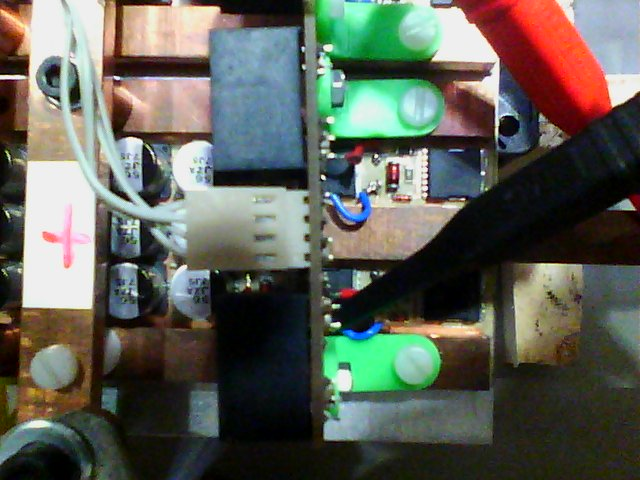
Tests/130319_150A Inverter test/Thermal Camera/FLIR0120.jpg
