NicolaiFransen/SemesterProjectPED2/Tests/140219_No Load Tests results/LegA/TEK00003_test3.PNG

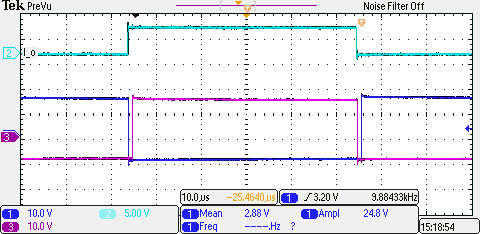
Tests/140219_No Load Tests results/LegA/TEK00003_test3.PNG
