NicolaiFransen/SemesterProjectPED2/Tests/140219_No Load Tests results/LegA/Vgs_PWM_legA_test1.PNG

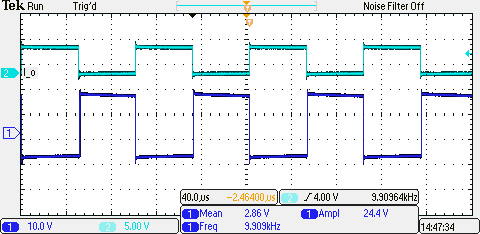
Tests/140219_No Load Tests results/LegA/Vgs_PWM_legA_test1.PNG
