NicolaiFransen/SemesterProjectPED2/Tests/200219_Load Test inverter/Leg A/10V_duty 50.PNG

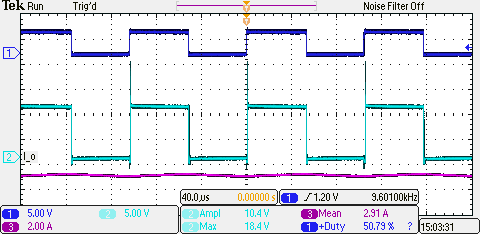
Tests/200219_Load Test inverter/Leg A/10V_duty 50.PNG
