NicolaiFransen/SemesterProjectPED2/Tests/200219_Load Test inverter/Leg A/26V_duty 30.PNG

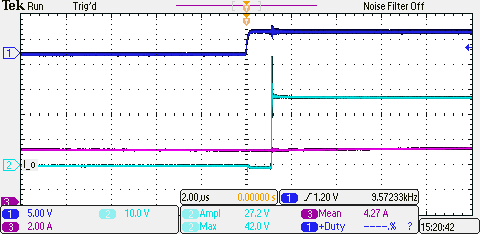
Tests/200219_Load Test inverter/Leg A/26V_duty 30.PNG
