NicolaiFransen/SemesterProjectPED2/Tests/200219_Load Test inverter/Leg C/26V_duty 30_zoomed_differential.PNG

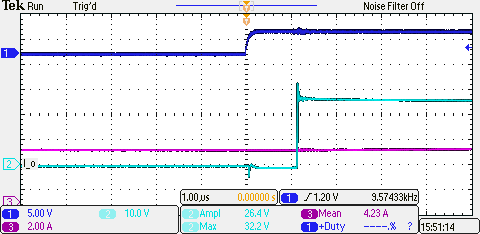
Tests/200219_Load Test inverter/Leg C/26V_duty 30_zoomed_differential.PNG
