NicolaiFransen/SemesterProjectPED2/Tests/200219_Load Test inverter/Leg C/36V_duty 50 differential.jpg

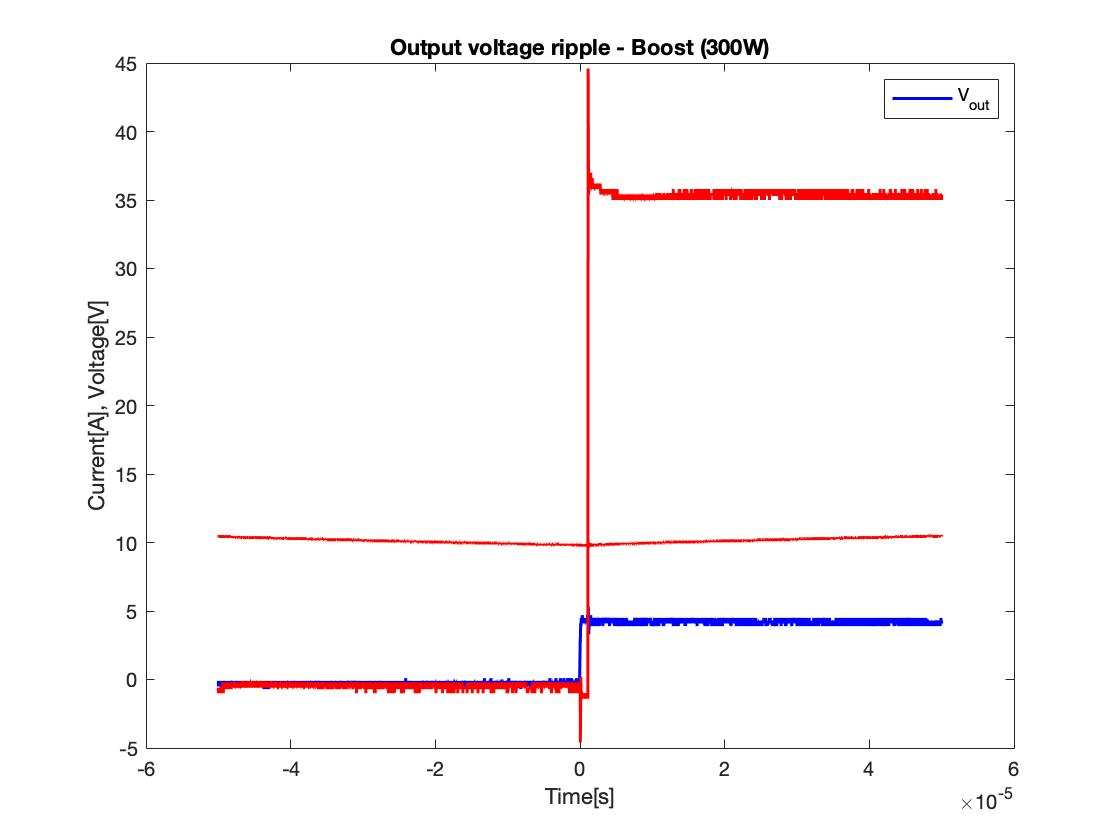
Tests/200219_Load Test inverter/Leg C/36V_duty 50 differential.jpg
