NicolaiFransen/SemesterProjectPED2/Tests/200219_Load Test inverter/Leg C/36V_duty 50_zoomed_differential.PNG

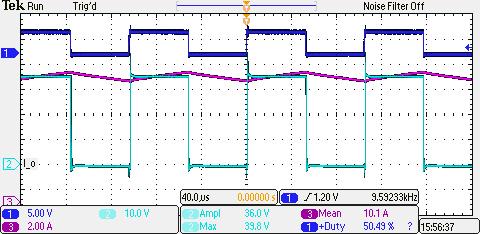
Tests/200219_Load Test inverter/Leg C/36V_duty 50_zoomed_differential.PNG
