NicolaiFransen/SemesterProjectPED2/Tests/200319_Thermal Camera Pictures/FLIR0123.jpg

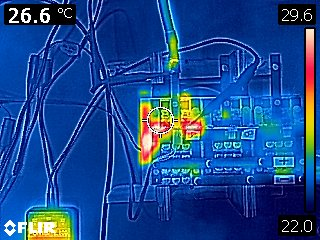
Tests/200319_Thermal Camera Pictures/FLIR0123.jpg
