NicolaiFransen/SemesterProjectPED2/Tests/200319_Thermal Camera Pictures/FLIR0125.jpg

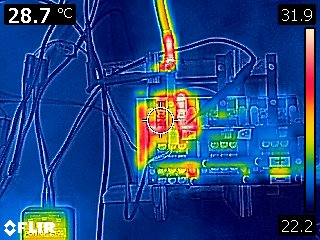
Tests/200319_Thermal Camera Pictures/FLIR0125.jpg
