NicolaiFransen/SemesterProjectPED2/Tests/200319_Thermal Camera Pictures/FLIR0133.jpg

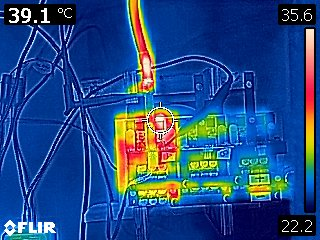
Tests/200319_Thermal Camera Pictures/FLIR0133.jpg
