NicolaiFransen/SemesterProjectPED2/Tests/200319_Thermal Camera Pictures/FLIR0145.jpg

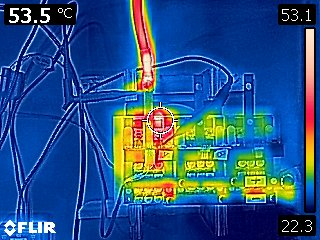
Tests/200319_Thermal Camera Pictures/FLIR0145.jpg
