NicolaiFransen/SemesterProjectPED2/Tests/200319_Thermal Camera Pictures/FLIR0147.jpg

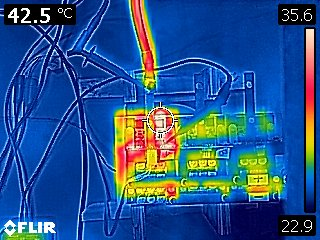
Tests/200319_Thermal Camera Pictures/FLIR0147.jpg
