NicolaiFransen/SemesterProjectPED2/Tests/200319_Thermal Camera Pictures/FLIR0161.jpg

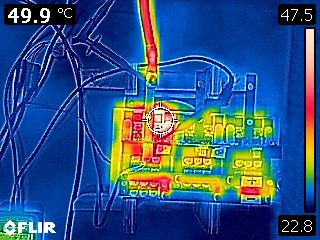
Tests/200319_Thermal Camera Pictures/FLIR0161.jpg
