NicolaiFransen/SemesterProjectPED2/Tests/20190502_ErrorReactionTime/ErrorReactionTime_HighPriority.png

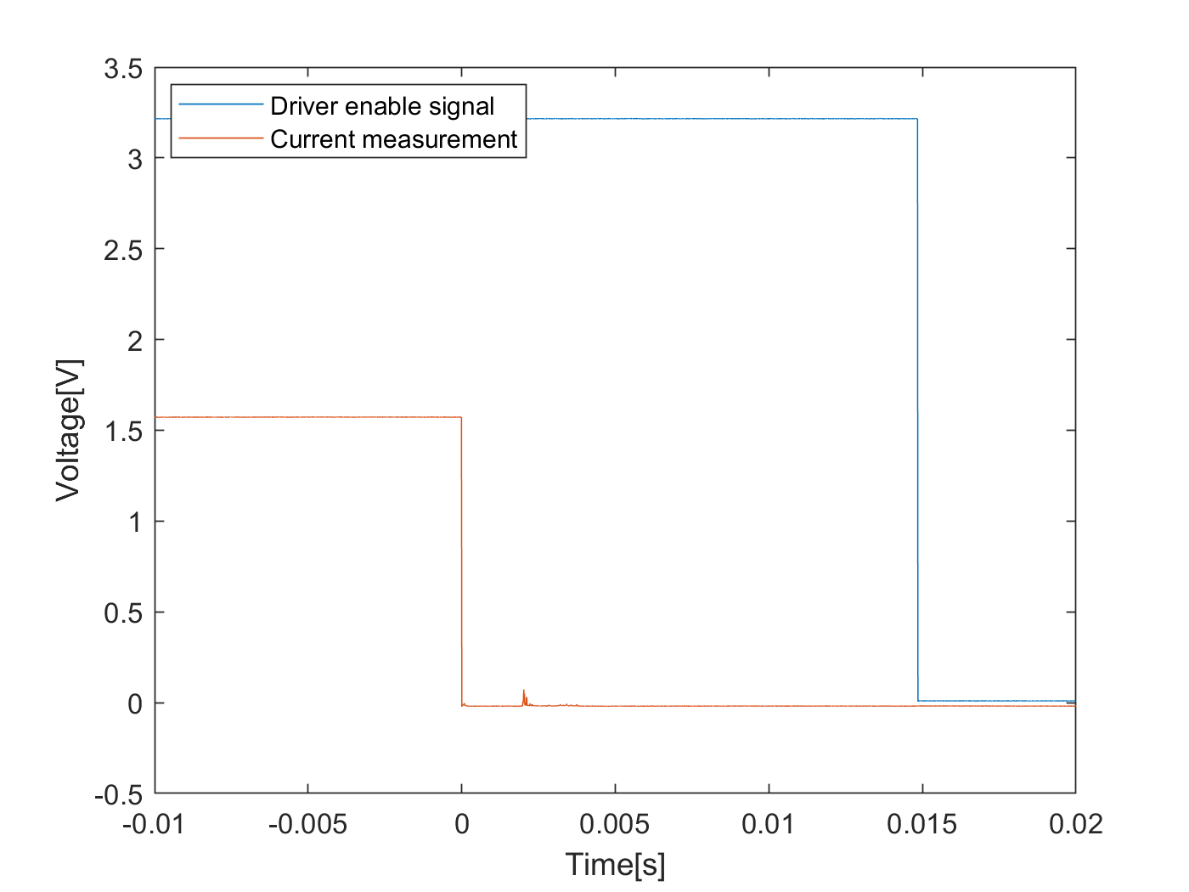
Tests/20190502_ErrorReactionTime/ErrorReactionTime_HighPriority.png
