NicolaiFransen/SemesterProjectPED2/Tests/20190502_ErrorReactionTime/ErrorReactionTime_HighPriority_500FilterBW.png

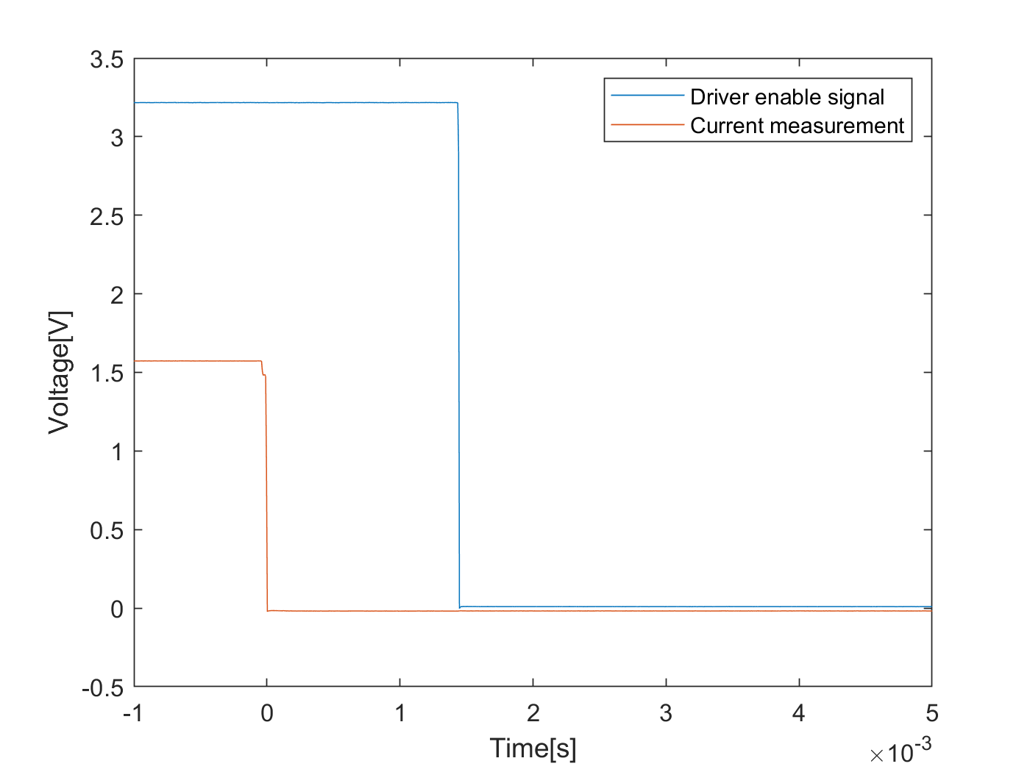
Tests/20190502_ErrorReactionTime/ErrorReactionTime_HighPriority_500FilterBW.png
