NicolaiFransen/SemesterProjectPED2/Tests/20190502_ErrorReactionTime/ErrorReactionTime_HighPriority_5000FilterBW.png

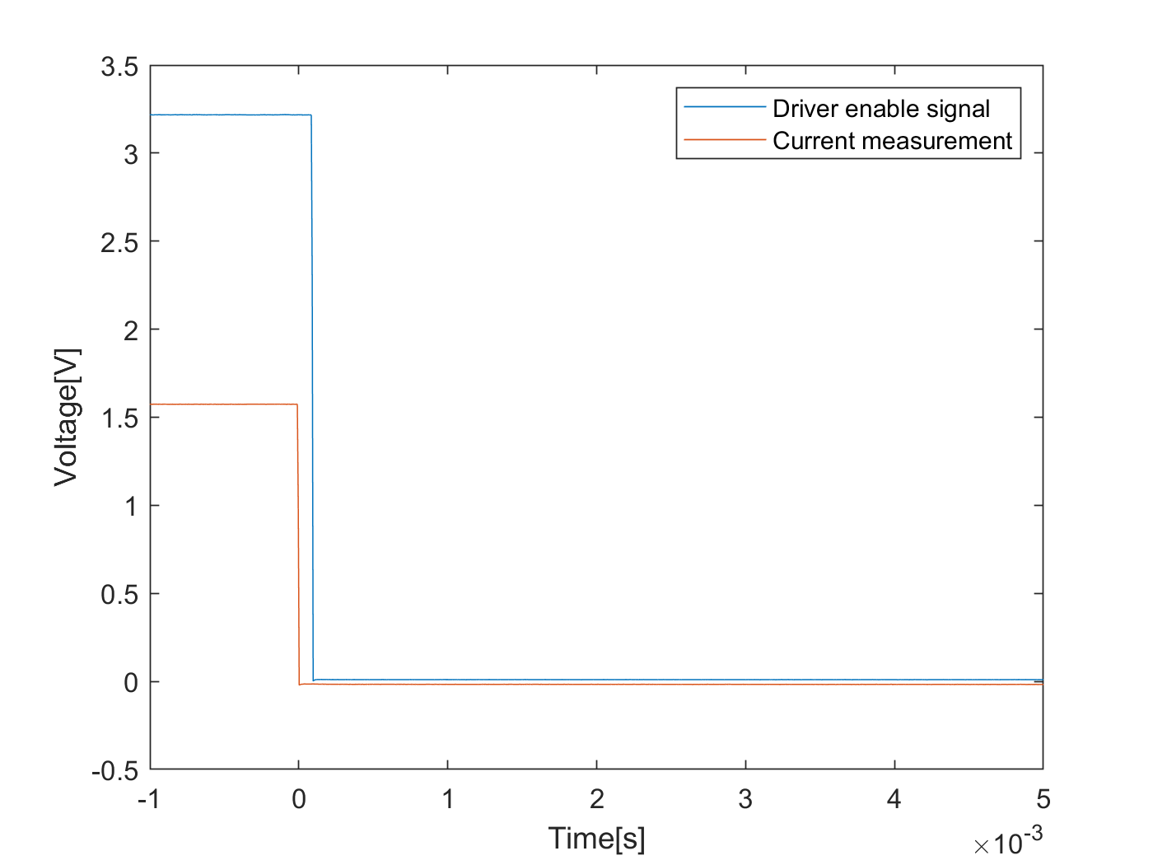
Tests/20190502_ErrorReactionTime/ErrorReactionTime_HighPriority_5000FilterBW.png
