NicolaiFransen/SemesterProjectPED2/Tests/20190502_ErrorReactionTime/HarwareFilterReaction_500Hz.PNG

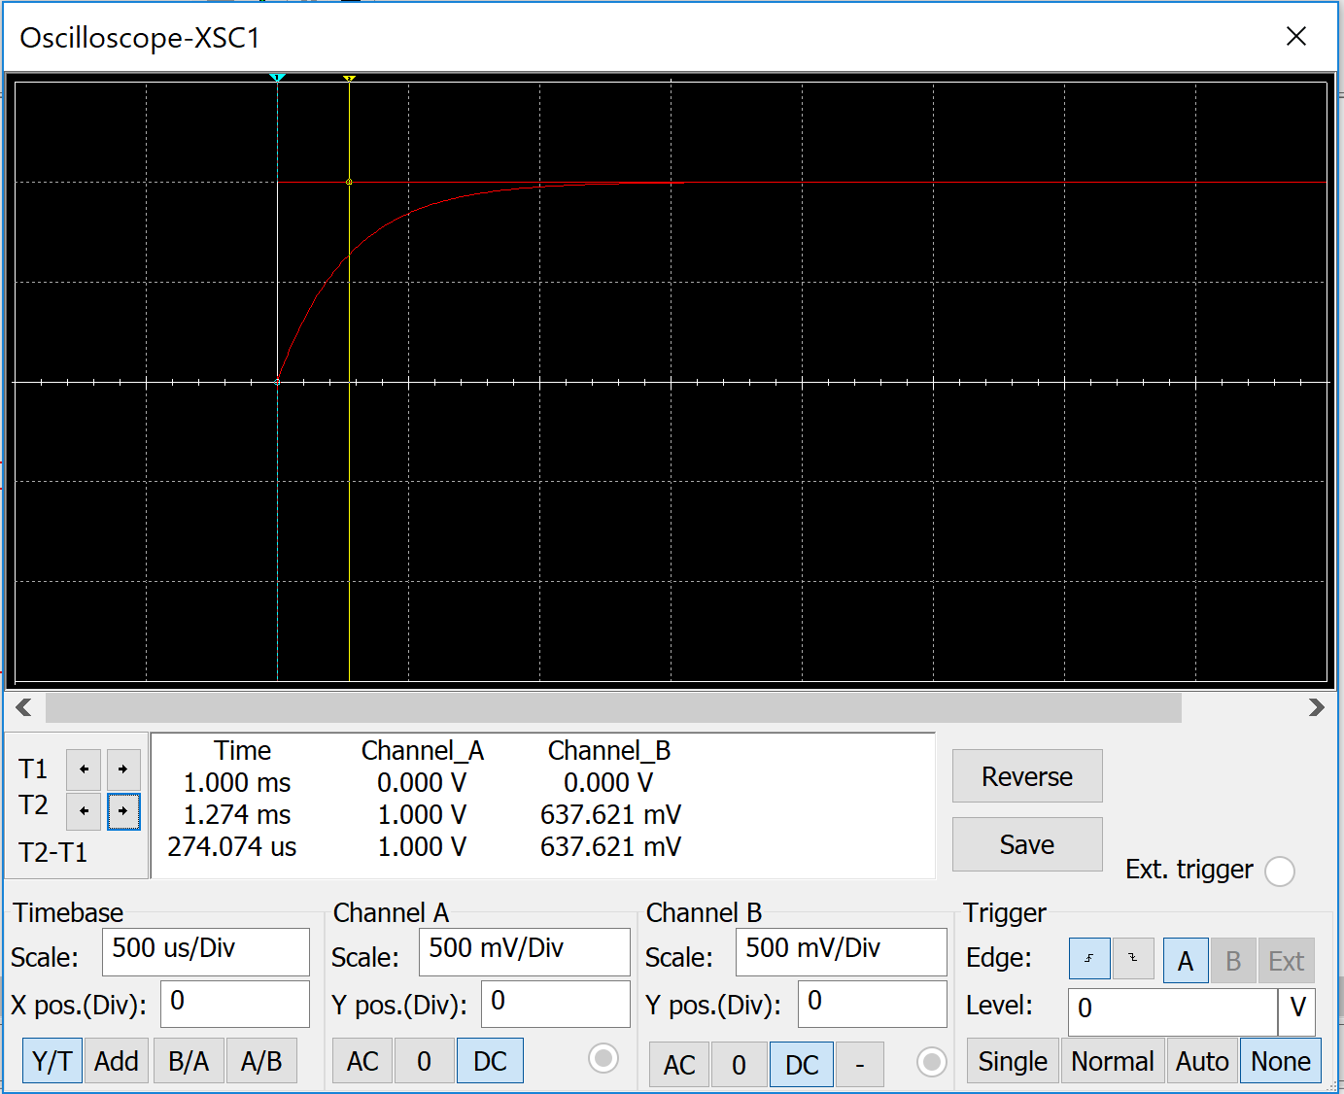
Tests/20190502_ErrorReactionTime/HarwareFilterReaction_500Hz.PNG
