NicolaiFransen/SemesterProjectPED2/Tests/20190522_FOC_integrationTest/tests210519/tek0010.png

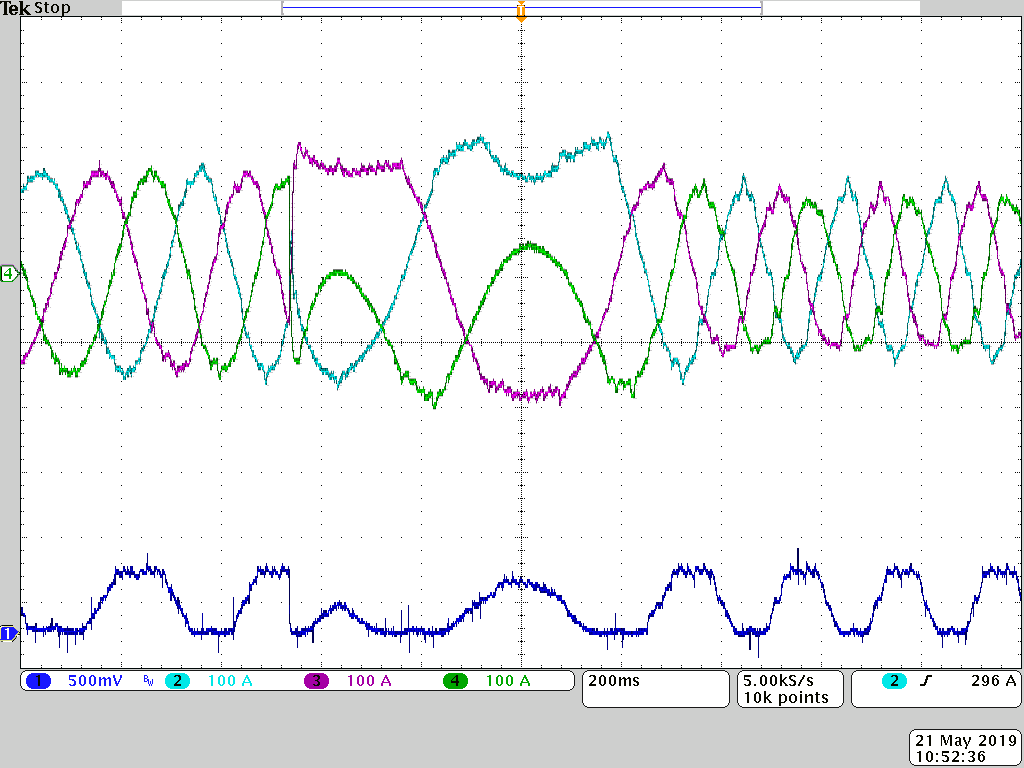
Tests/20190522_FOC_integrationTest/tests210519/tek0010.png
