NicolaiFransen/SemesterProjectPED2/Tests/20190522_FOC_integrationTest/tests210519/tek0012.png

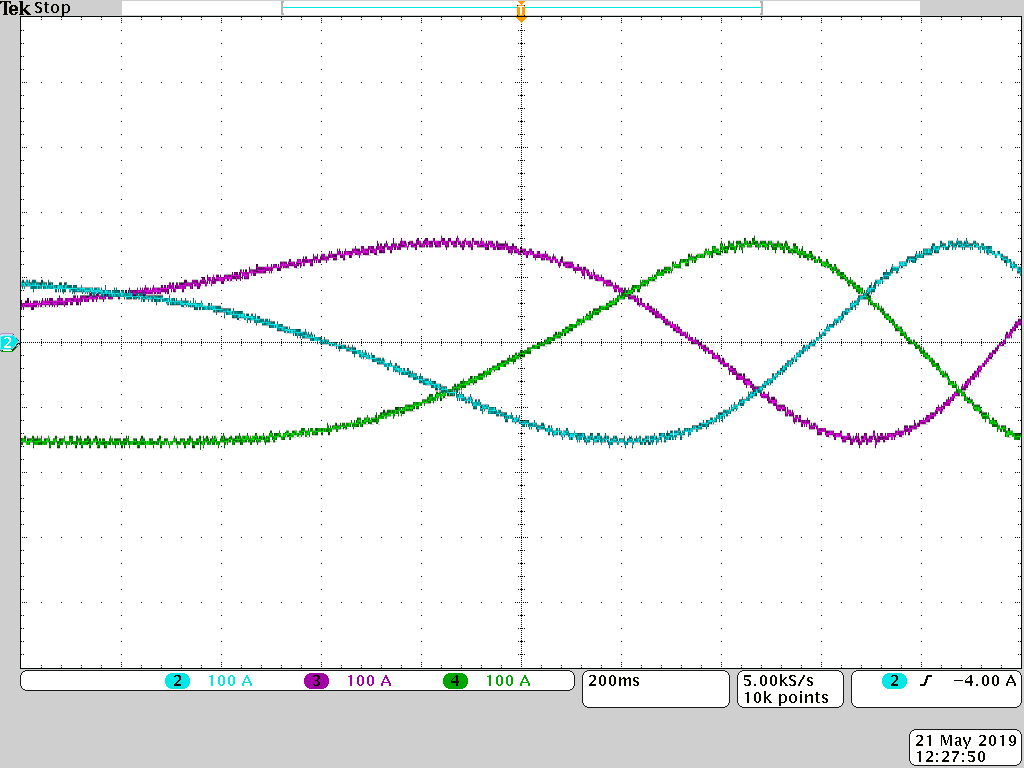
Tests/20190522_FOC_integrationTest/tests210519/tek0012.png
