NicolaiFransen/SemesterProjectPED2/Tests/20190522_FOC_integrationTest/tests210519/tek0014.png

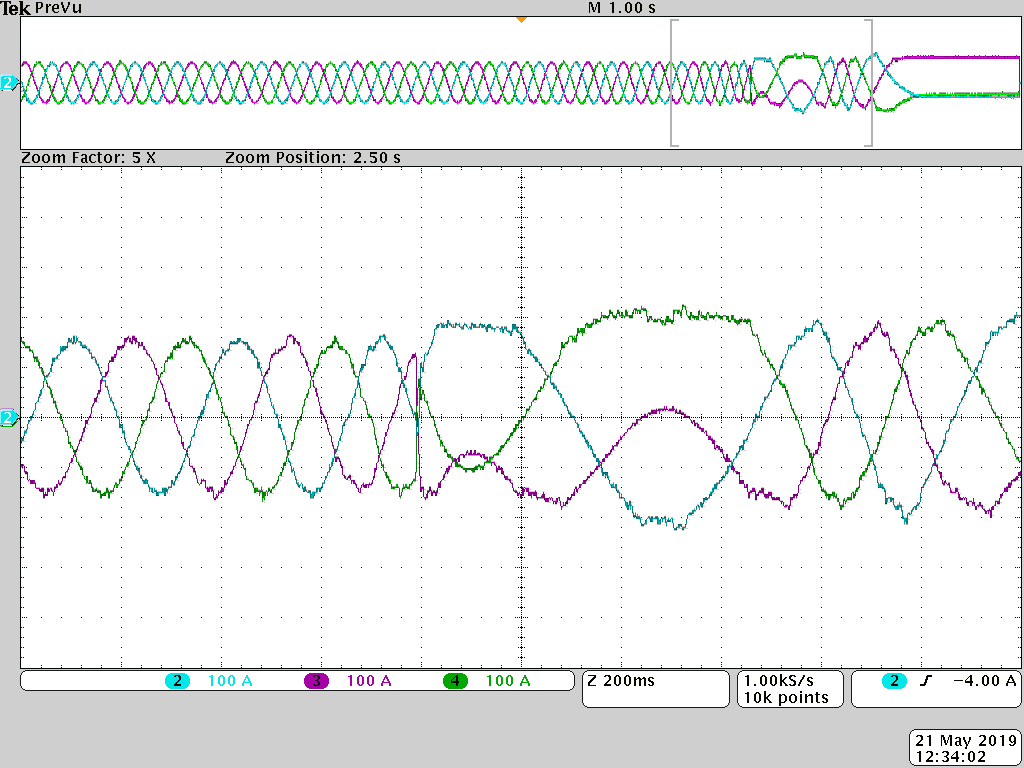
Tests/20190522_FOC_integrationTest/tests210519/tek0014.png
