NicolaiFransen/SemesterProjectPED2/Tests/20190524_Cruise_and_Torque_Tests/_Scope_pictures/tek0004.png

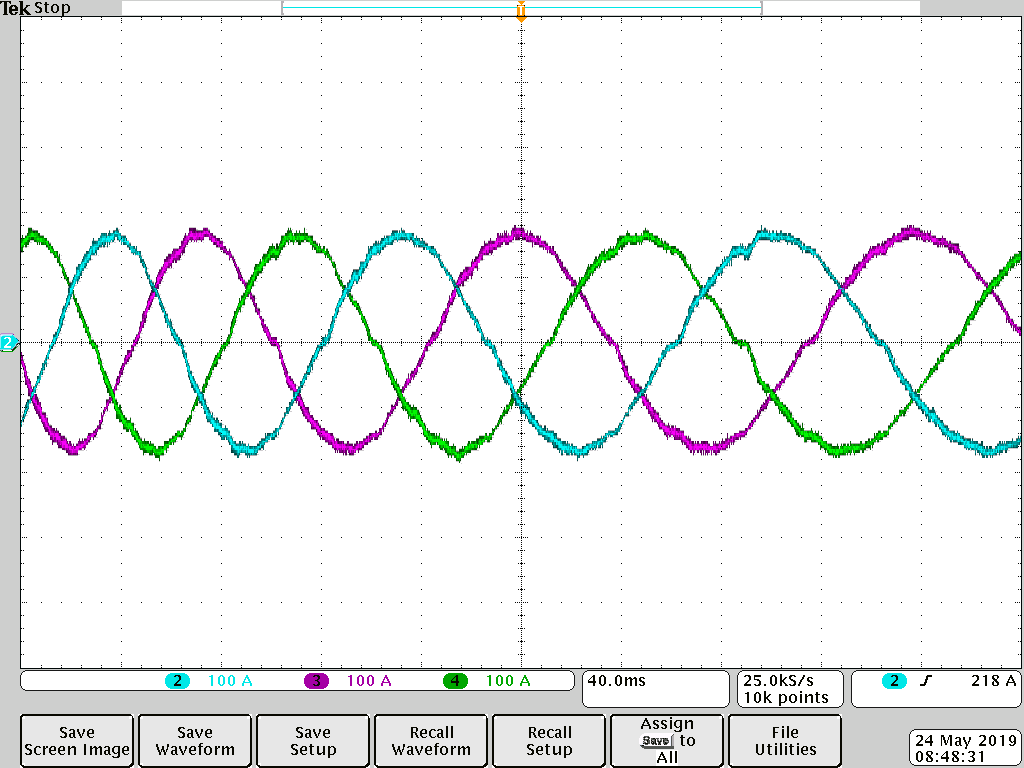
Tests/20190524_Cruise_and_Torque_Tests/_Scope_pictures/tek0004.png
