NicolaiFransen/SemesterProjectPED2/Tests/20190524_Cruise_and_Torque_Tests/_Torque_sensor/SteadyState.bmp

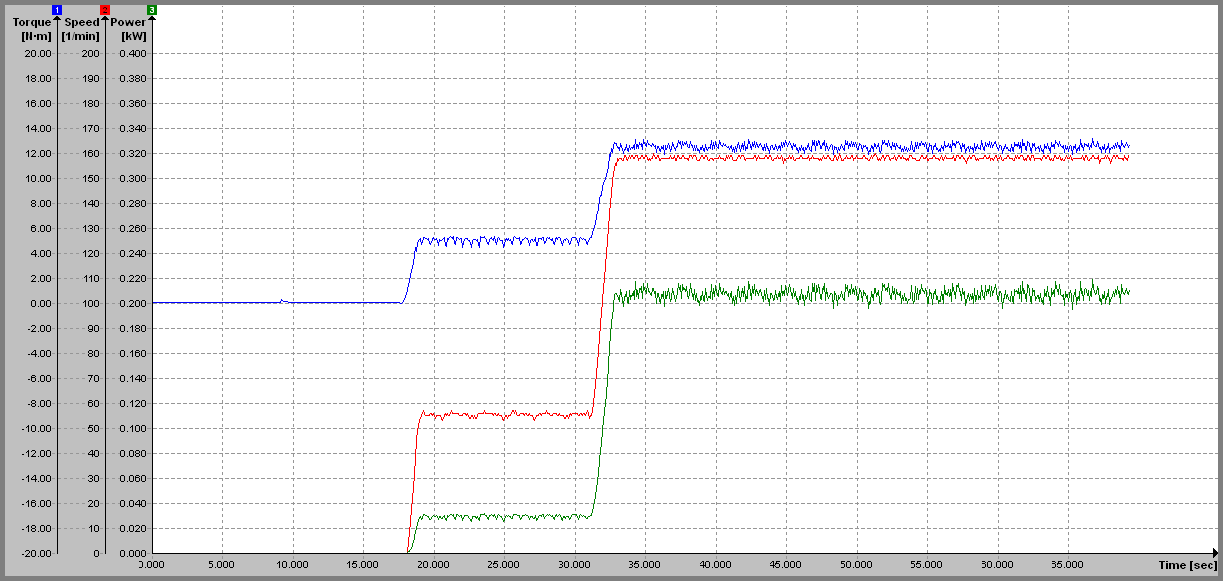
Tests/20190524_Cruise_and_Torque_Tests/_Torque_sensor/SteadyState.bmp
