NicolaiFransen/SemesterProjectPED2/Tests/20190524_Cruise_and_Torque_Tests/_Torque_sensor/torque_to_cruise_control_v2.bmp

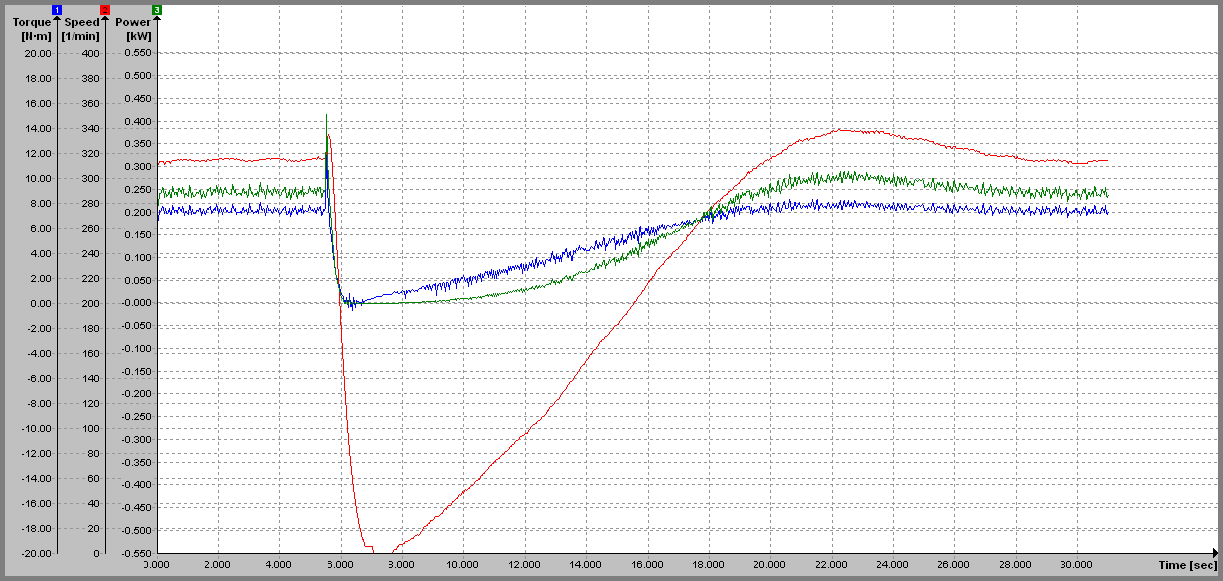
Tests/20190524_Cruise_and_Torque_Tests/_Torque_sensor/torque_to_cruise_control_v2.bmp
