NicolaiFransen/SemesterProjectPED2/Tests/20190524_Cruise_and_Torque_Tests/CruiseSpeedChange/cruiseControlreferenceChanges2.txt

IQm,IDm,IDr,IQr,Sr,Sm;
40,149,149,41,242,243;41,149,149,41,242,244;37,149,149,41,242,242;46,146,149,41,242,244;39,147,149,41,242,243;51,148,149,41,242,242;37,153,149,40,242,241;47,147,149,40,242,241;36,154,149,41,242,243;39,150,149,41,242,243;39,148,149,41,242,243;39,149,149,41,242,244;44,146,149,41,242,243;41,152,149,41,242,243;44,147,149,41,242,243;41,151,149,41,242,243;36,147,149,41,242,242;40,147,149,40,242,240;35,150,149,41,242,242;43,149,149,41,242,242;35,150,149,41,242,242;42,149,149,41,242,243;37,148,149,41,242,243;51,145,149,41,242,244;37,149,149,41,242,244;38,150,149,41,242,242;40,148,149,41,242,243;37,151,149,41,242,243;43,149,149,41,242,243;38,150,149,40,242,241;43,148,149,40,242,240;43,146,149,41,242,242;53,148,149,41,242,242;40,151,149,41,242,243;38,148,149,41,267,243;40,144,149,41,267,243;38,148,149,41,267,244;36,140,149,41,267,243;41,149,149,41,267,243;46,148,149,41,267,242;40,150,149,41,267,242;41,149,149,41,267,243;42,149,149,41,267,243;37,149,149,41,267,244;46,147,149,41,267,245;38,151,149,42,267,247;38,146,149,42,267,248;50,147,149,42,267,249;40,148,149,42,267,248;43,155,149,42,267,250;38,152,149,42,267,249;49,148,149,42,267,250;43,150,149,42,267,250;41,151,149,42,267,251;43,151,149,43,267,253;40,152,149,43,267,253;37,149,149,43,267,255;41,152,149,43,267,256;37,152,149,43,267,257;38,148,149,43,267,256;40,150,149,43,267,258;38,150,149,43,267,258;41,146,149,43,267,257;44,151,149,43,267,258;43,147,149,43,267,259;42,150,149,43,267,260;41,149,149,43,267,261;41,150,149,44,267,262;49,1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
