NicolaiFransen/SemesterProjectPED2/Tests/20190524_Cruise_and_Torque_Tests/_UART/Speed/cruiseControlreferenceChanges.txt

dr 149
qr 35
qm 33
dm 151
dr 149
qr 35
qm 36
dm 149
dr 149
qr 35
qm 38
dm 146
dr 149
qr 36
qm 39
dm 149
dr 149
qr 36
qm 42
dm 146
dr 149
qr 36
qm 37
dm 147
dr 149
qr 36
qm 34
dm 151
dr 149
qr 36
qm 35
dm 150
dr 149
qr 36
qm 36
dm 150
dr 149
qr 37
qm 33
dm 148
dr 149
qr 37
qm 34
dm 150
dr 149
qr 37
qm 35
dm 149
dr 149
qr 37
qm 37
dm 150
dr 149
qr 37
qm 37
dm 150
dr 149
qr 38
qm 39
dm 148
dr 149
qr 38
qm 46
dm 147
dr 149
qr 38
qm 38
dm 149
dr 149
qr 38
qm 43
dm 147
dr 149
qr 38
qm 37
dm 147
dr 149
qr 39
qm 38
dm 150
dr 149
qr 39
qm 40
dm 149
dr 149
qr 39
qm 38
dm 150
dr 149
qr 39
qm 42
dm 148
dr 149
qr 39
qm 39
dm 147
dr 149
qr 39
qm 37
dm 149
dr 149
qr 39
qm 41
dm 147
dr 149
qr 39
qm 39
dm 147
dr 149
qr 40
qm 36
dm 147
dr 149
qr 40
qm 39
dm 148
dr 149
qr 40
qm 46
dm 147
dr 149
qr 40
qm 41
dm 150
dr 149
qr 40
qm 38
dm 148
dr 149
qr 40
qm 38
dm 149
dr 149
qr 40
qm 40
dm 152
dr 149
qr 40
qm 39
dm 149
dr 149
qr 41
qm 39
dm 149
dr 149
qr 41
qm 42
dm 147
dr 149
qr 41
qm 38
dm 150
dr 149
qr 41
qm 40
dm 148
dr 149
qr 41
qm 40
dm 148
dr 149
qr 41
qm 38
dm 153
dr 149
qr 41
qm 40
dm 146
dr 149
qr 41
qm 39
dm 146
dr 149
qr 41
qm 39
dm 152
dr 149
qr 41
qm 39
dm 148
dr 149
qr 41
qm 39
dm 148
dr 149
qr 41
qm 39
dm 151
dr 149
qr 42
qm 42
dm 149
dr 149
qr 42
qm 44
dm 147
dr 149
qr 42
qm 50
dm 147
dr 149
qr 42
qm 37
dm 149
dr 149
qr 42
qm 41
dm 146
dr 149
qr 42
qm 39
dm 149
dr 149
qr 42
qm 43
dm 149
dr 149
qr 42
qm 49
dm 145
dr 149
qr 42
qm 38
dm 147
dr 149
qr 42
qm 41
dm 147
dr 149
qr 42
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
qm 41
dm 148
dr 149
qr 41
qm 47
dm 151
dr 149
qr 41
qm 40
dm 148
dr 149
qr 41
qm 49
dm 145
dr 149
qr 41
qm 38
dm 148
dr 149
qr 41
qm 39
dm 148
dr 149
qr 41
qm 37
dm 148
dr 149
qr 41
qm 40
dm 147
dr 149
qr 41
qm 50
dm 145
dr 149
qr 41
qm 38
dm 148
dr 149
qr 41
qm 40
dm 148
dr 149
qr 41
qm 43
dm 150
dr 149
qr 41
qm 50
dm 148
dr 149
qr 41
qm 39
dm 149
dr 149
qr 41
qm 41
dm 148
dr 149
qr 41
qm 41
dm 152
dr 149
qr 41
qm 42
dm 150
dr 149
qr 41
qm 48
dm 151
dr 149
qr 41
qm 38
dm 149
dr 149
qr 41
qm 42
dm 152
dr 149
qr 41
qm 39
dm 153
dr 149
qr 41
qm 43
dm 148
dr 149
qr 41
qm 52
dm 145
dr 149
qr 41
qm 38
dm 151
dr 149
qr 41
qm 40
dm 150
dr 149
qr 41
qm 41
dm 150
dr 149
qr 41
qm 47
dm 147
dr 149
qr 42
qm 39
dm 153
dr 149
qr 41
qm 40
dm 150
dr 149
qr 42
qm 38
dm 147
dr 149
qr 42
qm 44
dm 147
dr 149
qr 42
qm 42
dm 150
dr 149
qr 42
qm 38
dm 147
dr 149
qr 41
qm 37
dm 148
dr 149
qr 41
qm 42
dm 147
dr 149
qr 41
qm 50
dm 146
dr 149
qr 41
qm 37
dm 148
dr 149
qr 41
qm 40
dm 147
dr 149
qr 41
qm 39
dm 150
dr 149
qr 41
qm 45
dm 147
dr 149
qr 41
qm 40
dm 150
dr 149
qr 41
qm 40
dm 147
dr 149
qr 42
qm 42
dm 150
dr 149
qr 42
qm 45
dm 151
dr 149
qr 42
qm 44
dm 147
dr 149
qr 42
qm 39
dm 149
dr 149
qr 42
qm 40
dm 149
dr 149
qr 42
