NicolaiFransen/SemesterProjectPED2/Tests/20190524_Cruise_and_Torque_Tests/_UART/Speed/cruiseControlreferenceChanges2.txt

6
dm 149
dr 149
qr 41
r 242
m 243
qm 40
dm 149
dr 149
qr 41
r 242
m 243
qm 41
dm 149
dr 149
qr 41
r 242
m 244
qm 37
dm 149
dr 149
qr 41
r 242
m 242
qm 46
dm 146
dr 149
qr 41
r 242
m 244
qm 39
dm 147
dr 149
qr 41
r 242
m 243
qm 51
dm 148
dr 149
qr 41
r 242
m 242
qm 37
dm 153
dr 149
qr 40
r 242
m 241
qm 47
dm 147
dr 149
qr 40
r 242
m 241
qm 36
dm 154
dr 149
qr 41
r 242
m 243
qm 39
dm 150
dr 149
qr 41
r 242
m 243
qm 39
dm 148
dr 149
qr 41
r 242
m 243
qm 39
dm 149
dr 149
qr 41
r 242
m 244
qm 44
dm 146
dr 149
qr 41
r 242
m 243
qm 41
dm 152
dr 149
qr 41
r 242
m 243
qm 44
dm 147
dr 149
qr 41
r 242
m 243
qm 41
dm 151
dr 149
qr 41
r 242
m 243
qm 36
dm 147
dr 149
qr 41
r 242
m 242
qm 40
dm 147
dr 149
qr 40
r 242
m 240
qm 35
dm 150
dr 149
qr 41
r 242
m 242
qm 43
dm 149
dr 149
qr 41
r 242
m 242
qm 35
dm 150
dr 149
qr 41
r 242
m 242
qm 42
dm 149
dr 149
qr 41
r 242
m 243
qm 37
dm 148
dr 149
qr 41
r 242
m 243
qm 51
dm 145
dr 149
qr 41
r 242
m 244
qm 37
dm 149
dr 149
qr 41
r 242
m 244
qm 38
dm 150
dr 149
qr 41
r 242
m 242
qm 40
dm 148
dr 149
qr 41
r 242
m 243
qm 37
dm 151
dr 149
qr 41
r 242
m 243
qm 43
dm 149
dr 149
qr 41
r 242
m 243
qm 38
dm 150
dr 149
qr 40
r 242
m 241
qm 43
dm 148
dr 149
qr 40
r 242
m 240
qm 43
dm 146
dr 149
qr 41
r 242
m 242
qm 53
dm 148
dr 149
qr 41
r 242
m 242
qm 40
dm 151
dr 149
qr 41
r 242
m 243
qm 38
dm 148
dr 149
qr 41
r 267
m 243
qm 40
dm 144
dr 149
qr 41
r 267
m 243
qm 38
dm 148
dr 149
qr 41
r 267
m 244
qm 36
dm 140
dr 149
qr 41
r 267
m 243
qm 41
dm 149
dr 149
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
qm 46
dm 151
dr 149
qr 49
r 317
m 317
qm 48
dm 151
dr 149
qr 49
r 317
m 318
qm 49
dm 152
dr 149
qr 49
r 317
m 318
qm 44
dm 154
dr 149
qr 49
r 317
m 318
qm 46
dm 149
dr 149
qr 49
r 317
m 319
qm 52
dm 149
dr 149
qr 49
r 317
m 318
qm 58
dm 147
dr 149
qr 49
r 317
m 318
qm 46
dm 150
dr 149
qr 49
r 317
