NicolaiFransen/SemesterProjectPED2/(threads)

Thread 14 (2019-04-01):

GPIO54 read value always '1'

murgui, 2019-04-01:
The GPIO 54 always detects a '1' as an input.

Testing done so far:
*Not a HW problem, as it could be seen that with both 3.3 V and 0 V at the input pin, a '1' vas evaluated.

*The analysis of the evaluated value is performed directly in GpioDataRegs.GPBDAT.bit.GPIO54.

*GPIO32 is also used as an input and it works properly. (GPIO32 also uses GPBDAT).

*The configuration of the pin is the same as other digital inputs, i.e:

```
//  Select digital input sampling frequency; 0 = Tsysclockout
GpioCtrlRegs.GPBCTRL.bit.QUALPRD2 = 0; //(GPIO50-55)

//  Configure GPIO 54 (Anti-slip pushbutton) as input
GpioCtrlRegs.GPBPUD.bit.GPIO54 = 1; //Disable pull-up resistor
GpioCtrlRegs.GPBQSEL2.bit.GPIO54 = 0; //Select amount of samples for qualifying, 0 = 1 sample.
GpioCtrlRegs.GPBMUX2.bit.GPIO54 = 0;    // Select GPIO from MUX
GpioCtrlRegs.GPBDIR.bit.GPIO54 = 0;     // Select digital input
```

murgui, 2019-04-04:
Lajos: 'I have your GPIO54 settings here with my DSP, and when the pin is floating it to 1, when connected to 3.3V it stays to 1 and when I connect to GND it goes to 0. Even with disabled GPBPUD. This seems to me that you have somehow an always floating or 3.3V connected pin.'

murgui, 2019-04-04:
New tests:

*The voltage was measured this time with oscilloscope (previous time with multimeter) and the voltage was either 3.3 V or 2.2 V, that is why a '1' is evaluated.

*When the DSP is disconnected the voltages are 0 V and 3.3 V.

*Resistance between B3 and GND is 10.1 kOhm as expected.

*In runtime, the values of the configuration registers are as expected. (As described in issue description).

*Removing JP1 and JP2 and applying 24 V to the board, it can be seen in GPIO54 0.56 V. (Connected to the interface PCB)
