NicolaiFransen/SemesterProjectPED2/Batteries/BatterySetup_v2.pdf

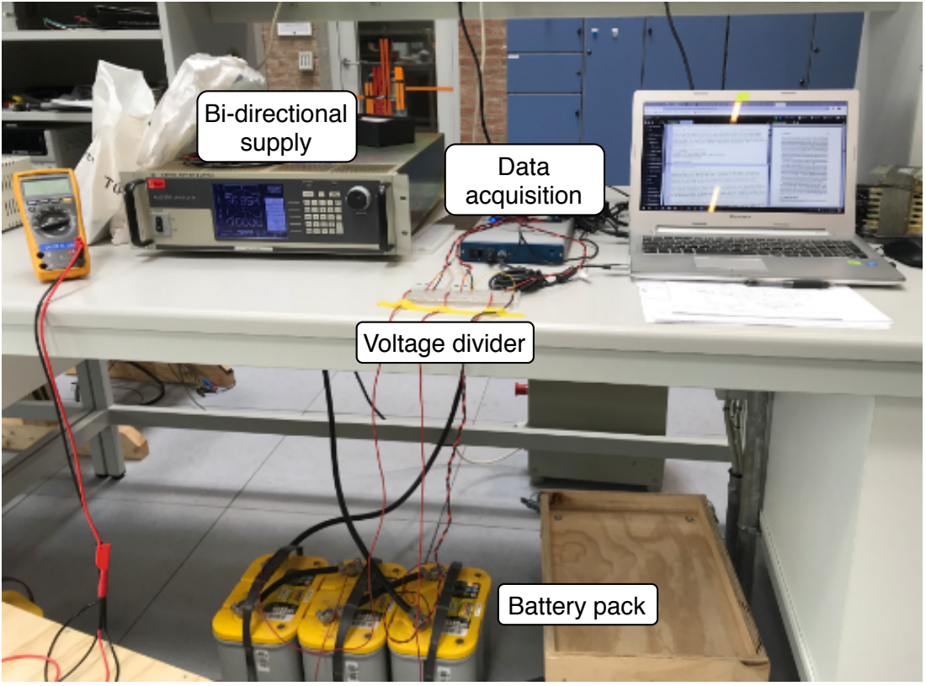
[picture p400: page 1]
Bi-directional supply; Battery pack; Voltage divider; Data acquisition
