NicolaiFransen/SemesterProjectPED2/Interface board/2019_03_04_InterfacePCB_schematic.pdf

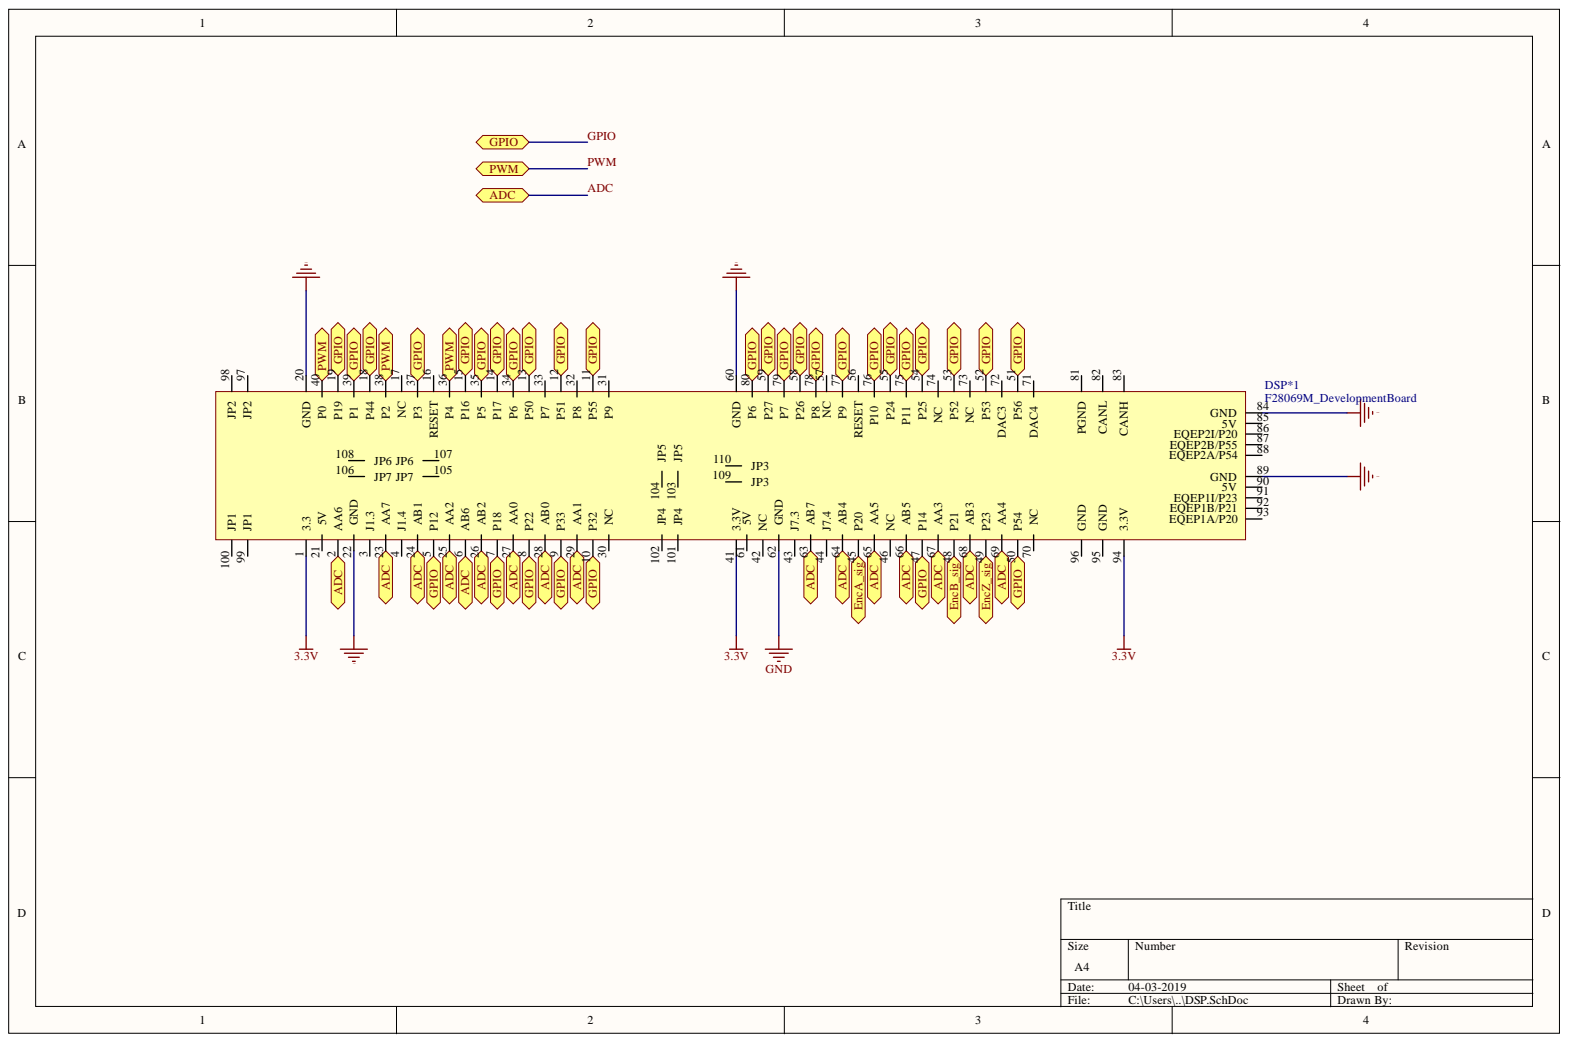
[picture p401: page 1]

DAC4 71 P56 51 DAC3 72 P53 52 NC 73 P52 53 NC 74 P25 54 P11 75 P24 55 P10 76 RESET 56 P9 77 NC 57 P8 78 P26 58 P7 79 P27 59 P6 80 GND 60

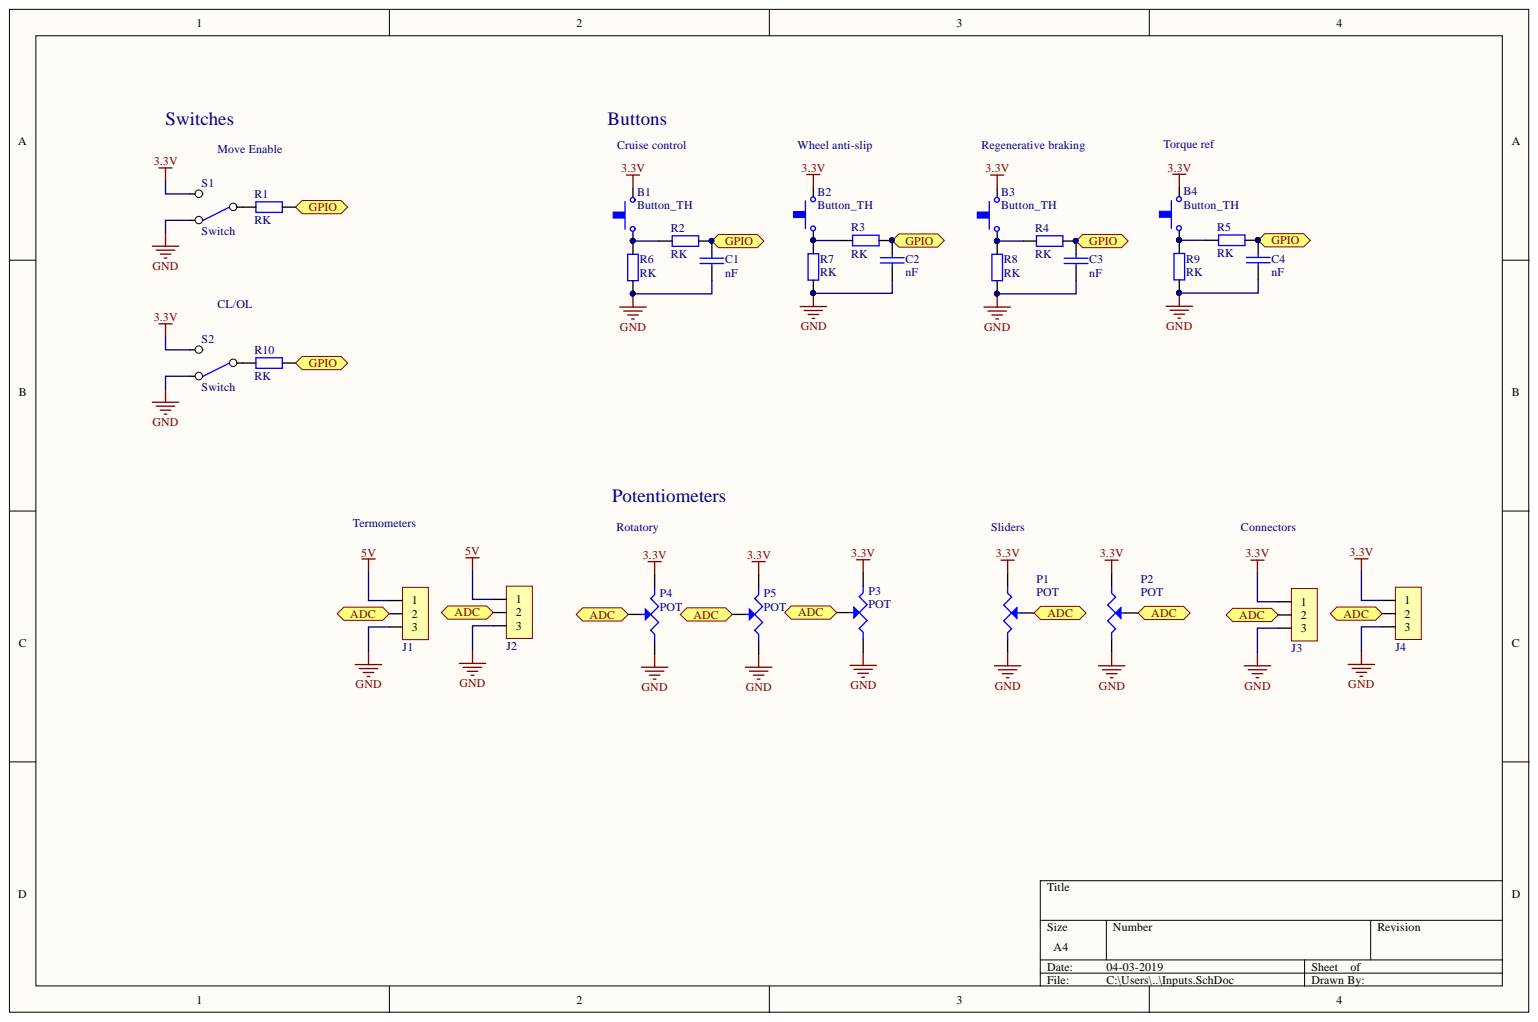
[picture p402: page 2]

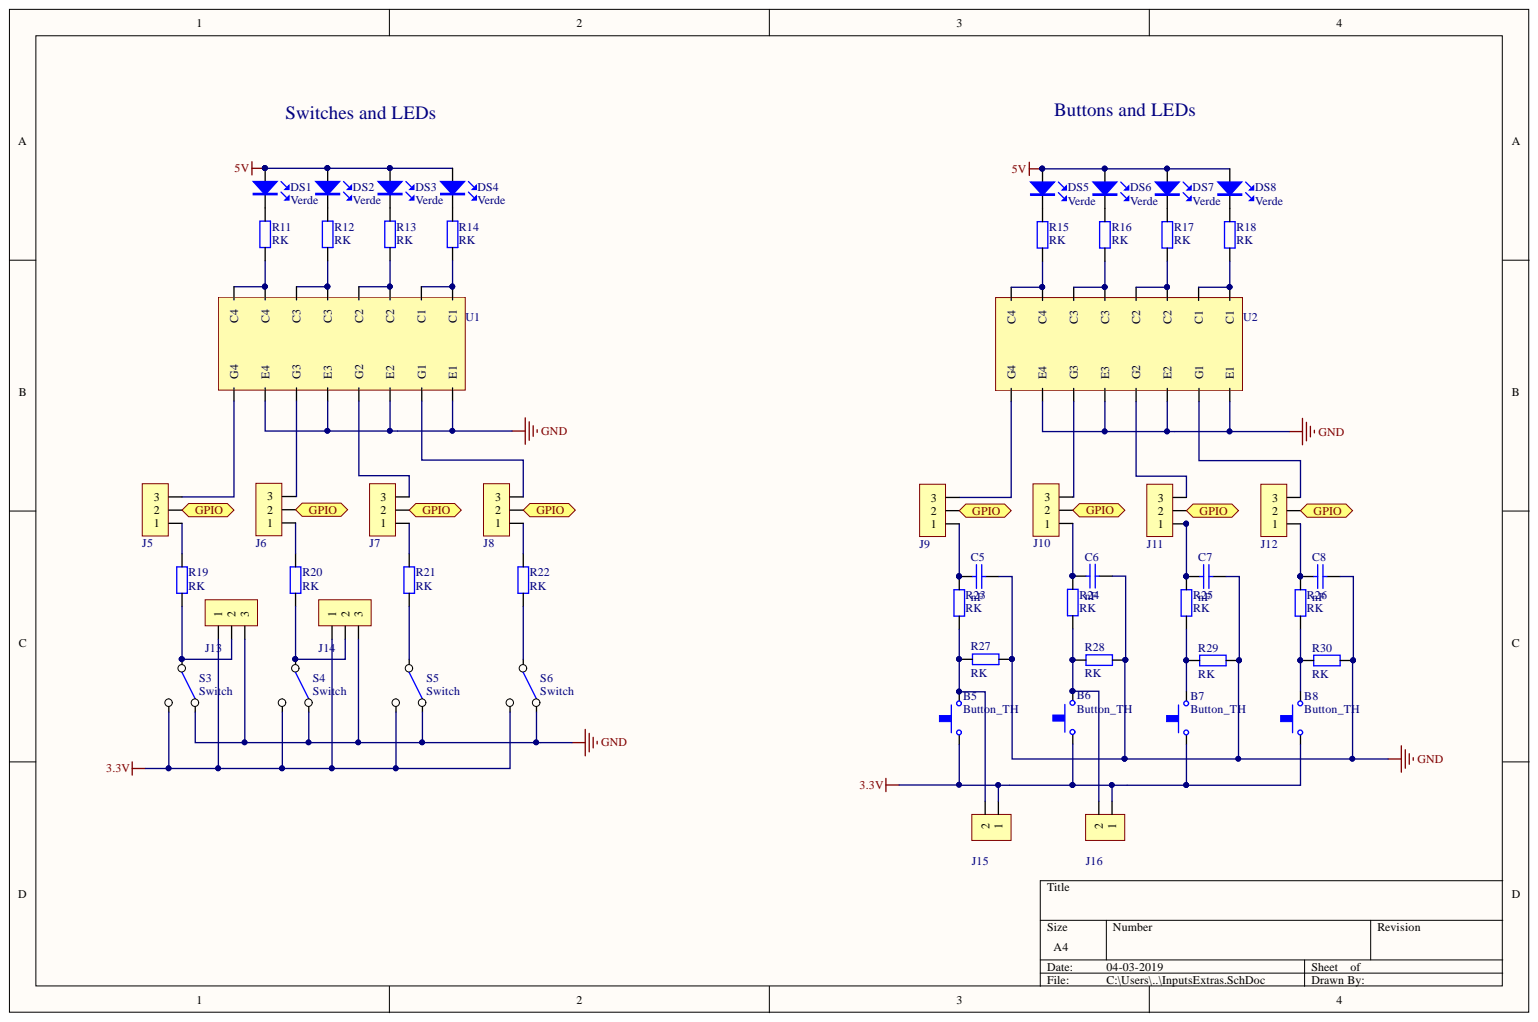
[picture p403: page 3]

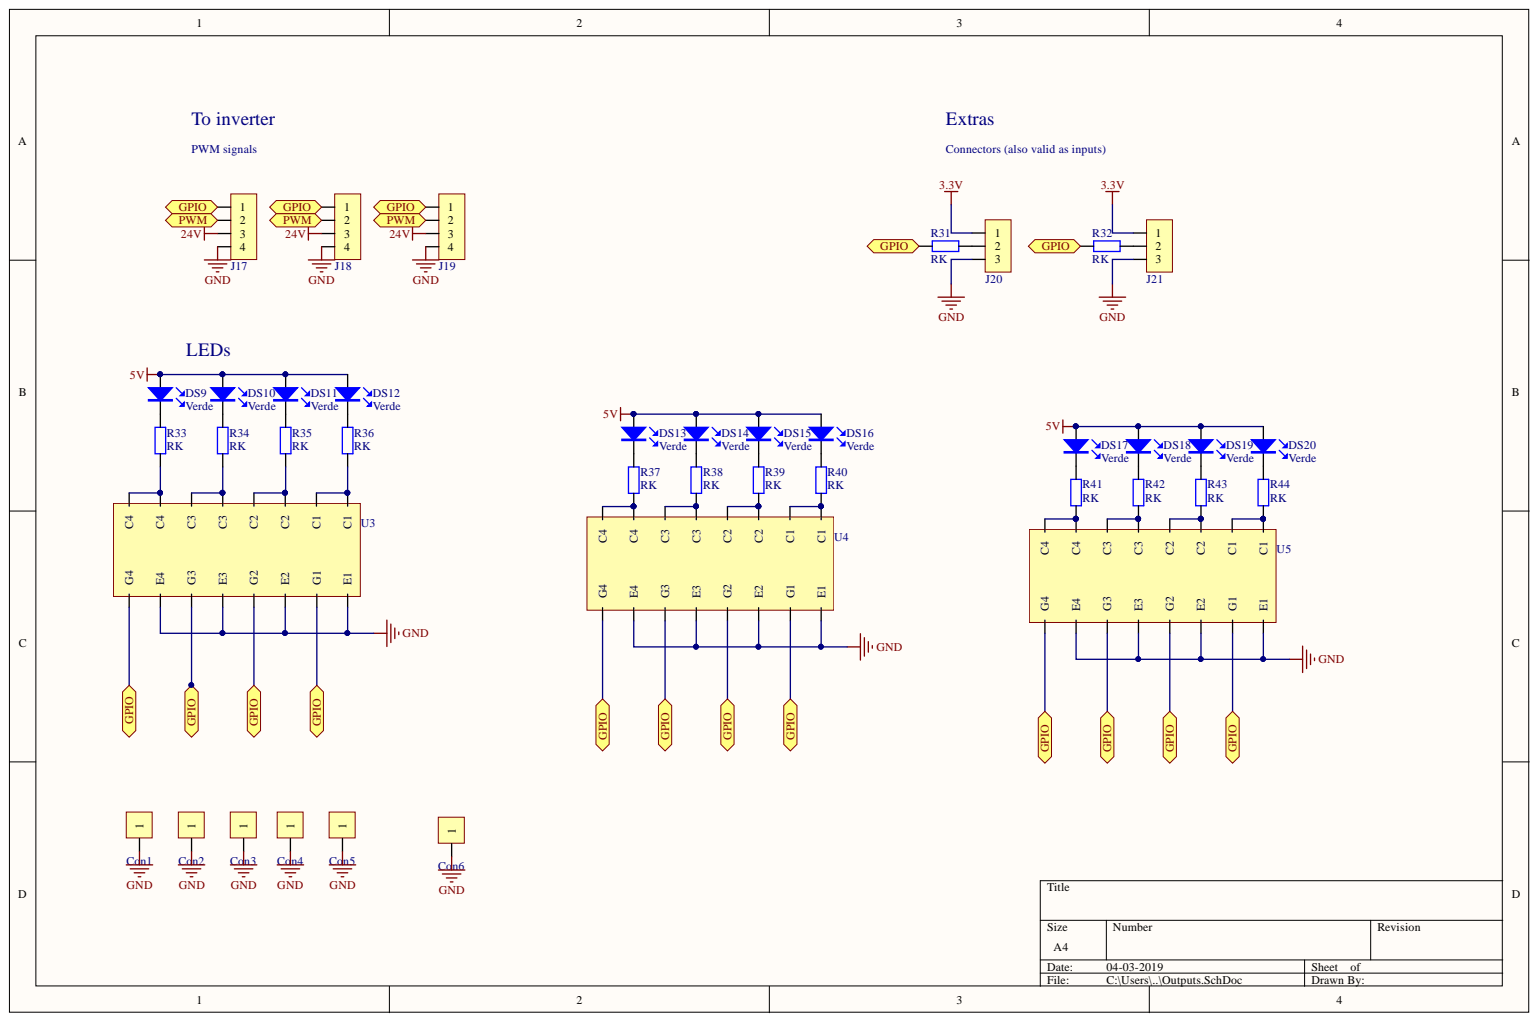
[picture p404: page 4]

Connectors (also valid as inputs)

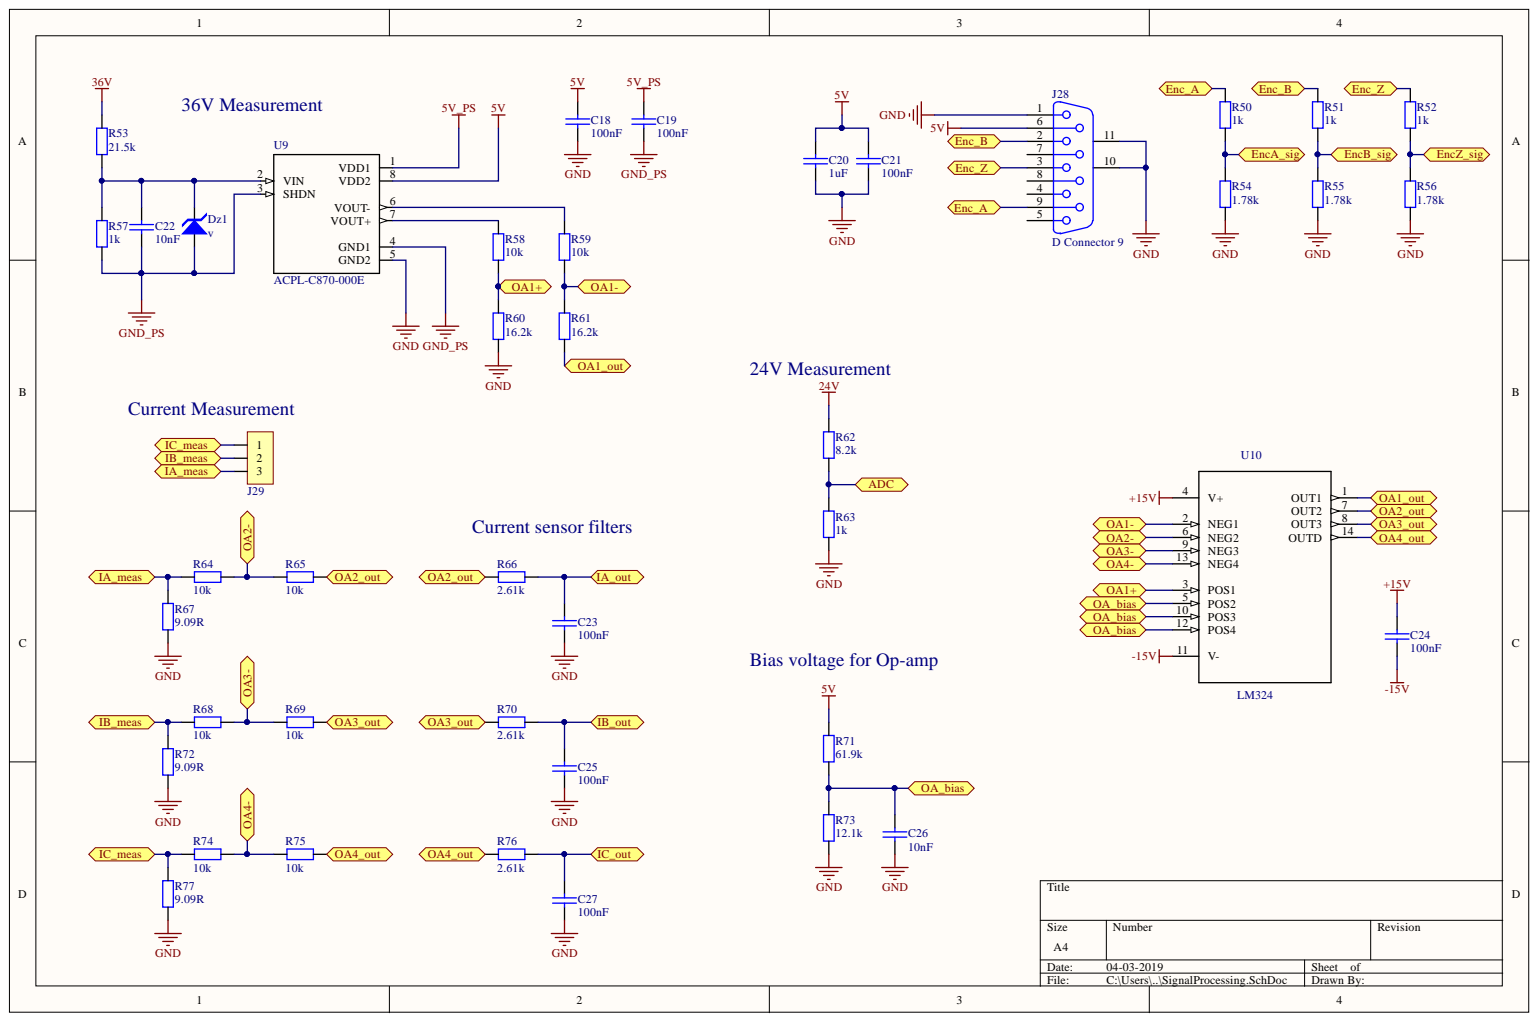
[picture p405: page 5]

oltage for Op-am

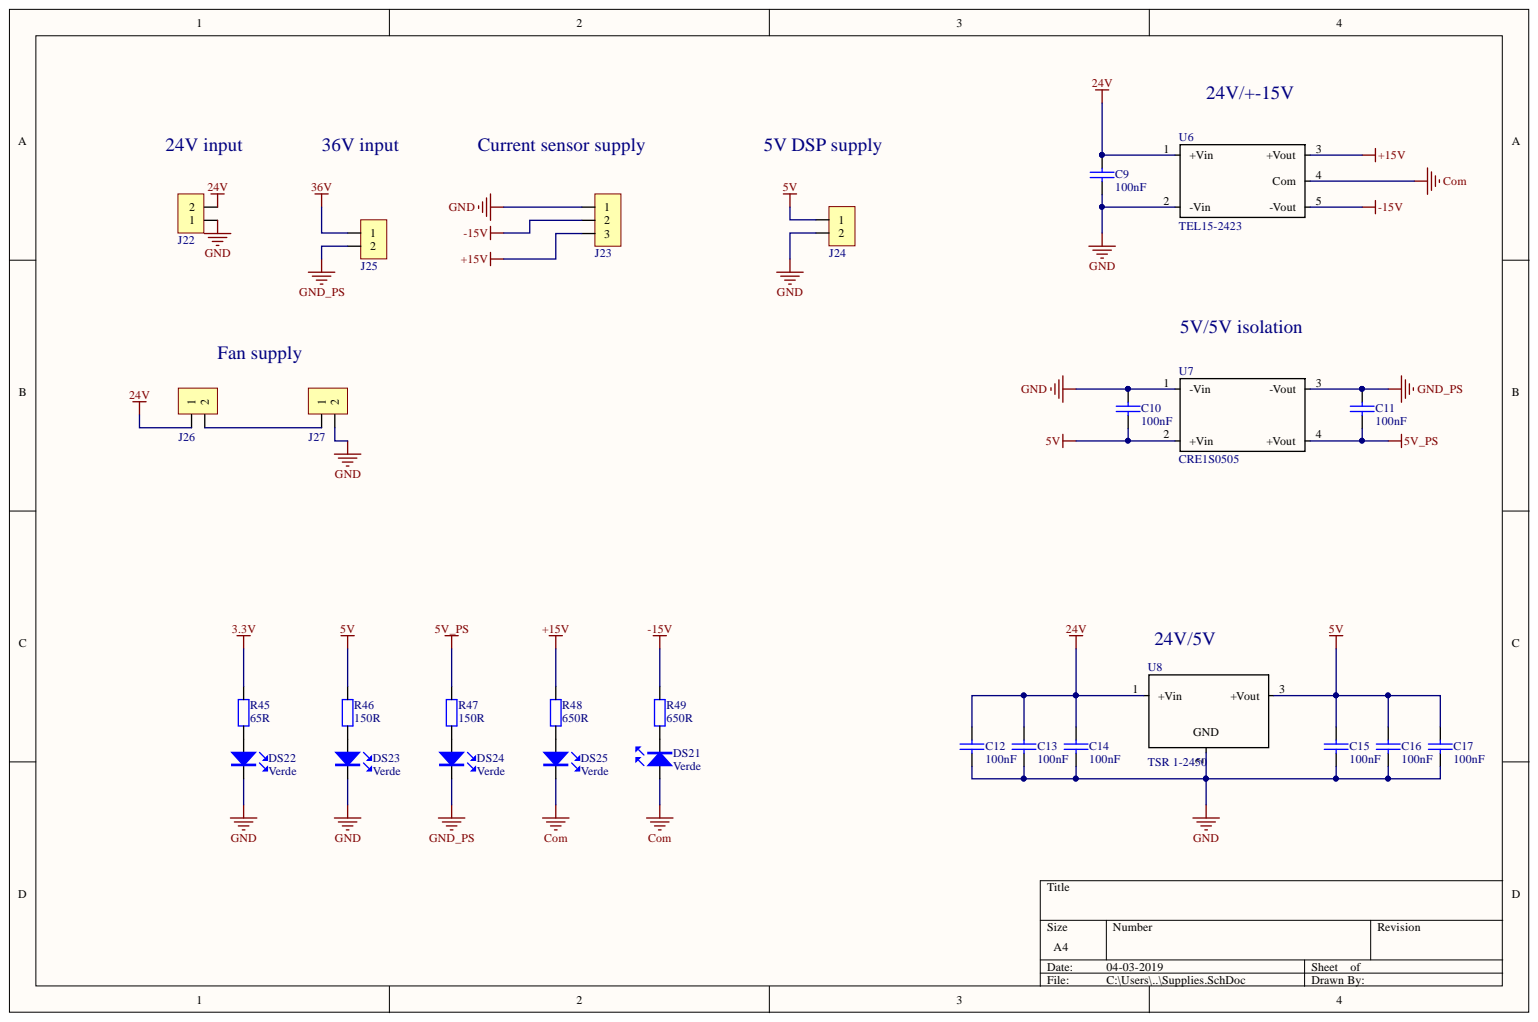
[picture p406: page 6]
