NicolaiFransen/SemesterProjectPED2/Report/Diagrams/ClosedLoopControl.pdf

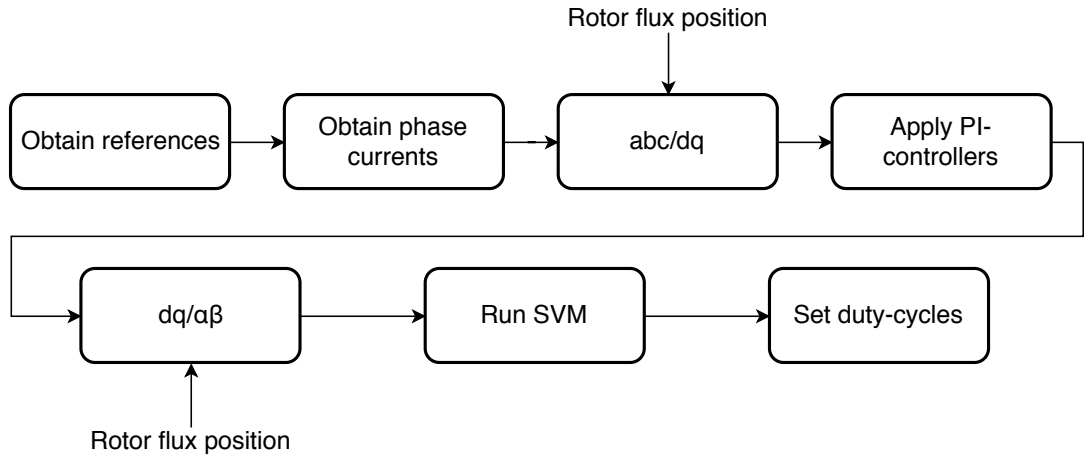
[picture p407: page 1]
Obtain references; Obtain phase; currents; Apply PI-; Run SVM; Set duty-cycles

Rotor flux position

controllers abc/dq
