NicolaiFransen/SemesterProjectPED2/Report/Pictures/TestBench_Torque.pdf

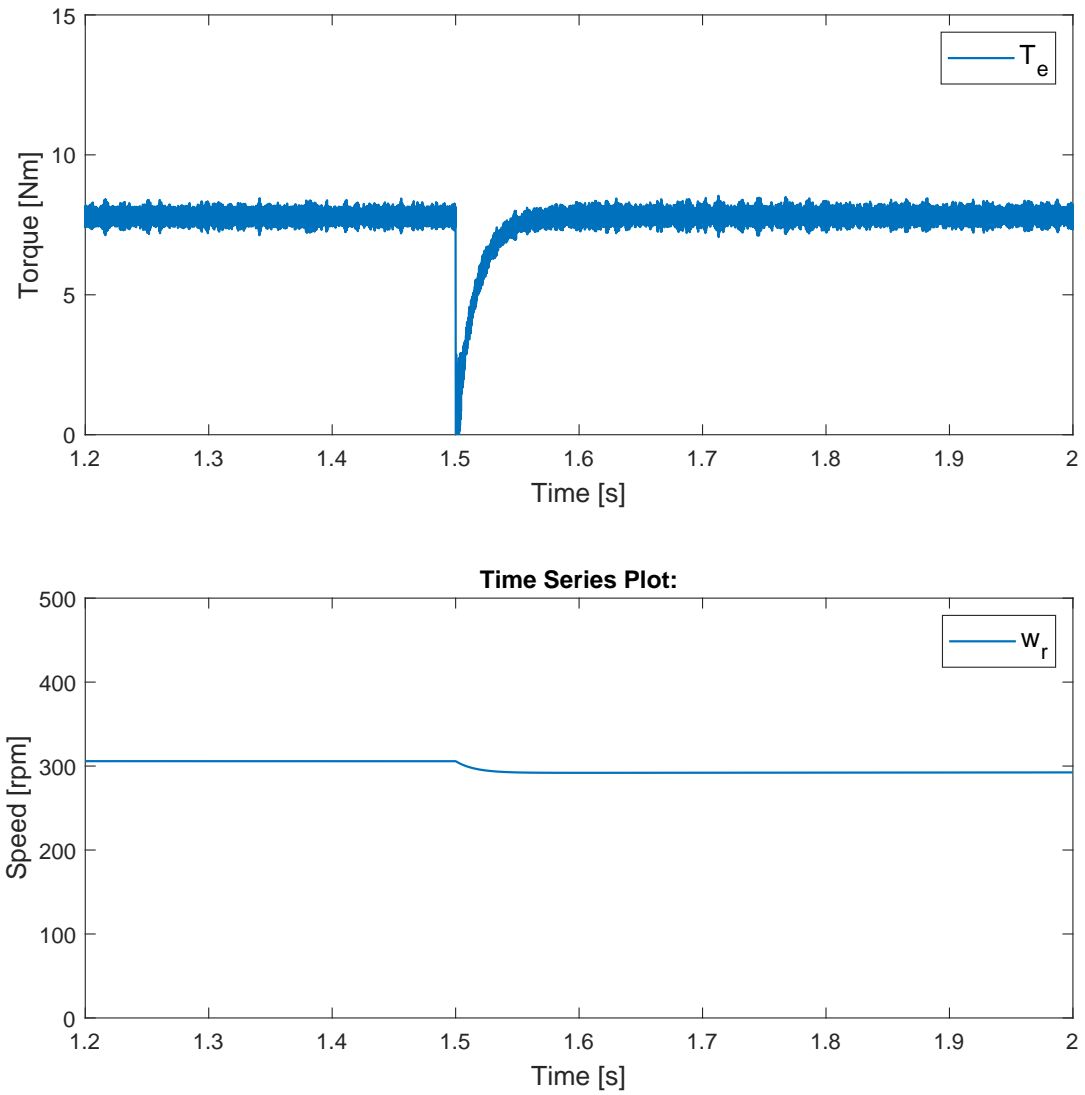
[picture p408: page 1]
Time [s]; Torque [Nm]; Speed [rpm]

Time Series Plot:
