NicolaiFransen/SemesterProjectPED2/Report/Pictures/currents_startup.pdf

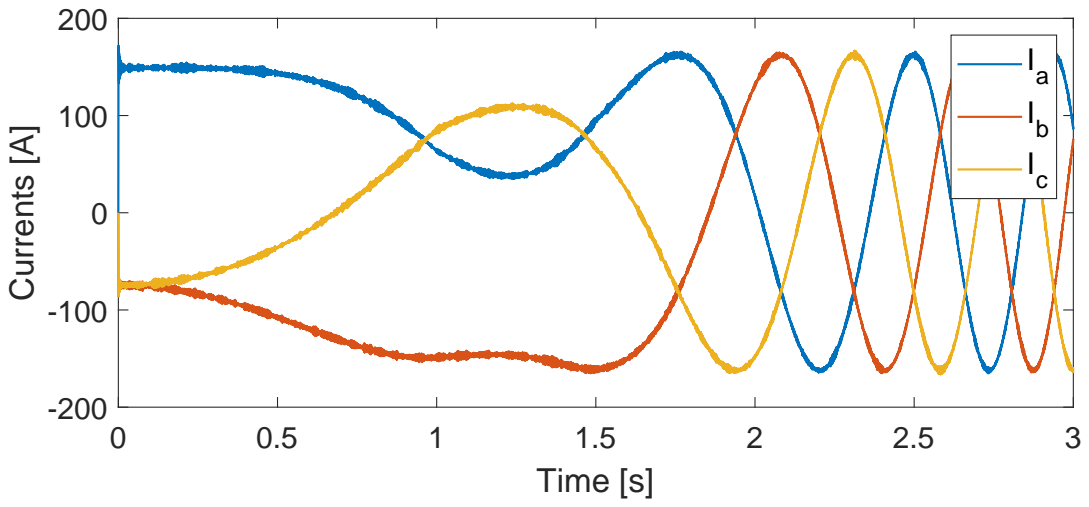
[picture p409: page 1]
Time [s]; Currents [A]
