NicolaiFransen/SemesterProjectPED2/Report/Pictures/CompoundMachineDiag.pdf

## Compound Machine

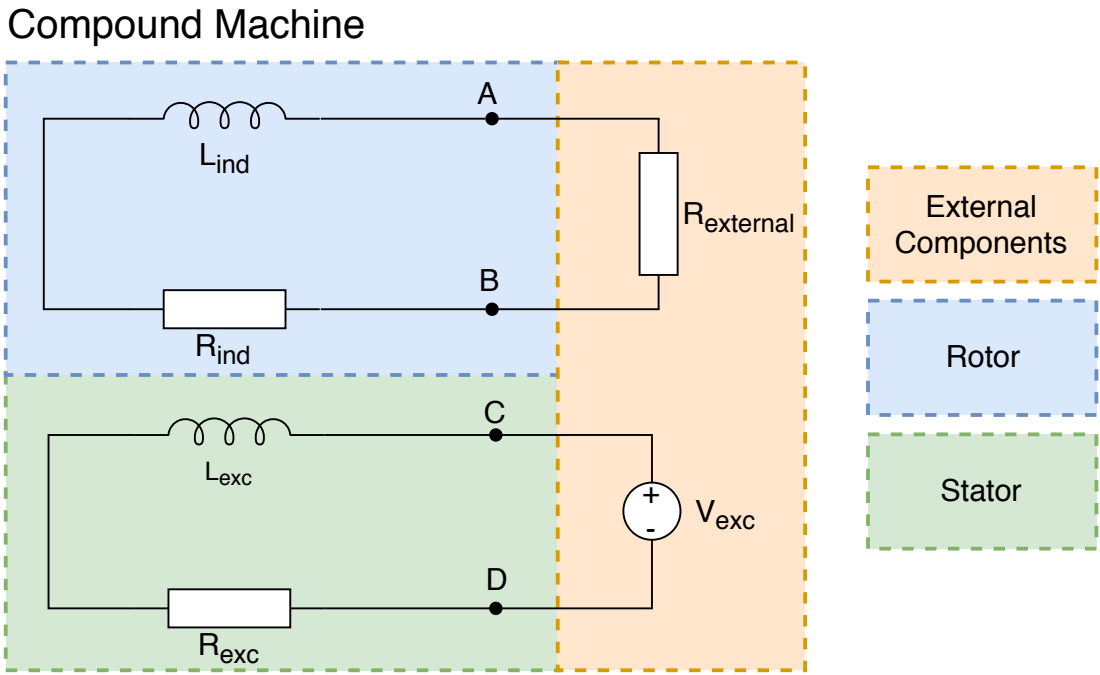
[picture p410: page 1]
Lexc; Rexc; Vexc; External Components; Rotor; Stator; Lind; Rind; Rexternal
