NicolaiFransen/SemesterProjectPED2/Report/Diagrams/ReferenceHandlerV4.pdf

# Reference handler

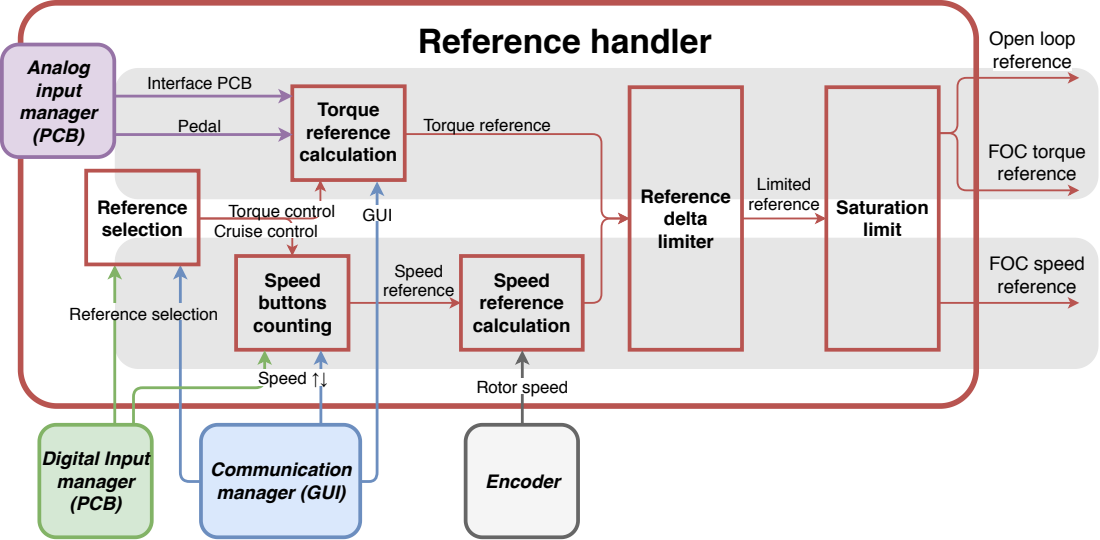
[picture p411: page 1]
Open loop reference; Reference delta limiter; Saturation limit; Speed buttons counting; Speed reference calculation; Digital Input manager (PCB); Encoder Communication manager (GUI); Analog input manager (PCB); FOC torque reference; FOC speed reference; Interface PCB; Torque reference; Limited reference; Speed reference; Pedal; Reference selection; Speed ↑↓; Torque reference calculation; GUI; Rotor speed; Torque control Cruise control
