NicolaiFransen/SemesterProjectPED2/Report/Diagrams/SystemManagerFSM.pdf

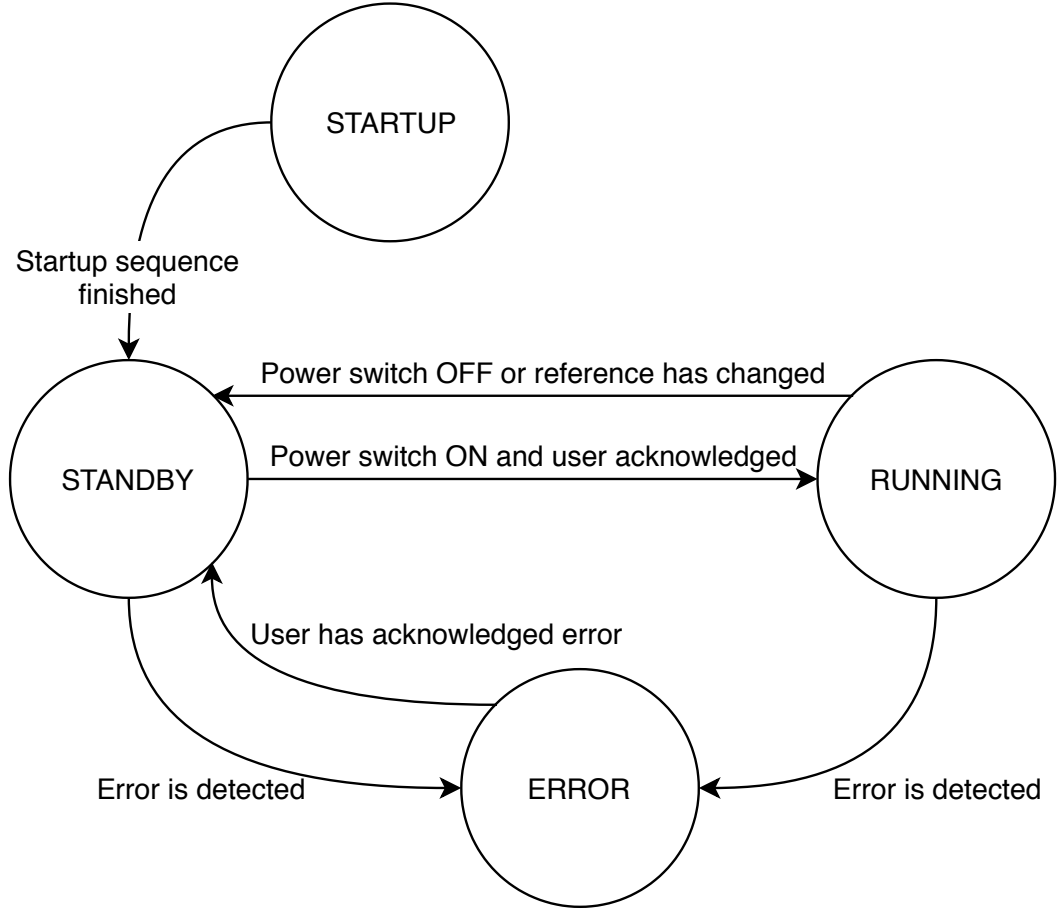
[picture p412: page 1]
STARTUP; STANDBY; RUNNING; Error is detected; ERROR; Startup sequence finished

Power switch OFF or reference has changed

Power switch ON and user acknowledged

User has acknowledged error
