NicolaiFransen/SemesterProjectPED2/Tests/20190524_Cruise_and_Torque_Tests/TorqueToCruise/TorqueToCruise_IdIq.pdf

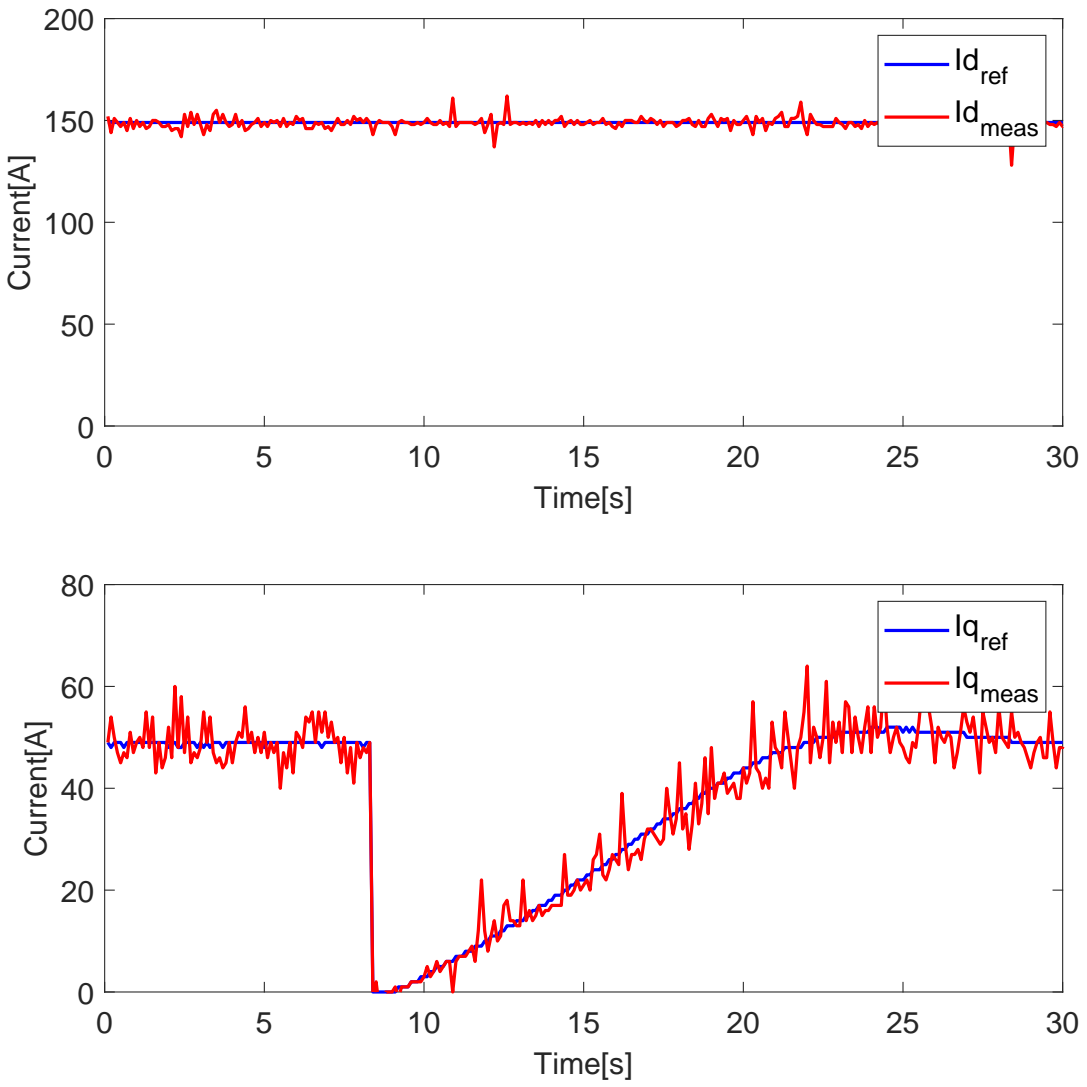
[picture p413: page 1]
Time[s]; Current[A]; Idref Id; meas; Iqref; Iqmeas
