NicolaiFransen/SemesterProjectPED2/Tests/20190524_Cruise_and_Torque_Tests/TorqueRefStep/TorqueRefStep_TorqueSpeed_OnlyTorque.pdf

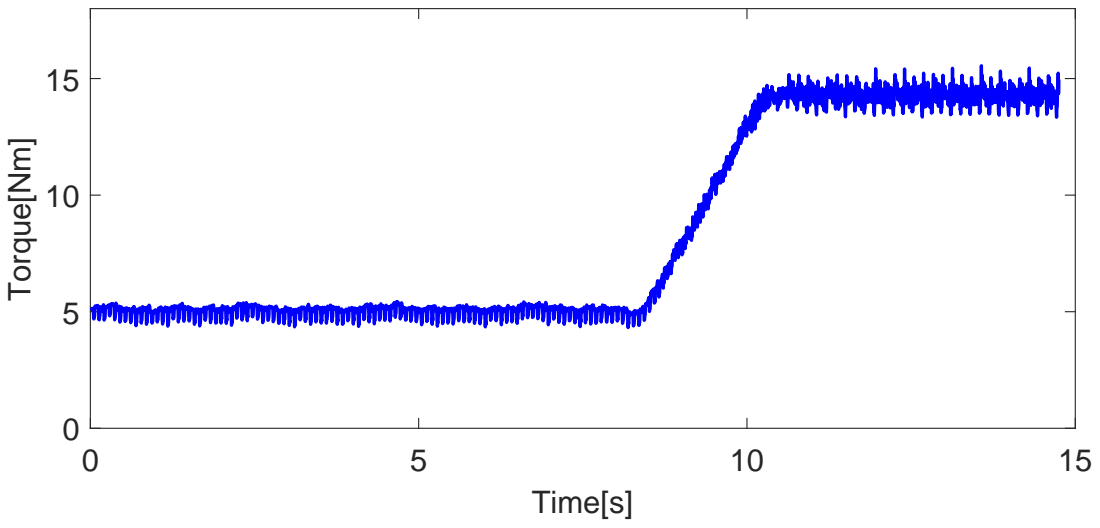
[picture p414: page 1]
Time[s]; Torque[Nm]
