NicolaiFransen/SemesterProjectPED2/Tests/20190524_Cruise_and_Torque_Tests/TorqueStartup/TorqueStartup_Iabc.pdf

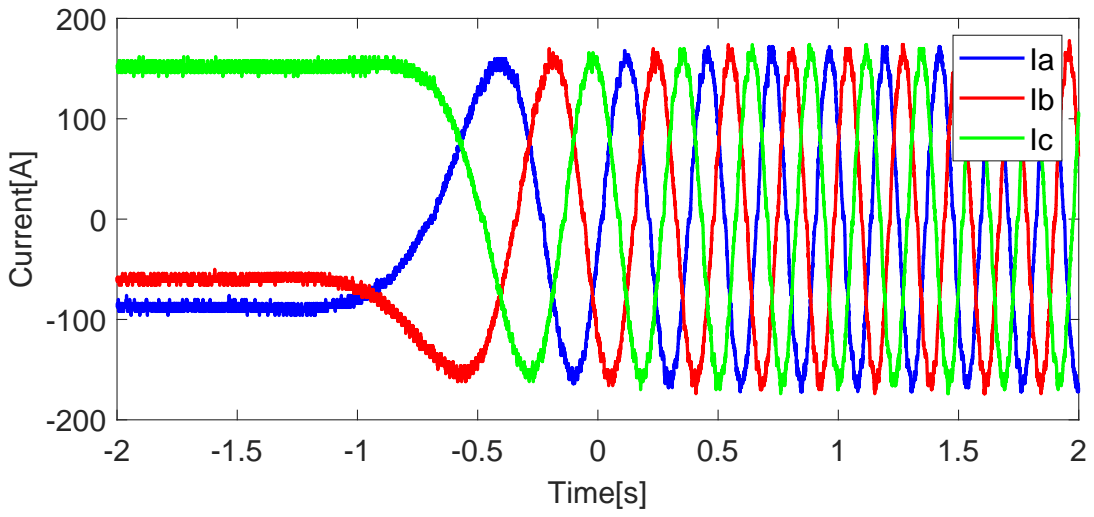
[picture p415: page 1]
Time[s]; Current[A]
