NicolaiFransen/SemesterProjectPED2/Tests/20190524_Cruise_and_Torque_Tests/TorqueStartup/TorqueStartup_TorqueSpeed_OnlyTorque.pdf

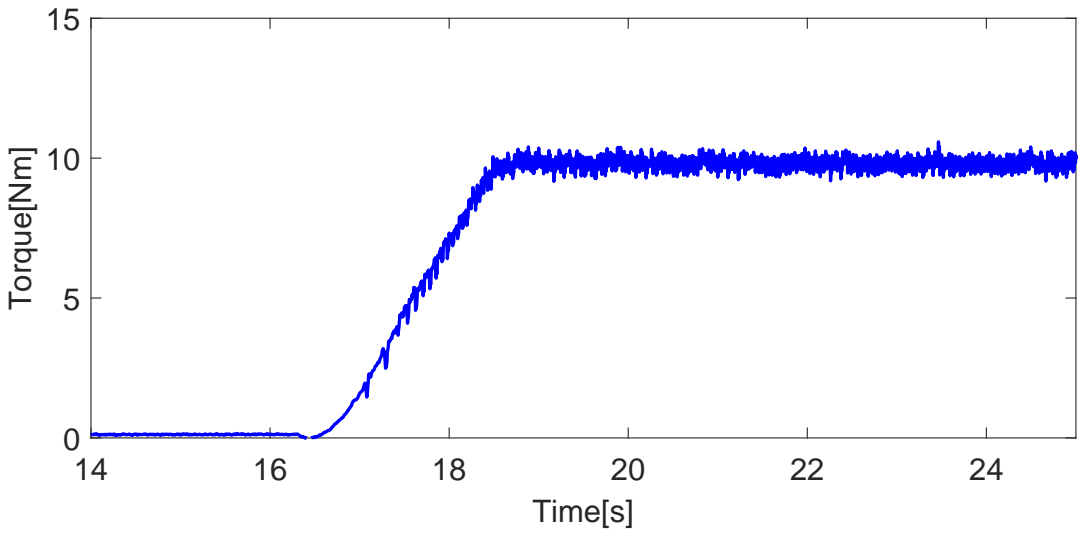
[picture p416: page 1]
Time[s]; Torque[Nm]
