NicolaiFransen/SemesterProjectPED2/Tests/20190524_Cruise_and_Torque_Tests/TorqueSteadyState/SteadyState_TorqueSpeed_OnlyTorque.pdf

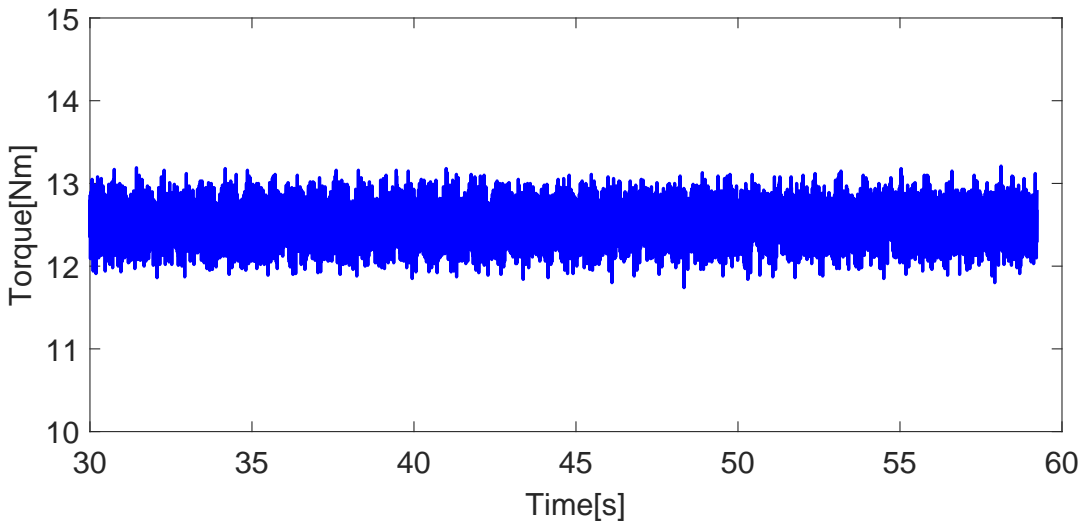
[picture p417: page 1]
Time[s]; Torque[Nm]
