NicolaiFransen/SemesterProjectPED2/Tests/20190524_Cruise_and_Torque_Tests/CruiseLoadStep/CrouseLoadChange_IdIq.pdf

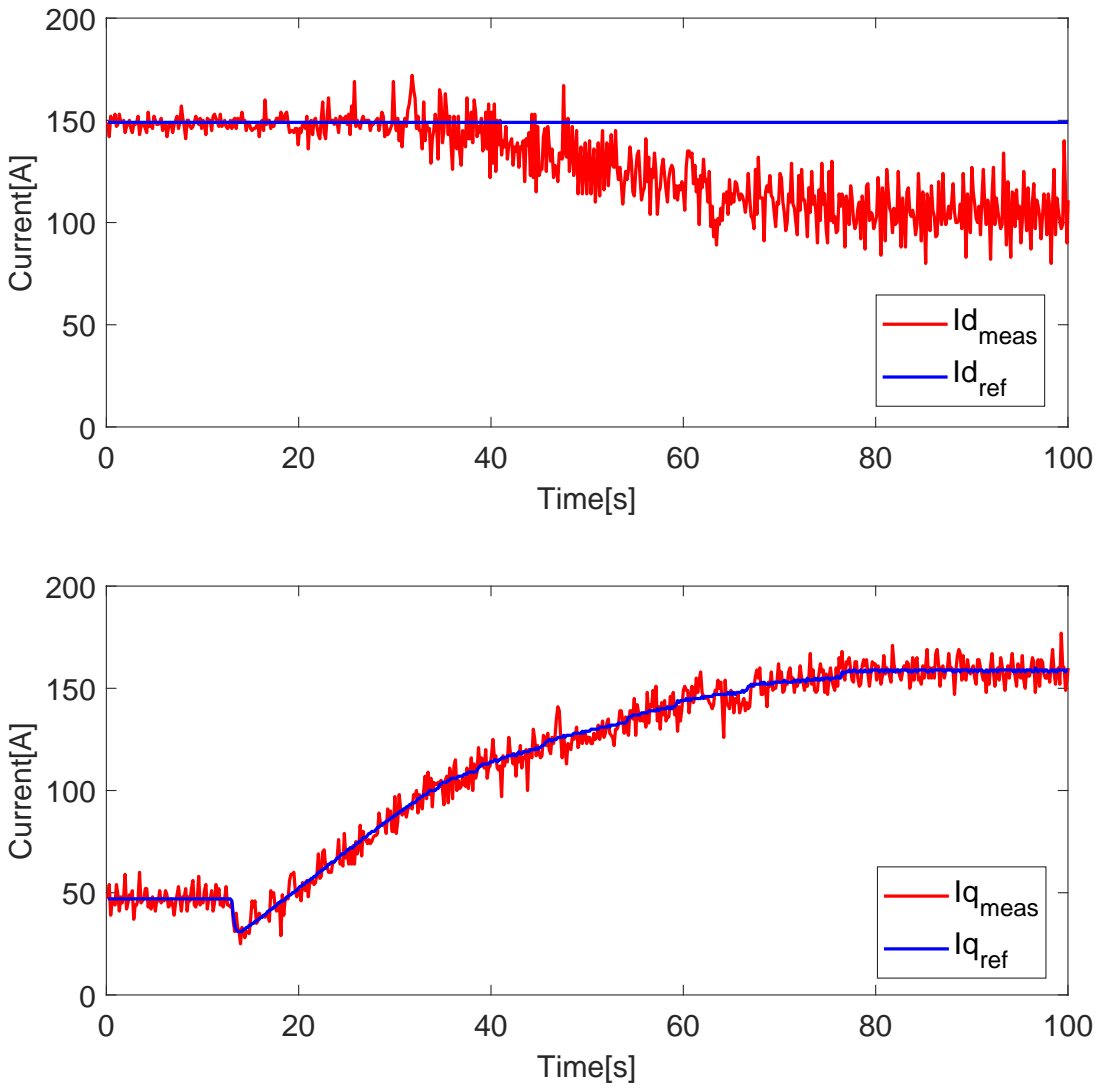
[picture p418: page 1]
Time[s]; Current[A]; meas Idref; Iqmeas; Iqref
