NicolaiFransen/SemesterProjectPED2/Tests/20190524_Cruise_and_Torque_Tests/CruiseLoadStep/CrouseLoadChange_TorqueSpeed.pdf

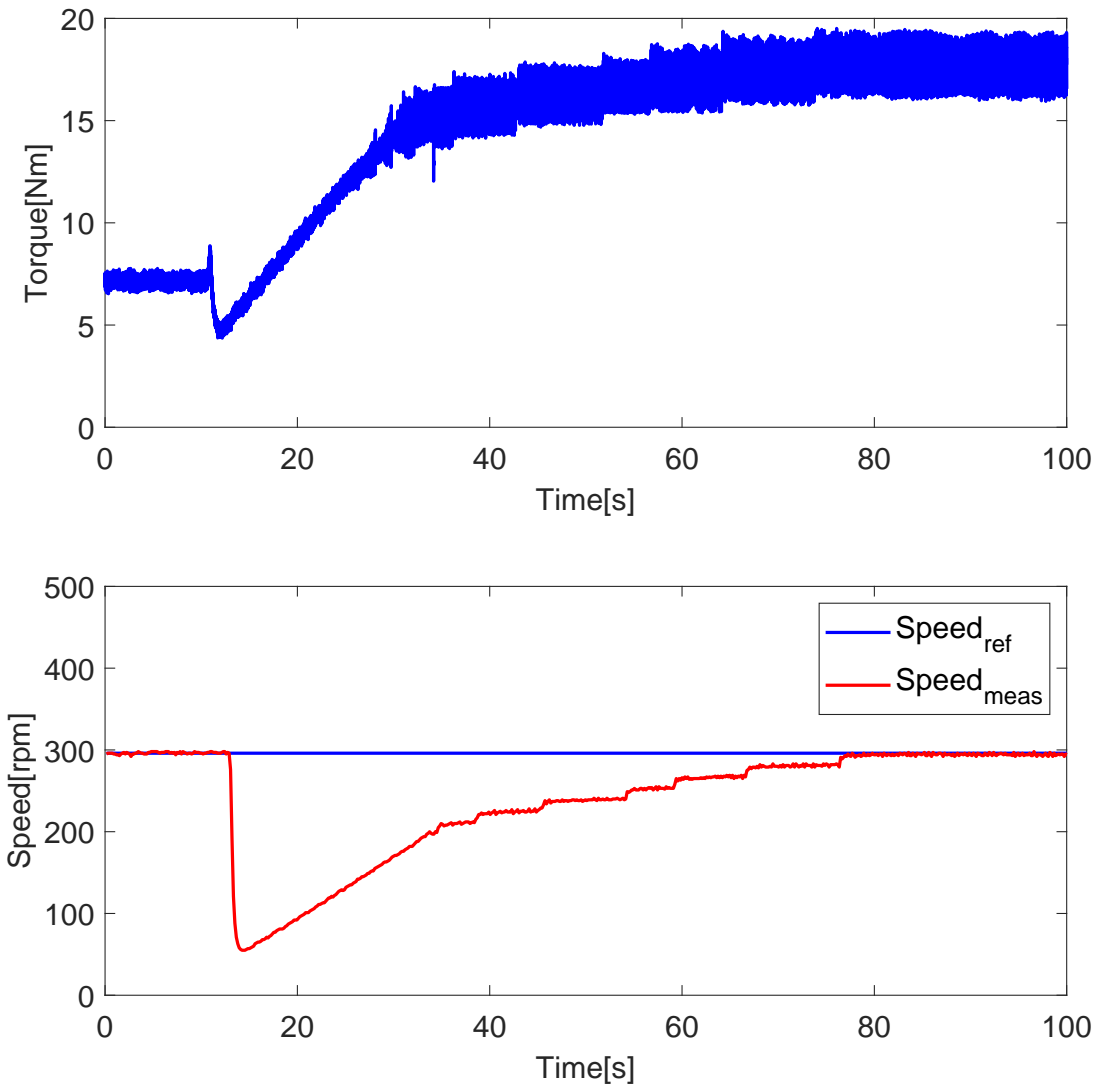
[picture p419: page 1]
Time[s]; Torque[Nm]; Speed[rpm]; Speedref Speedmeas
