NicolaiFransen/SemesterProjectPED2/Tests/20190524_Cruise_and_Torque_Tests/CruiseSpeedChange/CruiseSpeedChange_IdIq.pdf

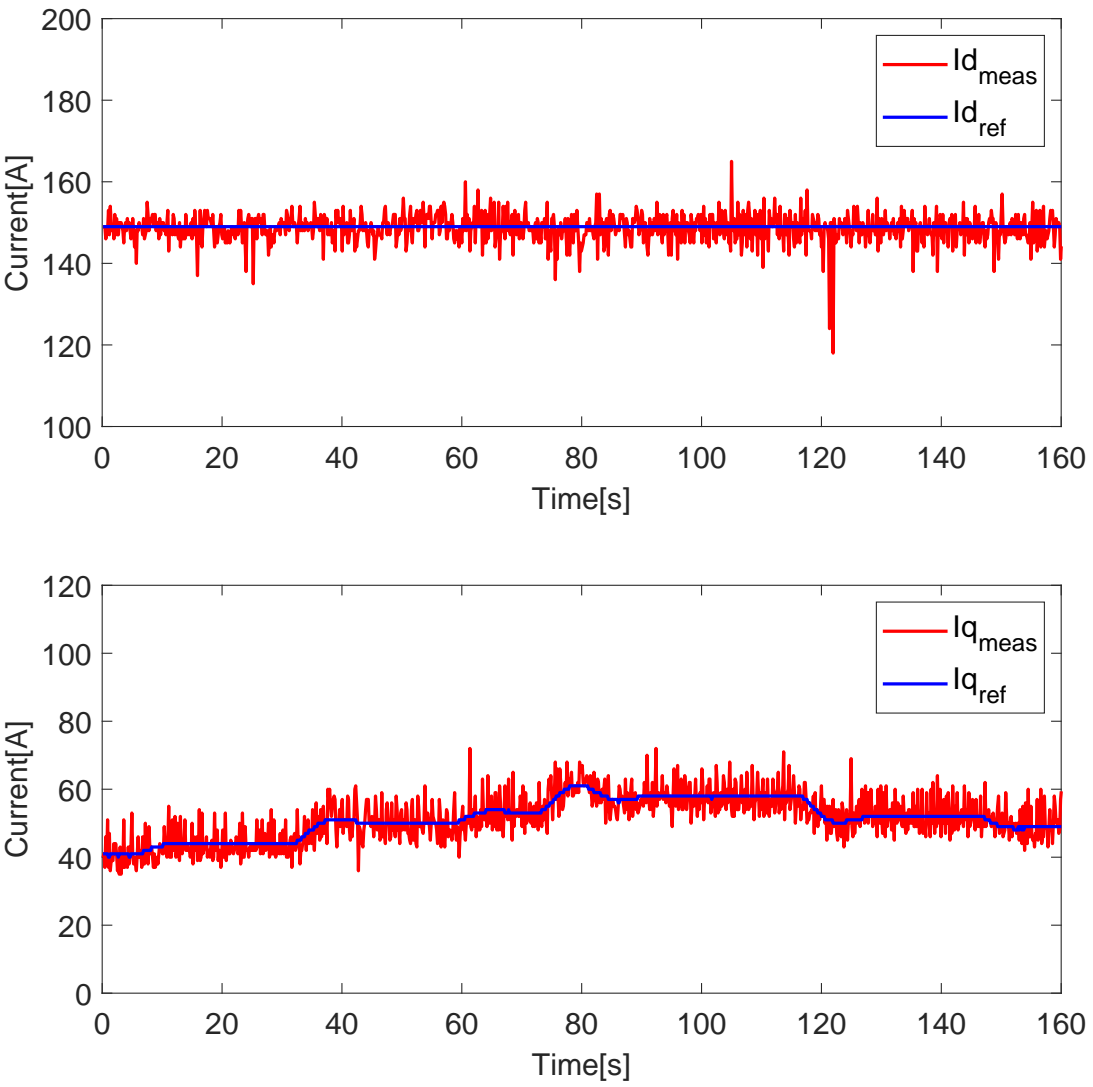
[picture p420: page 1]
Time[s]; Current[A]; meas Idref; Iqmeas; Iqref
