NicolaiFransen/SemesterProjectPED2/Tests/20190524_Cruise_and_Torque_Tests/CruiseSpeedChange/CruiseSpeedChange_TorqueSpeed.pdf

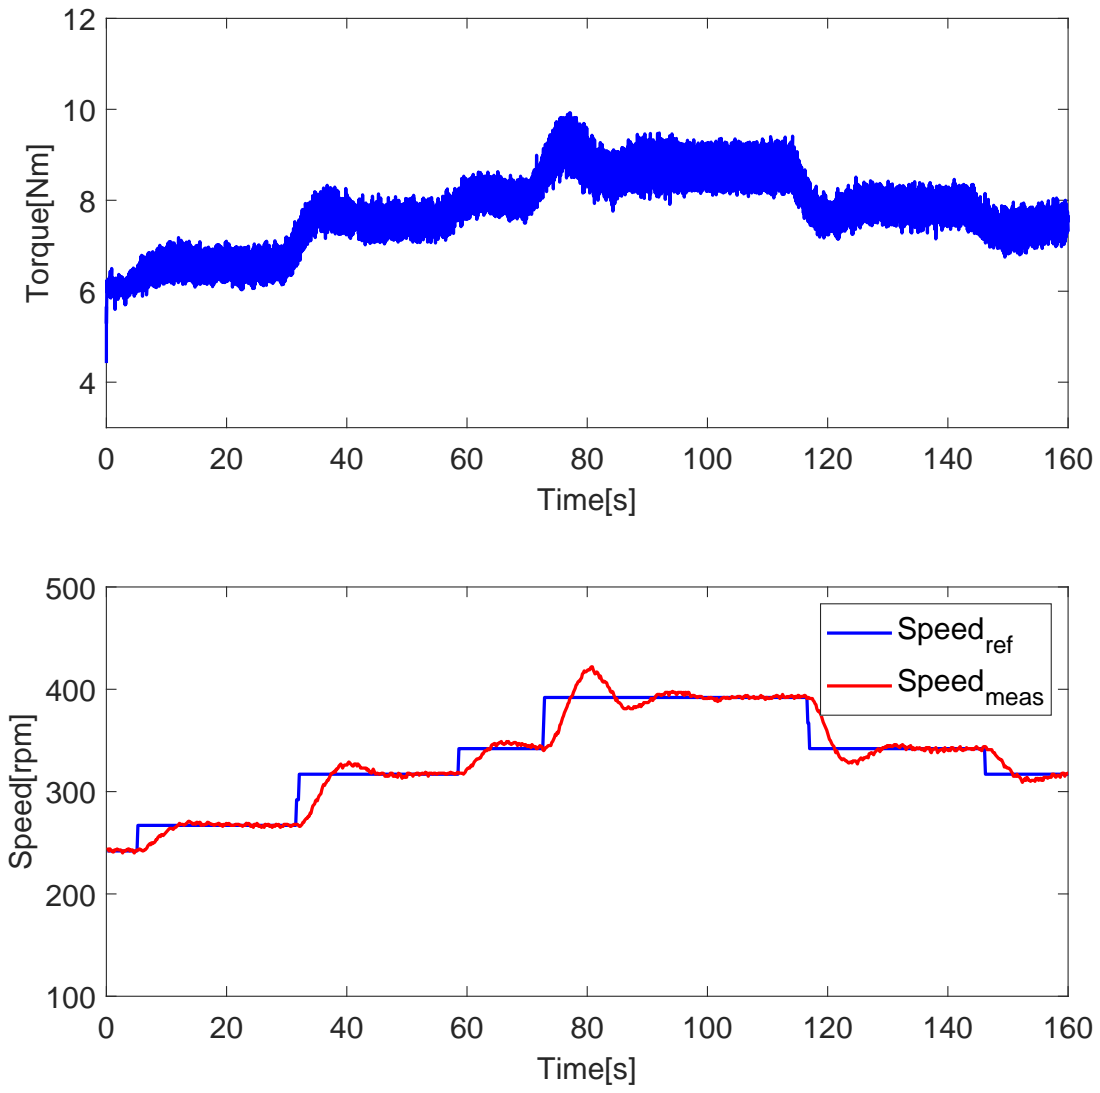
[picture p421: page 1]
Time[s]; Torque[Nm]; Speed[rpm]; Speedref Speedmeas
