NicolaiFransen/SemesterProjectPED2/Tests/20190524_Cruise_and_Torque_Tests/TorqueStartup/TorqueStartup_TorqueSpeed.pdf

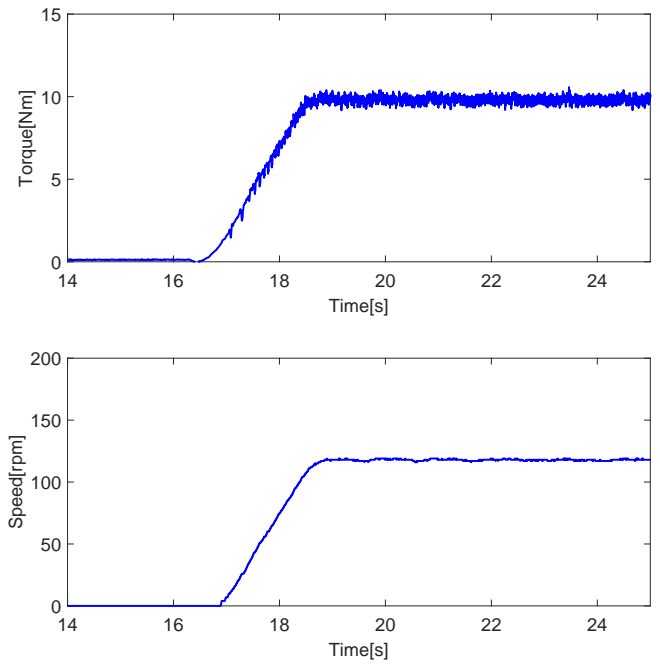
[picture p422: page 1]
Time[s]; Torque[Nm]; Speed[rpm]
