NicolaiFransen/SemesterProjectPED2/Tests/20190524_Cruise_and_Torque_Tests/TorqueSteadyState/SteadyState_IqId.pdf

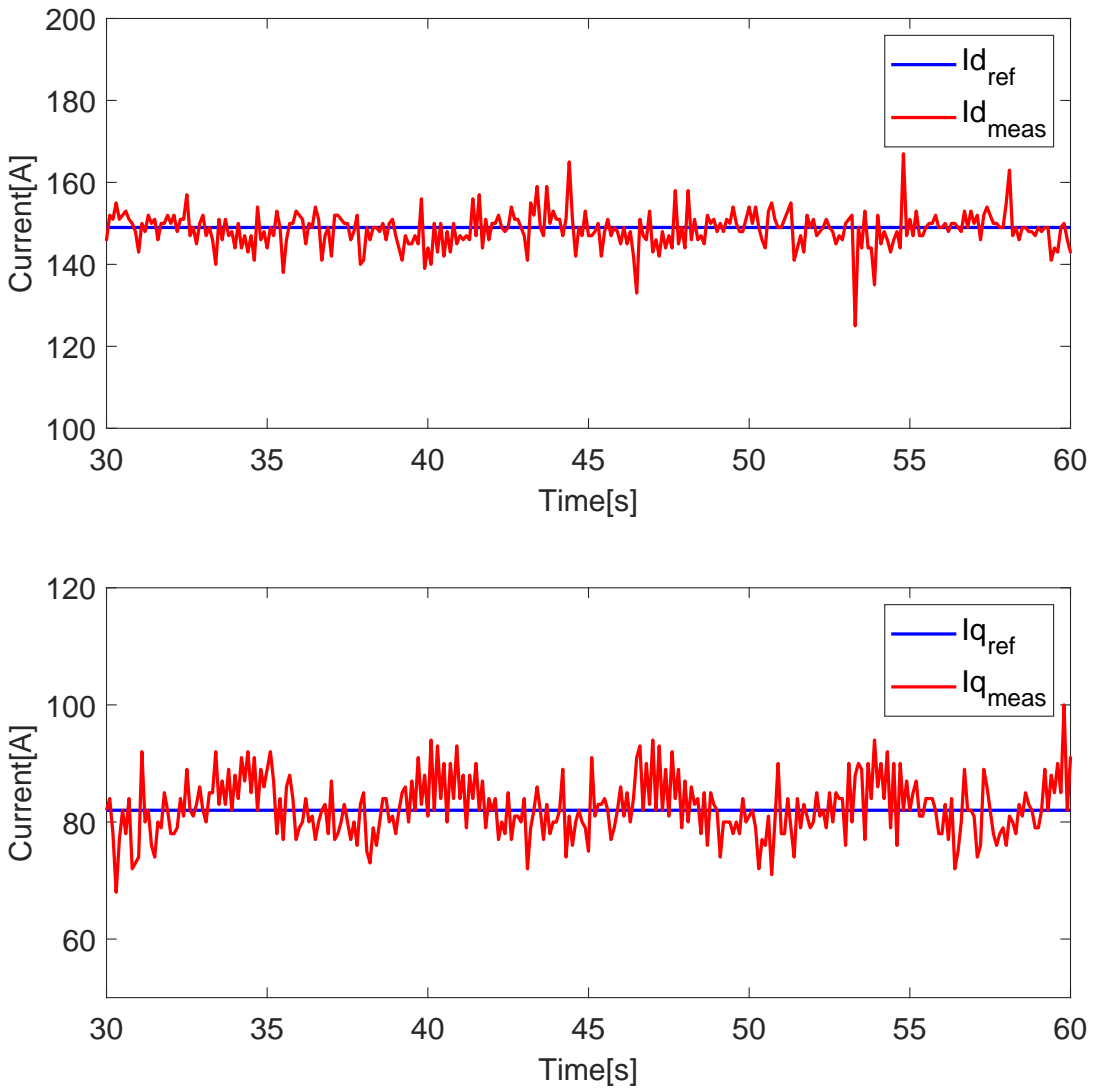
[picture p423: page 1]
Time[s]; Current[A]; Idref Id; meas; Iqref; Iqmeas
