NicolaiFransen/SemesterProjectPED2/Tests/20190524_Cruise_and_Torque_Tests/TorqueLoadStep/TorqueLoadStep_Iabc.pdf

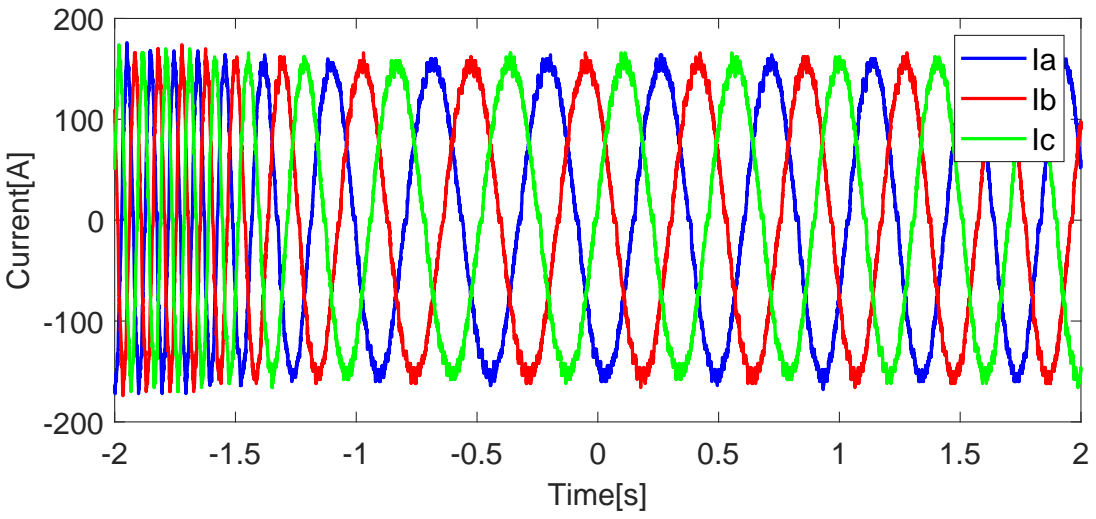
[picture p424: page 1]
Time[s]; Current[A]
