NicolaiFransen/SemesterProjectPED2/Tests/20190524_Cruise_and_Torque_Tests/TorqueLoadStep/TorqueLoadStep_IdIq.pdf

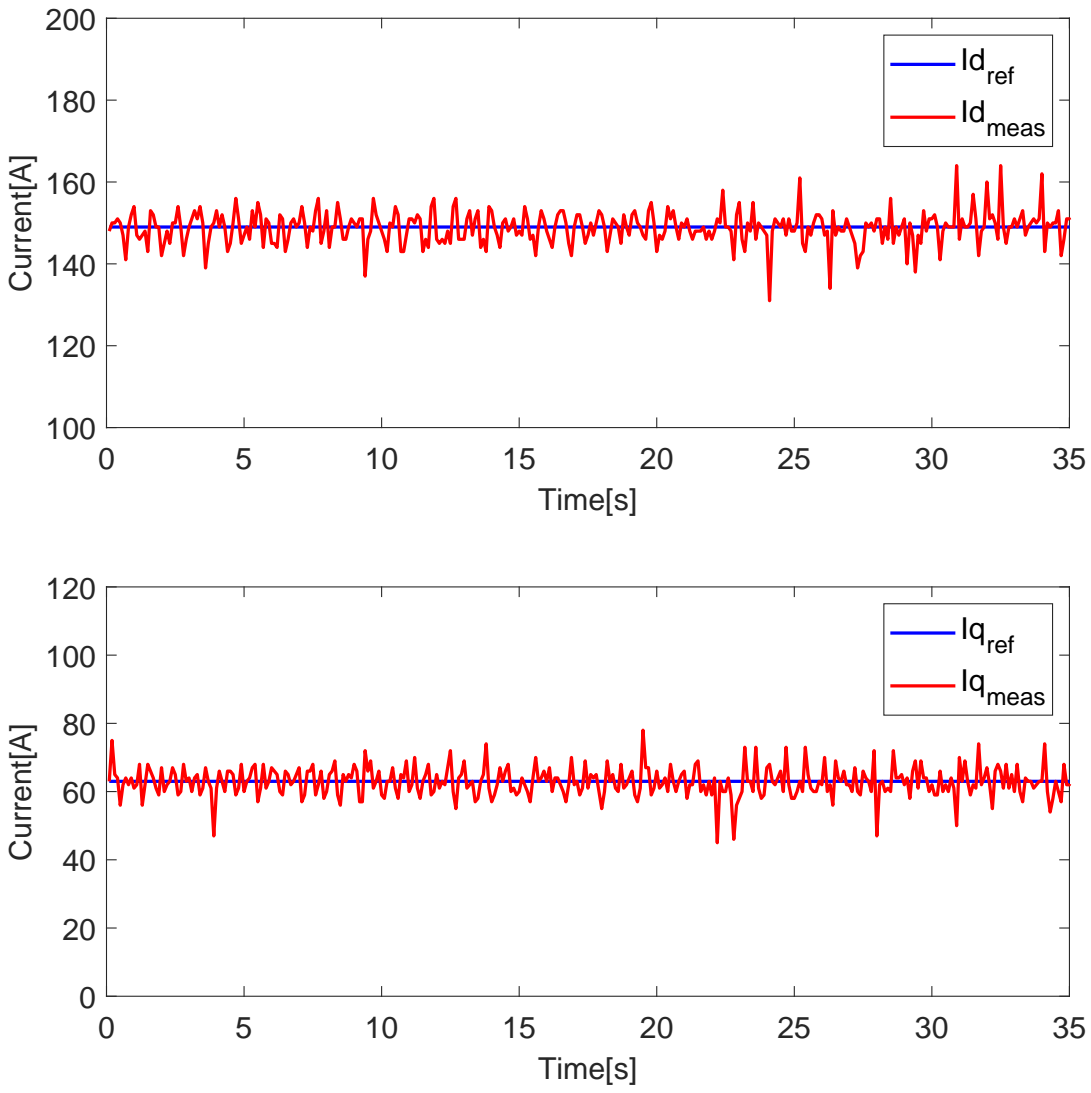
[picture p425: page 1]
Time[s]; Current[A]; Idref Id; meas; Iqref; Iqmeas
