NicolaiFransen/SemesterProjectPED2/Tests/20190524_Cruise_and_Torque_Tests/TorqueLoadStep/TorqueLoadStep_TorqueSpeed.pdf

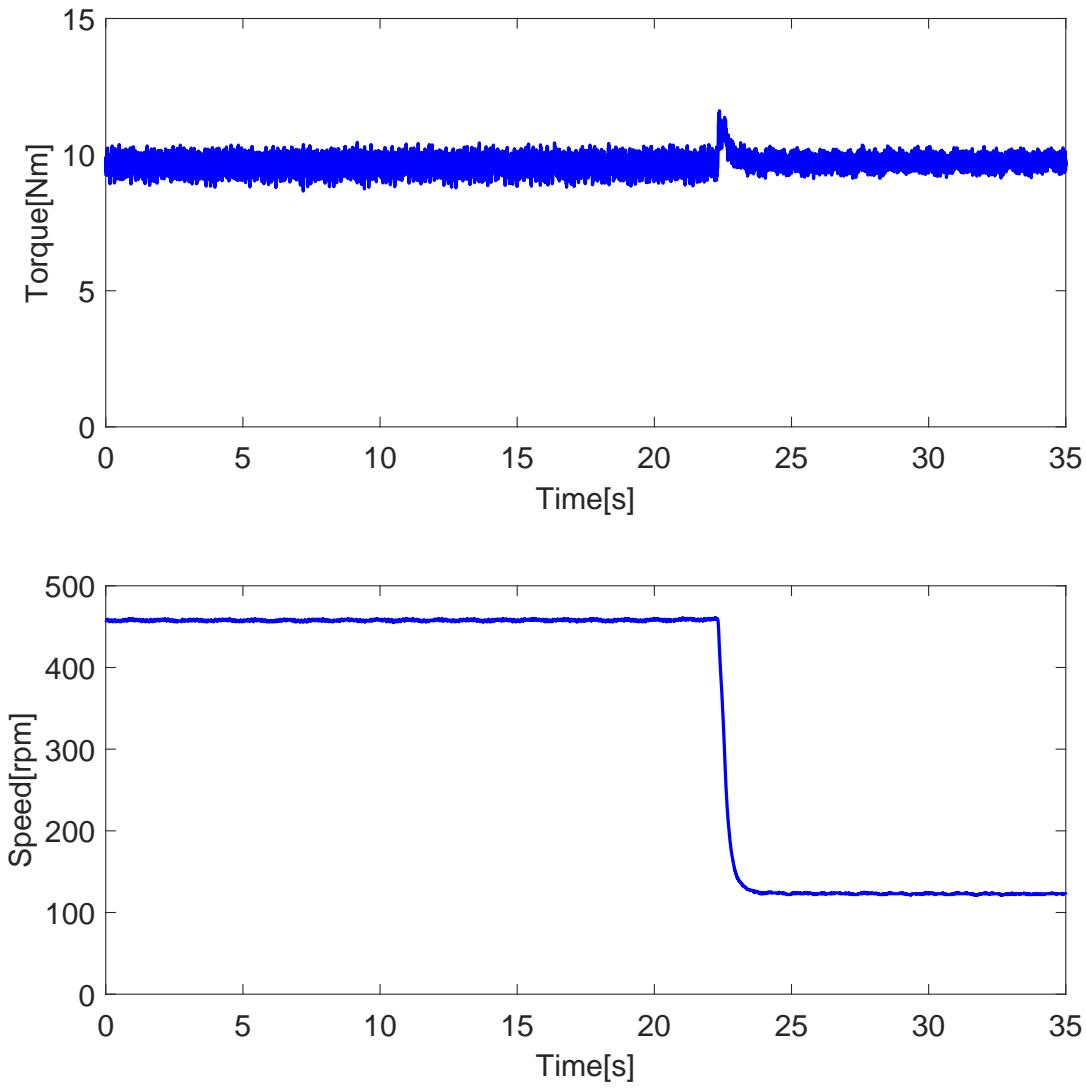
[picture p426: page 1]
Time[s]; Torque[Nm]; Speed[rpm]
