NicolaiFransen/SemesterProjectPED2/Tests/20190524_Cruise_and_Torque_Tests/TorqueRefStep/TorqueRefStep_Iabc.pdf

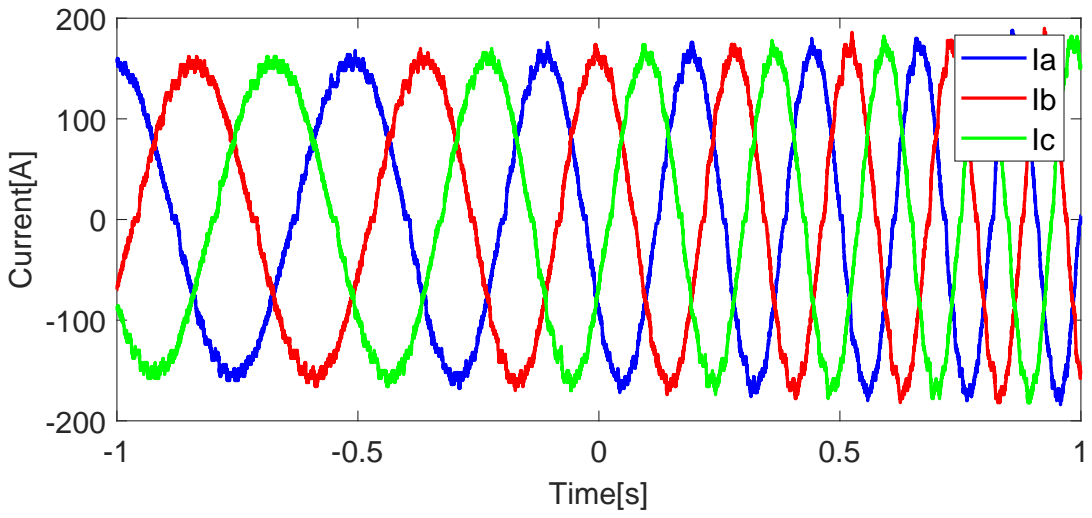
[picture p427: page 1]
Time[s]; Current[A]
