NicolaiFransen/SemesterProjectPED2/Tests/20190524_Cruise_and_Torque_Tests/TorqueRefStep/TorqueRefStep_IdIq.pdf

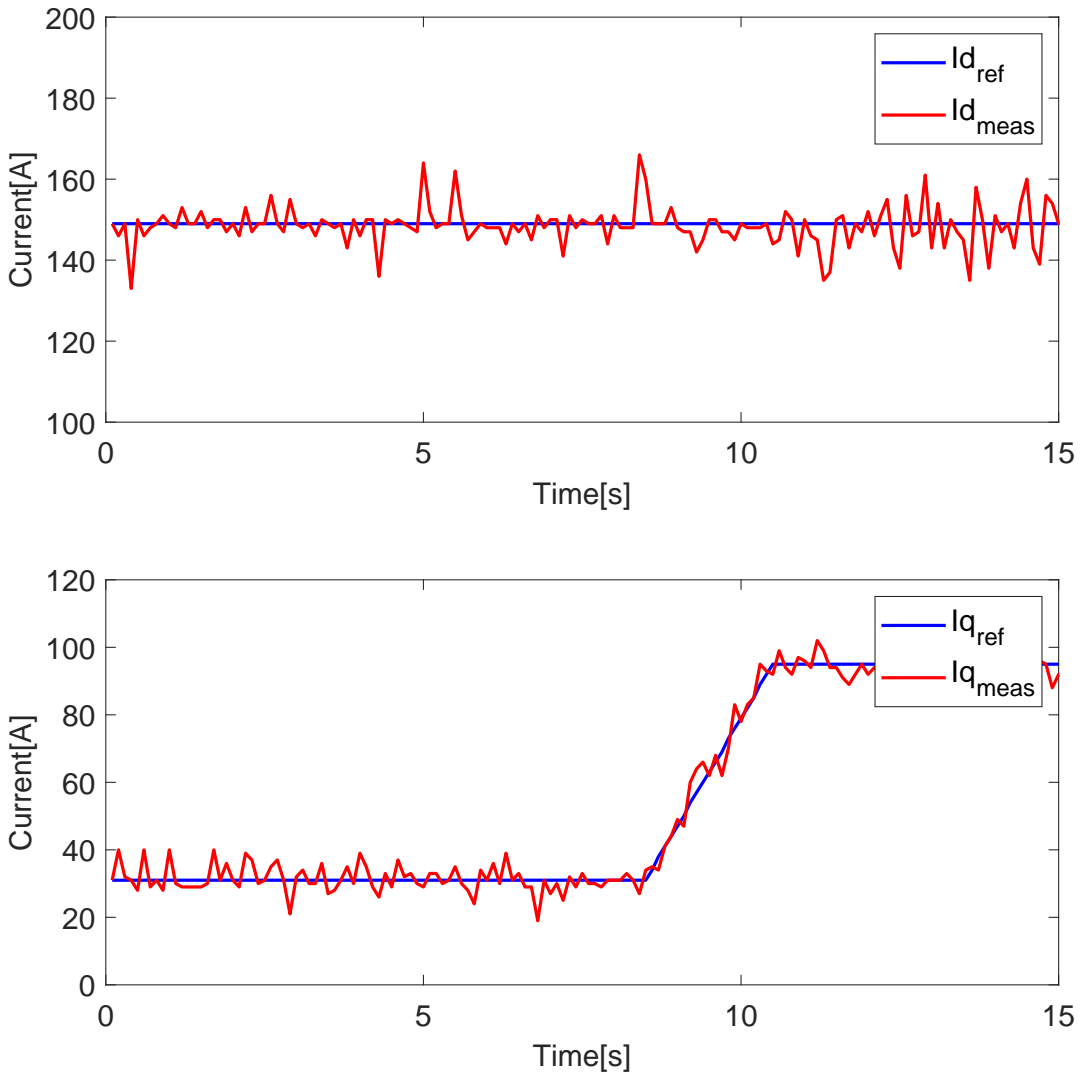
[picture p428: page 1]
Time[s]; Current[A]; Idref Id; meas; Iqref; Iqmeas
