NicolaiFransen/SemesterProjectPED2/Tests/20190524_Cruise_and_Torque_Tests/TorqueRefStep/TorqueRefStep_TorqueSpeed.pdf

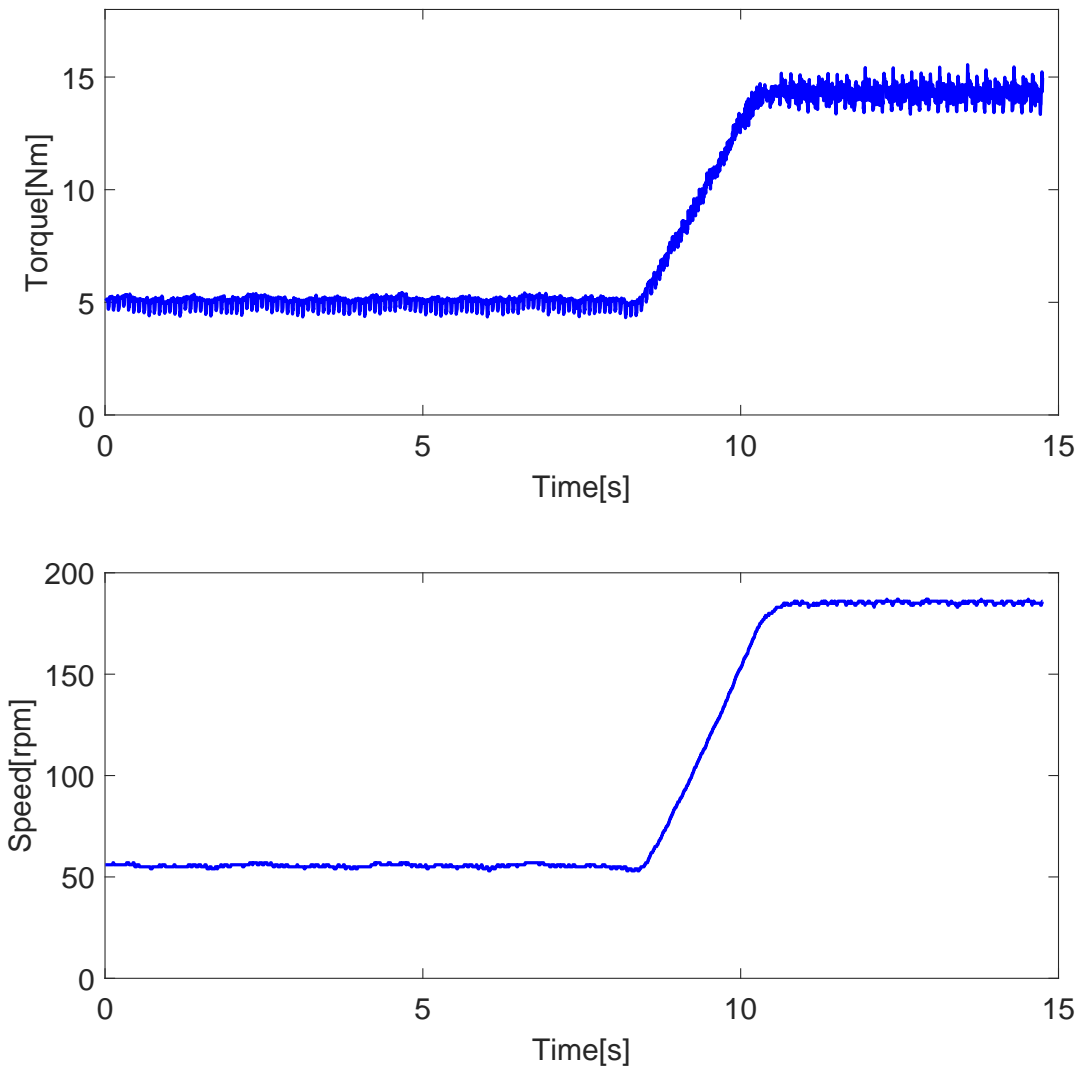
[picture p429: page 1]
Time[s]; Torque[Nm]; Speed[rpm]
