NicolaiFransen/SemesterProjectPED2/Tests/20190524_Cruise_and_Torque_Tests/TorqueSteadyState/SteadyState_Iabc.pdf

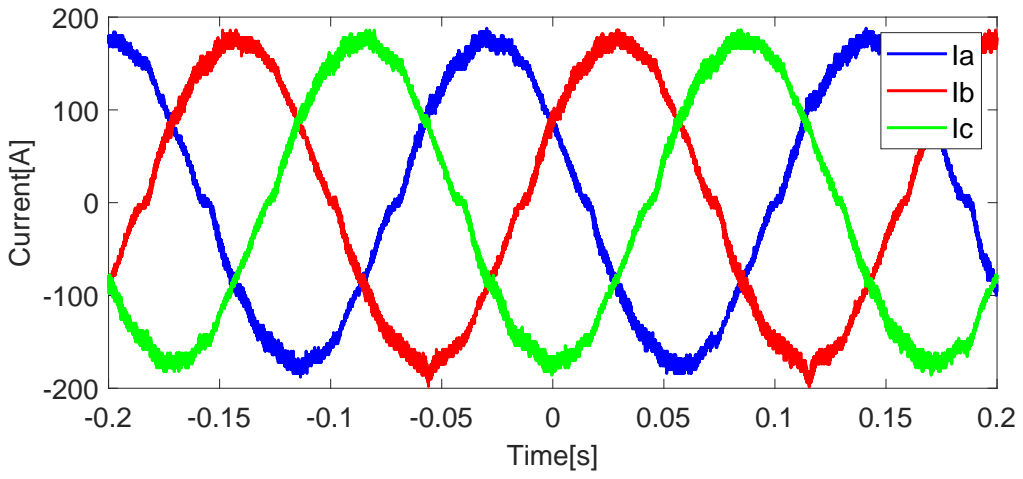
[picture p430: page 1]
Time[s]; Current[A]
