NicolaiFransen/SemesterProjectPED2/Tests/20190524_Cruise_and_Torque_Tests/TorqueSteadyState/SteadyState_TorqueSpeed.pdf

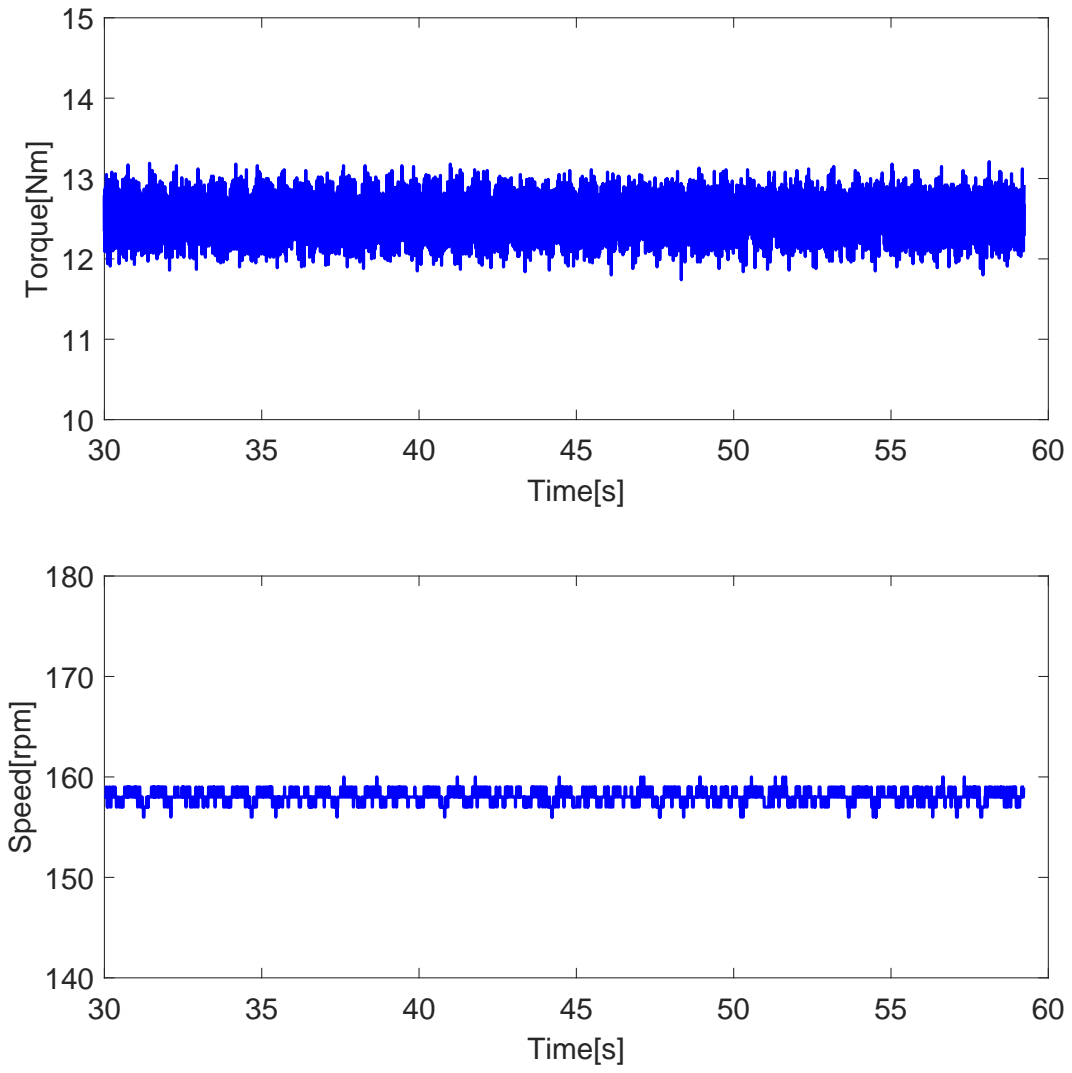
[picture p431: page 1]
Time[s]; Torque[Nm]; Speed[rpm]
