NicolaiFransen/SemesterProjectPED2/Tests/20190524_Cruise_and_Torque_Tests/TorqueToCruise/TorqueToCruise_Iabc.pdf

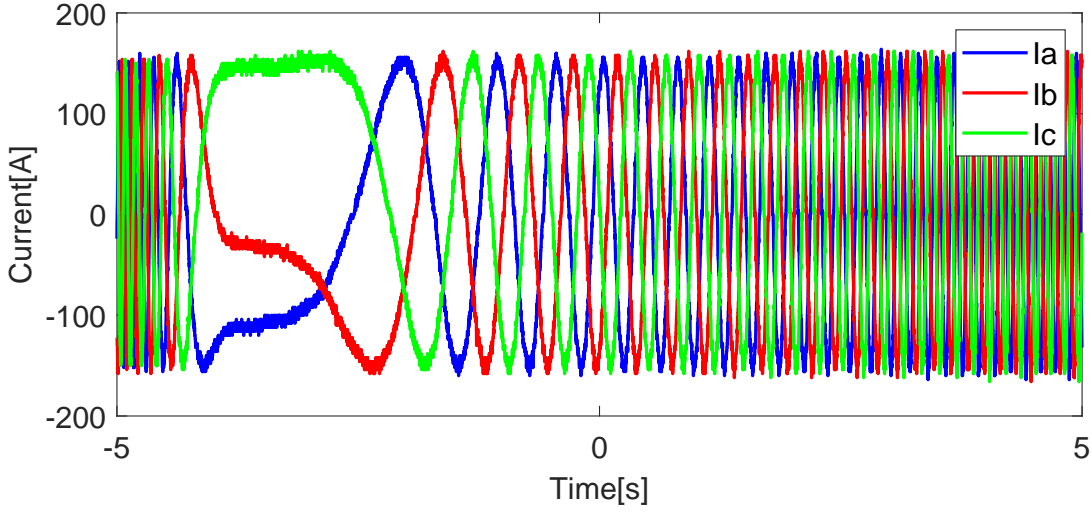
[picture p432: page 1]
Time[s]; Current[A]
