NicolaiFransen/SemesterProjectPED2/Tests/20190524_Cruise_and_Torque_Tests/TorqueToCruise/TorqueToCruise_TorqueSpeed.pdf

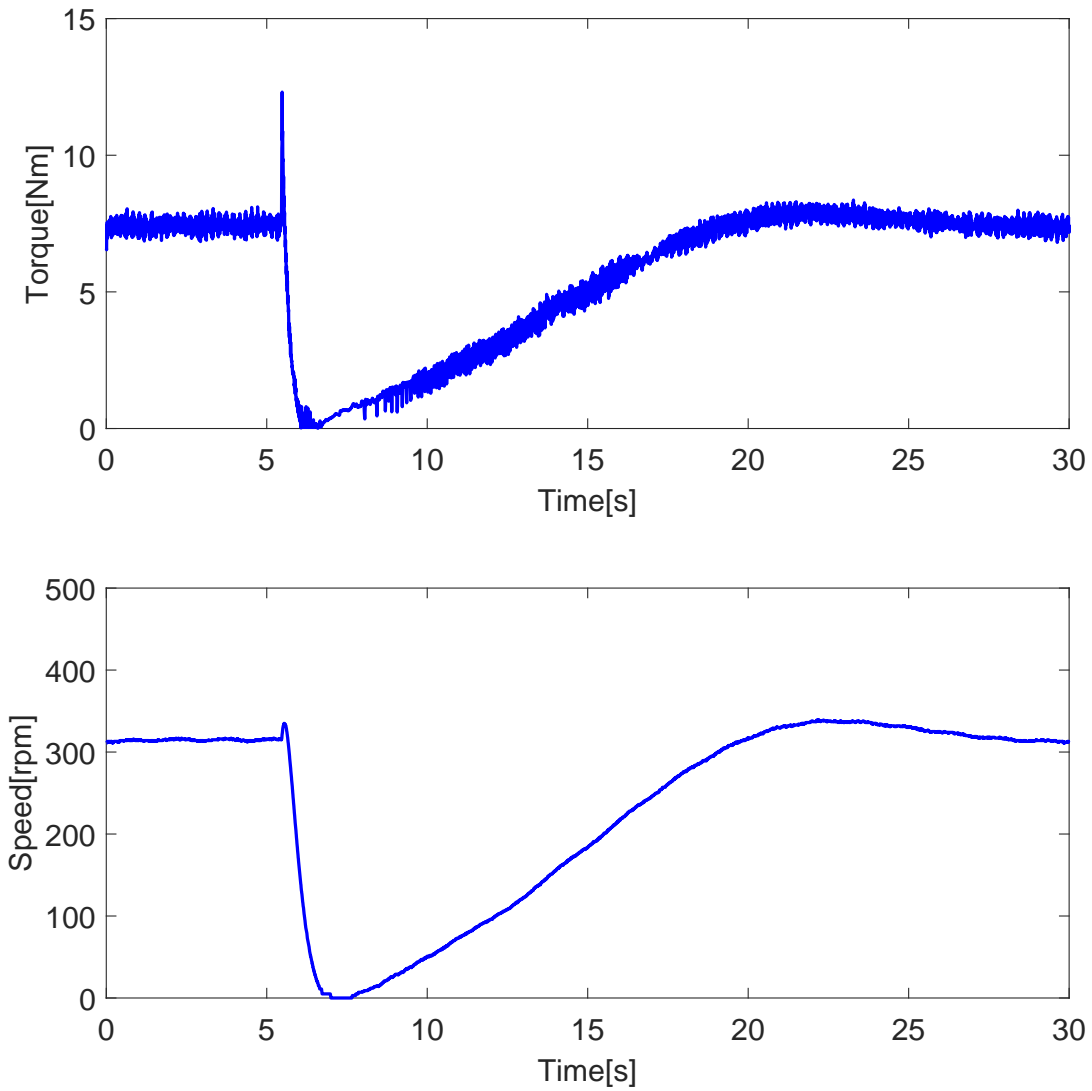
[picture p433: page 1]
Time[s]; Torque[Nm]; Speed[rpm]
