NicolaiFransen/SemesterProjectPED2/Report/Pictures/Software/SoftwareDesignProcedure.pdf

### Stage

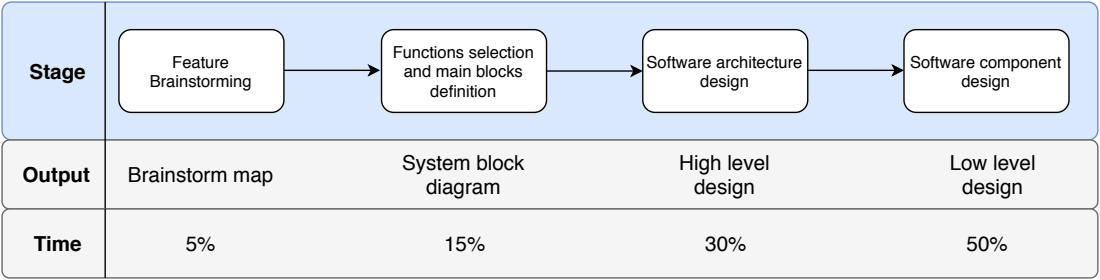
[picture p434: page 1]
Feature Brainstorming; Software architecture design; Software component design; Output; Brainstorm map; System block; diagram; High level design; Low level design; Time

Functions selection
and main blocks
definition
