NicolaiFransen/SemesterProjectPED2/Report/Diagrams/Test Setup/Test_setup.pdf

## Interface PCB

## DSP

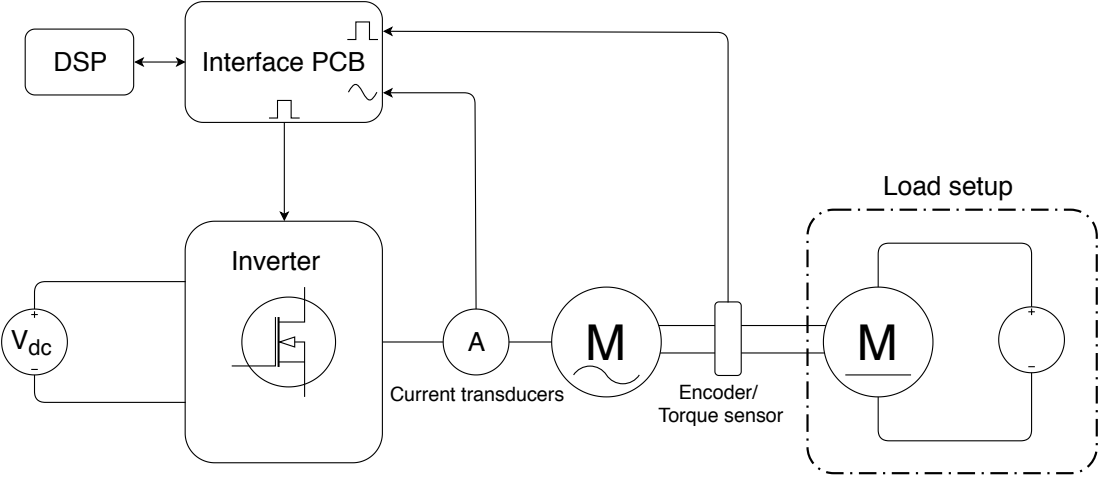
[picture p435: page 1]
Vdc; Inverter; Load setup; Current transducers; Encoder/; Torque sensor
