NicolaiFransen/SemesterProjectPED2/Report/Pictures/PWMsignals/PWMsignalsV4.pdf

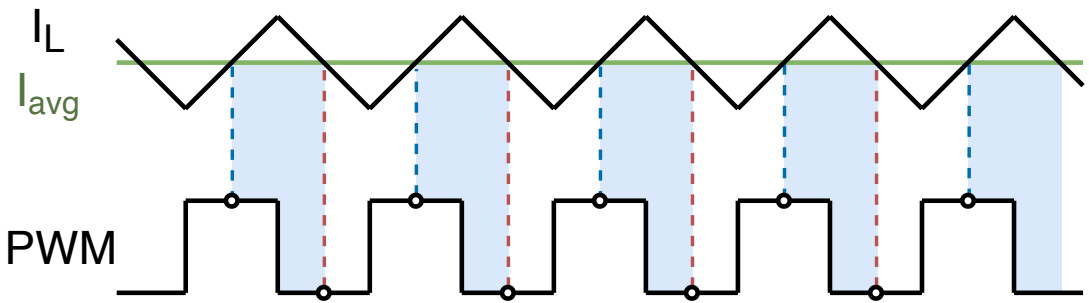
[picture p436: page 1]
PWM; Iavg
