NicolaiFransen/SemesterProjectPED2/Report/Pictures/Induction machine overleaf/BD_IM_validation.pdf

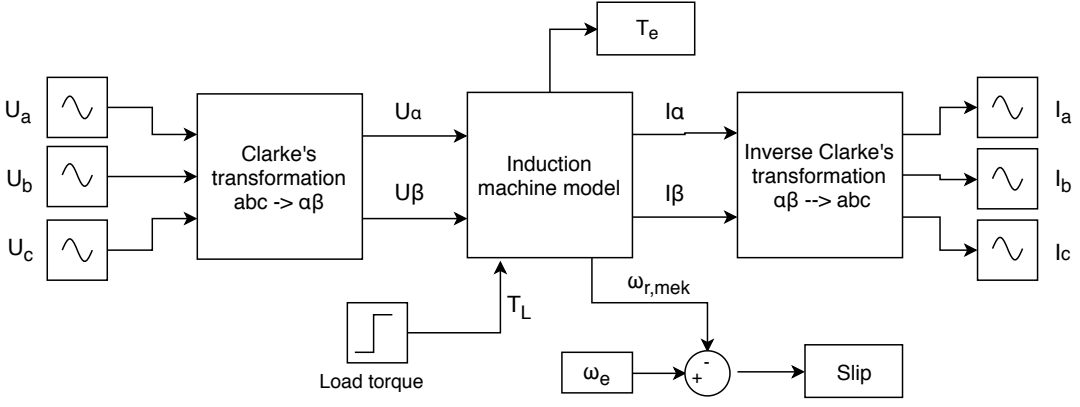
[picture p437: page 1]
Induction machine model; Clarke's transformation abc -> αβ; Load torque; Inverse Clarke's transformation αβ --> abc; ωr,mek; Slip
