NicolaiFransen/SemesterProjectPED2/Report/Pictures/Software/SystemMainBlocks.pdf

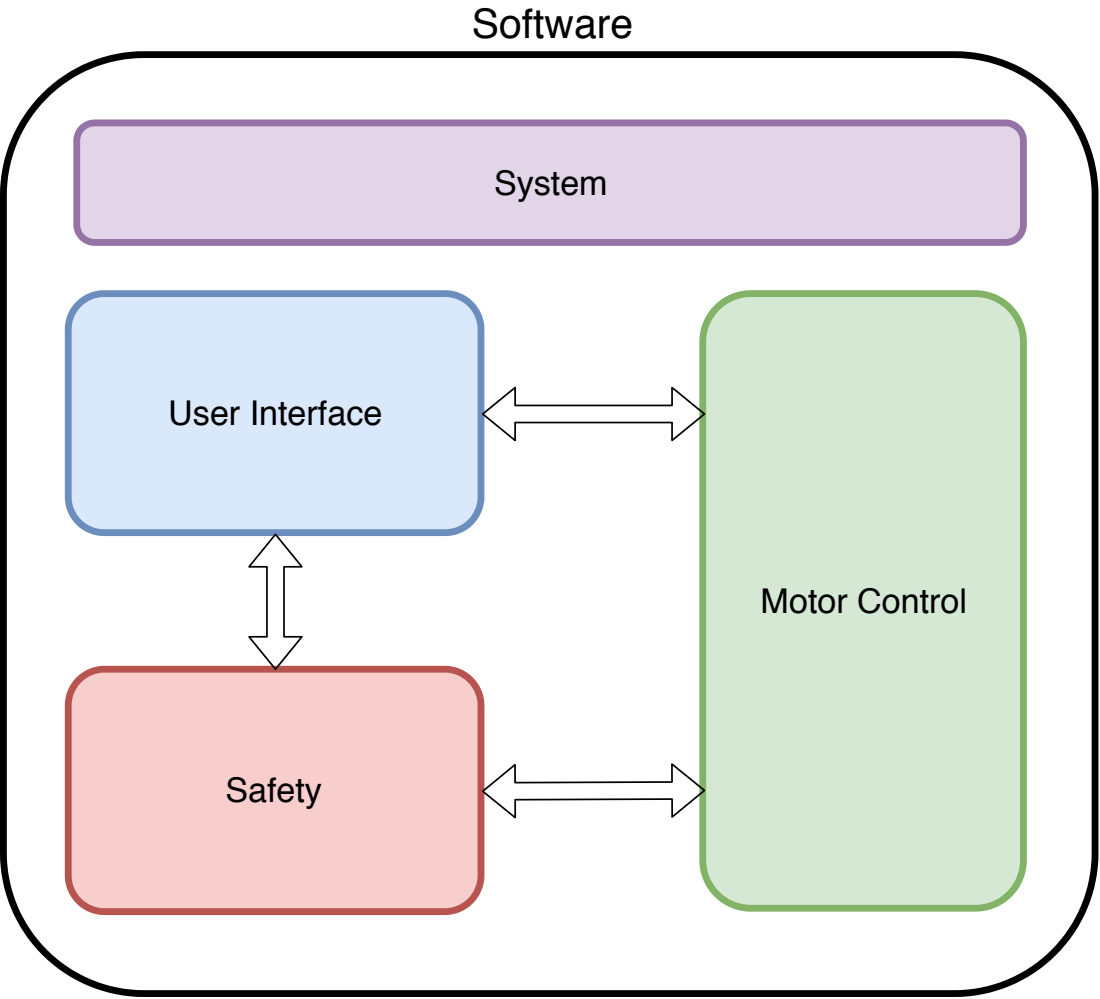
[picture p438: page 1]
User Interface; System; Safety; Motor Control; Software
