NicolaiFransen/SemesterProjectPED2/Tests/20190524_Cruise_and_Torque_Tests/Simulations/TorqueToSpeed/TestBench_OnlyTorque.pdf

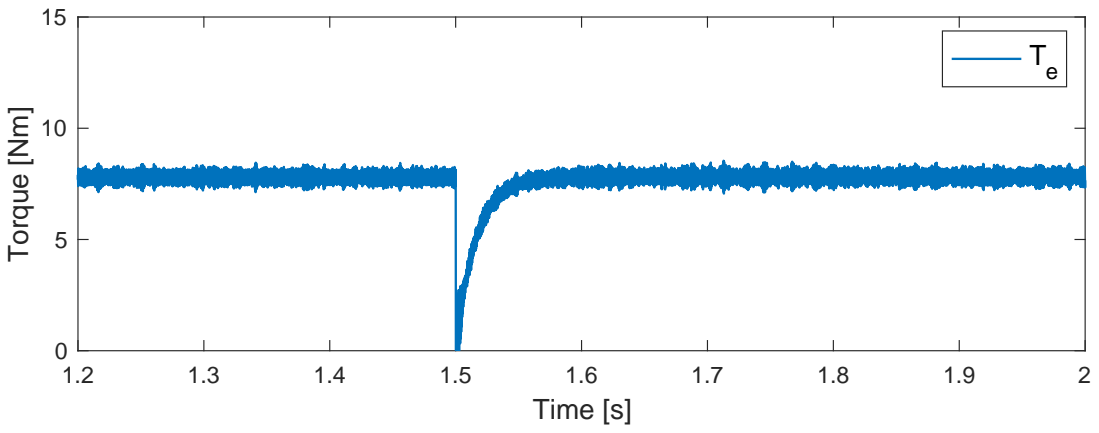
[picture p440: page 1]
Time [s]; Torque [Nm]
