NicolaiFransen/SemesterProjectPED2/Tests/20190524_Cruise_and_Torque_Tests/Simulations/TorqueToSpeed/TestBench_Torque.pdf

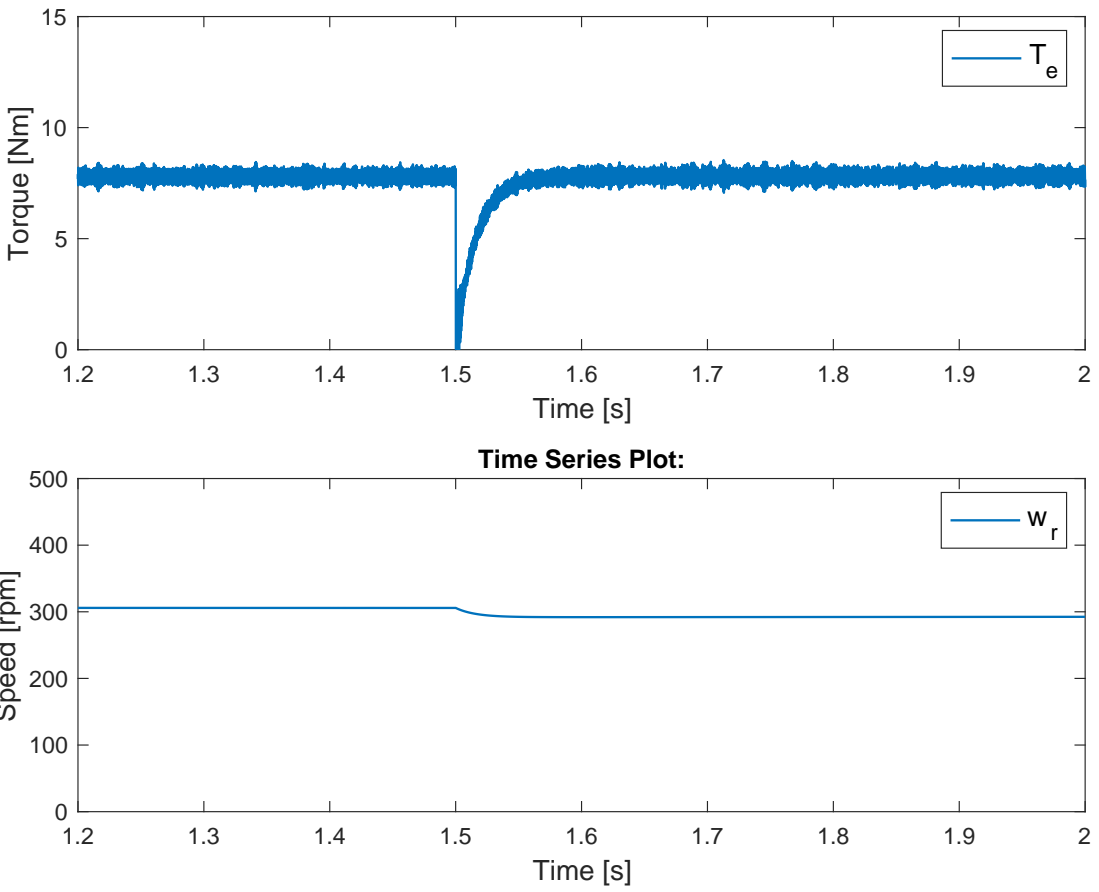
[picture p441: page 1]
Torque [Nm]; Time [s]; Speed [rpm]

Time [s]
Time Series Plot:
