NicolaiFransen/SemesterProjectPED2/Tests/20190524_Cruise_and_Torque_Tests/Simulations/Torque startup/idiq_startup_From0.pdf

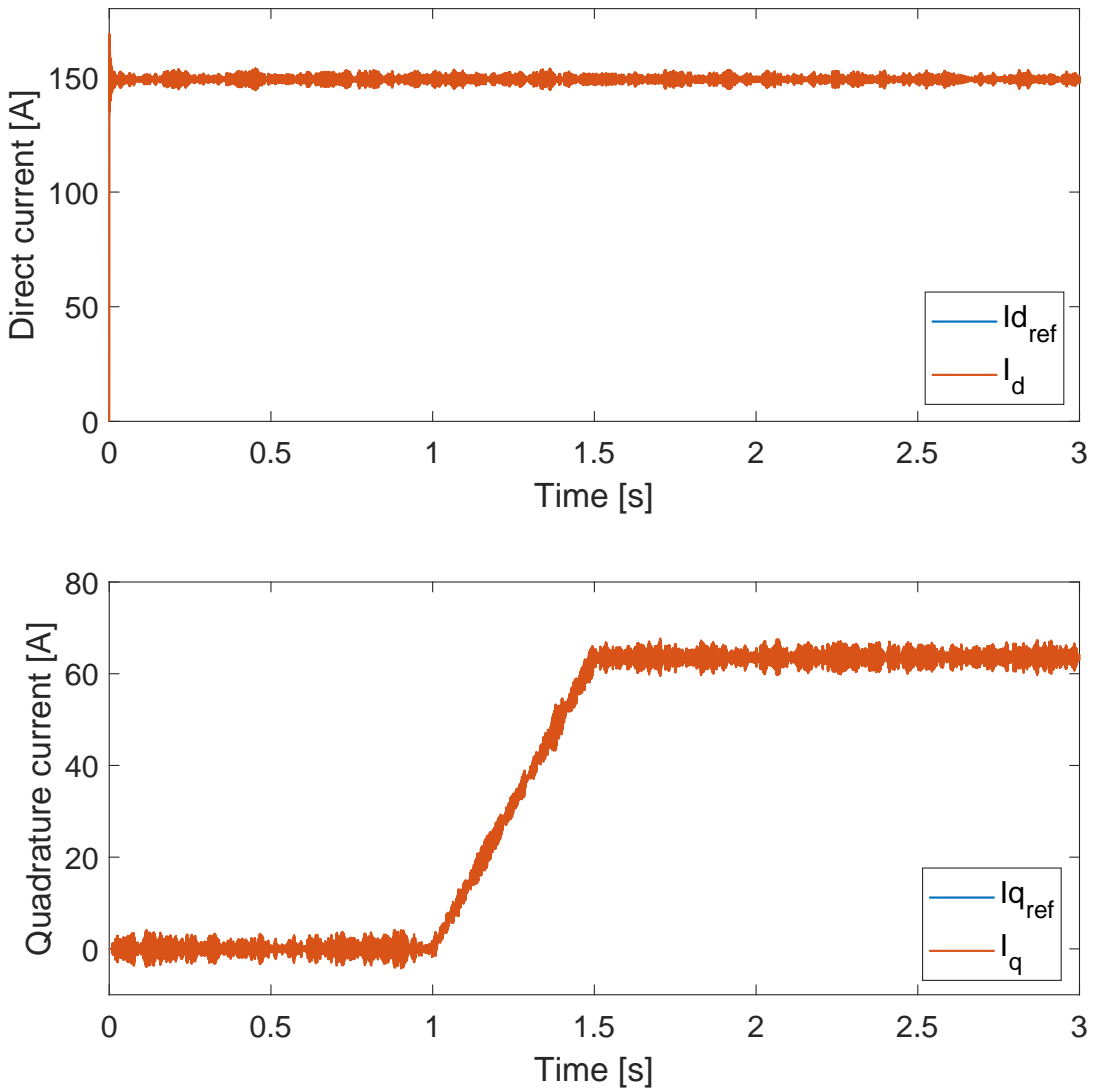
[picture p442: page 1]
Time [s]; Direct current [A]; Idref Id; Quadrature current [A]; Iqref Iq
