NicolaiFransen/SemesterProjectPED2/Tests/20190524_Cruise_and_Torque_Tests/Simulations/Torque startup/T_w_startup_OnnlyTorque.pdf

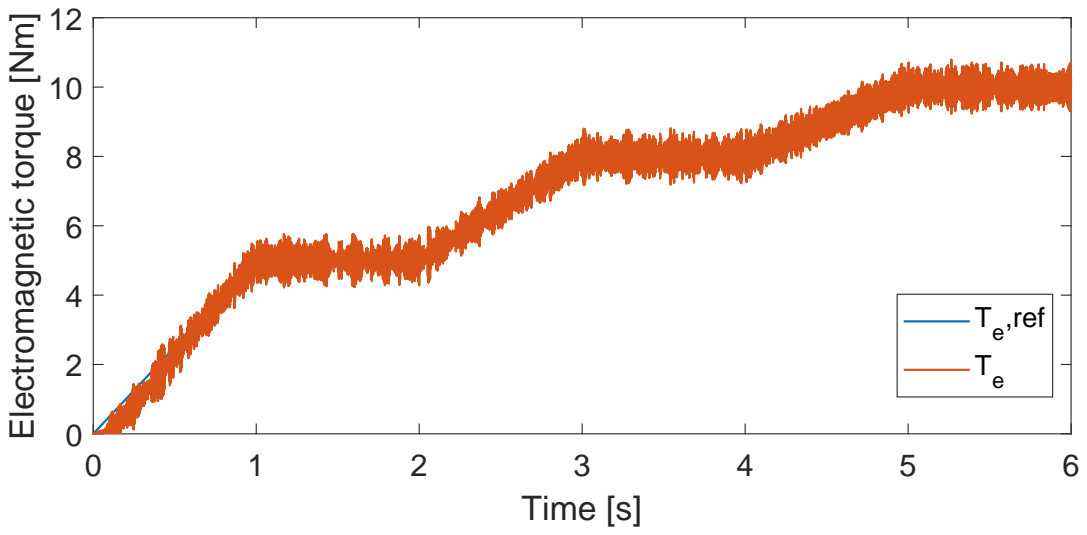
[picture p443: page 1]
Time [s]; ,ref

Electromagnetic torque [Nm]
