NicolaiFransen/SemesterProjectPED2/Tests/20190524_Cruise_and_Torque_Tests/Simulations/Torque steady state/T_w_ss_OnlyTorque.pdf

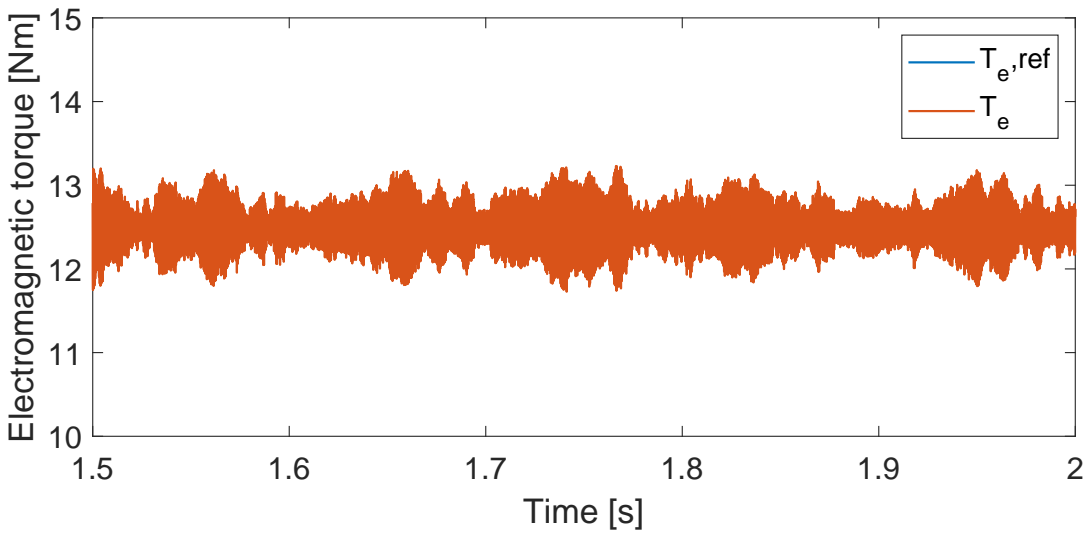
[picture p444: page 1]
Time [s]; ,ref

Electromagnetic torque [Nm]
