NicolaiFransen/SemesterProjectPED2/Tests/20190524_Cruise_and_Torque_Tests/Simulations/Torque step/Tw_torquestep_OnlyTorque.pdf

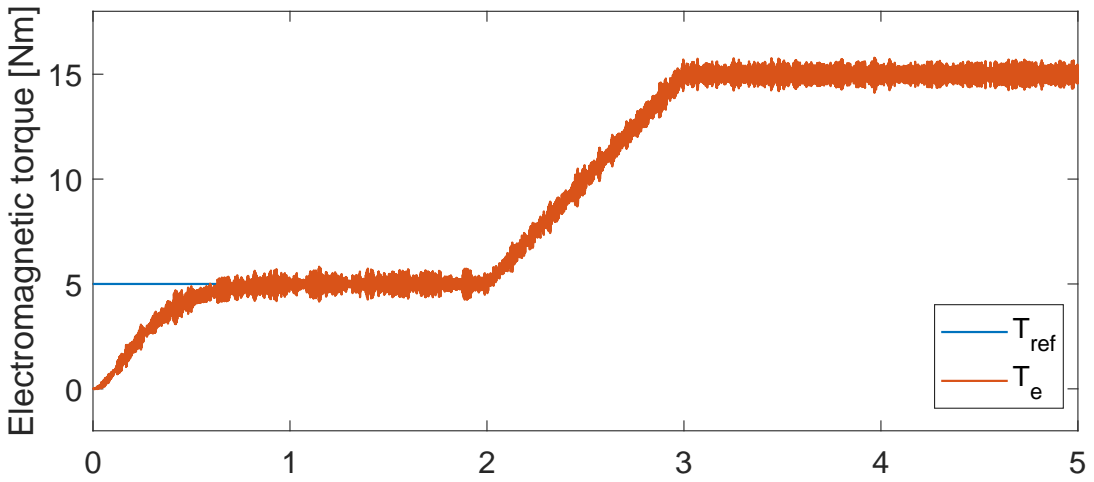
[picture p445: page 1]
Time [s]; ref

Electromagnetic torque [Nm]
