NicolaiFransen/SemesterProjectPED2/Tests/20190524_Cruise_and_Torque_Tests/Simulations/speed load/currents_speedload.pdf

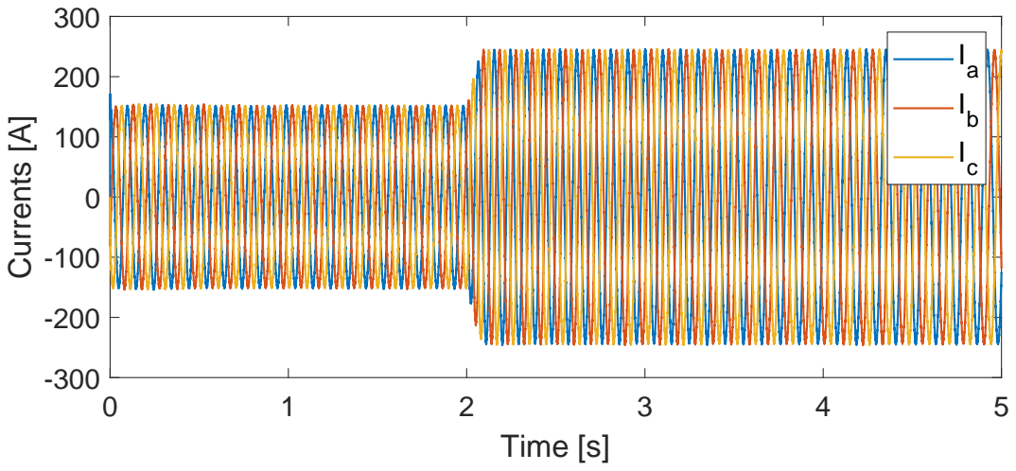
[picture p446: page 1]
Time [s]; Currents [A] IaIbIc
