NicolaiFransen/SemesterProjectPED2/Tests/20190524_Cruise_and_Torque_Tests/Simulations/speed load/currents_speedload2.pdf

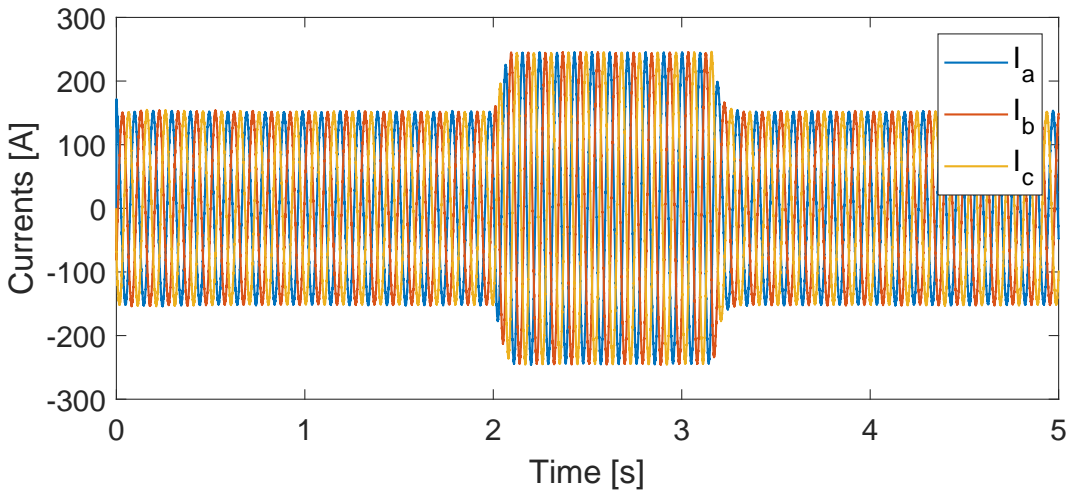
[picture p447: page 1]
Time [s]; Currents [A] IaIbIc
