NicolaiFransen/SemesterProjectPED2/Tests/20190524_Cruise_and_Torque_Tests/Simulations/speed load/id_iq_speedload2.pdf

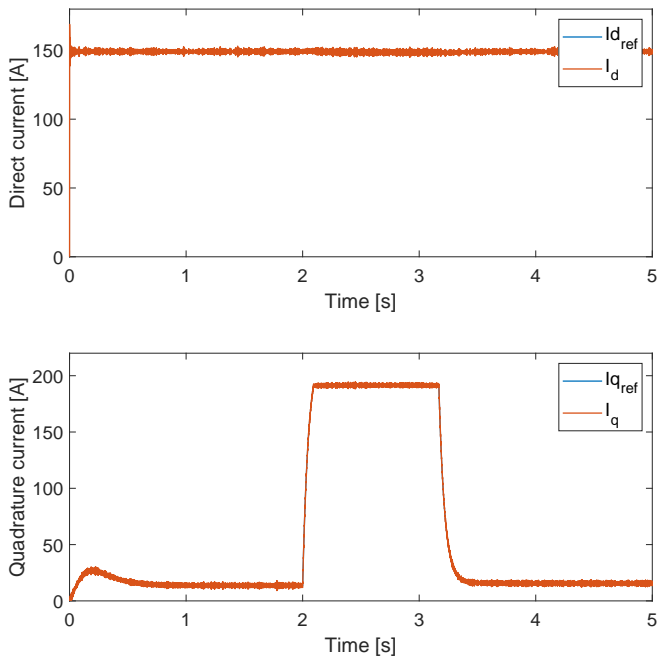
[picture p449: page 1]
Time [s]; Direct current [A]; Idref Id; Quadrature current [A]; Iqref Iq
