NicolaiFransen/SemesterProjectPED2/Tests/20190524_Cruise_and_Torque_Tests/Simulations/speed load/T_w_speedload2.pdf

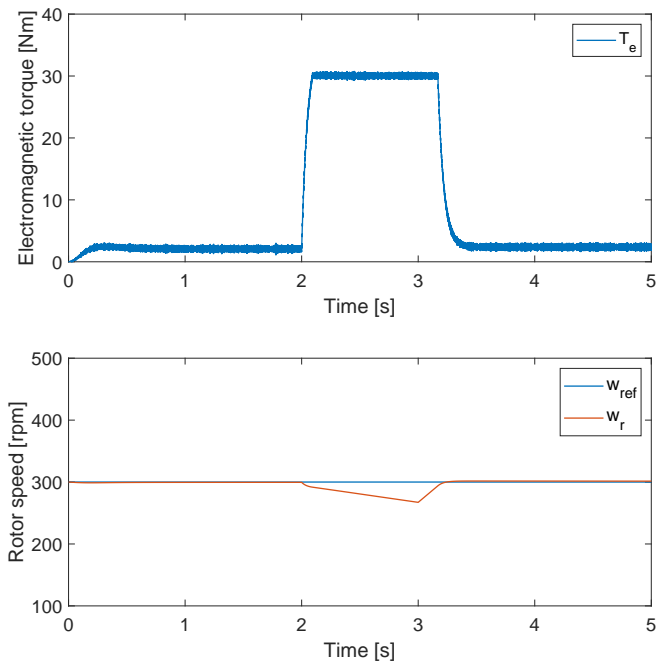
[picture p451: page 1]
Time [s]; wref wr

Electromagnetic torque [Nm]

Rotor speed [rpm]
