NicolaiFransen/SemesterProjectPED2/Tests/20190524_Cruise_and_Torque_Tests/Simulations/speed step/currents_speedstep.pdf

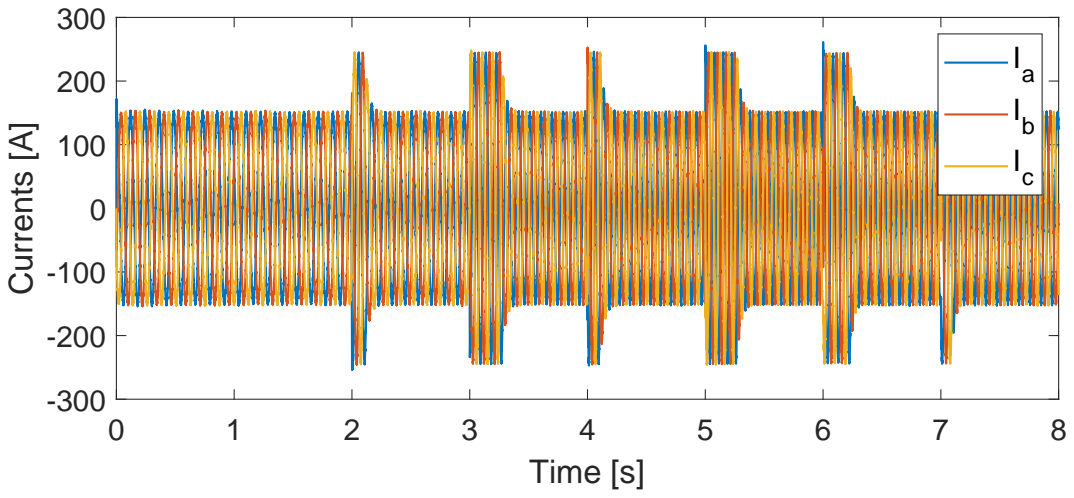
[picture p452: page 1]
Time [s]; Currents [A] IaIbIc
