NicolaiFransen/SemesterProjectPED2/Tests/20190524_Cruise_and_Torque_Tests/Simulations/speed step/id_iq_speedstep.pdf

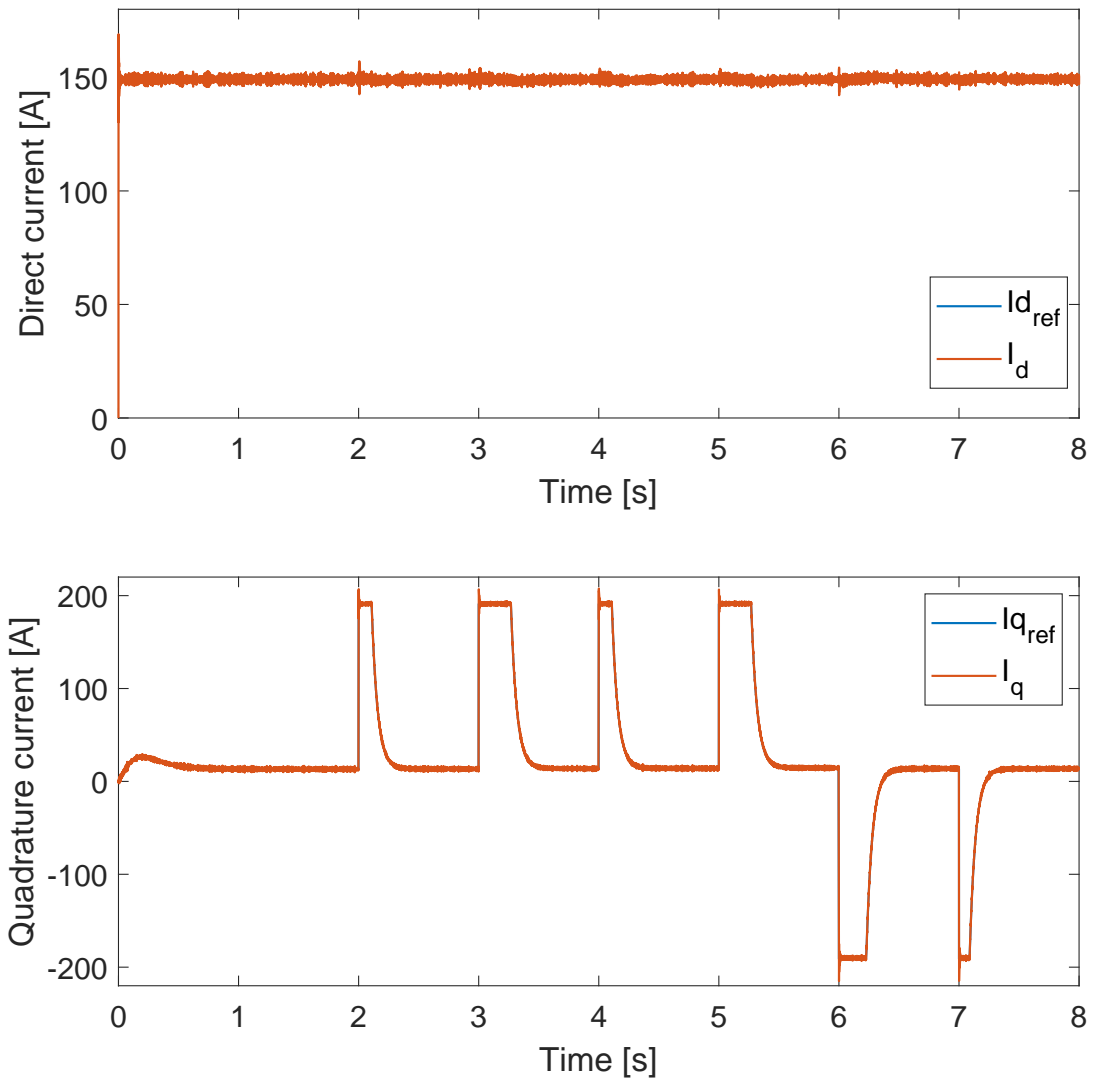
[picture p453: page 1]
Time [s]; Direct current [A]; Idref Id; Quadrature current [A]; Iqref Iq
