NicolaiFransen/SemesterProjectPED2/Tests/20190524_Cruise_and_Torque_Tests/Simulations/speed step/T_w_speedstep2.pdf

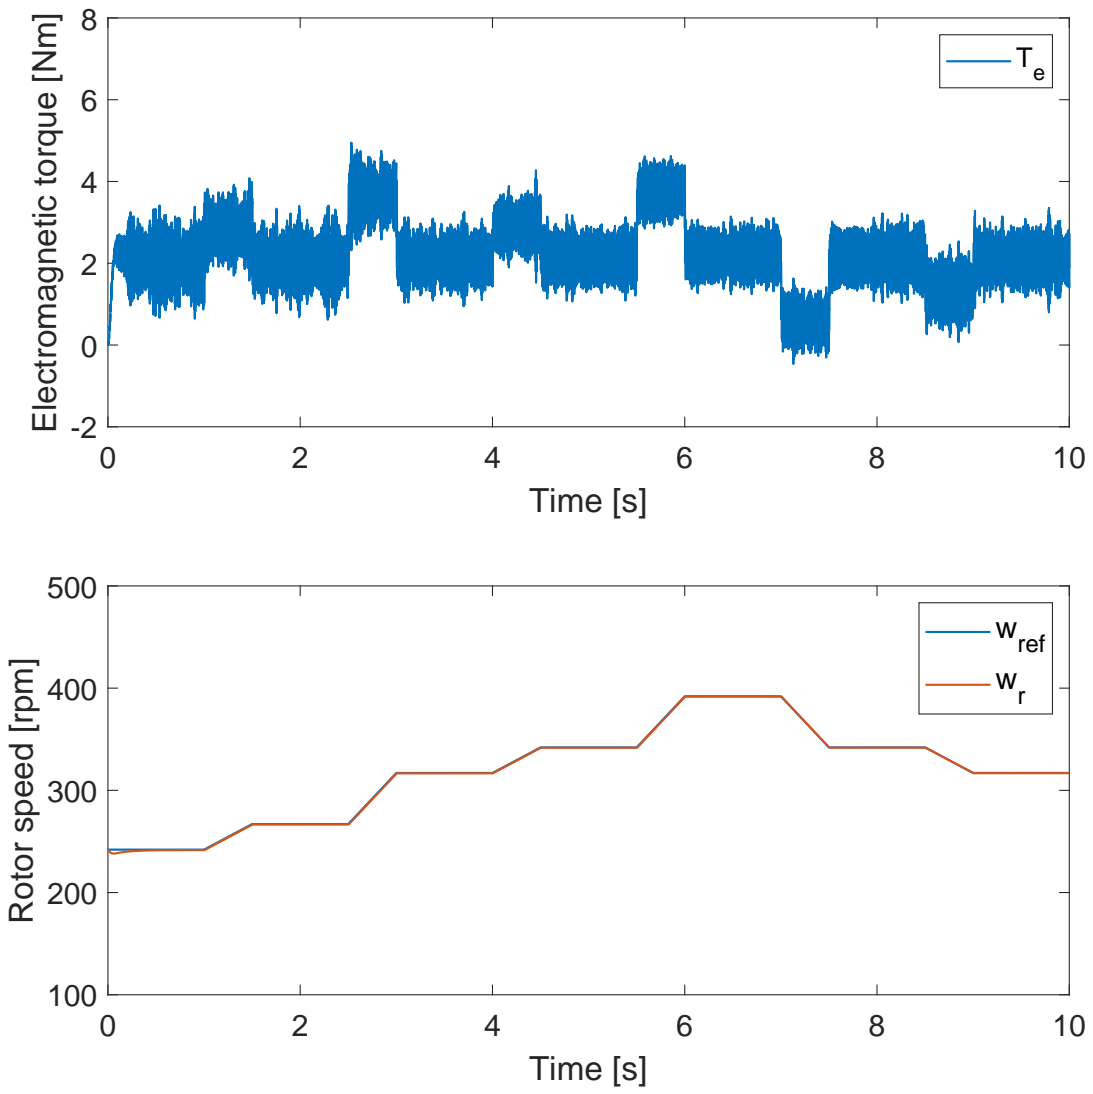
[picture p456: page 1]
Time [s]; wref wr

Electromagnetic torque [Nm]

Rotor speed [rpm]
