NicolaiFransen/SemesterProjectPED2/Tests/20190524_Cruise_and_Torque_Tests/Simulations/Torque startup/id_iq_startup.pdf

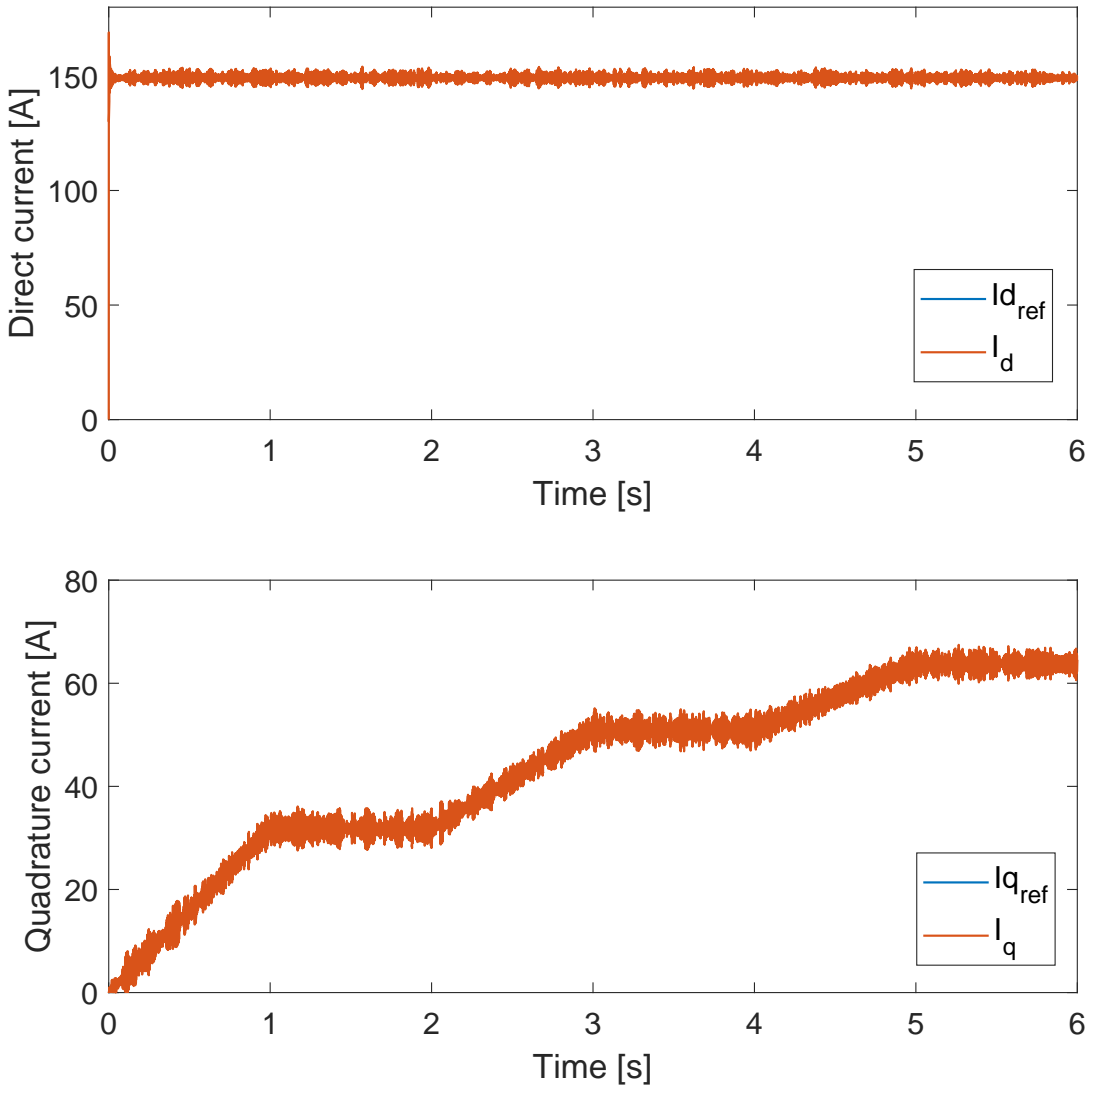
[picture p457: page 1]
Time [s]; Direct current [A]; Idref Id; Quadrature current [A]; Iqref Iq
