NicolaiFransen/SemesterProjectPED2/Tests/20190524_Cruise_and_Torque_Tests/Simulations/Torque startup/T_w_startup.pdf

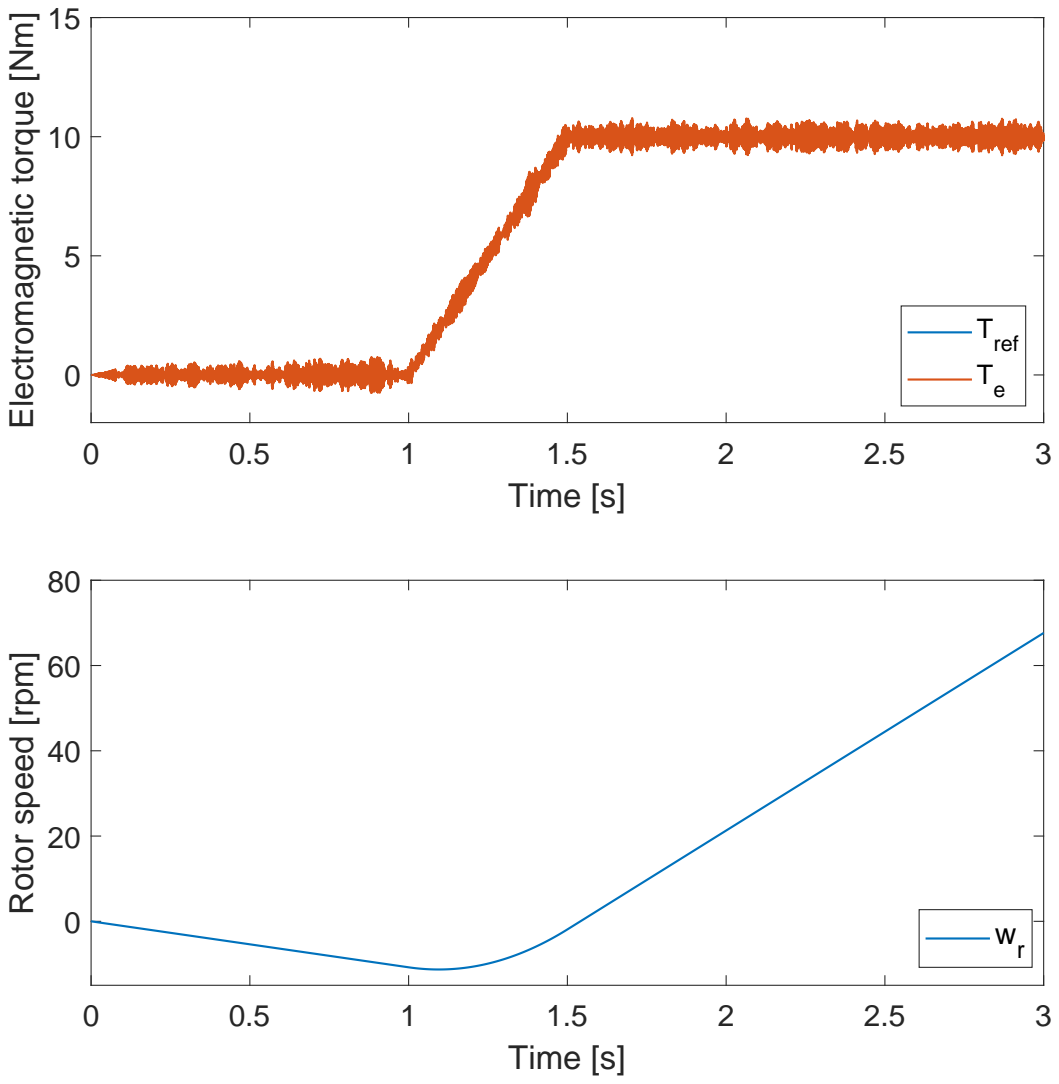
[picture p458: page 1]
Time [s]; ref

Electromagnetic torque [Nm]

Rotor speed [rpm]
