NicolaiFransen/SemesterProjectPED2/Tests/20190524_Cruise_and_Torque_Tests/Simulations/Torque step/currents_torquestep.pdf

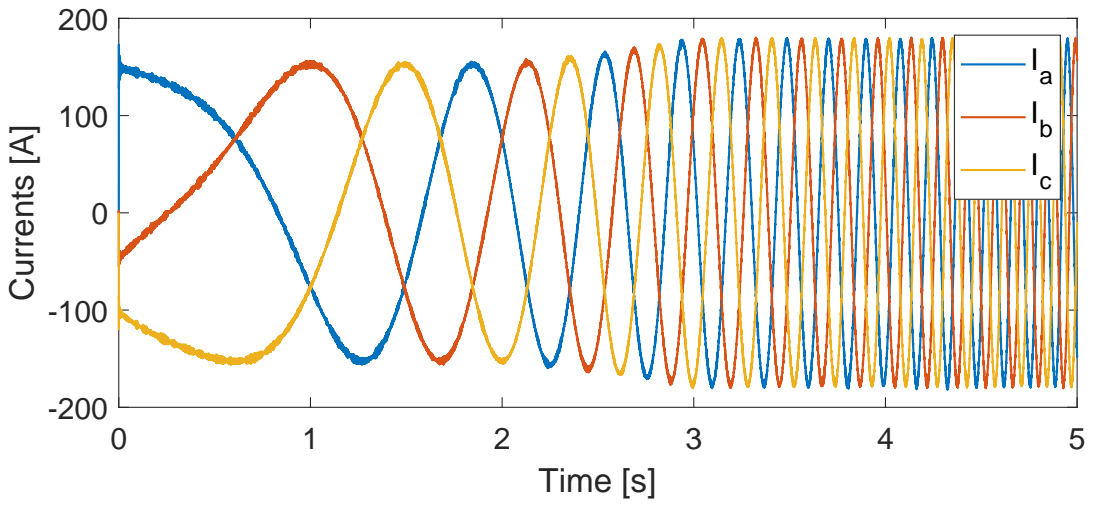
[picture p459: page 1]
Time [s]; Currents [A]
