NicolaiFransen/SemesterProjectPED2/Tests/20190524_Cruise_and_Torque_Tests/Simulations/Torque step/idiq_torquestep.pdf

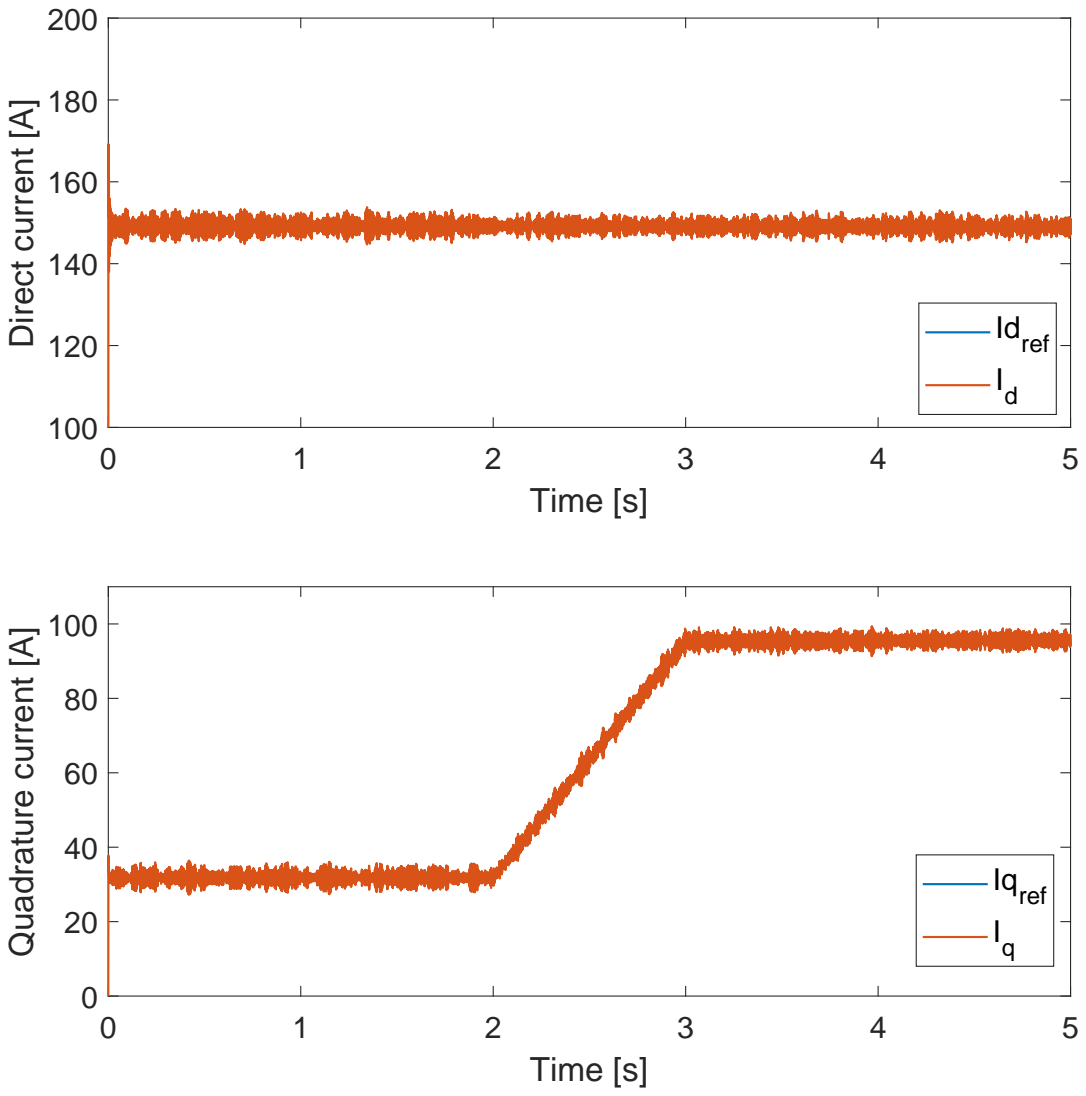
[picture p460: page 1]
Time [s]; Direct current [A]; Idref Id; Quadrature current [A]; Iqref Iq
