NicolaiFransen/SemesterProjectPED2/Report/Pictures/Induction machine overleaf/IMcircuit_alpha.pdf

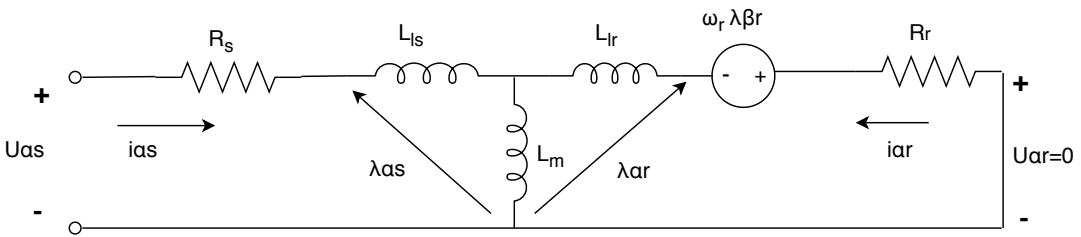
[picture p462: page 1]
Uαs; iαs; iαr; Uαr=0; ωr λβr; Lls; Llr; λαs; λαr
