NicolaiFransen/SemesterProjectPED2/Report/Pictures/Induction machine overleaf/IMcircuit_beta.pdf

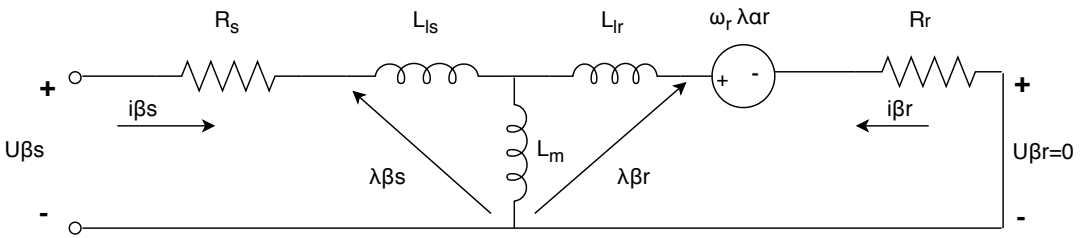
[picture p463: page 1]
Uβs; Uβr=0; iβs; iβr L; ωr λαr ls; Llr Lm Rs; λβr
