NicolaiFransen/SemesterProjectPED2/Report/Pictures/ProjectManagment/TrelloCardsOrganizationV5.pdf

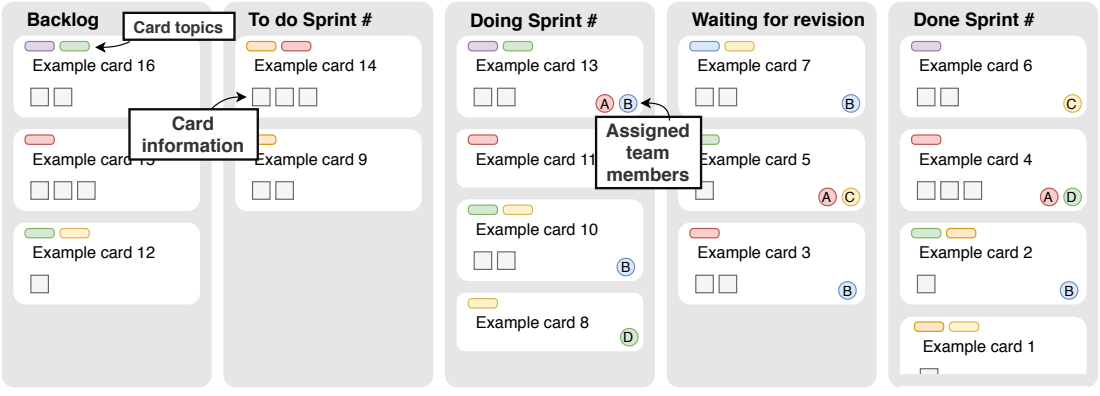
[picture p464: page 1]
Backlog; Example card 16; Example card 15; Example card 12; Example card 14; Example card 9; Doing Sprint #; Example card 13; Example card 11; Example card 10; Example card 7; Example card 5; Example card 3; Done Sprint #; Example card 6; Example card 4; Example card 2; Example card 8; A B Assigned team members; Card information; Example card 1; Card topics

To do Sprint #

Waiting for revision
