NicolaiFransen/SemesterProjectPED2/Simulations/2019_04_26_DriverAnalysis/Gate_drive_fixed_PWM_80V_newFa.asc

A1: inv
A2: inv
B1: bv; V = V(PWM_L)*VoltageLevel
B2: bv; V = V(PWMNot_L)*VoltageLevel
B3: bv; V = V(PWM_H)*VoltageLevel
B4: bv; V = V(PWMNot_H)*VoltageLevel
C1: cap; 10µ
C2: cap; 4.7µ
C3: cap; 100n
C4: cap; 4.7µ
C5: cap; 100n
C6: cap; 10µ
C7: cap; 4.7µ
C8: cap; 100n
C9: cap; 4.7µ
C10: cap; 100n
D9: zener; EDZV10B
D10: diode; 1N4148
D11: zener; EDZV10B
D12: diode; 1N4148
D13: diode; 1N4148
D14: zener; EDZV10B
D15: diode; 1N4148
D16: zener; EDZV10B
L6: ind; 40µ
L7: ind; 30n
L8: ind; 30n
L9: ind; 30n
L10: ind; 30n
M1: nmos; FDMS3615SQ2
M2: pmos; FDR840P
M3: nmos; FDMS3615SQ2
M4: pmos; FDR840P
M_H1: IPT012N08N5; dVth=0 dRdson=0 dgfs=0 dC=0 Zthtype=0 Ls={1.5n*{Lx}} Ld={1n*{Lx}} Lg={3n*{Lx}}
M_H2: IPT012N08N5; dVth={x} dRdson={x} dgfs=0 dC={x} Zthtype=0 Ls={1.5n*{Lx}} Ld={1n*{Lx}} Lg={3n*{Lx}}
M_L1: IPT012N08N5; dVth=0 dRdson=0 dgfs=0 dC=0 Zthtype=0 Ls={1.5n*{Lx}} Ld={1n*{Lx}} Lg={3n*{Lx}}
M_L2: IPT012N08N5; dVth={x} dRdson={x} dgfs=0 dC={x} Zthtype=0 Ls={1.5n*{Lx}} Ld={1n*{Lx}} Lg={3n*{Lx}}
R1: res; 10m
R2: res; 10m
R3: res; 10m
R4: res; 10m
R13: res; 0.55
R14: res; 1
R15: res; 0.55
R16: res; 1
R17: res; 100k
R18: res; 0.4
R19: res; 0.4
R20: res; 0.4
R21: res; 0.4
R22: res; 100k
R23: res; 100k
R24: res; 100k
R25: res; 1m
R26: res; 1m
R27: res; 1m
R28: res; 1m
R_BJT_H1: res; 1
R_BJT_L1: res; 1
R_Load1: res; 5m
RG_H3: res; {Rg}
RG_H4: res; {Rg}
RG_L3: res; {Rg}
RG_L4: res; {Rg}
S1: sw
S2: sw
U13: PHPT60415NY
U14: PHPT60415PY
U15: PHPT60415NY
U16: PHPT60415PY
V2: voltage; 15
V3: voltage; 36
V4: voltage; 15
V8: voltage; 18
V9: voltage; 8.7
V10: voltage; 8.7
V13: voltage; {V_Istart}
V14: signal; PULSE(-1 1 100n 100n 100n 10.1u)
V15: voltage; 0
V16: voltage; PULSE(0 1 {11u+t_onH+DT} 10n 10n {t_onL} {T})
V17: voltage; PULSE(0 1 11u 10n 10n {t_onH} {T})
V20: voltage; 50
Named nets: VH+, VH-, VL+, VL-, 0, PWM_L, PWMNot_L, out+L, out-L, driverL, PWM_H, PWMNot_H, out+H, out-H, driverH, phase, GH, G_H1, G_H2, GL, G_L1, G_L2, Tj_H2, Tj_H1, Tc_H2, Tc_H1, Tj_L1, Tc_L1, Tj_L2, Tc_L2, startup, T_board, supply
PWM Generation: Low Side
Driver Model
.param VoltageLevel=3
PWM Generation: High Side
Driver Model
.tran 0 100u 10.5u
.options cshunt=1e-14
.options gmin=1e-10
.options abstol=1e-10
.options reltol=0.0059
.model SW SW(Ron=.1u Roff=1Meg Vt=0 Vh=-.5)
.param Rg 27
.param Lx 1
M_H1
M_H2
M_L1
M_L2
Lx: Par. Inductance On: Lx = 1   Off: Lx = 1u
x:  Nom/Max parameter value. 0= Nom, 1=Max
Gate resistance
Mosfet model parameters:
Thermal
Phase supply
Phase load
Simulation options
Transient control
Startup: Load current ramp-up
I(L1) start       Vx
Ideal switch model
.param V_Istart -1400
.step param V_Istart list 1400 -1400
Startup: Vx determins I(L1)
+350A
0A
-355A
-1400V
18V
+1400V
.step param Rg list 10 1
Go to Control Panel > Save Defaults
Save subcircuit node voltages
.param duty=0.591 freq=20k T={1/freq} DT=1u t_onH={T*duty-DT} t_onL={T*{1-duty}-DT}
Frequency control  -  PWM
.param x 1
Capacitor bank high side
Capacitor bank low side
