NicolaiFransen/SemesterProjectPED2/Simulations/2019_04_26_DriverAnalysis/Draft1.asc

Q1: pnp
Q2: npn
R1: res; 100
Named nets: V+, V-, DriverOutput, Vgate
