NicolaiFransen/SemesterProjectPED2/Simulations/2019_04_26_DriverAnalysis/Gate_drive_fixed_PWM_80V.asc

A1: inv
A2: inv
B1: bv; V = V(PWM_L)*VoltageLevel
B2: bv; V = V(PWMNot_L)*VoltageLevel
B3: bv; V = V(PWM_H)*VoltageLevel
B4: bv; V = V(PWMNot_H)*VoltageLevel
C1: cap; 10µ
C2: cap; 4.7µ
C3: cap; 100n
C4: cap; 4.7µ
C5: cap; 100n
C6: cap; 10µ
C7: cap; 4.7µ
C8: cap; 100n
C9: cap; 4.7µ
C10: cap; 100n
C11: cap; {Cgs}
C12: cap; {Cgs}
C13: cap; {Cgs}
C14: cap; {Cgs}
D1: zener; EDZV10B
D2: diode; 1N4148
D3: zener; EDZV10B
D4: diode; 1N4148
D5: zener; EDZV10B
D6: diode; 1N4148
D7: zener; EDZV10B
D8: diode; 1N4148
D9: zener; UMZ20K
D10: zener; UMZ20K
D11: zener; UMZ20K
D12: zener; UMZ20K
D13: zener; UMZ20K
D14: zener; UMZ20K
D15: zener; UMZ20K
D16: zener; UMZ20K
D17: diode; 1N4148
D18: diode; 1N4148
L1: ind; 0.38m
L2: ind; 30n
L3: ind; 30n
L4: ind; 30n
L5: ind; 30n
M1: nmos; BUK9Y5960E
M2: pmos; FDC638P
M3: nmos; BUK9Y5960E
M4: pmos; FDC638P
R1: res; 100k
R2: res; 100k
R3: res; 100k
R4: res; 100k
R5: res; 10m
R6: res; 10m
R7: res; 10m
R8: res; 10m
R9: res; {RZenner}
R10: res; {RZenner}
R11: res; {RZenner}
R12: res; {RZenner}
R13: res; {RNMOS}
R14: res; {RPMOS}
R15: res; {RNMOS}
R16: res; {RPMOS}
R17: res; {Rzen2}
R18: res; {Rzen2}
R19: res; {Rzen2}
R20: res; {Rzen2}
R21: res; {Rzen3}
R22: res; {Rzen3}
R23: res; 1
R24: res; 1
R25: res; {Rcap}
R26: res; {Rcap}
R27: res; {Rcap}
R28: res; {Rcap}
R_BJT_H: res; {RPushPull}
R_BJT_L: res; {RPushPull}
R_Load: res; 2.5m
RG_H1: res; {Rg}
RG_H2: res; {Rg}
RG_L1: res; {Rg}
RG_L2: res; {Rg}
U1: PHPT60415NY
U2: PHPT60415PY
U3: IPT012N08N5_L1
U4: IPT012N08N5_L1
U5: PHPT60415NY
U6: PHPT60415PY
U7: IPT012N08N5_L1
U8: IPT012N08N5_L1
V1: voltage; {VDC}
V2: voltage; 15; Rser=1m
V3: voltage; PULSE(-8.7 15 11u 10n 10n {t_onH} {T})
V4: voltage; 15; Rser=1m
V5: voltage; {VoltageCorrection}
V6: voltage; PULSE(-8.7 15 {11u+t_onH+DT} 10n 10n {t_onL} {T})
V9: voltage; 8.7; Rser=1m
V10: voltage; 8.7; Rser=1m
V16: voltage; PULSE(0 1 {11u+t_onH+DT} 10n 10n {t_onL} {T})
V17: voltage; PULSE(0 1 11u 10n 10n {t_onH} {T})
Named nets: GH, G_H1, G_H2, GL, G_L1, G_L2, phase, 0, VH+, VH-, VL+, VL-, supply, PWM_L, PWMNot_L, out+L, out-L, driverL, PWM_H, PWMNot_H, out+H, out-H, driverH, VDDA, VDDB, VSSA, VSSB, driverL_, driverH_, DriverHControl, DriverLControl
.tran 0 100u 1u 1us
.options gmin=1e-10
.options cshunt=1e-15
.options reltol=0.003
.options abstol=1e-10
.param Rg = 2.7
.param RPushPull = 100
Gate resistances
Phase load
Simulation options, this parameters help the solver. Got from LTSpiceWIki
Transient control
.param duty=0.25 freq=20k T={1/freq} DT=1u t_onH={T*duty-DT} t_onL={T*{1-duty}-DT}
Frequency control  -  PWM. Dead Time = 1 us
.ic I(L1)=200
Capacitor bank high side
Capacitor bank low side
PWM Generation: Low Side
Driver Model
PWM Generation: High Side
Driver Model
Zenner and capacitor Protection Connection. For disabling protection, set resistance to a high value
.param RZenner = 20m
.param Rzen2 = 10MEG
.param Rzen3 = 10MEG
.param Rcap = 15m
.param Cgs = 2.2n
Driver Model - Original Spice
DC Voltage and voltage correction (calculated by voltage divider)
.param VDC = 36
.param VoltageCorrection = {VDC/3}
New Driver approach parameters
.param RPMOS = 2
.param RNMOS = 0.55
.param VoltageLevel=3
NOT USED
