NicolaiFransen/SemesterProjectPED2/Simulations/2019_04_26_DriverAnalysis/10pulse_two_GaNs_24012019_V2L2.asc

A1: inv
A2: inv
B1: bv; V=-V(x)*3.3
B2: bv; V=V(invX)*3.3
B3: bv; V=-V(Y)*3.3
B4: bv; V=V(invY)*3.3
B5: bv; V=V(Vdc)-V(V1)
B6: bv; V=V(V1)-V(V2)
B7: bv; V=V(V2)-V(V3)
B8: bv; V=V(V3)-V(V4)
B9: bv; V=V(V4)-V(Vs)
B10: bv; V=V(V2)-V(Vs)
C1: cap; 30µ
C2: cap; 30p
C3: cap; 330p
C4: cap; 10n
C5: cap; 330p
C6: cap; 1µ; V=25 Irms=0 Rser=0.007 Lser=0 mfg="TDK" pn="C3216X7RIE105M" type="X7R"
C8: cap; 1µ; V=25 Irms=0 Rser=0.007 Lser=0 mfg="TDK" pn="C3216X7RIE105M" type="X7R"
C11: cap; 100n
C12: cap; 100n
D1: schottky; PMEG2010EA
D3: zener; BZX84C10L
D4: zener; 1N751
D5: schottky; PMEG2010EA
D6: zener; BZX84C6V2L
D7: schottky; UPSC600
D8: zener; BZX84C10L
D9: zener; BZX84C6V2L
L1: ind; {Lind}; Ipk=35 Rser=2 Rpar=0 Cpar=0
L2: ind; {L1/2}
L3: ind; {Lt+L2/2}
L5: FerriteBead; 1n; Rser=15
L6: ind; {Lt}
L7: ind; {Lt+L1/2}
L8: ind; {L2/2}
L9: ind; {Lgl}
L10: ind; {Lksl}
L11: ind; {Lgh}
L12: ind; {Lksh}
M1: nmos; BSP135
M2: pmos; FDR840P
M3: nmos; FDMS3615SQ2
M4: pmos; FDR840P
M5: nmos; FDMS3615SQ2
R1: res; {Rg_on}; tol=1 pwr=0.1
R2: res; {Rs}
R3: res; {Rs}
R4: res; {Rg_off}; tol=1 pwr=0.1
R5: res; {Rs}
R6: res; {Rg_on}; tol=1 pwr=0.1
R7: res; 3m
R8: res; 1k
R9: res; 1k
R10: res; {Rs}
R11: res; {Rs}
R12: res; {Rs}
R13: res; {Rs}
R14: res; {Rs}
R15: res; {Rs}
R16: res; {Rs}
R17: res; 1k
R18: res; 1k
R19: res; 1k
R20: res; 1k
R21: res; 1k
R22: res; 10k
R23: res; {Rg_off}; tol=1 pwr=0.1
R24: res; 3.3
R25: res; 3.3
R26: res; 10k
R27: res; 10k
R28: res; 9.1k
R29: res; 1
R30: res; 10
R31: res; 1k
R32: res; 0
R33: res; 1k
R46: res; 2.5
R47: res; 1
R48: res; 1
R49: res; 2.5
U3: LTC6268
U4: LTC6268
U5: LT1259
U6: LTC6409
U8: LTC6409
U9: LTC6409
V1: voltage; PULSE(0 1 0 1n 1n {(1-D)*Ts-dt} {Ts} 10)
V2: voltage; {Vdc}; Rser=0.01
V3: voltage; 9; Rser=0.01
V4: voltage; 25
V5: voltage; 5
V6: voltage; 5
V7: voltage; 6; Rser=0.001
V8: voltage; 0; Rser=0.001
V11: voltage; PULSE(0 1 {(1-D)*Ts} 1n 1n {(D)*Ts-dt} {Ts} 10)
V12: voltage; 6; Rser=0.001
V13: voltage; 0; Rser=0.001
Named nets: 0, Vout, Vd, Vs, iout, Von, VCC, Von_meas, vs, Vdc, X, usl, ugl, lgl, lsl, ush, ugh, lgh, lsh, SSh, SSl, Y, invY, invX, Gh, Gl, -VCC, iout_2, Tj, Tc, Vlind, Vtu, Vpu, Vds, Vpl, Vds_para, V1, V2, V3, V4
.tran 150u
.lib c:\\MyCuccokShared\\OneDrive - Aalborg Universitet\\MyCuccok\\AAU\\Research\\Sempel\\LTSpice\\Cree Power C3D Packaged Spice Model Library.lib
.lib c:\\MyCuccokShared\\OneDrive - Aalborg Universitet\\MyCuccok\\AAU\\Research\\Sempel\\LTSpice\\Cree Power CPW2&CPW3 diode Bare Die SPICE Model Library.lib
.model BSP135 VDMOS(Vto=-1.2 Kp=0.16 Cgdmax=5.1p Cgdmin=1p Cgs=80p mfg=Infineon Vds=600 Ron=60 Qg=4.9n)
HSMS 2800
5.1V zener
.param Lp=10n
.param D=0.25
.param Fs=100000
.param Ts=1/Fs
.param dt=100n
.param Rg_on=10
.param Rg_off=1
.param L1=3.7n
.param L2=3.3n
.param Lt=2.5n
.param Lgh=3n
.param Lind=100u
.param Lksh=3n
.param Rs=0.1
.param Lgl=3n
.param Lksl=3n 
.param Cdu=80p
.param Csl=80p
.param Cmid=166p
.param Vdc 31.5
