NicolaiFransen/SemesterProjectPED2/Simulations/2019_04_26_DriverAnalysis/mosfet-push-pull.asc

M1: nmos; AO6408
M2: pmos; AO6407
R1: res; 1
R2: res; 100
R3: res; 100
U1: PHPT60415NY
U2: PHPT60415PY
V1: voltage; PULSE({Vneg} {Vpos} 0 500n 100n 10u 15u)
V2: voltage; {Vpos}
V3: voltage; {Vneg}
Named nets: 0, V+, V-, Vin, Vo
.param Vneg 8.7
.param Vpos 15
.tran 0 100u 0 1u
MOSFET pushpull is apparently quite more difficult than BJT pushpull and some biasing support circuits are necessary
