NicolaiFransen/SemesterProjectPED2/Simulations/2019_04_26_DriverAnalysis/Gate_drive_fixed_PWM_80V_DriverIc.asc

C1: cap; 33p
C2: cap; 2.2n
D1: zener; EDZV10B
D2: diode; 1N4148
D3: zener; EDZV10B
D4: diode; 1N4148
D5: zener; EDZV10B
D6: diode; 1N4148
D7: zener; EDZV10B
D8: diode; 1N4148
E1: e; 1
L1: ind; 380µ
L2: ind; 30n
L3: ind; 30n
L4: ind; 30n
L5: ind; 30n
R1: res; 100k
R2: res; 100k
R3: res; 100k
R4: res; 100k
R5: res; 0.4
R6: res; 0.4
R7: res; 0.4
R8: res; 0.4
R9: res; 1m
R10: res; 1m
R11: res; 1m
R12: res; 1m
R13: res; 47
R14: res; 100k
R_BJT_H: res; 1
R_BJT_L: res; 1
R_Load: res; 2.6m
RG_H1: res; {Rg}
RG_H2: res; {Rg}
RG_L1: res; {Rg}
RG_L2: res; {Rg}
S1: sw
S2: sw
U1: PHPT60415NY
U2: PHPT60415PY
U3: IPT012N08N5_L1
U4: IPT012N08N5_L1
U5: PHPT60415NY
U6: PHPT60415PY
U7: IPT012N08N5_L1
U8: IPT012N08N5_L1
U9: UCC20225_TRANS
U10: PHPT60415NY
V1: voltage; 36
V2: voltage; 15
V3: voltage; PULSE({-Vneg} 15 11u 10n 10n {t_onH} {T})
V5: voltage; 18
V6: voltage; {Vneg}
V7: voltage; 15
V8: voltage; {V_Istart}
V9: voltage; 50
V11: signal; PULSE(-1 1 100n 100n 100n 10.1u)
V12: voltage; 0
V13: voltage; {Vneg}
V14: voltage; 15
Named nets: GH, G_H1, G_H2, 0, GL, G_L1, G_L2, phase, VH+, VH-, VL+, VL-, startup, T_board, Tc_H1, Tc_H2, Tc_L1, Tc_L2, supply, PWM_H, DriverH, DriverL, COM
.tran 0 110u 1us
.options cshunt=1e-14
.options gmin=1e-10
.options abstol=1e-10
.options reltol=0.0059
.model SW SW(Ron=.1u Roff=1Meg Vt=0 Vh=-.5)
.param Rg 2.7
.param Lx 1
M_H1
M_H2
M_L1
M_L2
Lx: Par. Inductance On: Lx = 1   Off: Lx = 1u
x:  Nom/Max parameter value. 0= Nom, 1=Max
Gate resistance
Mosfet model parameters:
Thermal
Gate driver supply
Phase supply
Phase load
Simulation options
Transient control
Startup: Load current ramp-up
I(L1) start       Vx
Ideal switch model
.param V_Istart -1400
.step param V_Istart list 1400 -1400
Startup: Vx determins I(L1)
+350A
0A
-355A
-1400V
18V
+1400V
.step param Rg list 10 1
Go to Control Panel > Save Defaults
Save subcircuit node voltages
.param duty=0.591 freq=20k T={1/freq} DT=1u t_onH={T*duty-DT} t_onL={T*{1-duty}-DT}
Frequency control  -  PWM
.param Vneg 8.7
.param x 1
.ic I(L1)=100
