NicolaiFransen/SemesterProjectPED2/Simulations/2019_04_26_DriverAnalysis/Dc Chopper with inverting signal.asc

C1: cap; 0.5µ
D1: diode
D2: diode
E1: e; 1
M1: nmos; Si4866DY
R1: res; 3k
R2: res; 430k
R3: res; 39k
R4: res; 5.1k
R5: res; 30k
R6: res; 15k
R7: res; 4; pwr=500
R8: res; 5k
U2: OPA197
V1: voltage; PULSE(1 65 0 50m 50m 0 0 2)
V2: voltage; 15
V3: voltage; 0
Named nets: +Vcc, -Vcc, Uin, OpOut, 0, Vref
.tran 0 200m 0 1 startup
.option cshunt 1e-15
