NicolaiFransen/SemesterProjectPED2/Simulations/2019_04_26_DriverAnalysis/Gate_drive_Double_pulse_80V.asc

D1: zener; EDZV10B
D2: diode; 1N4148
D3: zener; EDZV10B
D4: diode; 1N4148
D5: zener; BZX84C10L
D6: diode; 1N4148
D7: zener; EDZV10B
D8: diode; 1N4148
E1: e; 1
E2: e; 1
L1: ind; 244µ
L2: ind; 30n
L3: ind; 30n
L4: ind; 30n
L5: ind; 30n
M_H1: IPT012N08N5; dVth=0 dRdson=0 dgfs=0 dC=0 Zthtype=0 Ls={1.5n*{Lx}} Ld={1n*{Lx}} Lg={3n*{Lx}}
M_H2: IPT012N08N5; dVth=0.2 dRdson=1 dgfs=0 dC=1 Zthtype=0 Ls={1.5n*{Lx}} Ld={1n*{Lx}} Lg={3n*{Lx}}
M_L1: IPT012N08N5; dVth=0 dRdson=0 dgfs=0 dC=0 Zthtype=0 Ls={1.5n*{Lx}} Ld={1n*{Lx}} Lg={3n*{Lx}}
M_L2: IPT012N08N5; dVth=1 dRdson=1 dgfs=0 dC=1 Zthtype=0 Ls={1.5n*{Lx}} Ld={1n*{Lx}} Lg={3n*{Lx}}
R1: res; 100k
R2: res; 100k
R3: res; 100k
R4: res; 100k
R5: res; 0.4
R6: res; 0.4
R7: res; 0.4
R8: res; 0.4
R9: res; 1m
R10: res; 1m
R11: res; 1m
R12: res; 1m
R_BJT_H: res; 1
R_BJT_L: res; 1
R_Load: res; 5m
RG_H1: res; {Rg}
RG_H2: res; {Rg}
RG_L1: res; {Rg}
RG_L2: res; {Rg}
U1: PHPT60415NY
U2: PHPT60415PY
U5: PHPT60415NY
U6: PHPT60415PY
V1: voltage; 36
V3: voltage; PWL REPEAT FOREVER(0u -8.7 100u -8.7 100.02u 15 650.02u 15 650.04u -8.7 690.04u -8.7 690.06u 15 730.06u 15 730.08u -8.7 1000u -8.7) ENDREPEAT
V4: voltage; PWL REPEAT FOREVER(0u 15 99u 15 99.02u -8.7 651.02u -8.7 651.04u 15 689.04u 15 689.06u -8.7 731.06u -8.7 731.08u -8.7 1001u -8.7) ENDREPEAT
V5: voltage; 0
V6: voltage; {Vneg}
V7: voltage; 15
V9: voltage; 50
V13: voltage; {Vneg}
V14: voltage; 15
Named nets: GH, G_H1, G_H2, 0, GL, G_L1, G_L2, phase, Tj_H2, Tj_H1, Tc_H2, Tc_H1, Tj_L1, Tc_L1, Tj_L2, Tc_L2, VH+, VH-, VL+, VL-, T_board, supply, PWM_H, PWM_L
.tran 0 1m 0 1u
.options cshunt=1e-14
.options gmin=1e-10
.options abstol=1e-10
.options reltol=0.004
.model SW SW(Ron=.1u Roff=1Meg Vt=0 Vh=-.5)
.param Rg 2.7
.param Lx 1
M_H1
M_H2
M_L1
M_L2
Par. Inductance On: Lx = 1   Off: Lx = 1u
Gate resistance
Mosfet model parameters:
Thermal
Gate driver supply
Phase supply
Phase load
Simulation options
Transient control
Ideal switch model
.step param Rg list 10 1
Go to Control Panel > Save Defaults
Save subcircuit node voltages
.param Vneg 8.7
