NicolaiFransen/SemesterProjectPED2/(list of files, drawings)

Other design files:
Interface board/2019_02_25_PCB/DSP.SchDoc
Interface board/2019_02_25_PCB/Inputs.SchDoc
Interface board/2019_02_25_PCB/InputsExtras.SchDoc
Interface board/2019_02_25_PCB/InterfacePCB.PrjPcb
Interface board/2019_02_25_PCB/Outputs.SchDoc
Interface board/2019_02_25_PCB/SignalProcessing.SchDoc
Interface board/2019_02_25_PCB/Supplies.SchDoc
Interface board/2019_02_25_PCB/V2_PCB.PcbDoc
Simulations/2018_Semester Project/Appendix/Datasheets/Controllers/DockingStation_ HSEC_120or180pin/R4_1/{TXN003}_controlCARDDockingStationR4_1_PADS.pcb
Simulations/2018_Semester Project/Appendix/Datasheets/Controllers/TMDSCNCD28075/R1_1/F2807x_120controlCARD_R1_1_PCB_PADS.pcb
