NicolaiFransen/SemesterProjectPED2/Simulations/2018_Semester Project/Appendix/Datasheets/Heatsink/fan/fan.kicad_pcb

## KiCad design Simulations/2018_Semester Project/Appendix/Datasheets/Heatsink/fan/fan.kicad_pcb (2019-02-12)

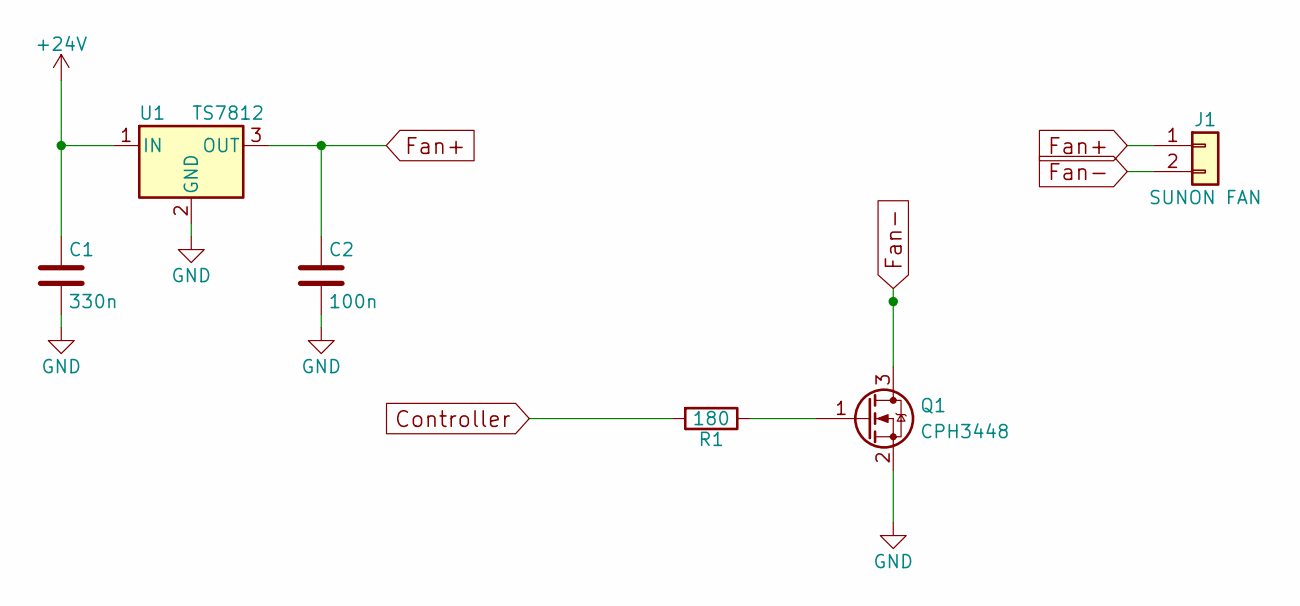
[picture p465: schematic fan.sch]

Parts:
C1: 330n; C_1206
C2: 100n; C_1206
J1: SUNON FAN; Molex_KK-6410-02_02x2.54mm_Straight
Q1: CPH3448; SOT-23
R1: 180; R_1206
U1: TS7812; TO-220-3_Horizontal

Connections:
+24V: C1.1, U1.1 (IN)
Controller: R1.2
Fan+: C2.1, J1.1, U1.3 (OUT)
Fan-: J1.2, Q1.3 (D)
GND: C1.2, C2.2, Q1.2 (S), U1.2 (GND)
unnamed: Q1.1 (G), R1.1

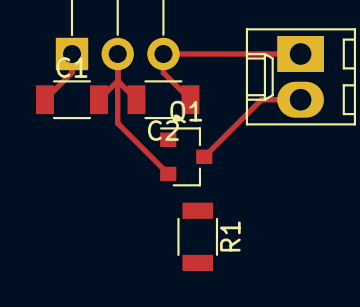
[picture p466: board fan.kicad_pcb from above]

Board: 2 copper layers, 6 parts (0 on the bottom side), 5 nets.
