NicolaiFransen/SemesterProjectPED2/Simulations/2018_Semester Project/Appendix/KiCad/current_meas/current_meas.kicad_pcb

## KiCad design Simulations/2018_Semester Project/Appendix/KiCad/current_meas/current_meas.kicad_pcb (2019-02-12)

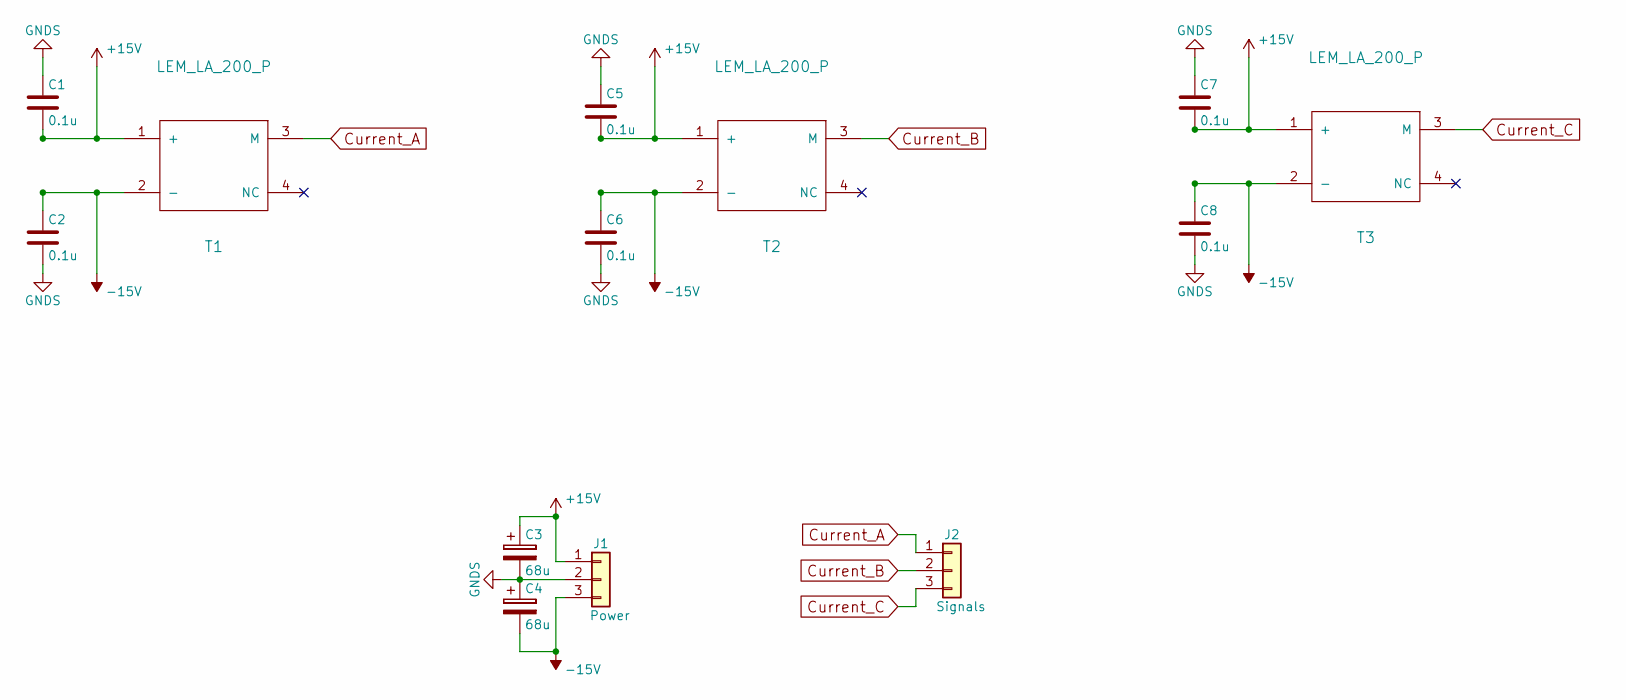
[picture p467: schematic current_meas.sch, Current measurement board]

Parts:
C1, C2, C5, C6, C7, C8: 0.1u; C_1206_HandSoldering
C3, C4: 68u; CP_Radial_D6.3mm_P2.50mm
J1: Power; Molex_KK-6410-03_03x2.54mm_Straight
J2: Signals; Molex_KK-6410-03_03x2.54mm_Straight
T1, T2, T3: LEM_LA_200_P; LEM_200

Connections:
+15V: C1.2, C3.1, C5.2, C7.2, J1.1, T1.1 (+), T2.1 (+), T3.1 (+)
-15V: C2.1, C4.2, C6.1, C8.1, J1.3, T1.2 (-), T2.2 (-), T3.2 (-)
Current_A: J2.1, T1.3 (M)
Current_B: J2.2, T2.3 (M)
Current_C: J2.3, T3.3 (M)
GNDS: C1.1, C2.2, C3.2, C4.1, C5.1, C6.2, C7.1, C8.2, J1.2

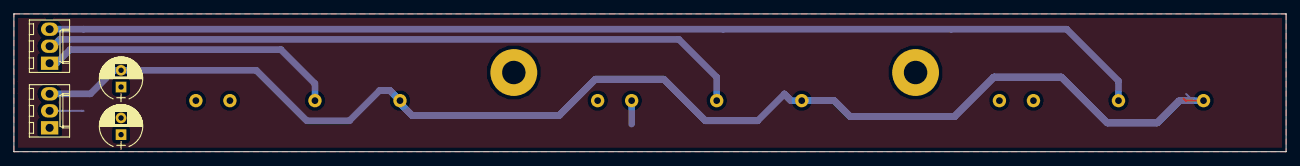
[picture p468: board current_meas.kicad_pcb from above]

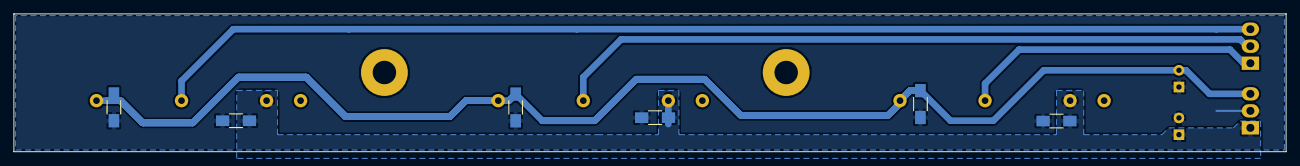
[picture p469: board current_meas.kicad_pcb from below]

Board: 2 copper layers, 190.0 x 20.6 mm, 13 parts (6 on the bottom side), 6 nets.
