NicolaiFransen/SemesterProjectPED2/Simulations/2018_Semester Project/Appendix/KiCad/Interface/interface.kicad_pcb

## KiCad design Simulations/2018_Semester Project/Appendix/KiCad/Interface/interface.kicad_pcb (2019-02-12)

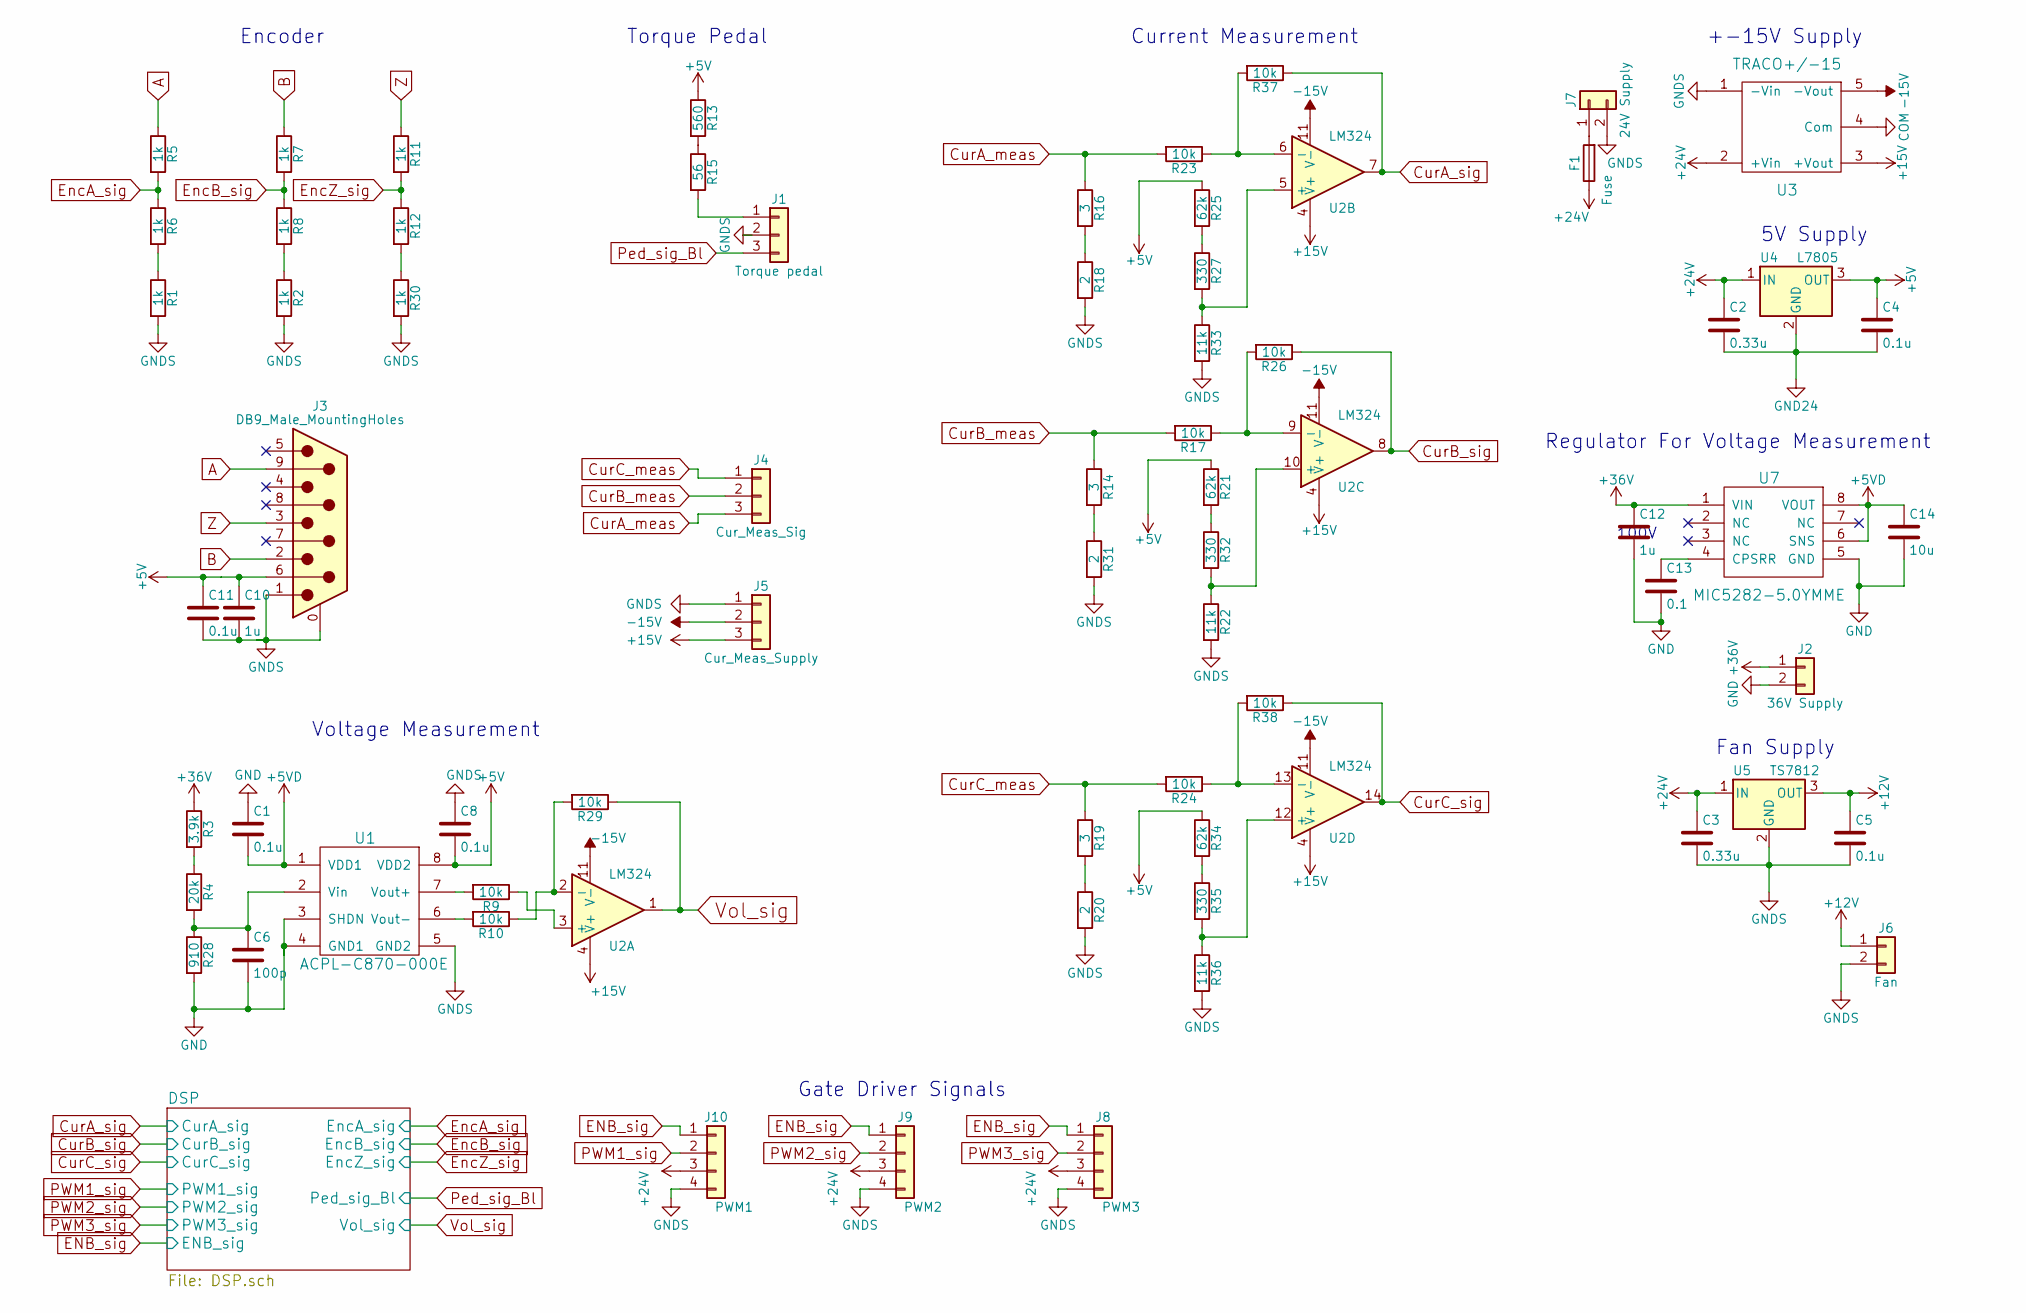
[picture p470: schematic interface.sch, Interface board]

Parts:
C1, C4, C5, C8, C11: 0.1u; C_1206
C2, C3: 0.33u; C_1206
C6: 100p; C_1206
C10, C12: 1u; C_1206
C13: 0.1; C_1206
C14: 10u; C_1206
F1: Fuse; Fuseholder5x20_horiz_open_Schurter_0031_8201
J1: Torque pedal; Molex_KK-6410-03_03x2.54mm_Straight
J2: 36V Supply; Molex_KK-6410-02_02x2.54mm_Straight
J3: DB9_Male_MountingHoles; DMR-09-P
J4: Cur_Meas_Sig; Molex_KK-6410-03_03x2.54mm_Straight
J5: Cur_Meas_Supply; Molex_KK-6410-03_03x2.54mm_Straight
J6: Fan; Molex_KK-6410-02_02x2.54mm_Straight
J7: 24V Supply; Molex_KK-6410-02_02x2.54mm_Straight
J8: PWM3; Molex_KK-6410-04_04x2.54mm_Straight
J9: PWM2; Molex_KK-6410-04_04x2.54mm_Straight
J10: PWM1; Molex_KK-6410-04_04x2.54mm_Straight
R1, R2, R5, R6, R7, R8, R11, R12, R30: 1k; R_1206
R3: 3.9k; R_1206
R4: 20k; R_1206
R9, R10, R17, R23, R24, R26, R29, R37, R38: 10k; R_1206
R13: 560; R_1206
R14, R16, R19: 3; R_1206
R15: 56; R_1206
R18, R20, R31: 2; R_1206
R21, R25, R34: 62k; R_1206
R22, R33, R36: 11k; R_1206
R27, R32, R35: 330; R_1206
R28: 910; R_1206
U1: ACPL-C870-000E
U2: LM324; SOIC-14_3.9x8.7mm_Pitch1.27mm
U3: TRACO+/-15; DCDC-Conv_TRACO_TEN10-XXXX_Dual
U4: L7805; TO-220-3_Horizontal
U5: TS7812; TO-220-3_Horizontal
U7: MIC5282-5.0YMME; 8-Pin(ePad)MSOP

Connections:
+5V: C4.1, C8.2, C10.1, C11.1, J3.6, R13.1, R21.1, R25.1, R34.1, U1.8 (VDD2), U4.3 (OUT); also elsewhere on the board
+5VD: C1.2, C14.1, U1.1 (VDD1), U7.6 (SNS), U7.8 (VOUT)
+12V: C5.1, J6.1, U5.3 (OUT)
+15V: J5.3, U2.4 (V+), U3.3 (+Vout)
+24V: C2.1, C3.1, F1.1, J8.3, J9.3, J10.3, U3.2 (+Vin), U4.1 (IN), U5.1 (IN)
+36V: C12.1, J2.1, R3.1, U7.1 (VIN)
-15V: J5.2, U2.11 (V-), U3.5 (-Vout)
A: J3.9, R5.1
B: J3.2, R7.1
CurA_meas: J4.3, R16.1, R23.2
CurA_sig: R37.1, U2.7; also elsewhere on the board
CurB_meas: J4.2, R14.1, R17.2
CurB_sig: R26.1, U2.8; also elsewhere on the board
CurC_meas: J4.1, R19.1, R24.2
CurC_sig: R38.1, U2.14; also elsewhere on the board
ENB_sig: J8.1, J9.1, J10.1; also elsewhere on the board
EncA_sig: R5.2, R6.1; also elsewhere on the board
EncB_sig: R7.2, R8.1; also elsewhere on the board
EncZ_sig: R11.2, R12.1; also elsewhere on the board
GND: C1.1, C6.2, C12.2, C13.2, C14.2, J2.2, R28.2, U1.3 (SHDN), U1.4 (GND1), U7.5 (GND)
unnamed: C6.1, R4.2, R28.1, U1.2 (Vin)
unnamed: C13.1, U7.4 (CPSRR)
unnamed: F1.2, J7.1
unnamed: J1.1, R15.2
unnamed: R1.1, R6.2
unnamed: R2.1, R8.2
unnamed: R3.2, R4.1
unnamed: R9.1, U2.3 (+)
unnamed: R9.2, U1.7 (Vout+)
unnamed: R10.1, R29.2, U2.2 (-)
unnamed: R10.2, U1.6 (Vout-)
unnamed: R12.2, R30.1
unnamed: R13.2, R15.1
unnamed: R14.2, R31.1
unnamed: R16.2, R18.1
unnamed: R17.1, R26.2, U2.9 (-)
unnamed: R19.2, R20.1
unnamed: R21.2, R32.1
unnamed: R22.1, R32.2, U2.10 (+)
unnamed: R23.1, R37.2, U2.6 (-)
unnamed: R24.1, R38.2, U2.13 (-)
unnamed: R25.2, R27.1
unnamed: R27.2, R33.1, U2.5 (+)
unnamed: R34.2, R35.1
unnamed: R35.2, R36.1, U2.12 (+)
PWM1_sig: J10.2; also elsewhere on the board
PWM2_sig: J9.2; also elsewhere on the board
PWM3_sig: J8.2; also elsewhere on the board
Ped_sig_Bl: J1.3; also elsewhere on the board
Vol_sig: R29.1, U2.1; also elsewhere on the board
Z: J3.3, R11.1

Notes on the sheet:
Torque Pedal
Encoder
Voltage Measurement
Fan Supply
100V
Regulator For Voltage Measurement
Gate Driver Signals
5V Supply
Current Measurement
+-15V Supply

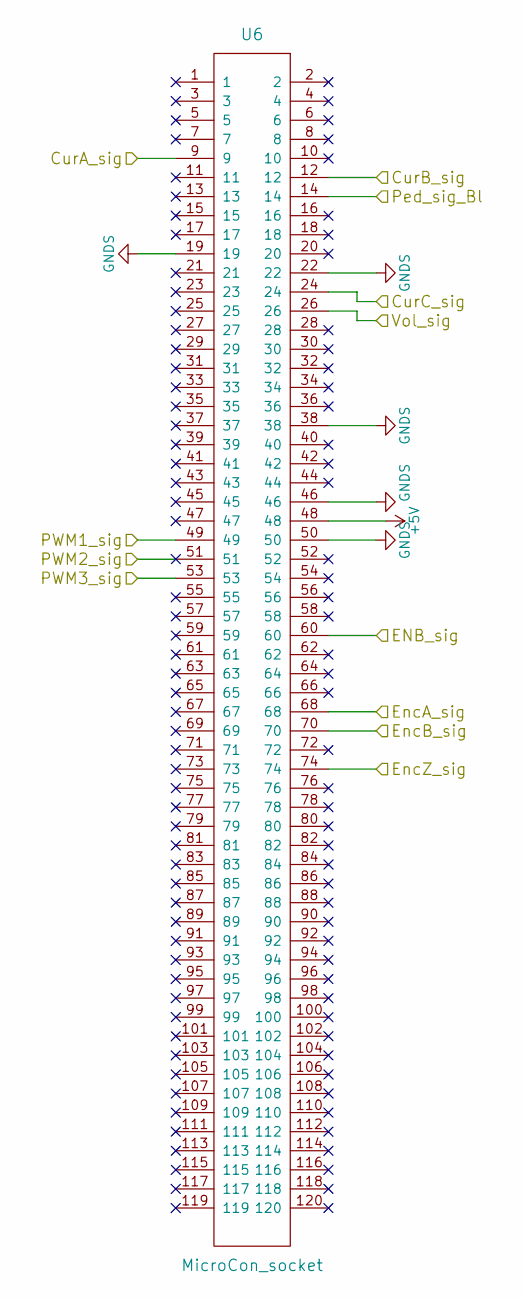
[picture p471: schematic DSP.sch, Interface board]

Parts:
U6: MicroCon_socket; HSEC8-160-01-L-DV-A

Connections:
+5V: U6.48; also elsewhere on the board
CurA_sig: U6.9; also elsewhere on the board
CurB_sig: U6.12; also elsewhere on the board
CurC_sig: U6.24; also elsewhere on the board
ENB_sig: U6.60; also elsewhere on the board
EncA_sig: U6.68; also elsewhere on the board
EncB_sig: U6.70; also elsewhere on the board
EncZ_sig: U6.74; also elsewhere on the board
PWM1_sig: U6.49; also elsewhere on the board
PWM2_sig: U6.51; also elsewhere on the board
PWM3_sig: U6.53; also elsewhere on the board
Ped_sig_Bl: U6.14; also elsewhere on the board
Vol_sig: U6.26; also elsewhere on the board

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
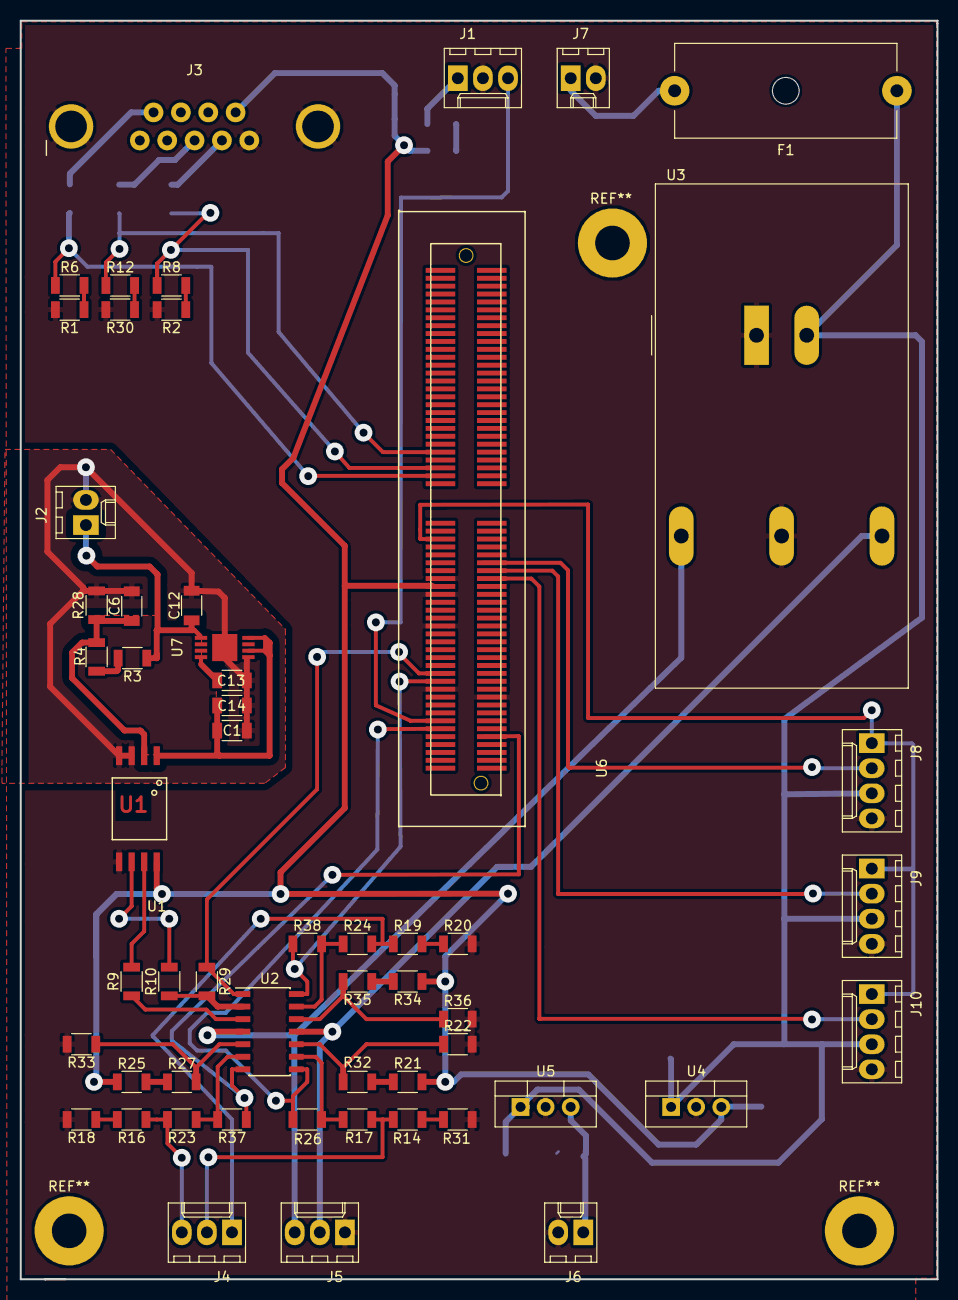
[picture p472: board interface.kicad_pcb from above]

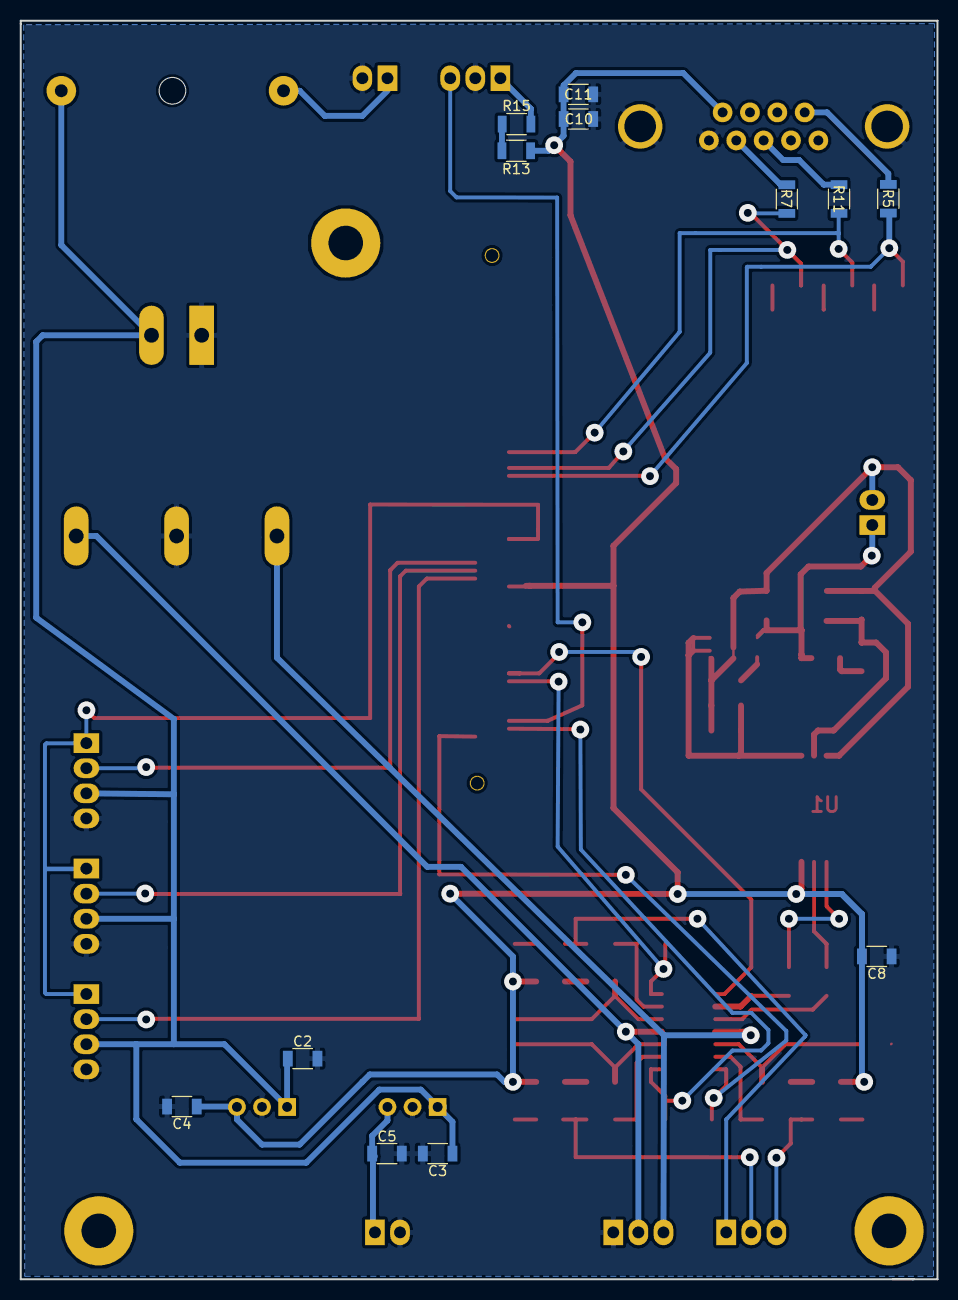
[picture p473: board interface.kicad_pcb from below]

Board: 2 copper layers, 92.8 x 127.4 mm, 68 parts (12 on the bottom side), 52 nets.
