NicolaiFransen/SemesterProjectPED2/Simulations/2018_Semester Project/Appendix/KiCad/Inverter/Inverter.kicad_pcb

## KiCad design Simulations/2018_Semester Project/Appendix/KiCad/Inverter/Inverter.kicad_pcb (2019-02-12)

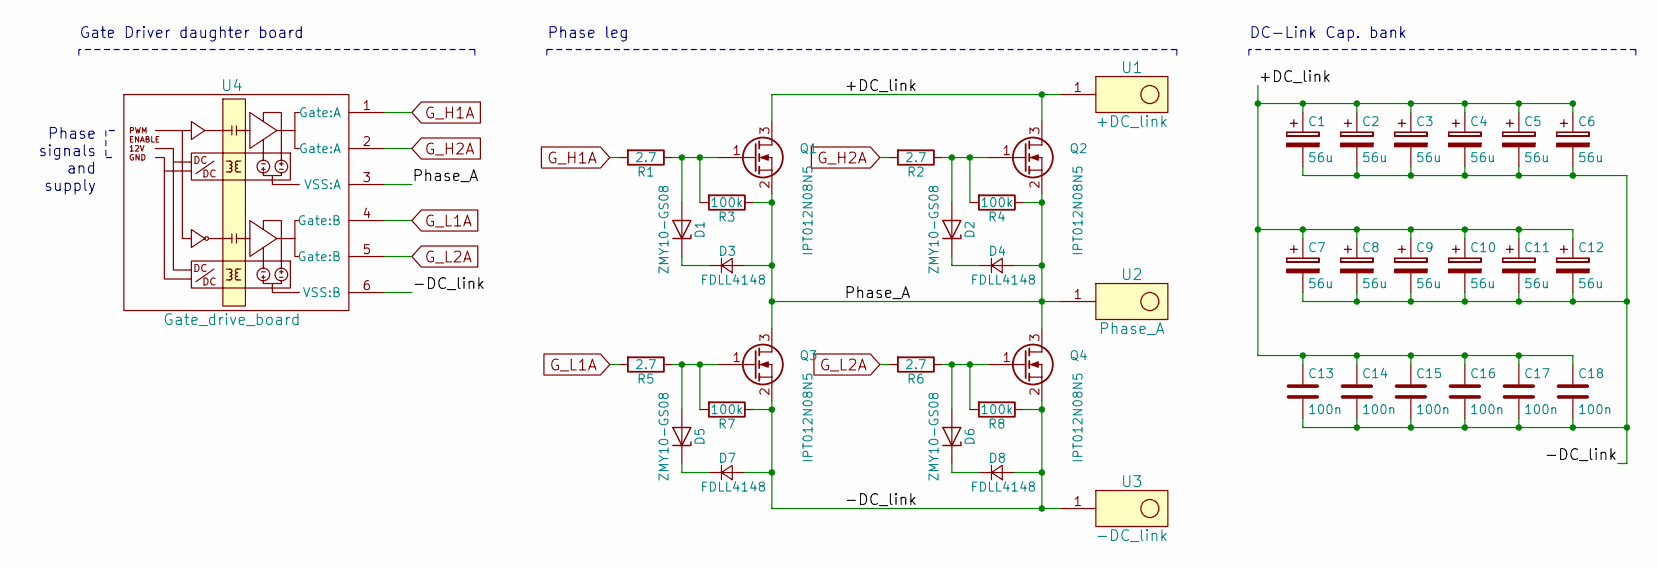
[picture p474: schematic Inverter.sch, Modular Inverter Phase]

Parts:
C1, C2, C3, C4, C5, C6, C7, C8, C9, C10, C11, C12: 56u; CP_Elec_10x10.5
C13, C14, C15, C16, C17, C18: 100n; C_1206
D1, D2, D5, D6: ZMY10-GS08; D_MELF
D3, D4, D7, D8: FDLL4148; D_MiniMELF
Q1, Q2, Q3, Q4: IPT012N08N5; Infineon_PG-HSOF-8-1
R1, R2, R5, R6: 2.7; R_1206
R3, R4, R7, R8: 100k; R_1206
U1: +DC_link; cu_bar_long
U2: Phase_A; cu_bar
U3: -DC_link; cu_bar_long
U4: Gate_drive_board; Gate_driver_example

Connections:
/+DC_link: C1.1, C2.1, C3.1, C4.1, C5.1, C6.1, C7.1, C8.1, C9.1, C10.1, C11.1, C12.1, C13.1, C14.1, C15.1, C16.1, C17.1, C18.1, Q1.3 (D), Q2.3 (D), U1.1
/-DC_link: C1.2, C2.2, C3.2, C4.2, C5.2, C6.2, C7.2, C8.2, C9.2, C10.2, C11.2, C12.2, C13.2, C14.2, C15.2, C16.2, C17.2, C18.2, D7.2 (A), D8.2 (A), Q3.2 (S), Q4.2 (S), R7.1, R8.1, U3.1, U4.6 (VSS:B)
/Phase_A: D3.2 (A), D4.2 (A), Q1.2 (S), Q2.2 (S), Q3.3 (D), Q4.3 (D), R3.1, R4.1, U2.1, U4.3 (VSS:A)
G_H1A: R1.2, U4.1 (Gate:A)
G_H2A: R2.2, U4.2 (Gate:A)
G_L1A: R5.2, U4.4 (Gate:B)
G_L2A: R6.2, U4.5 (Gate:B)
unnamed: D1.1 (K), D3.1 (K)
unnamed: D1.2 (A), Q1.1 (G), R1.1, R3.2
unnamed: D2.1 (K), D4.1 (K)
unnamed: D2.2 (A), Q2.1 (G), R2.1, R4.2
unnamed: D5.1 (K), D7.1 (K)
unnamed: D5.2 (A), Q3.1 (G), R5.1, R7.2
unnamed: D6.1 (K), D8.1 (K)
unnamed: D6.2 (A), Q4.1 (G), R6.1, R8.2

Notes on the sheet:
Phase leg
Phase signals and supply
DC-Link Cap. bank
Gate Driver daughter board

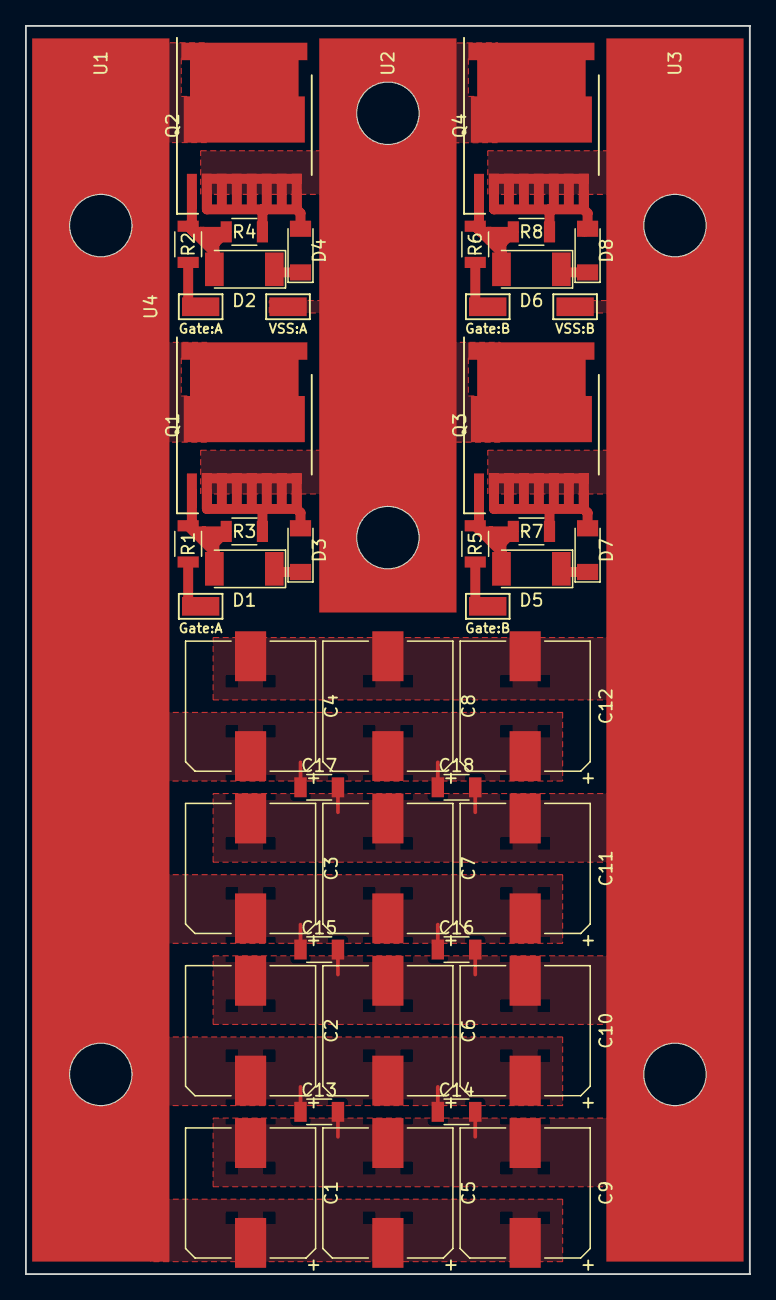
[picture p475: board Inverter.kicad_pcb from above]

Board: 2 copper layers, 58.0 x 100.0 mm, 42 parts (0 on the bottom side), 15 nets.
