NicolaiFransen/SemesterProjectPED2/Simulations/2018_Semester Project/Appendix/KiCad/Dc_Chopper/Ucenje.kicad_pcb

## KiCad design Simulations/2018_Semester Project/Appendix/KiCad/Dc_Chopper/Ucenje.kicad_pcb (2019-02-12)

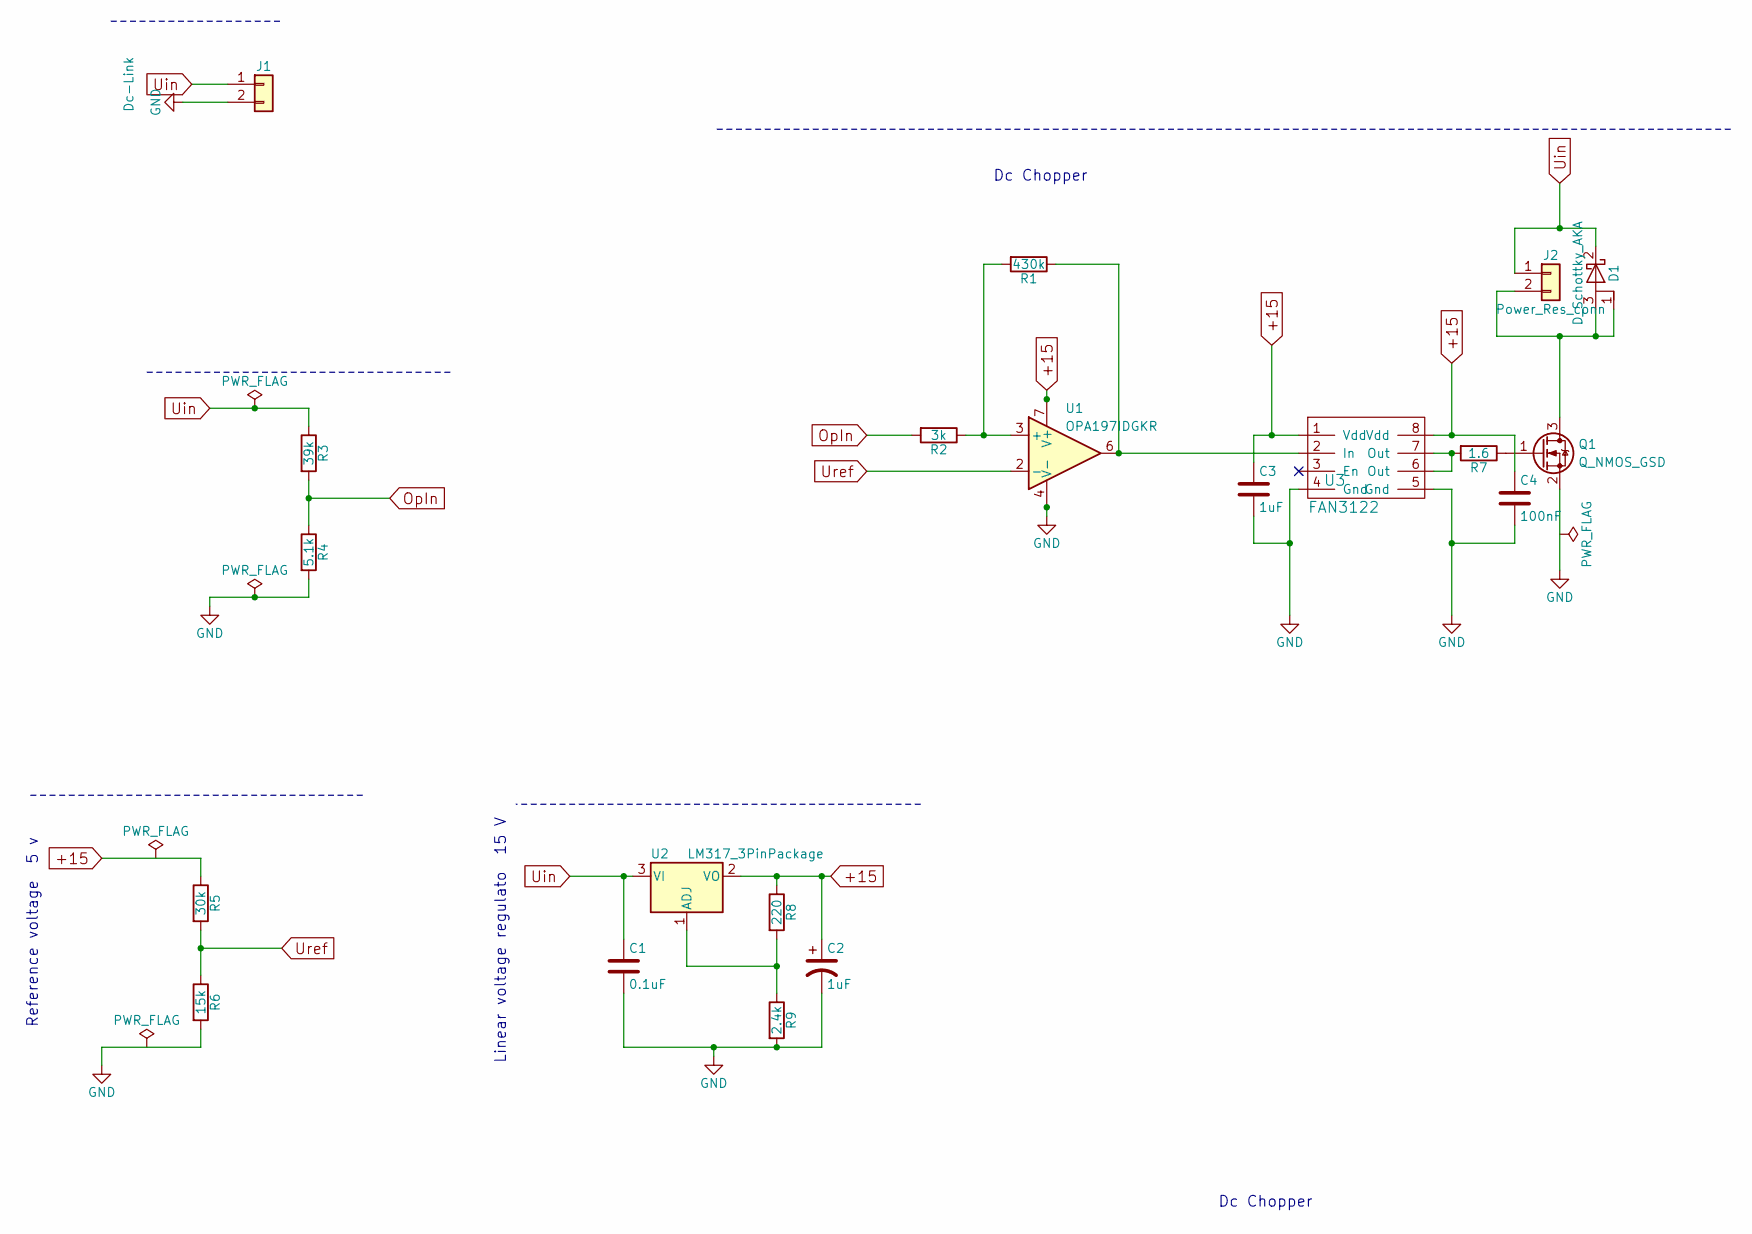
[picture p476: schematic Ucenje.sch]

Parts:
C1: 0.1uF; C_1210
C2: 1uF; C_1210
C3: 1uF; C_1206
C4: 100nF; C_1206
D1: D_Schottky_AKA; TO-220-3_Vertical
J1: Dc-Link; WireConnection_2.50mmDrill
J2: Power_Res_conn; WireConnection_2.50mmDrill
Q1: Q_NMOS_GSD; Infineon_PG-HSOF-8-1
R1: 430k; R_1206
R2: 3k; R_1206
R3: 39k; R_1206
R4: 5.1k; R_1206
R5: 30k; R_1206
R6: 15k; R_1206
R7: 1.6; R_1206
R8: 220; R_1206
R9: 2.4k; R_1206
U1: OPA197IDGKR; VSSOP-8_3.0x3.0mm_Pitch0.65mm
U2: LM317_3PinPackage; TO-220-3_Vertical
U3: FAN3122; SOIC-8_3.9x4.9mm_Pitch1.27mm

Connections:
+15: C2.1, C3.1, C4.1, R5.1, R8.1, U1.7 (V+), U2.2 (VO), U3.1 (Vdd), U3.8 (Vdd)
GND: C1.2, C2.2, C3.2, C4.2, J1.2, Q1.2 (S), R4.2, R6.2, R9.2, U1.4 (V-), U3.4 (Gnd), U3.5 (Gnd)
unnamed: D1.1 (A), D1.3 (A), J2.2, Q1.3 (D)
unnamed: Q1.1 (G), R7.1
unnamed: R1.1, U1.6, U3.2 (In)
unnamed: R1.2, R2.1, U1.3 (+)
unnamed: R7.2, U3.6 (Out), U3.7 (Out)
unnamed: R8.2, R9.1, U2.1 (ADJ)
OpIn: R2.2, R3.2, R4.1
Uin: C1.1, D1.2 (K), J1.1, J2.1, R3.1, U2.3 (VI)
Uref: R5.2, R6.1, U1.2 (-)

Notes on the sheet:
Dc Chopper
Linear voltage regulato 15 V
Reference voltage 5 v
Dc Chopper

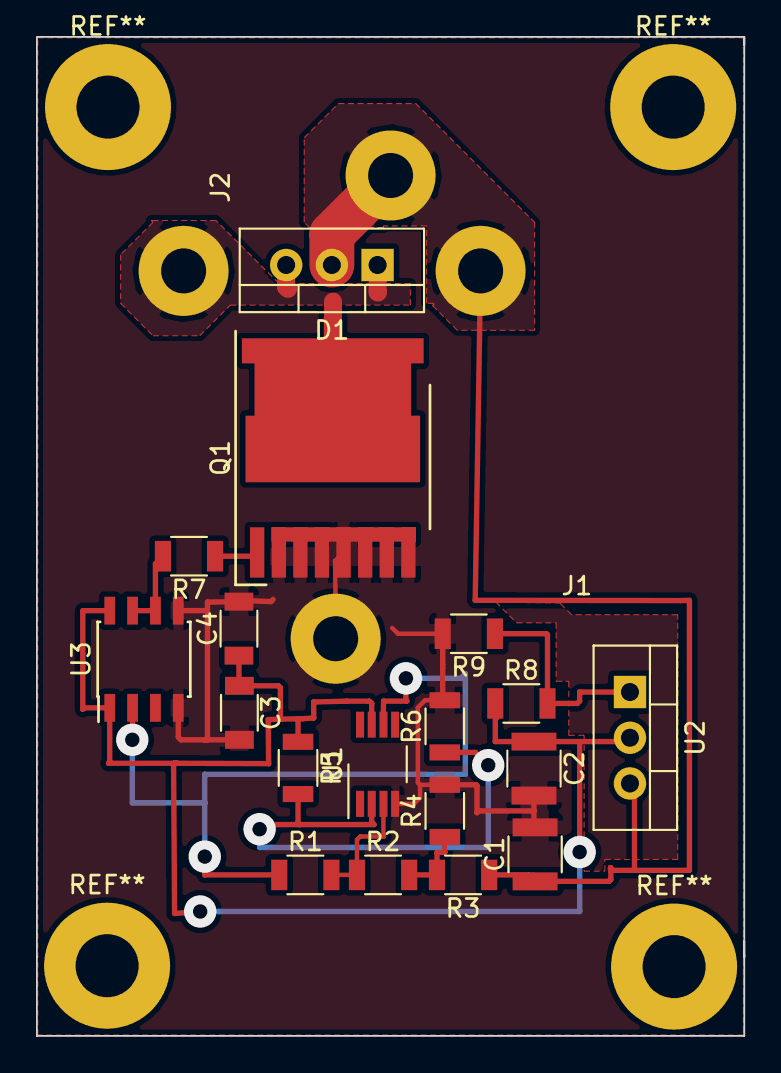
[picture p477: board Ucenje.kicad_pcb from above]

Board: 2 copper layers, 39.3 x 55.5 mm, 20 parts (0 on the bottom side), 11 nets.
