NicolaiFransen/SemesterProjectPED2/Driver/PCB/Gate_drive.kicad_pcb

## KiCad design Driver/PCB/Gate_drive.kicad_pcb (2019-05-03)

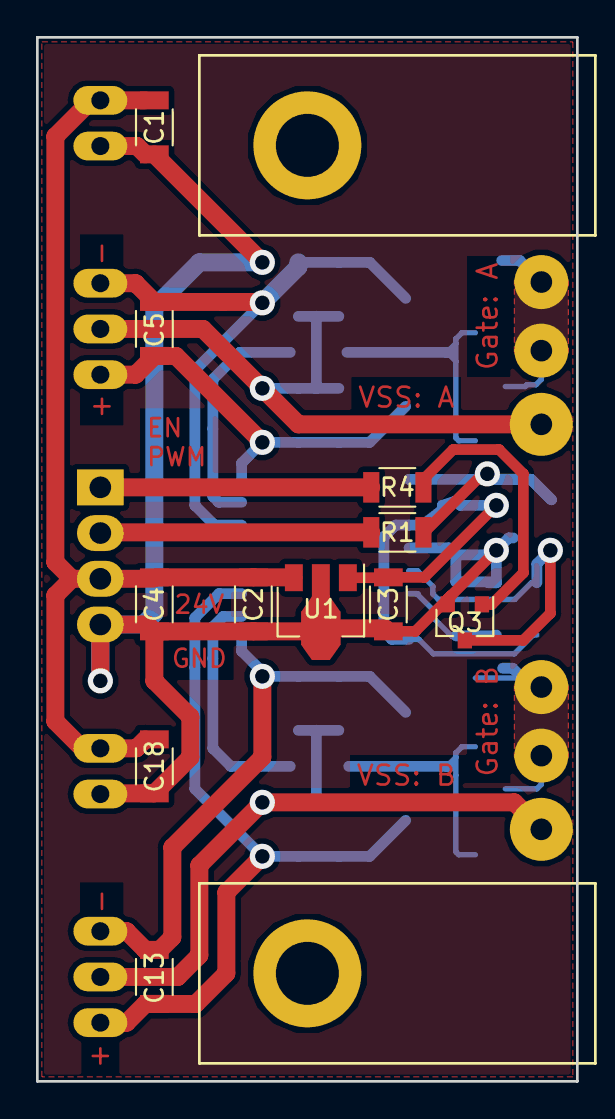
[picture p478: board Gate_drive.kicad_pcb from above]

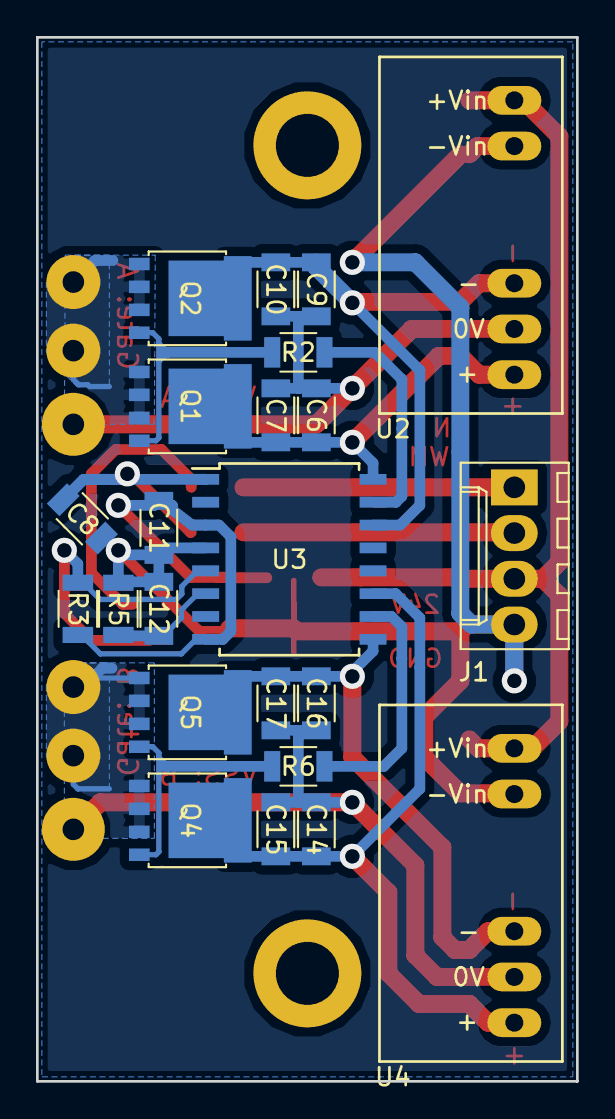
[picture p479: board Gate_drive.kicad_pcb from below]

Board: 2 copper layers, 30.0 x 58.0 mm, 38 parts (23 on the bottom side), 21 nets.

Parts:
C1, C3, C7, C10, C11, C15, C17, C18: 100n; C_1206
C2: 330n; C_1206
C4, C5, C13: 10u; C_1206
C6, C9, C14, C16: 4.7u; C_1206
C8: 33p; C_1206
C12: 2.2n; C_1206
J1: Inputs; Molex_KK-6410-04_04x2.54mm_Straight
J2: Gate:A; SolderWirePad_2x_1-2mmDrill
J3: VSS:A; SolderWirePad_single_1-2mmDrill
J4: Gate:B; SolderWirePad_2x_1-2mmDrill
J5: VSS:B; SolderWirePad_single_1-2mmDrill
Q1, Q4: PHPT60415NY; SOT-669_LFPAK
Q2, Q5: PHPT60415PY; SOT-669_LFPAK
Q3: BC846A; SOT-23
R1: 47; R_1206
R2, R6: 1; R_1206
R3, R5: 100k; R_1206
R4: 5k6; R_1206
U1: L78L15ABUTR; SOT-89-3
U2, U4: MGJ2D241509SC; SIL_MGJ2
U3: UCC20520; SOIC-16W_7.5x10.3mm_Pitch1.27mm

Connections:
+15V: C3.1, C11.1, R3.1, U1.1, U3.3, U3.8
+24V: C1.1, C2.1, C4.1, C18.1, J1.3, U1.3, U2.1, U4.1
/+15V:A: C5.1, C6.1, C7.1, Q1.5, U2.7, U3.16
/+15V:B: C13.1, C14.1, C15.1, Q4.5, U3.11, U4.7
/-8.7V:A: C5.2, C9.2, C10.2, Q2.5, U2.5, U3.14
/-8.7V:B: C13.2, C16.2, C17.2, Q5.5, U3.9, U4.5
/DT: C12.1, R5.1, U3.6
/ENABLE: J1.1, R4.2
/Gate:A: J2.1, Q1.1, Q1.2, Q1.3, Q2.1, Q2.2, Q2.3
/Gate:B: J4.1, Q4.1, Q4.2, Q4.3, Q5.1, Q5.2, Q5.3
/PWM: J1.2, R1.2
/VSS:A: C6.2, C7.2, C9.1, C10.1, J3.1, U2.6
/VSS:B: C14.2, C15.2, C16.1, C17.1, J5.1, U4.6
GND: C1.2, C2.2, C3.2, C4.2, C8.2, C11.2, C12.2, C18.2, J1.4, Q3.2, R5.2, U1.2, U2.2, U3.4, U4.2
unnamed: C8.1, R1.1, U3.1
unnamed: Q1.4, Q2.4, R2.1
unnamed: Q3.1, R4.1
unnamed: Q3.3, R3.2, U3.5
unnamed: Q4.4, Q5.4, R6.1
unnamed: R2.2, U3.15
unnamed: R6.2, U3.10
