NicolaiFransen/SemesterProjectPED2/Software/Development/SemesterProject/App/Include/analogSignal.h

/*
 * signal.h
 *
 *  Created on: 6. mar. 2019
 *      Author: Nicolai Fransen
 */

#ifndef APP_INCLUDE_ANALOGSIGNAL_H_
#define APP_INCLUDE_ANALOGSIGNAL_H_


//
// Includes
//
#include "DSP28x_Project.h"     // Device Headerfile and Examples Include File
#include "math.h"
#include "Constants.h"

#define MAX_VALUE_ADC     3.3
#define ANALOG_EXECUTION_FREQ   20000

//
// Object declaration
//

typedef struct AnalogSignalTag
{
    char filterType;                // Type of the filter HP of LP
    int filterOrder;                // Order of the filter
    int cutoffFreq;                 // Desired cut-off frequency of the filter
    float filterParamA;             // Filter parameter A, calculated from the filter specifications
    float filterParamB;             // Filter parameter B, calculated from the filter specifications
    float filteredValue;            // Filtered value corresponding to the measured voltage
    float previousValue;            // Filtered value corresponding to the previous measured voltage
    Uint16 ADCValue;                // Raw digital ADC reading
    Uint16 adcChannel;              // ADC channel for the signal
    float threshold[2];             // Maximum and minimum thresholds. Used for error handling.
    float maxValue;                 // Maximum ADC value for reference use
} AnalogSignal;

//
// Method prototyping
//
void Signal_Constructor(AnalogSignal *analogSignal, char filterType, int filterOrder,
                       int cutoffFreq, Uint16 adcChannel, float threshold[2]);
void calculateFilterParameters(AnalogSignal *analogSignal, char filterType, int filterOrder, int cutoffFreq);
void setFilteredValue(AnalogSignal *analogSignal);
void readADCValue(AnalogSignal *analogSignal);
void filterADCValue(AnalogSignal *analogSignal);

#endif /* APP_INCLUDE_ANALOGSIGNAL_H_ */
