NicolaiFransen/SemesterProjectPED2/Software/Development/SemesterProject/System/Include/systemInit.h

/*
 * systemInit.h
 *
 *  Created on: Mar 7, 2019
 *      Author: Nicolas
 */

#ifndef SYSTEM_INCLUDE_SYSTEMINIT_H_
#define SYSTEM_INCLUDE_SYSTEMINIT_H_

//
//Includes
//
#include "../../App/Include/dutyCycle.h"
#include "../../App/Include/openLoopControlManager.h"

//
// Function Prototypes statements for functions found within this file.
//
void systemInit(void);
int startupSequenceFinished(void);
__interrupt void cpu_timer0_isr(void);
void configureGPIO(void);
void configurePWM(void);




#endif /* SYSTEM_INCLUDE_SYSTEMINIT_H_ */
