NicolaiFransen/SemesterProjectPED2/(commit log)

2019-02-08 DC DC Converter for Driver datasheet
2019-02-12 Previous Group Documents
    [Charge_Discharge_test.xlsx, DSP.sch, F2807x_120controlCARD_R1_1_BOM_05Aug2014.xlsx, F2807x_120controlCARD_R1_1_PCB_PADS.pcb, F2807x_120controlCARD_R1_1_SCH_PADS.sch, Fets.xlsx, Gate_drive - Kopi.kicad_pcb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]
2019-02-15 List of what the interface board should include
    With the correct name
2019-02-15 DSP board datasheet
2019-02-16 Blinking LED project. A small commit for a man, a giant leap for go-karts
    The import procedure is everything but simple, we will do it all together, otherwise you will perish
2019-02-17 Create of interface board blok diagram
2019-02-17 Update 2019_02_15 Interface board features.docx
2019-02-19 Change of interface board folder name
2019-02-19 Sensor calculations interface board
2019-02-20 Added push buttons to diagram
2019-02-21 added power mosfet datasheet and code composer studio guide
2019-02-21 Data under light load
    [26V_duty 30 zoomed.CSV, 26V_duty 30.CSV, 26V_duty 30_zoomed_differential.CSV, 36V_duty 30_zoomed_differential.CSV, 36V_duty 50_zoomed_differential.CSV, Gate_drive.sch, T0000ALL_test1.CSV, T0000CH1_Vds.CSV]
2019-02-22 Light load test results
    [36V.CSV]
2019-02-22 Simulation of debouncing circuit
2019-02-22 Datasheets for interface PCB
2019-02-22 DSP pin connection info
    [DSP pin connection info.xlsx]
2019-02-22 Sensor component calculations
2019-02-24 LED calculations added
2019-02-25 PCB V1 created
    [InterfacePCB.PrjPcb]
2019-02-25 Updates on Sch
    [DSP.SchDoc, Inputs.SchDoc, InterfacePCB.PrjPcb, Outputs.SchDoc, Supplies.SchDoc]
2019-02-26 Schematics update
    [DSP.SchDoc, Inputs.SchDoc, InputsExtras.SchDoc, InterfacePCB.PrjPcb, V1_PCB.PcbDoc]
2019-02-26 Signal processing schematic
    [SignalProcessing.SchDoc]
2019-02-26 Update DSP pin connection info.xlsx
    [DSP pin connection info.xlsx]
2019-02-26 Schematic updates
    [DSP.SchDoc, Inputs.SchDoc, InputsExtras.SchDoc, InterfacePCB.PrjPcb, Outputs.SchDoc, SignalProcessing.SchDoc, V1_PCB.PcbDoc]
2019-02-27 Schematics updates
    [DSP.SchDoc, Inputs.SchDoc, InputsExtras.SchDoc, InterfacePCB.PrjPcb, Outputs.SchDoc, SignalProcessing.SchDoc, V1_PCB.PcbDoc]
2019-02-27 15V traco footprint created
2019-02-28 Schematic stuff
    [SignalProcessing.SchDoc, Supplies.SchDoc]
2019-02-28 Updated with 5V/1A supply
2019-02-28 Encoder connections
2019-02-28 Resistor calcuations
2019-02-28 PCB updates
    [Inputs.SchDoc, InputsExtras.SchDoc, Outputs.SchDoc, SignalProcessing.SchDoc, Supplies.SchDoc, V1_PCB.PcbDoc]
2019-02-28 minor pcb changes
    [V1_PCB.PcbDoc]
2019-02-28 Added extra fan connector
    [SignalProcessing.SchDoc, Supplies.SchDoc]
2019-02-28 Added temperature sensor
2019-03-01 1s semester meeting course and project review
    [2019_02_28_1st_Course_Review.xls]
2019-03-02 PCB progress and folder change
    [DSP pin connection info.xlsx, DSP.SchDoc, Inputs.SchDoc, InputsExtras.SchDoc, InterfacePCB.PrjPcb, Outputs.SchDoc, SignalProcessing.SchDoc, Supplies.SchDoc]
2019-03-02 PCB update
    [SignalProcessing.SchDoc, V1_PCB.PcbDoc]
2019-03-02 PCB like a boss
    [Inputs.SchDoc, InputsExtras.SchDoc, Outputs.SchDoc, V1_PCB.PcbDoc]
2019-03-03 PCB killing it
    [DSP pin connection info.xlsx, DSP.SchDoc, Inputs.SchDoc, InputsExtras.SchDoc, InterfacePCB.PrjPcb, Outputs.SchDoc, SignalProcessing.SchDoc, Supplies.SchDoc]
2019-03-04 Inverter Loss Calculations based on data sheet parameters
    [Inverter Loss Calculation.xlsx]
2019-03-04 Update Inverter Loss Calculation.xlsx
    [Inverter Loss Calculation.xlsx]
2019-03-05 PCB like a pro
    [InterfacePCB.PrjPcb, V2_PCB.PcbDoc]
2019-03-06 analytical loss calculation
    [Inverter Loss Calculation.xlsx]
2019-03-06 Lajos will be amazed
    [DSP.SchDoc, Inputs.SchDoc, InputsExtras.SchDoc, Outputs.SchDoc, SignalProcessing.SchDoc, Supplies.SchDoc, V2_PCB.PcbDoc]
2019-03-07 PCB done like a pro
    [Inputs.SchDoc, InterfacePCB.PrjPcb, V2_PCB.PcbDoc]
2019-03-07 Excel components pin assignation
    [DSP pin connection info.xlsx, Inputs.SchDoc, V2_PCB.PcbDoc]
2019-03-11 PCB troubleshoot corrections
    [DSP.SchDoc, Outputs.SchDoc, V2_PCB.PcbDoc]
2019-03-11 PCB ready for manufacturing
    [InterfacePCB.PrjPcb, V2_PCB.PcbDoc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]
2019-03-11 SVM working
    [Inverter Loss Calculation.xlsx]
2019-03-14 Add of values to components
    [Inputs.SchDoc, InputsExtras.SchDoc, InterfacePCB.PrjPcb, Outputs.SchDoc, SignalProcessing.SchDoc, Supplies.SchDoc]
2019-03-14 150A test on inverter
    [tek0000.csv, tek0001.csv, tek0002.csv, tek0003.csv, tek0004.csv, tek0005.csv]
2019-03-15 Results for version 2 FOC_ system working up to 1500rpm
2019-03-16 Motor simulations with KpI
2019-03-19 Interface PCB assembly test design
    [BoM and test procedure.xlsx]
2019-03-25 Interface board tests updated
    [BoM and test procedure.xlsx]
2019-03-26 DRC on PCB
2019-03-27 Torque and Speed COntrol
2019-03-28 Discrete with Delay and Torque Speed Control
2019-03-29 Firy red inverter case
    [InverterCaseTop1.stl]
2019-03-29 Software Release 1.0 (#10)
    * System manager and system init
    Work in progress, system initialization placed in a different file. GPIO init placed in a new file. System manager and digital input is in progress
    * Update SystemManager.c
    * Revert "Update SystemManager.c"
    This reverts commit e62bec3404486a9f6f16989fe2b694d9074d98f9.
    * Update SystemManager.c
    * Creating the struct for analog signals
    * System manager and digital input management v1.0
    * FML buggy file
    * Trying to fix buggy file error
    * Handling buggy file
    * filter parameter calc
    * System manager, digital input manager development
    * Start of read adc read
    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
    [Constants.h, GPIOConfig.c, GPIOConfig.h, PWMConfig.c, PWMConfig.h, analogAcquisitionManager.c, analogAcquisitionManager.h, analogSignal.c]
2019-04-02 Regenerative braking papers
    [BoM and test procedure.xlsx]
2019-04-03 Mechanical model and torque reference working
2019-04-12 Tor-Spd cntrl switch simulation (including regenerative braking)
2019-04-16 Added offset analysis of current measurement
    [Current_Scope_DSP.xlsx]
2019-04-25 3D models for buttons and switches
    [ButtonLeft4.stl, ButtonMiddle3.stl, ButtonRight1.stl, SwitchLeft4.stl, SwitchRight1.stl]
2019-04-26 Pictures for encoder overleaf
2019-04-26 Corrected printing format
2019-04-26 Added some coloring ( ͡° ͜ʖ ͡°)
2019-04-26 Driver request document
2019-04-26 Encoder flowchart update
2019-04-29 Driver analysis work in progress
    [PWL_calculater.xlsx]
2019-05-01 Updated driver IC modelling
2019-05-02 Fixed misplaced PMOS, driver analysis
2019-05-03 Driver analysis and driver PCB
    [Gate_drive - Kopi.kicad_pcb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]
2019-05-04 Added driver analysis description and updated simulation model
2019-05-06 Updated driver analysis description.
2019-05-08 Added datasheet
    [Gate_drive-2019-05-07-14-21-43.sch, Inverter-2019-05-07-12-09-13.sch]
2019-05-16 Some changes in altium files
    [DSP.SchDoc, Inputs.SchDoc, InputsExtras.SchDoc, InterfacePCB.PrjPcb, Outputs.SchDoc, SignalProcessing.SchDoc, Supplies.SchDoc]
2019-05-19 Updated driver analysis file
2019-05-20 Discretesized 2 file
    [Gate_drive - Kopi.drl, Gate_drive-B.Cu.gbr, Gate_drive-B.Fab.gbr, Gate_drive-B.Paste.gbr, Gate_drive-B.SilkS.gbr, Gate_drive-Edge.Cuts - Kopi.gbr, Gate_drive-Edge.Cuts.gbr, Gate_drive-F.Cu.gbr]
2019-05-21 Added PWMsignalsV4.pdf
2019-05-22 Measurements from testing 20190521
    [tek0000.csv, tek0001.csv, tek0002.csv, tek0003.csv, tek0004.csv, tek0005.csv, tek0006.csv, tek0007.csv]
2019-05-22 FOC tests to master
    [TorqueInputChangeTorqueSpeedPower1.csv, TorqueLoadChangeTorqueSpeedPower1.csv, TorqueLoadChangeTorqueSpeedPower2_45V90V.csv, TorqueSSTorqueSpeedPower1.csv, TorqueSSTorqueSpeedPower2.csv, TorqueStartupTorqueSpeedPower1.csv, TorqueStartupTorqueSpeedPower2.csv, TorqueStartupTorqueSpeedPower3.csv]
2019-05-22 batteries stuff
    [Charge_a.xlsx, Charge_a_2.xlsx, Charge_b.xlsx, Charge_b_2.xlsx, Charge_d.xlsx, Charge_d_2.xlsx, Discharge_a.xlsx, Discharge_a_2.xlsx]
2019-05-22 Added MOSFET_damage.drawio
2019-05-22 Added MOSFET_damage.pdf
2019-05-22 Added MOSFET_damage_V2.pdf
2019-05-23 Added pictures for driver spike
2019-05-23 Some nicer plots FOC
    [CorrectedTorqueStartupTorqueSpeedPower3.csv, ExcelTorqueLoadChangeTorqueSpeedPower1.csv, NumberTorqueSpeedPower.csv, NumberTorqueSpeedPowerUnknownFile.csv, StartupNumberTorqueSpeedPower.csv, StartupTimeCh2Ch3Ch4.csv, TIMECH2CH3CH4.csv, TimeCh2Ch3Ch4.csv]
2019-05-24 Test pictures
    [StartupTest.csv, SteadyState.csv, Torque_load_step.csv, Torque_ref_step.csv, cruiseControl_v2.csv, cruise_control_load_step_v1.csv, speed_change_PCB.csv, speed_change_PCB_v3.csv]
2019-05-24 Tests 24th may
    [adcInterrupt_Running_VF_Error_CurrentCheck.csv, adcInterrupt_Running_VF_NoError.csv, adcInterrupt_Running_VF_NoError_CurrentCheck.csv, getAnalogErrorStatus_forLoops.csv]
2019-05-24 Some pics and graphs
    [StartupTest.csv, SteadyState.csv, Torque_load_step.csv, Torque_ref_step.csv, cruiseControl_v2.csv, cruise_control_load_step_v1.csv, speed_change_PCB.csv, speed_change_PCB_v3.csv]
2019-05-24 Added BatterySetup_v2.drawio
2019-05-24 Added BatterySetup_v2.pdf
2019-05-24 Torque Cruise shift
2019-05-27 Adding files to delivery folder
    [V1_PCB.PcbDoc]
2019-05-28 batteries delivery folder
    [Param_d_50.xlsx]
2019-05-28 delivery batteries
    [Charge_a.xlsx, Charge_a_2.xlsx, Charge_b.xlsx, Charge_b_2.xlsx, Charge_d.xlsx, Charge_d_2.xlsx, Discharge_B.xlsx, Discharge_a.xlsx]
2019-05-28 Final report
    [ErrorReactionTime_HighPriority.csv, ErrorReactionTime_HighPriority_5000FilterBW.csv, ErrorReactionTime_HighPriority_500FilterBW.csv]
2019-06-18 Pictures of PCB for presentation
